xiphonics/picoTracker/docs/img/back-look.jpg

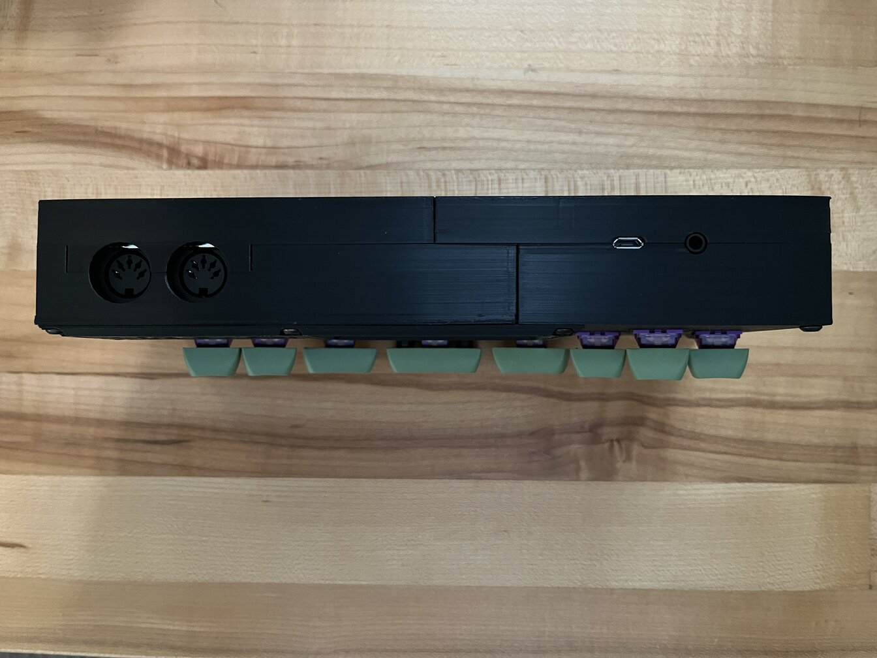
docs/img/back-look.jpg
