xiphonics/picoTracker/docs/img/keynames.jpg

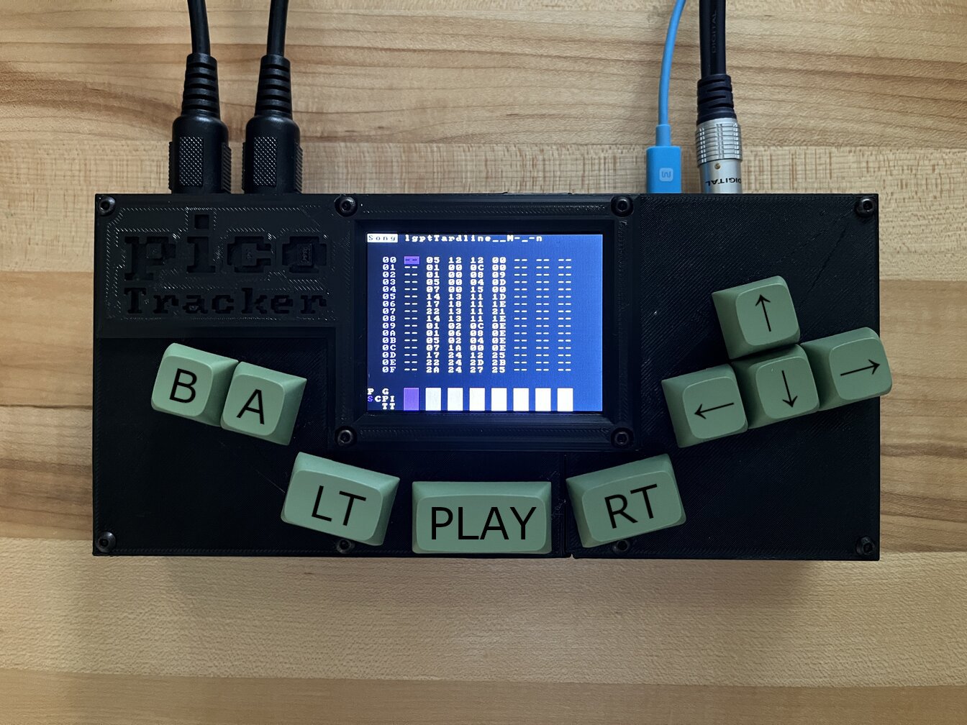
docs/img/keynames.jpg
