xiphonics/picoTracker/docs/img/m8-style-keymap.png

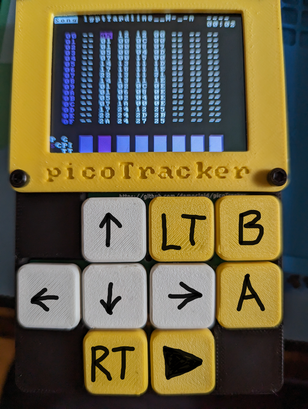
docs/img/m8-style-keymap.png
