xiphonics/picoTracker/docs/img/pico-style-keymap.png

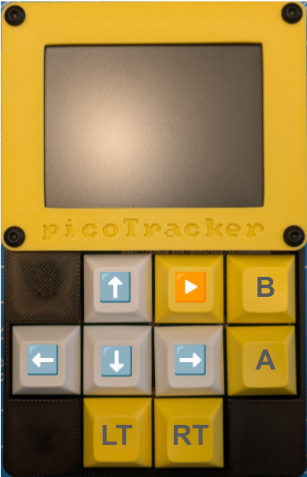
docs/img/pico-style-keymap.png
