xiphonics/picoTracker/docs/img/picotracker-ports-1.png

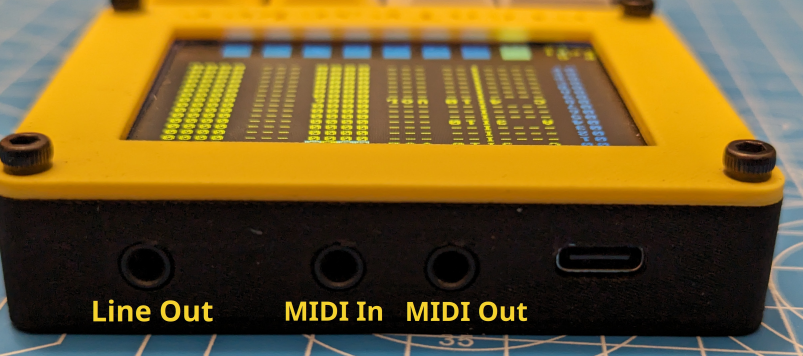
docs/img/picotracker-ports-1.png
