xiphonics/picoTracker/tools/fonts/font_adv.png

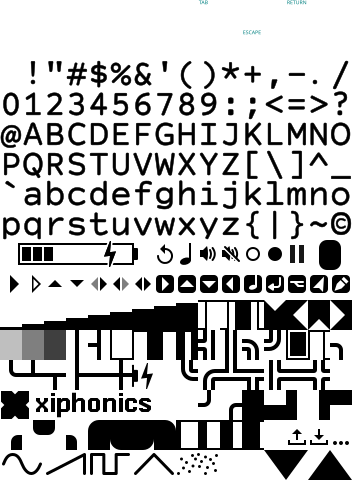
tools/fonts/font_adv.png
