xiphonics/picoTracker/tools/fonts/font_hourglass.png

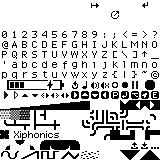
tools/fonts/font_hourglass.png
