xiphonics/picoTracker/tools/fonts/font_wide.png

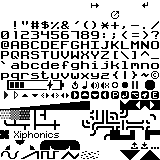
tools/fonts/font_wide.png
