xiphonics/picoTracker/tools/fonts/font_yousquared.png

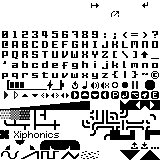
tools/fonts/font_yousquared.png
