xiphonics/picoTracker/usermanual/pico-edition/content/pages/device.md

---
title: Device Management
template: page
---

The device screen allows you to manage settings for the picoTracker device hardware itself.

**Note:** the picoTracker saves its device settings to the SDCard so if you replace the sdcard in your picoTracker, the device configuration will reset to factory defaults.

screen capture of device screen

## MIDI

- **MIDI output:** Selects the picoTracker MIDI output interfaces. Available options are:
    * Off
    * TRS
    * USB
    * TRS+USB
- **MIDI input:** Selects which interfaces receive MIDI notes and transport messages: Off, TRS, USB, or TRS+USB (default). Changes take effect immediately and are independent of MIDI output. Disabling an input releases its held notes.

- **MIDI sync:** Enable/disable MIDI clock sync messages being sent by the picoTracker.

Device settings are saved when you leave the Device screen.

## Line Out Mode (1st Edition RP2040 model only)

On the first edition picoTracker, the audio output can be set to one of 3 amplification levels to make the audio level output more useful for Line Level output or Headphone output. The 3 possible settings are: 
* `HP Low`
* `HP High`
* `Line Level`

**NOTE: A reboot of the picoTracker is required to apply the newly changed audio output level!** 

**PLEASE exercise caution when using earphones or headphones!*

## Remote UI

This setting enables or disables sending commands to a computer attached via USB to the picoTracker running a "remote UI" application that can mirror the display from the picoTracker.

The [official picoTracker remote UI web application is available ](https://ui.xiphonics.com), it works only with Chromium based browsers.

## Import resampler

This settings allows the selection of the sample rate converter used during sample import. Check the sample instrument section for more details.

## Display Brightness

The display brightness setting allows you to adjust the backlight level of the picoTracker's LCD display. The brightness can be set from `05` (minimum brightness) to `ff` (maximum brightness). The default value is `80` (medium brightness).

Adjusting the brightness can help with battery life (lower brightness uses less power) and visibility in different lighting conditions.

## Theme Settings

The Theme Settings screen allows you to customize the appearance of the picoTracker interface, including fonts and colors. To access the Theme Settings screen, select the "Theme settings" option on the Device screen.

See the [Theme Settings](theme.html) chapter for more details.

## Updating Firmware

The picoTracker firmware can be easily updated by powering the picoTracker via a USB connected to a PC. Select `Update firmware`. This will reboot the device into *BOOTSEL* mode, and you'll see the picoTracker show up as a USB mass storage device on the connected computer. At that point, just copy the UF2 firmware file into the USB device as you would with a USB stick or USB drive. 

Once copying (flashing) of the new firmware is completed, the picoTracker will automatically reboot and be running the newly installed firmware.
