xiphonics/picoTracker/usermanual/advance-edition/content/pages/introduction.md

---
title: Welcome
template: page
---

Welcome to the picoTracker Advance, a small, portable music making device based on the tracker workflow.

But what is a "tracker"?

Trackers are music production applications that started life on 16bit home computers such as the legendary Amiga 500. 

Trackers later evolved to also run on devices such as the Gameboy as popularised by LSDJ and this then inspired the LittleGPTracker (LGPT) which was designed to run on portable Linux-based gaming handheld devices. LGPT then served as the starting point for the firmware for the picoTracker, though it has now substantially diverged from those roots, being customised for the specific hardware of the picoTracker Advance and gaining many new features and improvements.

## Overview

picoTracker Advance is the evolution of the original picoTracker — a portable music instrument built around the classical tracker interface. It currently supports eight stereo channels, with per-step assignable sample, Synth and MIDI instruments. The new hardware is designed to enable new creative possibilities as the firmware continues to evolve.

Your picoTracker Advance comes included with a:

* 16GB SD Card with sample projects, samples and themes
* MIDI TRS adapter (type B)
* quick reference card

(note: Does NOT include power supply or USB-C cable. The Advance uses any standard USB-C charger)

### Hardware specs

* HiDPI 720x720 4" display
* Powerful ARM processor
* 48MB of sample memory per project
* MicroSD for project, settings and sample storage
* TRS and USB MIDI In/Out
* Headphone/Line output and speaker
* Line input and built-in microphone
* Battery lasts up to 6 hours
* Weight: 233g (8.2oz)
* Dimensions: 143x78x15mm (5.6x3x0.6in)

## Acknowledgements

As with any big open source undertaking, this project would not have been possible without standing on the shoulders of many great open source projects and libraries. We would especially like to thank [Marc Resibois aka Nostromo](https://github.com/Mdashdotdashn), the creator of LittleGPTracker and for making it available under a liberal open source license.
