xiphonics/picoTracker/usermanual/advance-edition/content/pages/keypadcombos.md

---
title: Controls & Moves
template: page
---

labeled photo of Picotracker keymapping

The keyboard layout resembles a typical console game controller (controller button names in brackets):

| <span class="minikeys">ARROW</span> keys | <span class="minikeys">NAV</span> (RT) | <span class="minikeys">ALT</span> (LT) | <span class="minikeys">ENTER</span> (A) | <span class="minikeys">EDIT</span> (B) | <span class="minikeys">PLAY</span> (Start) |
|:---|:---|:---|:---|:---|:---|
| arrow keys | arrow keys | arrow keys | arrow keys | arrow keys | arrow keys |

The <span class="minikeys">NAV</span> and <span class="minikeys">ALT</span> keys are modifier keys for the <span class="minikeys">ENTER</span>, <span class="minikeys">EDIT</span> and <span class="minikeys">ARROW</span> keys. They are designed to modify
the opposite keys to their location, so <span class="minikeys">ALT</span> will modify the <span class="minikeys">ARROW</span> keys and <span class="minikeys">NAV</span> will modify <span class="minikeys">ENTER</span> and <span class="minikeys">EDIT</span> (
though there are exceptions).

On tracker screens where <span class="minikeys">PLAY</span> controls playback, holding <span class="minikeys">PLAY</span> for about one second triggers a panic stop. This immediately stops the sequencer and **cuts any currently sounding audio**, which is useful if a note, effect tail, or external MIDI sound gets stuck. A short press of <span class="minikeys">PLAY</span> still performs the normal start/stop or queue action when you release the key.

### Remark about navigation between screens

Screens become more granular as you move from left to right.

Navigating to the next right screen is only possible if the current cursor position is on a field with a filled value, eg. to move to the chain screen from the Song screen you need to have a chain number on the cursors current position and not an empty position which are denoted with 2 dashes (`--`).

## Song View

### No Modifier

| Function | Key Combination | Image |
|:---|:---:|:---:|
| Move cursor on screen |  <span class="minikeys">ARROW</span> keys | arrow keys |
| Start/stop playback | <span class="minikeys">PLAY</span> | play key |
| Panic stop sounding audio |  hold <span class="minikeys">PLAY</span> | play key |
| Enter last used value or start with 0 | <span class="minikeys">ENTER</span> | enter key  |

### NAV Modifier

| Function | Key Combination | Image |
|:---|:---:|:---:|
| Switch to Project view | <span class="minikeys">NAV</span> + <span class="minikeys">UP</span> | nav + up key |
| Switch to Mixer view | <span class="minikeys">NAV</span> + <span class="minikeys">DOWN</span> |  nav + down key  |
| Switch to Chain view (if current position has a chain) | <span class="minikeys">NAV</span> + <span class="minikeys">RIGHT</span>  | nav + right key |
| Stop playback of selected chain, once it finished | <span class="minikeys">NAV</span> + <span class="minikeys">PLAY</span> |  nav + play key  |
| Solo selected track | <span class="minikeys">NAV</span> + <span class="minikeys">ENTER</span>  | nav + enter key |
| Mute selected track | <span class="minikeys">NAV</span> + <span class="minikeys">EDIT</span> | nav + edit keys  |
| Reset all muted & solo-ed tracks | <span class="minikeys">NAV</span> + <span class="minikeys">ALT</span> |  nav + edit keys  |

#### Solo & Mute

When <span class="minikeys">NAV</span> is released first, the (solo / mute) mode will be kept active (toggled).
Pressing the same key combination but releasing <span class="minikeys">NAV</span> first will reset the (solo / mute) mode of the currently selected
track.

To reset all muted and soloed tracks, press <span class="minikeys">NAV</span> + <span class="minikeys">ALT</span>.

### ALT Modifier

| Function | Key Combination | Image |
|:---|:---:|:---:|
| Jump up/down to next populated row after a blank row | <span class="minikeys">ALT</span> + (<span class="minikeys">UP</span> / <span class="minikeys">DOWN</span>) | alt + up/down keys |
| Nudge tempo down/up | <span class="minikeys">ALT</span> + (<span class="minikeys">LEFT</span> / <span class="minikeys">RIGHT</span>) | nav + alt + left/right  |
| Start/stop song, or queue current row for playback in Live mode | <span class="minikeys">ALT</span> + <span class="minikeys">PLAY</span> | nav + alt + play |
| Reset all muted & soloed tracks | <span class="minikeys">ALT</span> + <span class="minikeys">NAV</span> | nav + alt + enter |
| Cut the current cursor position if filled, paste otherwise | <span class="minikeys">ALT</span> + <span class="minikeys">ENTER</span> | arrow keys |
| Clone: Overwrite current highlighted Item with a copy of itself using the next unused Item available. | <span class="minikeys">ALT</span> + (<span class="minikeys">EDIT</span>, <span class="minikeys">ENTER</span>) | alt + edit + enter keys |
| Start selection | <span class="minikeys">ALT</span> + <span class="minikeys">EDIT</span> | edit + alt keys |
| Selection with current row selected | <span class="minikeys">ALT</span> + <span class="minikeys">EDIT</span> + <span class="minikeys">EDIT</span> | edit + alt keys |
| Selection with current screen selected | <span class="minikeys">ALT</span> + <span class="minikeys">EDIT</span> + <span class="minikeys">EDIT</span> + <span class="minikeys">EDIT</span> | edit + alt keys |

#### Use Selection

Once a selection is started you can do a few more things:

| Description | Key Combination | Image |
|---|:---:|:---:|
| Change selection | <span class="minikeys">ARROWS</span> |  arrow keys |
| Increase selection to full row / screen | <span class="minikeys">ALT</span> + <span class="minikeys">EDIT</span> | nav + enter |
| Copy selection to clipboard | <span class="minikeys">EDIT</span> | arrow keys |
| Cut selection to clipboard | <span class="minikeys">ALT</span> + <span class="minikeys">ENTER</span>  | arrow keys |
| Resample selection | <span class="minikeys">ENTER</span> + <span class="minikeys">PLAY</span>  | play key |

### EDIT Modifier

| Function | Key Combination | Image |
|:---|:---:|:---:|
| Cuts the current Highlighted Item. | <span class="minikeys">EDIT</span> + <span class="minikeys">ENTER</span> | edit + enter keys |
| Start selection | <span class="minikeys">EDIT</span> + <span class="minikeys">ALT</span> | edit + alt keys |
| Page up/down in Song Screen. | <span class="minikeys">EDIT</span> + (<span class="minikeys">UP</span> / <span class="minikeys">DOWN</span>) | edit + up/down keys |
| Switch between Song and Live Mode | <span class="minikeys">EDIT</span> + (<span class="minikeys">LEFT</span> / <span class="minikeys">RIGHT</span>) | edit + left/right keys |
| Mute selected track | <span class="minikeys">EDIT</span> + <span class="minikeys">NAV</span> | nav + edit keys |
| Sample Recording, only accessible when sequencer is stopped | <span class="minikeys">EDIT</span> + <span class="minikeys">PLAY</span> | edit + play keys |

### ENTER Key Combinations

| Function | Key Combination | Image |
|:---|:---:|:---:|
| Insert if cursor position is empty | <span class="minikeys">ENTER</span> | enter key |
| Insert next unused chain | <span class="minikeys">ENTER</span>, <span class="minikeys">ENTER</span> | enter key twice |
| Cut the current cursor position if filled, paste otherwise | <span class="minikeys">ENTER</span> + <span class="minikeys">ALT</span> | arrow keys |
| Change chain at cursor position by 0x10 | <span class="minikeys">ENTER</span> + (<span class="minikeys">UP</span> / <span class="minikeys">DOWN</span>) | enter + arrow keys |
| Change chain at cursor position by 0x01 | <span class="minikeys">ENTER</span> + (<span class="minikeys">RIGHT</span> / <span class="minikeys">LEFT</span>) | enter + right/left keys |
| Solo selected track | <span class="minikeys">ENTER</span> + <span class="minikeys">NAV</span> | nav + enter key |

## Chain View

### No Modifier

| Function | Key Combination | Image |
|:---|:---:|:---:|
| Move cursor on screen | <span class="minikeys">ARROW</span> keys | arrow keys |
| Start/stop playback of current chain | <span class="minikeys">PLAY</span> | play key |
| Enter last used phrase or start with 0 | <span class="minikeys">ENTER</span> | enter key  |

### NAV Modifier

| Function | Key Combination | Image |
|:---|:---:|:---:|
| Play chain in song | <span class="minikeys">NAV</span> + <span class="minikeys">PLAY</span> | nav + right key |
| Unmute all | <span class="minikeys">NAV</span> + <span class="minikeys">ALT</span> | nav + alt key |
| Toggle mute | <span class="minikeys">NAV</span> + <span class="minikeys">EDIT</span> | nav + edit key  |
| Switch solo mode | <span class="minikeys">NAV</span> + <span class="minikeys">ENTER</span>  | nav + enter key |

### ALT Modifier

| Function | Key Combination | Image |
|:---|:---:|:---:|
| Unmute all | <span class="minikeys">ALT</span> + <span class="minikeys">NAV</span> | alt + nav key |
| Clone current position | <span class="minikeys">ALT</span> + (<span class="minikeys">EDIT</span>, <span class="minikeys">ENTER</span>) | alt + edit + enter key |
| Paste clipboard | <span class="minikeys">ALT</span> + <span class="minikeys">ENTER</span> | alt + enter key |
| Start selection | <span class="minikeys">ALT</span> + <span class="minikeys">EDIT</span> | alt + edit key |

### EDIT Modifier

| Function | Key Combination | Image |
|:---|:---:|:---:|
| Warp to (previous / next) channel | <span class="minikeys">EDIT</span> + (<span class="minikeys">LEFT</span> / <span class="minikeys">RIGHT</span>) | edit + horizontal arrow keys |
| Warp to (previous / next) chain of current channel | <span class="minikeys">EDIT</span> + (<span class="minikeys">UP</span> / <span class="minikeys">DOWN</span>) | edit + vertical arrow keys |
| Cut current position into clipboard | <span class="minikeys">EDIT</span> + <span class="minikeys">ENTER</span> | edit + enter key |
| Clone current position | <span class="minikeys">EDIT</span> + <span class="minikeys">ALT</span> + <span class="minikeys">ENTER</span> | edit + alt + enter key |
| Toggle mute | <span class="minikeys">EDIT</span> + <span class="minikeys">NAV</span> | edit + nav key |
| Start selection | <span class="minikeys">ALT</span> + <span class="minikeys">EDIT</span> | alt + edit key |
| Selection with row selected | <span class="minikeys">ALT</span> + <span class="minikeys">EDIT</span> + <span class="minikeys">EDIT</span> | alt + edit twice keys |
| Selection with current screen selected | <span class="minikeys">ALT</span> + <span class="minikeys">EDIT</span> + <span class="minikeys">EDIT</span> + <span class="minikeys">EDIT</span> | alt + edit thrice keys |

#### Use Selection

Once a selection is started you can do a few more things:

| Description | Key Combination | Image |
|---|:---:|:---:|
| Change selection | <span class="minikeys">ARROWS</span> | arrow keys |
| Copy selection to clipboard | <span class="minikeys">EDIT</span> | edit key |
| Toggle mute | <span class="minikeys">EDIT</span> + <span class="minikeys">NAV</span> | edit + nav key |
| Update selection values by +/- 0x10 | <span class="minikeys">ENTER</span> + (<span class="minikeys">UP</span> + <span class="minikeys">DOWN</span>) | enter + vertical arrow keys |
| Update selection values by +/- 0x01 | <span class="minikeys">ENTER</span> + (<span class="minikeys">LEFT</span> + <span class="minikeys">RIGHT</span>) | enter key + horizontal arrow keys |
| Cut the current selection | <span class="minikeys">ALT</span> + <span class="minikeys">ENTER</span> | alt + enter key |
| Resample selection | <span class="minikeys">ENTER</span> + <span class="minikeys">PLAY</span> | play key |
| Switch solo mode | <span class="minikeys">NAV</span> + <span class="minikeys">ENTER</span> | nav + enter key |
| Play chain | <span class="minikeys">PLAY</span> | play key |
| Play chain in song | <span class="minikeys">NAV</span> + <span class="minikeys">PLAY</span> | nav + play key |
| Unmute all | <span class="minikeys">ALT</span> + <span class="minikeys">NAV</span> | alt + nav key |

### ENTER Key Combinations

| Function | Key Combination | Image |
|:---|:---:|:---:|
| Update cursor value by +/- 0x10 | <span class="minikeys">ENTER</span> + (<span class="minikeys">UP</span> / <span class="minikeys">DOWN</span>) | enter + vertical arrow keys |
| Update cursor value by +/- 0x01 | <span class="minikeys">ENTER</span> + (<span class="minikeys">LEFT</span> / <span class="minikeys">RIGHT</span>) | enter + horizontal arrow keys |
| Paste clipboard | <span class="minikeys">ENTER</span> + <span class="minikeys">ALT</span> | enter + alt key |
| Switch solo mode | <span class="minikeys">ENTER</span> + <span class="minikeys">NAV</span> | enter + nav key |

## Phrase View

### No Modifier

| Function | Key Combination | Image |
|:---|:---:|:---:|
| Move cursor on screen | <span class="minikeys">ARROW</span> keys | arrow keys |
| Start/stop playback of current phrase | <span class="minikeys">PLAY</span> | play key |
| enter last used value or start with 0 | <span class="minikeys">ENTER</span> |  enter key  |
| Insert first unused instrument/table number | <span class="minikeys">ENTER</span>,<span class="minikeys">ENTER</span>  |  enter key  |
| In note / instrument column: audition note |  <span class="minikeys">ENTER</span> held |  enter key  |

| Function | Key Combination | Image |
|:---|:---:|:---:|
| Play phrase in song | <span class="minikeys">NAV</span> + <span class="minikeys">PLAY</span> | nav + play key  |
| Unmute all | <span class="minikeys">NAV</span> + <span class="minikeys">ALT</span> | nav + alt key |
| Switch mute mode | <span class="minikeys">NAV</span> + <span class="minikeys">EDIT</span> | nav + edit key  |
| Switch solo mode | <span class="minikeys">NAV</span> + <span class="minikeys">ENTER</span>  | nav + enter key |

### ALT Modifier

| Function | Key Combination | Image |
|:---|:---:|:---:|
| Unmute all | <span class="minikeys">ALT</span> + <span class="minikeys">NAV</span> | alt + nav key |
| Paste clipboard | <span class="minikeys">ALT</span> + <span class="minikeys">ENTER</span> | alt + enter key |
| Start selection | <span class="minikeys">ALT</span> + <span class="minikeys">EDIT</span> | alt + edit key |
| Clone current instrument/table (cursor in note / instrument column) | <span class="minikeys">ALT</span> + (<span class="minikeys">EDIT</span>, <span class="minikeys">ENTER</span>) | alt + edit + enter key |

### EDIT Modifier

| Function | Key Combination | Image |
|:---|:---:|:---:|
| Warp to (previous / next) track | <span class="minikeys">EDIT</span> + (<span class="minikeys">LEFT</span> / <span class="minikeys">RIGHT</span>) | edit + horizontal arrow keys|
| Warp to (previous / next) phrase in chain | <span class="minikeys">EDIT</span> + (<span class="minikeys">UP</span> / <span class="minikeys">DOWN</span>) | edit + vertical arrow keys  |
| Cut current position into clipboard | <span class="minikeys">EDIT</span> + <span class="minikeys">ENTER</span> | edit + enter key |
| Toggle mute | <span class="minikeys">EDIT</span> + <span class="minikeys">NAV</span> | edit + nav key |
| Start selection | <span class="minikeys">EDIT</span> + <span class="minikeys">ALT</span> | alt + edit key |
| Start selection with row selected | <span class="minikeys">ALT</span> + <span class="minikeys">EDIT</span> + <span class="minikeys">EDIT</span> | alt + edit twice keys |
| Start selection with current screen selected | <span class="minikeys">ALT</span> + <span class="minikeys">EDIT</span> + <span class="minikeys">EDIT</span> + <span class="minikeys">EDIT</span> | alt + edit thrice keys |

#### Use Selection

Once a selection is started you can do a few more things:

| Description | Key Combination | Image |
|---|:---:|:---:|
| Change selection | <span class="minikeys">ARROWS</span> | arrow keys |
| Increase selection to full row / screen | <span class="minikeys">ALT</span> + <span class="minikeys">EDIT</span> | nav + enter |
| Copy selection to clipboard | <span class="minikeys">EDIT</span> | edit key |
| Cut the current selection | <span class="minikeys">ALT</span> + <span class="minikeys">ENTER</span> | alt + enter key |
| Update selection values by +/- 0x10 |  <span class="minikeys">ENTER</span> + (<span class="minikeys">UP</span> + <span class="minikeys">DOWN</span>) | enter + vertical arrow keys |
| Update selection values by +/- 0x01 | <span class="minikeys">ENTER</span> + (<span class="minikeys">LEFT</span> + <span class="minikeys">RIGHT</span>) | enter + horizontal arrow keys |
| Resample selection | <span class="minikeys">ENTER</span> + <span class="minikeys">PLAY</span> | play key |

### ENTER Key Combinations

| Function | Key Combination | Image |
|:---|:---:|:---:|
| update cursor value by +/- 0x10 | <span class="minikeys">ENTER</span> + (<span class="minikeys">UP</span> / <span class="minikeys">DOWN</span>) | enter + vertical arrow keys |
| update cursor value by +/- 0x01 | <span class="minikeys">ENTER</span> + (<span class="minikeys">LEFT</span> / <span class="minikeys">RIGHT</span>) | enter + horizontal arrow keys |
| paste clipboard | <span class="minikeys">ENTER</span> + <span class="minikeys">ALT</span> | enter + alt key |
| switch solo mode | <span class="minikeys">ENTER</span> + <span class="minikeys">NAV</span> | enter + nav key |

## Instrument View

### No Modifier

| Function | Key Combination | Image |
|:---|:---:|:---:|
| Move cursor on screen |  <span class="minikeys">ARROW</span> keys | arrow keys |
| Start/stop playback | <span class="minikeys">PLAY</span> | play key |

### ENTER Key

| Function | Key Combination | Image |
|:---|:---:|:---:|
| Import sample from samplelib (double-tap on sample field) | <span class="minikeys">ENTER</span>, <span class="minikeys">ENTER</span>  | enter key |
| Get next available table (on table field) | <span class="minikeys">ENTER</span> | enter key  |

### NAV Modifier

| Function | Key Combination | Image |
|:---|:---:|:---:|
| Switch to Phrase view |  <span class="minikeys">NAV</span> + <span class="minikeys">LEFT</span> | nav + left key  |
| Switch to Voice view (Sample instrument) |  <span class="minikeys">NAV</span> + <span class="minikeys">RIGHT</span>  | nav + right key |
| Switch to Table view (if instrument has table) |  <span class="minikeys">NAV</span> + <span class="minikeys">DOWN</span> | nav + down key  |
| Start playback (phrase mode) |  <span class="minikeys">NAV</span> + <span class="minikeys">PLAY</span> | nav + play key  |

### ALT Modifier

| Function | Key Combination | Image |
|:---|:---:|:---:|
| Audition current audio instrument in the Instrument or Voice view (hold; works during playback) | <span class="minikeys">ALT</span> + <span class="minikeys">PLAY</span> | alt + play key |

### EDIT Modifier

| Function | Key Combination | Image |
|:---|:---:|:---:|
| Previous/Next instrument (-1/+1) | <span class="minikeys">EDIT</span> + (<span class="minikeys">LEFT</span> / <span class="minikeys">RIGHT</span>) | edit + (left / right) key |
| Previous/Next instrument (-16/+16) | <span class="minikeys">EDIT</span> + (<span class="minikeys">DOWN</span> / <span class="minikeys">UP</span>) | edit + down key |
| Cut/purge instrument (sample) or clear table | <span class="minikeys">EDIT</span> + <span class="minikeys">ENTER</span> | edit + enter key |
| Clone current table | <span class="minikeys">ALT</span> + (<span class="minikeys">EDIT</span>, <span class="minikeys">ENTER</span>) | edit + alt key |

## Import View

### No Modifier

| Function | Key Combination | Image |
|:---|:---:|:---:|
| Move up/down in file list | <span class="minikeys">UP</span> / <span class="minikeys">DOWN</span> |  arrow keys |
| Toggle selected button | <span class="minikeys">LEFT</span> / <span class="minikeys">RIGHT</span>  | arrow keys |
| Preview selected sample (hold) | <span class="minikeys">PLAY</span> | play key |
| Navigate into directory | <span class="minikeys">ENTER</span> | enter key |

### ENTER Key

**In File Browser Mode:**

| Function | Key Combination | Image |
|:---|:---|:---:|
| Import sample | <span class="minikeys">ENTER</span> (with Import button selected) | enter key |
| Edit sample | <span class="minikeys">ENTER</span> (with Edit button selected) | enter key |

**In Project Pool Mode:**

| Function | Key Combination | Image |
|:---|:---|:---:|
| Edit sample | <span class="minikeys">ENTER</span> (with Edit button selected) | enter key |
| Remove sample from project | <span class="minikeys">ENTER</span> (with Remove button selected) | enter key |

### NAV Modifier

| Function | Key Combination | Image |
|:---|:---:|:---:|
| Return to source view (Phrase or Instrument) |  <span class="minikeys">NAV</span> + <span class="minikeys">LEFT</span> | nav + left key |
| Go to parent directory | <span class="minikeys">NAV</span> + <span class="minikeys">UP</span> | nav + up key |
| Toggle between sample library and project pool |  <span class="minikeys">NAV</span> + <span class="minikeys">EDIT</span> | nav + edit key |

### EDIT Modifier

| Function | Key Combination | Image |
|:---|:---:|:---:|
| Increase / Decrease preview volume | <span class="minikeys">EDIT</span> + (<span class="minikeys">UP</span> / <span class="minikeys">DOWN</span>) | edit + (up / down) key |

### ALT Modifier

| Function | Key Combination | Image |
|:---|:---:|:---:|
| Import sample | <span class="minikeys">ALT</span> + <span class="minikeys">PLAY</span> | alt + play key |

## Sample Editor View

### No Modifier

| Function | Key Combination | Image |
|:---|:---:|:---:|
| Move cursor on screen | <span class="minikeys">ARROW</span> keys | arrow keys |
| Preview sample (hold) | <span class="minikeys">PLAY</span> | play key |

### ENTER Key

| Function | Key Combination | Image |
|:---|:---:|:---:|
| Update cursor value | <span class="minikeys">ENTER</span> + (<span class="minikeys">UP</span> / <span class="minikeys">DOWN</span>) (with start, end or name field selected) | enter + vertical arrow keys |
| Update cursor position in field | <span class="minikeys">ENTER</span> + (<span class="minikeys">LEFT</span> / <span class="minikeys">RIGHT</span>) | enter + horizontal arrow keys |
| Save sample | <span class="minikeys">ENTER</span> (with Save button selected) | enter key |

### EDIT Key

| Function | Key Combination | Image |
|:---|:---:|:---:|
| delete character at cursor position | <span class="minikeys">EDIT</span> (with name field selected) | edit key |

### NAV Modifier

| Function | Key Combination | Image |
|:---|:---:|:---:|
| Return to sample browser |  <span class="minikeys">NAV</span> + <span class="minikeys">LEFT</span> | nav + left key |

## Table View

### No Modifier

| Function | Key Combination | Image |
|:---|:---:|:---:|
| Move cursor on screen | <span class="minikeys">ARROW</span> keys | arrow keys |
| Start/stop playback of current phrase | <span class="minikeys">PLAY</span> | play key |
| Paste last used command (in command column) | <span class="minikeys">ENTER</span> |  enter key  |

### NAV Modifier

| Function | Key Combination | Image |
|:---|:---:|:---:|
| Switch to Phrase View (from Table1) or Instrument View (from Table2) | <span class="minikeys">NAV</span> + <span class="minikeys">UP</span> | nav + up key |
| Switch to Table View (from Table2) | <span class="minikeys">NAV</span> + <span class="minikeys">LEFT</span> |  nav + left key  |
| Switch to Table2 View (from Table1) | <span class="minikeys">NAV</span> + <span class="minikeys">RIGHT</span>  | nav + right key |
| Play phrase in song context | <span class="minikeys">NAV</span> + <span class="minikeys">PLAY</span> |  nav + play key  |

### ALT Modifier

| Function | Key Combination | Image |
|:---|:---:|:---:|
| Paste clipboard |  <span class="minikeys">ALT</span> + <span class="minikeys">ENTER</span>  | alt + enter key |

### EDIT Modifier

| Function | Key Combination | Image |
|:---|:---:|:---:|
| Warp to previous/next table (-1/+1) | <span class="minikeys">EDIT</span> + (<span class="minikeys">LEFT</span> / <span class="minikeys">RIGHT</span>) | edit + (left / right) key |
| Warp to previous/next table (-16/+16) | <span class="minikeys">EDIT</span> + (<span class="minikeys">DOWN</span> / <span class="minikeys">UP</span>) | edit + down key |
| Cut current position into clipboard | <span class="minikeys">EDIT</span> + <span class="minikeys">ENTER</span> | edit + enter key |
| Start selection mode | <span class="minikeys">EDIT</span> + <span class="minikeys">ALT</span> | alt + edit key |

### Use Selection

Once a selection is started you can do a few more things:

| Function | Key Combination | Image |
|:---|:---:|:---:|
| Change selection |  <span class="minikeys">ARROW</span> keys | arrow keys |
| Increase selection to full row / screen |  <span class="minikeys">ALT</span> + <span class="minikeys">EDIT</span> |  alt + edit key  |
| Copy selection to clipboard |  <span class="minikeys">EDIT</span> | edit key |
| Cut the current selection |  <span class="minikeys">ALT</span> + <span class="minikeys">ENTER</span>  | enter + alt key |

### ENTER Modifier

| Function | Key Combination | Image |
|:---|:---:|:---:|
| Update cursor value by +/- 0x10 | <span class="minikeys">ENTER</span> + (<span class="minikeys">UP</span> / <span class="minikeys">DOWN</span>) | enter + vertical arrow keys |
| Update cursor value by +/- 0x01 | <span class="minikeys">ENTER</span> + (<span class="minikeys">LEFT</span> / <span class="minikeys">RIGHT</span>) | enter + horizontal arrow keys |
| Paste clipboard | <span class="minikeys">ENTER</span> + <span class="minikeys">ALT</span> | enter + alt key |
