xiphonics/picoTracker/usermanual/advance-edition/content/pages/projectpool.md

---
title: Project Pool
template: page
---

screen capture of project pool screen

## Introduction

The Project Pool is the sample browser for the samples that belong to the current project. It uses the same browser layout as the Sample Import view, but it shows the project sample pool directory instead of the global sample library.

## Accessing the Project Pool

1. Open the Sample Browser from the Project screen (select **Sample Pool** and press <span class="minikeys">ENTER</span>).

## Using the Project Pool

*   **Navigate:** Use the <span class="minikeys">UP</span> and <span class="minikeys">DOWN</span> arrow keys to move through the list.
*   **Preview:** Hold <span class="minikeys">PLAY</span> to audition the selected sample.
*   **Edit:** Select **Edit** and press <span class="minikeys">ENTER</span> to open the Sample Editor.
*   **Remove:** Select **Remove** and press <span class="minikeys">ENTER</span> to delete the sample from the project pool.
*   **Return:** Press <span class="minikeys">NAV</span> + <span class="minikeys">LEFT</span> to return to the previous screen.

Samples appear here after you import them into the project or record them. The pool is stored with the project, so loading a different project will show its own pool.
