xiphonics/picoTracker/usermanual/advance-edition/content/pages/renders.md

---
title:  Renders and Stems
template: page
---

rendering dialog

## Audio Rendering in picoTracker

picoTracker allows you to render your compositions to audio files, providing two different rendering options: **Mixdown** and **Stems**. These features enable you to export your music for sharing, further processing in a DAW, or archiving. The render options are available in the **Project View**.

## Accessing the Render Options

The render options can be found in the **Project View**. Navigate to the Project View and look for the "Render:" section, which contains two options:

- **Mixdown** - Creates a single stereo audio file of the selected portion of your song
- **Stems** - Creates separate audio files for each channel within the selected rows of your song

**Important:** Before rendering, you must select rows in the **Song screen**. Use grid selection (`EDIT`+`LEFT/RIGHT/UP/DOWN`) to highlight the rows and channels you want to render. The currently selected row range and channel range are displayed on the Project screen next to the "Render:" label (e.g., `Row[03-0A] Ch[1-4]`). If no selection is active, the Project screen will display `[No Selection]` and the Mixdown/Stems buttons will show an error when pressed.

***NOTE:***  Any existing files in the `/renders` directory for the current project will be **overwritten** by the rendering process.

## Rendering a Mixdown

A mixdown creates a single stereo audio file containing your entire composition. This is useful when you want to share your completed track or use it in other applications.

To create a mixdown:

1. Go to the **Song screen** and make a grid selection (`EDIT`+`RIGHT`) covering the rows you want to render
2. Navigate to the Project View — the selected row range and channel range will be shown next to "Render:" (e.g., `Row[03-0A] Ch[1-4]`)
3. Make sure your song is not currently playing
4. Select the "Mixdown" option under "Render:"
5. The rendering process will begin, and a progress dialog will display the current render time
6. The selected portion of the song will play through once while rendering
7. You can press "Cancel" at any time to stop the rendering process
8. When the selection has completed playing through, the rendering will automatically finish

***NOTE:*** The time displayed during the rendering process is the elapsed time of the audio being rendered, not the actual "clock" time of how long it takes to perform the render.

***NOTE:*** You may hear noise or audio artifacts while the rendering is in progress or the audio being played at slower speed than expected, but this is normal due to the extra processing required during rendering and it will **not** affect the final rendered audio.

## Rendering Stems

Stems are separate audio files for each individual channel in your composition. This is particularly useful when you want to:

- Further process individual elements of your track in a DAW
- Create remixes or alternative versions of your composition
- Have more control over the final mix

To render stems:

1. Go to the **Song screen** and make a grid selection (`EDIT`+`RIGHT`) covering the rows you want to render
2. Navigate to the Project View — the selected row range and channel range will be shown next to "Render:" (e.g., `Row[03-0A] Ch[1-4]`)
3. Make sure your song is not currently playing
4. Select the "Stems" option under "Render:"
5. The rendering process will begin, and a progress dialog will display the current render time
6. The selected portion of the song will play through once while rendering, producing one stereo file per channel
7. You can press "Cancel" at any time to stop the rendering process
8. When the selection has completed playing through, the rendering will automatically finish

## Render Output

The rendered audio files are saved to your device's sdcard int he `/renders` top level directory. The exact location and format of the files depends on your picoTracker configuration:

- Mixdown files are named `(projectname)-mixdown.wav`
- Stem files are named `(projectname)-channel(number).wav`

## Render Quality

All audio is rendered at 44.1kHz sample rate with 16-bit depth.

## Tips for Rendering

- Make sure your composition is complete and sounds as intended before rendering
- Check that all channel volumes and the master volume are set appropriately
- For the best quality output, avoid clipping by ensuring your levels aren't too high
- If you need to stop a render in progress, press the "OK" button on the render progress dialog
- Rendering will automatically stop when the song gets to the end and will *not* loop back to the beginning as it does in the song screen

## Accessing Rendered Files

After rendering, you can access your files in the `/renders` directory on your device's sdcard by taking out the sdcard and using a computer or other device to access it.
