xiphonics/picoTracker/usermanual/advance-edition/content/pages/sample-editor.md

---
title: Sample Editor
template: page
---

screen capture of sample editor screen

## Introduction

The Sample Editor lets you trim and rename samples already in your project.

**NOTE:** The sample editor operations are **DESTRUCTIVE** when applied to a file so you need to rename the file in the sample editor and do `Save` first to create a new file to edit **BEFORE** applying an edit operation to the file.

## Accessing the Sample Editor

You can enter the Sample Editor from the Sample Browser:

1. Select a sample in the Project Pool or Sample Library.
2. Choose the `Edit` onscreen field and press <span class="minikeys">ENTER</span>.

## Screen Layout

The Sample Editor focuses on a few editable fields:

*   **Name:** The filename used for this sample.
*   **Start:** The playback start position.
*   **End:** The playback end position.
*   **Save:** Commits the current edits.

Use the arrow keys to move the cursor between these fields.

## Editing a Sample

*   **Move around:** Use the <span class="minikeys">ARROW</span> keys to select fields.
*   **Preview:** Hold <span class="minikeys">PLAY</span> to audition the current start/end range.
*   **Adjust values:** Hold <span class="minikeys">ENTER</span> and press <span class="minikeys">UP</span>/<span class="minikeys">DOWN</span> to change the selected fields value.
*   **Edit name:** While the name field is selected, use <span class="minikeys">ENTER</span>+<span class="minikeys">LEFT</span>/<span class="minikeys">RIGHT</span> to move the cursor, and <span class="minikeys">EDIT</span> to delete the character at the cursor.

## Saving Changes

Select `Apply` to **DESTRUCTIVELY** apply the currently selected operation and its parameters (start and end points) to the currently filename.

Select `Save` and press <span class="minikeys">ENTER</span> to write the edits to disk. Use <span class="minikeys">NAV</span>+<span class="minikeys">LEFT</span> to return to the Sample Browser without saving.

`Save & Load` will save the file and load it into the Project Pool.

`Discard` will also leave the Sample Editor screen to return to the Sample Browser without saving.
