xiphonics/picoTracker/usermanual/pico-edition/content/pages/frontcover.md

---
title: The picoTracker User Manual
template: cover
---

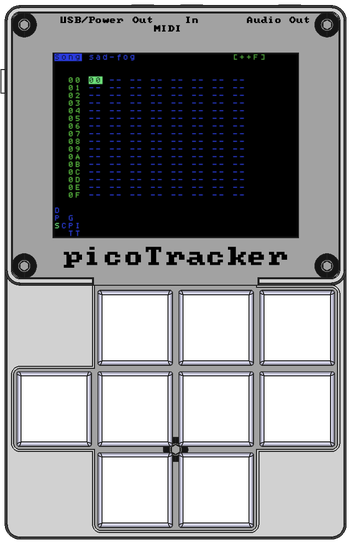
[picture p30: usermanual/advance-edition/content/static/image/picotracker-assembled-small.png]
picoTracker image
