xiphonics/picoTracker/usermanual/advance-edition/content/pages/index.md

---
title: The picoTracker Manual
template: cover
---

picoTracker image
