xiphonics/picoTracker/usermanual/advance-edition/content/pages/credits.md

---
title: Credits
template: page
---

# picoTracker Advance

A hardware music tracker firmware based on LittleGPTracker.

* Copyright (c) 2018 Discodirt
* Copyright (c) 2024 xiphonics, inc.

## Third-party code

* **CSID (cRSID SID emulator):** Hermit / Mihaly Horvath — WTF license
* **Braids (mutable instruments):** Emilie Gillet — MIT license
* **MSFA / libmsfa (DX7):** Raph Levien — Apache License 2.0

## Special thanks

* [Marc Resibois aka Nostromo](https://github.com/Mdashdotdashn)
* [Mikael Lundgren aka The Introvert](https://www.theintrovert.net) for contributing the FM6 presets
* The LittleGPTracker community
* All beta testers
* The open source community

Made with <3 for music makers.

Enjoy and make great music!
