xiphonics/picoTracker/usermanual/advance-edition/content/pages/frontcover.md

---
title: The picoTracker Advance User Manual
template: cover
---

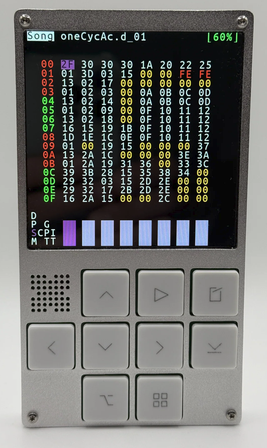
[picture p31: usermanual/advance-edition/content/static/image/advance-frontpage.png]
picoTracker image
