xiphonics/picoTracker/usermanual/advance-edition/content/pages/scales.md

---
title: Available Scales
template: page
---

The following scales are available and can be selected from the Scale menu in the Project screen:

* None (Chromatic)
* Acoustic
* Adonal malakh
* Aeolian mode (minor)
* Algerian
* Altered
* Augmented
* Bebop dominant
* Blues
* Dorian
* Double harmonic
* Enigmatic
* Flamenco
* Gypsy
* Half diminished
* Harmonic major
* Harmonic minor
* Hirajoshi
* Hungarian gypsy
* Hungarian minor
* Insen
* Ionian mode (major)
* Istrian
* Iwato
* Locrian
* Lydian augmented
* Lydian
* Major bebop
* Major locran
* Major pentatonic
* Melodic minor
* Melodic minor (asc)
* Minor pentatonic
* Mixolydian
* Neapolitan major
* Neapolitan minor
* Octatonic
* Persian
* Phrygian dominant
* Phrygian
* Prometheus
* Tritone
* Ukranian
* Whole tone
