xiphonics/picoTracker/usermanual/landing/index.html

# picoTracker Manual

Choose your picoTracker model to access the user manual

picoTracker

## picoTracker

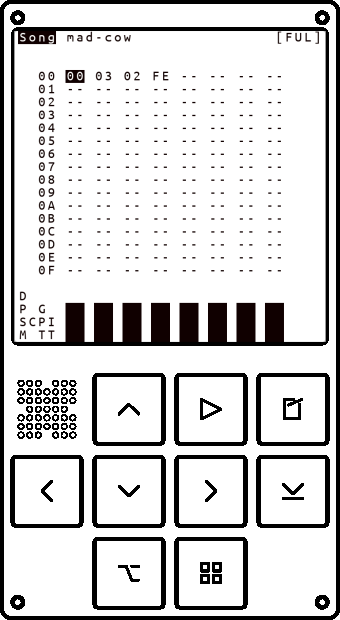
[picture p33: usermanual/landing/advanceFrontPage-small.png]
picoTracker Advance


## picoTracker Advance

User Manual for picoTracker and picoTracker Advance

© xiphonics 2025
