xiphonics/picoTracker/tests/README.md

# Host tests

This directory builds a host-only test binary using doctest in `sources/Externals/doctest`.

## Build

From repo root:

```
cmake -S tests -B build-host
cmake --build build-host
```

## Run

```
./build-host/picoTracker_tests
./build-host/midi_input_tests
./build-host/midi_instrument_tests
```
