xiphonics/picoTracker/(threads)

Thread 1 (2023-10-03):

error with building picoTracker release on Ubuntu

maks, 2023-10-03:
Apologies for opening the issue here, but the main picoTracker doesn't repo doesn't allow opening issues due to being a direct fork of the lgpt repo.

I ran into an error following the instructions on building the picoTracker "optimized build". I'm using Ubuntu 22.04 directly.

The error I get without using parallel make to help make it more clear is:
```
[ 36%] Building CXX object System/FileSystem/CMakeFiles/system_filesystem.dir/FileSystem.cpp.obj
[ 36%] Linking CXX static library libsystem_filesystem.a
[ 36%] Built target system_filesystem
Scanning dependencies of target platform_filesystem
[ 36%] Building CXX object Adapters/picoTracker/filesystem/CMakeFiles/platform_filesystem.dir/picoTrackerFileSystem.cpp.obj
/home/maks/work/picoTracker/sources/Adapters/picoTracker/filesystem/picoTrackerFileSystem.cpp:4:10: fatal error: system/Console/Trace.h: No such file or directory
    4 | #include "system/Console/Trace.h"
      |          ^~~~~~~~~~~~~~~~~~~~~~~~
compilation terminated.
make[2]: *** [Adapters/picoTracker/filesystem/CMakeFiles/platform_filesystem.dir/build.make:76: Adapters/picoTracker/filesystem/CMakeFiles/platform_filesystem.dir/picoTrackerFileSystem.cpp.obj] Error 1
make[1]: *** [CMakeFiles/Makefile2:3029: Adapters/picoTracker/filesystem/CMakeFiles/platform_filesystem.dir/all] Error 2
make: *** [Makefile:91: all] Error 2
```

I see `Trace.h` in `sources/System/Console/Trace.h` and I'm building inside a `build` dir I created off the top level as per the development doc instructions so I guess my C compiler include path isn't set quite correctly, but I'm not really sure which `CMakeLists.txt` to go digging in to check why its nto being picked up so was wondering if you've come across this before?

democloid, 2023-10-03:
Interesting, there were some typos in imports that were not failing in OSX, no idea why. Try now, compiled fine in Debian.

maks, 2023-10-03:
Thank you! Of course all builds fine now. 👍🏻
And sorry for not spotting this myself, I can't believe I missed that difference in dirname case!

But I can help with explaining why you didn't see the errors on MacOS as its APFS filesystem to this day is still [case-insensitive by default](https://support.apple.com/lt-lt/guide/disk-utility/dsku19ed921c/mac).

And thanks for setting up issues on this repo! Will definitely help in the future as at very least I have a few ideas for new features and given all the great work you've already done updating the lgpt codebase, I'm planning on using it as the base to try to get lgpt working properly on the newer Opendingux linux OS versions for the rg280v devices as [currently has audio issues](https://www.youtube.com/shorts/87MJ3PwhKKY) and I've been wanting to also try to get lgpt ported to SDL2 to work better on handhelds and modern distros that dont really support SDL1.2 anymore.

Closed 2023-10-03.

Thread 2 (2023-10-14):

sample streaming from sdcard

maks, 2023-10-14:
It would be very useful to be able to stream samples from the sdcard as this remove current flash size limits on sample sizes. However the performance requirements to do this are significant.

From what I've read of the M8 docs and discussions it seems that the specific sdcard used plays a significant part in available performance and there is a [specific list of cards](https://dirtywave.com/pages/recommended-microsd-cards) that are recommended by Dirtywave for use with the M8.

Also I know @democloid you've mentioned that you have some ideas about this and using SDIO vs SPI and your previous experiments with using one over the other.

democloid, 2023-10-14:
Main issue with this is that the SPI port (nor the PIO peripherals, which is how the SDIO is implemented) are memory mapped, so streaming samples from SD is not as simple as having a pointer to the memory location.

I imagine the way to implement it would require some kind of read ahead buffers (or read back if sample is playing backwards, ping ponging, etc). This adds an additional problem of memory needed for buffers in each channel. Potentially it could be streamed into the play buffers and not need additional memory.

I tried briefly to implement this but wasn't sure how to do it right, I can point in the direction. I think a POC can be implemented using SPI, and if it works right with some short enough and small enough sample, then we could explore if faster access is needed (I imagine so).

maks, 2023-10-15:
Thanks for the explanation, to be honest I haven't yet looked into how SDIO works, I've only worked with SPI before, so I'll get myself up to speed with it first! and if you could give me any pointers of what you've tried already that would be great and save me repeating it all myself 🙏🏻 .

My C/C++ is very rusty, so for to get myself back into it I had in mind doing a little beginners exercise (I'll open a new issue for that then a PR) before I dive into a really complex and tricky area like sdcard streaming. I also spotted that you added 16MB of flash to the portable edition PCB, so that certainly makes this less pressing for now as that's a fair bit more samples space to work with! 👍🏻

democloid, 2023-10-15:
Yes, using SPI or SDIO is software configurable, but I think the SDIO toggle option might have broken at some point in development, so might have to look into that.

The pointer to the samples basically comes from "Application/Instruments/WavFile.cpp", methods [GetBuffer](https://github.com/democloid/picoTracker/blob/7bb92df31c7243f5310e74a8e06ce976d57f1eaa/sources/Application/Instruments/WavFile.cpp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) or [LoadInFlash](https://github.com/democloid/picoTracker/blob/7bb92df31c7243f5310e74a8e06ce976d57f1eaa/sources/Application/Instruments/WavFile.cpp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) (my own). That's where the pointer to the memory location for the sample is loaded. Samples are used in "Application/Instruments/SampleInstrument.cpp" and the pointer to play from is obtained using the [WavFile::GetSampleBuffer](https://github.com/democloid/picoTracker/blob/7bb92df31c7243f5310e74a8e06ce976d57f1eaa/sources/Application/Instruments/WavFile.cpp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) method.

If the SD card were memory mapped, the only thing you'd have to do is to point at the memory location on the SD card, but since it's not, you'd probably have to load the appropriate data at the start of the [Render](https://github.com/democloid/picoTracker/blob/7bb92df31c7243f5310e74a8e06ce976d57f1eaa/sources/Application/Instruments/SampleInstrument.cpp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) method. This would need an additional buffer on the already scarse memory. The good thing is that each Render call for each channel is done sequentially, so it would be just one additional buffer needed.

Another potential class to look into is the [AudioFileStreamer](https://github.com/democloid/picoTracker/blob/7bb92df31c7243f5310e74a8e06ce976d57f1eaa/sources/Application/Audio/AudioFileStreamer.h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), this class is used when previewing samples before actually loading them, and it's effectively streaming from the filesystem. It's a much simpler playback tho, no effects, bpm changes, etc.

As a last note, the reason I didn't pursue this further, other than my technical ability is that streaming from flash seemed good enough and with 16MB as you say, the need became less important. Another reason is that I also started pursuing adding synth instruments for some future version. This, while moving further away from the "spirit" of LGPT, makes more sense, I think, in such a memory constrained platform.

maks, 2023-12-05:
Since Deluge open sourced their Synthstrom firmware [theres some docs ](https://github.com/SynthstromAudible/DelugeFirmware/wiki/Codebase-introduction#sd-card-audio-streaming) about their use of sdcard streaming that might be useful

maks, 2025-05-01:
Moving to 2.2

Thread 3 (2023-10-15):

battery display?

maks, 2023-10-15:
With the portable edition PCB, I was trying to see if there was anything wired up to measure battery voltage and it looks like Pin 41 (GPIO_29_ADC3) is hooked up to do that with the R17/R18 voltage divider? so was wondering if you have changes in the firmware for measuring and some sort of calibration to then display that as a battery meter on screen?

democloid, 2023-10-24:
Indeed, the battery voltage should be measurable. Unsure how precisely can the level be derived as it's not a linear function.
I haven't implemented this, but it should be pretty easy.

maks, 2024-02-06:
Going to tag that I've started working on this as a number of people now have asked about it.
I don't expect to have particularly good battery % indications due to lipo flat discharge curve but Im now thinking some sort of UI indicator will be better than nothing.

maks, 2024-02-16:
The initial implementation has been done in #127 with a follow-up to improve display at all times not just during playback in #130.

A final PR to use better colours for the battery gauge is still to come.

maks, 2024-03-10:
Actually while I did do the PR to add colours for the battery gauge, I think I will keep this open until its also added to all screens as well as well as adding detection of usb being connected to be able to display a charging state as well.

maks, 2024-04-24:
The colour work was done in #134

Closed 2024-04-24.

Thread 5 (2023-10-19):

White Display

RAWJUNGLE, 2023-10-19:
Hi! I have this problem, the device turns on for a few seconds and turns off, white screen appears, I have not connected
 Sd- card, can this affect the operation?

Closed 2023-10-21.

Thread 6 (2023-10-23):

audio corruption after using "listen" button in sample browser

maks, 2023-10-23:
Now the I have a portable built, I started experimenting with some basics (not even a proper track yet) and ran into an issue with sample import and playback.

I seem to not only get corrupted audio playback with using the `listen` button in the sample import browser (which I think @democloid  you've mentioned somewhere before as a known issue) but this then corrupts all subsequent audio playback in the current project until its reloaded or the device is reset (which of course is basically the same thing with the current device reset on project load). After a reset, if the problematic sample had been imported into the project, it plays back fine if placed into a track within the project.

I'll try to poke around and see if I can see where this is happening, at a first stab, I'd guess that maybe playing back using the sample preview code somehow corrupts the audio driver so that subsequent playback is incorrect. When I get the chance, I'll also try to upload here an example of a wave sample file that causes this for future reference.

democloid, 2023-10-23:
Yes, this is a known issue (at least to me). There may be two issues at play here, so need to dig a bit deeper. As you say, if a project is reloaded after this issue, everything works fine, so it wasn't a blocker for "release" at the time.

I think it all boils down to memory issues. On one hand, I'm pretty sure I remember there being some memory leak that I couldn't pinpoint when loading samples (I fixed some tho), so the simple act going into the sample select menu would exhaust memory and corrupt audio playing.

On the other hand, there might be the issue of simply playing a sample also leaking memory or simply using too much and corrupting audio playing.

maks, 2023-10-23:
Thanks for the pointer! I hadn't thought about it from a memory corruption point of view!
I'll start looking through the code next chance I get and see if I can spot any thing. For memory, I actually already had on my todo list that it would be useful to have that displayed for debug purposes but also I think showing Flash usage would be useful for end users as for example the Polyend Tracker has a "fuel gauge" type UI to show users how much memory space (I guess ram vs flash) they have left to use in each project, so I opened a [new issue to work on that too](https://github.com/democloid/picoTracker/issues/8).

RAWJUNGLE, 2023-10-24:
What's the problem with using black pcb pico? 16mb flash, type-c usb.

maks, 2023-10-24:
@RAWJUNGLE I'm seeing this on my build of the *portable* picoTracker which unlike the "desktop" version, uses the custom designed PCB which does have an external 16MB flash on it.

maks, 2023-10-24:
@RAWJUNGLE oh, I just noticed you added that it has SPI sram as well, thats interesting! I had googled for boards usign a rp2040 with sram but haven't come across this one, would you have a link to the board you are referring too?
Though anyways, given the current custom PCB only has the 16MB of SPI flash on it, I think there is a need to get this fixed for running on the current boards.

RAWJUNGLE, 2023-10-25:
@maks
I was referring to adding an external sram.

It doesn't matter which version you use, you can install them both.
A lot of people will make their own desktop version. I'm just making a recommendation.

You could also add a battery to the desktop version and do the same on the modules.

And for those who are technically savvy to work, you can build yourself a portable board.

democloid, 2023-10-25:
@RAWJUNGLE The problem is that the pico doesn't provide an external memory interface, so an external device will not be memory mapped and to read from it you'd need to access it with SPI commands and presumably use some intermediate memory buffer to work on. It wouldn't provide much advantage than just reading from the SD card directly using the same method, except potentially some speed improvements, but that's not the main issue.

On the other hand, when I created the hardware and ported the software I wanted to go for pretty minimal and cheap hardware, which is more of a design decision rather than technical.

democloid, 2023-11-08:
This should be solved via a972675217c52bea6679f978057b36b28b4988a8

Closed 2023-11-08.

Thread 7 (2023-10-23):

file system corruption in the SD CARD

RAWJUNGLE, 2023-10-23:
when trying to re-upload the samples(new samples), the file system crashes and the SD CARD no longer works.

democloid, 2023-10-24:
What do you mean by "re-download"? can you describe in detail the steps you're doing?

RAWJUNGLE, 2023-10-24:
1. Upload samples to SD-Card
2. Upload to picotraker
3. Used samples
4. Off pikotracker
5. Upload new samples
6. Corrupt file system

When trying to format the SD card, I get the following errors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

democloid, 2023-10-24:
Is it possible you have a bad SD card? the SD card is not mounted as you would in an OS, but read or written to with each operation as needed.
The only write operations that happen are when saving a project, so it's very unlikely that the mere act of loading samples may corrupt the SD card.

RAWJUNGLE, 2023-10-24:
3 new SD-Card Sun Disk 16gb corrupted on file system.

I formatted on terminal, But the problem won't go away.

Two of my friends who have collected have the same problem.

maks, 2023-10-24:
@RAWJUNGLE I just saw your other issue, so I thought I'd better first check which version of the picoTracker you are using? The "desktop" build or the "portable" using the custom PCB?

RAWJUNGLE, 2023-10-25:
The problem is at the code level, it doesn't depend on the hardware in any way. I built on a breadboard and got these problems. Both with file count and file system problem. I checked this on 3 sd cards and several of my friends checked on their schematics, both breadboard and PCB. They have the same thing.

When you first load the samples, everything works fine, but when you want to load again, you get a file system problem on the sd card.

maks, 2023-10-25:
@RAWJUNGLE I did some quick tests with my desktop build picotracker which uses a standard RPI pico board using a brand new San Disk Ultra 32GB sdcard to see if I could replicate the issues you reported.

First off I was able to copy across large numbers of sample files, you can see the listing here:
[filelist.txt](https://github.com/democloid/picoTracker/files/13161092/filelist.txt)
onto the sdcard in the `samplelib` folder as well as a few samples from the lgpt "10k" demo

and then do the following steps:
*  create a new picotracker project on device
* open the folders with the samples
* listen to one of the 10k samples (bassdrum.wav) and import it into the project
* save the project
* turn off picotracker
* put the sdcard back into usb sdcard reader attached to my laptop (running ubuntu 22.04) and successfully read the sdcard on the laptop
* copy more samples from laptop onto the sdcard
* put the card back into picotracker, listen to and then import another sample into the project
* put the card back into laptop reader and browse and read files on sdcard with no issues

So I can't replicate any issue with sdcard filesystem corruption with the above tests.

BUT I did come across several bugs:
* listening and then importing even a tiny sample causes all further playback in the project to be corrupted
* trying to list a directory with over a hundred files in it on the picotracker first takes a very long time 10-15 just to go into the directory listing after pressing `A` to go into it. And then the listing is truncated for me after about 30 entries (sorry I was in hurry and didn't note down exactly how many) with a `F` char being displayed on the last 2 lines  instead of the actual file names.
* the second time around importing a sample actually killed all audio playback. Picotracker still went into playback mode (ie going into the project page to click `save song` would give an error message of `not during playback` but no sound was produced and the playback marker `>` were not being drawn on the song or phrase columns.

All of the above were fixed with a restart. At least 2 of the above are already tracked in #6 so I'll update there with my findings.

So tl;dr there definitely are issues with browsing directories with large numbers of sample files as well as issues importing samples, but I couldn't so far see any evidence of filesystem corruption.

@democloid One thing to note though, is that on importing samples lgpt and hence picotracker does also write the sample file into the projects `samples` sub directory, so I guess at least in theory that could somehow corrupt the filesystem if invalid data was first read during the sample import process, but thats only a guess as I can't reproduce the symptoms in the original report here.

RAWJUNGLE, 2023-10-25:
Format your SD card, Fat32 format, upload this folder via a link to the root of your SD card. And try working with LGPT, then disable LGPT, and add more sounds to the samplelib directory.

https://dropmefiles.com/nXI8v

maks, 2023-10-25:
@RAWJUNGLE sure I'm happy to test it out, but you have set a password on the zip file that is inside the outer zip file.

RAWJUNGLE, 2023-10-25:
@maks when you download it, you're shown the password 123

democloid, 2023-10-25:
@RAWJUNGLE You seem to be having this problem trying to read back this SD card on the computer. Do you see the same corruption issues or any errors if you subsequently keep using the SD card in picoTracker?

democloid, 2023-10-25:
I can't reproduce this. I noticed some samples have spaces in the filename and thought that might be a problem but it's not. Also using OSX and SD card can be read perfectly well after loading samples into project and saving the project.

Any specific samples you're using? Please tell us one specific sample that causes this. Please try to provide a minimal case that causes this, if it happens after loading a single sample, then which one it is? Is it happening to any samples being used?

RAWJUNGLE, 2023-10-25:
@democloid Pay attention to the posts above, I uploaded the sample pack I use to a file-sharing site. The password for the archive is 123.

democloid, 2023-10-25:
Of course I read the posts. The sample pack has lots of samples, loaded some random ones and couldn't repro. So asking if it happens with specific samples and to provide the name of one with which it does.

RAWJUNGLE, 2023-10-25:
@democloid
1. Format sd to fat32
2. Upload samplelib to sd
3. Create new project
4. Upload samples to tracks
5. Listen more samples in browser.
6. Play patterns
7. Save project
8. Off lgpt
9. Insert sd card to computer
10. Upload new samples or folders

RAWJUNGLE, 2023-10-25:
@democloid 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

RAWJUNGLE, 2023-10-25:
@democloid upload to new sd card sandisk 32gb. The problem with the broken file system is gone. But there are still problems with large number of files in the browser and pre-listening.

maks, 2023-10-25:
@RAWJUNGLE Thanks for continuing to test and update us with your findings.
It sounds like it was a faulty sdcard and the second 32GB  is working for you without filesystem corruption.

In regards to what you see in the photos with the file listing being cut off for directories with many files and then showing just "F" on each line after some limit is reached (on my test dir its 26 files), I can confirm I see exactly the same thing as I mentioned in my previous comment above. Interestingly though, I have a top level directory with 65 sub directories (not files in the top level dir) and all 65 subdirs *are* displayed correctly.

I also can confirm that audio playback does get corrupted when using `listen` button from the sample file browser, but as you saw that is already being tracked in #6. So I think lets keep the focus of this issue now on the bug of listing files in directories which have more than

RAWJUNGLE, 2023-10-25:
@maks sd 16gb works fine on m8, raspberry pi 4, micro dexed touch, and smartphone.

I don't know what the problem is.

maks, 2023-10-25:
@RAWJUNGLE Sorry to keep asking more questions, I'm just trying to better understand what you are seeing...
So that 16gb card can be read/written fine on all those other devices after you save a picotracker project on it but it can't be read on your Mac?
Or do you mean that after reformatting it, it works fine on all devices until you use it to save a project with the picotracker?

RAWJUNGLE, 2023-10-25:
@maks Above I described the steps that should cause the problem.
Download the samplelib. And do the steps.
Check it out.

democloid, 2023-10-25:
@RAWJUNGLE I tried again, using some specific samples that I see in the screenshots and following the steps you provided but still cannot repro. May have to do with the specific SD card for some reason.

RAWJUNGLE, 2023-10-25:
@democloid There is also a problem with the display of files @maks He confirmed above.

I figured out the file system, just changed the sd card.

maks, 2023-10-26:
Ok a quick check of adding:
```
#define MAX_FILE_COUNT 24
  int count = 0;
  FsBaseFile entry;
  while (entry.openNext(&dir, O_READ) && count < MAX_FILE_COUNT) {
```
in `picoTrackerFileSystem.cpp` prevents the `F` chars and no display when scrolling past 25 files I was seeing, so it seems that it is a memory corruption issue due to too large usage mem usage, because going into a dir causes the above function to create a List object of `Path` entries for every file in that directory.

Unfortunately the first thing that comes to mind to fix this: changing to paging through a dirs filelist with the page size being limited to the 15 max lines that can be displayed at a time doesn't look easy to do the way `ImportSampleDialog::setCurrentFolder` is structured at the moment, especially as the code in there also does a alphabetic sort of the file listing :-(

Another memory saving alternative would be to maybe have a subclass of FilePath that just holds an int index of some kind to each file and then only creates the filename string on demand.

In any case, this is not a hard fix, but it is a labour intensive one that will need a fair bit of code refactoring unless some one cna think of a clear hack to get around this large ram usage when listing directories of sample files.

democloid, 2023-10-26:
Storing a sorted list of file indexes would not occupy much memory and sorting the indexes could probably be done by reading the file name from the filesystem for each operation without much impact, but need to test. It does require some laborious refactor, agreed.

Ultimately tho, hard limits need to be set. A linked list is probably not the best solution in this case, so maybe those list objects should be replaced by some other fixed memory size data struct, in order to be able to statically define it and avoid dynamic allocations.

RAWJUNGLE, 2023-10-26:
@democloid @maks Let's create a chat in Telegram, so that it would be more convenient and faster to communicate directly! Something like a chat of testers.

maks, 2023-10-26:
awesome thanks for setting up the server @democloid !

In regards to this issue I wanted to propose:
1. Put in a quick fix straight away, basically I would do I PR with my code above plus add a "fake" File entry in the 26th spot of "[FILE LIMIT REACHED]" and add to existing `docs/MANUAL.md` clearly stating the 25 files per dir limit.
2. Work on larger task of refactoring the sample browser and filesystem adapter to use much less ram for browsing larger sample directories

democloid, 2023-10-26:
That's a perfectly reasonable short term solution IMO, go for it

Closed 2023-10-30.

Thread 8 (2023-10-23):

UI to display ram usage

maks, 2023-10-23:
It would be helpful to show the user how much flash space is left (for importing samples) into a project (the Polyend tracker for one has exactly this UI for its limited sample memory per project). But showing ram usage is likely useful for both dev debug purposes and I guess even end users as this is a limiting factor for project size.

democloid, 2023-10-24:
Displaying flash available should be pretty easy, as there is a variable that points to the current flash location and another one to the end.

Displaying RAM is probably not very useful outside of debugging operations, and that can be achieved with debug logs. Ideally there shouldn't be any dynamic allocations on embedded devices due to the limited memory (or all the heap allocations should happen in the beginning, which is what mostly happen upon loading a project). This wasn't built with that in mind so there are a ton, but in normal operations they are limited to UI elements being created and destroyed for the most part. IIRC all buffers are statically allocated. Bigger data structures like the song structures, instrument loading, etc. are still dynamic but all loaded upon project load and don't change thereafter.

maks, 2024-02-16:
While thinking about reinstating CPU usage in #131 I realised that just as it is useful to show CPU usage to a user during playback, it would be useful to show the user RAM usage during editing and it would fit nicely in the same spot in the UI.

This way just as a user can use the CPU to make decisions on what to use or remove in their project, they could base decisions on what to enable or not during editing based on Ram availablity. I guess though this is a debatable topic though so would be keen to get your thoughts on this @democloid given current work on moving to more static mem allocation.

I think displaying flash usage is a different topic and has consensus already so will move that to a separate issue and update title here appropriately.

maks, 2024-02-17:
Ok I think we've got very different views on this so I'll try to argue my case here.
While I think it's possible to provide that kind of predictable behaviour for simple instruments like say a 303, I don't think it possible for full featured devices like the picotracker without drastically limiting what users are able to do.

As a case in point with the number of channels, while 4 or 6 might be the limit with only sample instruments there's no problem using all 8 with midi or even a combination of samples and midi. Then there's use of commands and tables which can easily make a big difference on how many simultaneous tracks the rp2040 can handle. Things get even more complex with synths as for example 3-4 full 6op DX7 voices will be the same computationally as using upto 8 2-4op instruments.

Looking at prior art, afaik pretty much all existing grooveboxes allow the user to choose settings that will overload the system and then leave it up to the user to choose tradeoffs to not hit the limits of the device. For example the Electribe2 which I previously had is infamous in its user community of its voice stealing because of the 24 voice limit it has which is actually not just about voices but the DSPs capabilities as it also includes use of FX like reverb.

Given the above what erks me about for example the E2 is not the limitation exists but the complete lack of observability of it to the user! There's no way to know that you are reaching the limits until you hear it. This is where I think devices like the higher end MPCs (& machine+ & korg workstations?) are better in having CPU usage gauges just like general purpose OS's, to show the user how much capacity they have left.

So I'd sum up to say that I think CPU usage, while dynamic, is otherwise just a constrained resource exactly like Flash storage or battery charge, where it's not controversial that you would want to show the user how much of the resource is left to use. I'd of course argue the same for Ram usage but I'd say CPU usage is much more important.

maks, 2024-10-24:
obsolete as of #219

Closed 2024-10-24.

Thread 10 (2023-11-06):

1.1 Roadmap

democloid, 2023-11-06:
Objective: No new features, fix known issues with 1.0. Add functionality that should have been there in 1.0

- [ ] Fix sample import dialog
  - [x] Audio corruption after import
  - [x] Audio corruption after listen
  - [ ] Directory listing limitations (currently capped at 25 entries due to memory issues)
- [ ] Add MIDI In
- [ ] Test and potentially fix Midi Out (pretty confident it's not correct)
- [ ] Improve battery life (exploratory)
  - [ ] CPU frequency up only when playing
- [ ] Fix "Compact Instruments"

democloid, 2023-11-20:
Tracking this via milestones

Closed 2023-11-20.

Thread 11 (2023-11-06):

1.2 Roadmap

democloid, 2023-11-06:
Objective: new features

- [ ] New instruments (synths)
- [ ] Show in sample import dialog if a certain sample is already imported (and don't re-import)
- [ ] Fix sample import "Listen" option to play at the right sample rate

maks, 2023-12-02:
I thought it might be good to break these out into their own issues and not sure if you know as Github has the "Milestone" functionality so this could be replaced by one which each of the separate issues are assigned to - hope thats ok and I closed this one.

Closed 2023-12-02.

Thread 13 (2023-11-14):

Output volume too high for some headphones

maks, 2023-11-14:
Currently the output volume seems to be very high at the moment and the master volume setting stops at a value of 10 not 0.

I'm not across I2S or how the PCM5102 is controlled, but I guess either the actual audio data sent via I2S needs to be made lower or there is some sort of control of the PCM5102 on board amplifier?

In regards to the master volume UI @democloid did you set the min to 10 or is that legacy from Lgpt?

democloid, 2023-11-14:
@maks 10 is what was there. This is unfortunately a hardware limitation and I think that it varies widely between headphones and line level. I think we need to test this further and decide what route to take, can see multiple options:
1. Optimize for headphones and either make the default volume lower or lower the overall master volume (or both)
2. Defer to hardware V2 for a better option
3. Not do much but allow lower than 10 level

RAWJUNGLE, 2023-11-15:
@maks  @democloid
You need to do in the project window - master volume, and set the volume to 50%, I think that will get rid of the problem temporarily, a lot of people. But it would be more convenient to make a mixer. However, as a temporary solution, make only master volume control.

maks, 2023-11-15:
@RAWJUNGLE I'm well aware that we could simply left/right shift the 16bit values to control the volume, but that's not ideal as we are losing accuracy in the actual output data going to the DAC, so that's a *last* resort.

@democloid So I did a little bit of research on this. So according to docs, Line Out is supposed to go into other equipment (with it's own amps) so those inputs are expected to be high impedance so the line out sec only needs to drive a low current for the required voltage range. But my (na d most) headphones are the opposite: low impedance, so normally a headphone out needs an amp to be able to drive them with sufficient volume (I still at least remember my v=ir from school 😅).

But strangely what we are seeing is the opposite, high volume when going into a low impedance headphones. Unfortunately I don't have a fancy pair of high impedance headphones to test this with (and I probably wouldn't want to test with super expensive headphones anyways I guess 😂)

Also doing a quick read of the PCM5102 data sheet shows that it's a pretty basic DAC but does show it has "advanced mute control" hooked up to "analog mute" blocks on the line out but the data sheet talks about that being for muting in undervoltage protection, not something for output control :-(

Anyways the current behaviour leaves me very confused on what's going on...

maks, 2023-11-15:
Yes here we go, it's 2V into *10kohm*!

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

No way my earbuds are 10kohm 😂

maks, 2023-11-15:
So more data sheet reading gives:
> surpasses all other charge-pump based line drivers by supporting loads down to 1kΩ.

I looked up the rating on my old Sony 1000mx3's and it says they are 16ohm passive mode, 47ohm in active mode.

But I've now found this on SO:
https://electronics.stackexchange.com/a/218336/9898

which helps explain I think what's happening, headphones only need a relatively small amount of current so no wonder the lineout can drive headphones very hard.

maks, 2023-11-15:
So tl;dr this is the best quality solution for now: https://www.jaycar.com.au/stereo-in-line-volume-control/p/AA2004

@democloid I guess adding a pot on the output would be another nice enhancement for a v2 PCB but I think you're ahead of me and already told me that 🙂

maks, 2024-01-02:
After discussions with @democloid the way forward here is to use 32bit samples via i2s to allow scaling the output volume cleanly, as 32bits gives a huge dynamic range for us to work with to control output volume without losing any noticeable quality.

Closed 2024-01-29.

Thread 14 (2023-11-14):

Decrease RAM usage of Import Sample Dialog

maks, 2023-11-14:
Currently its not possible to open a directory containing more than about 25 samples because of the large amounts of ram used by the Import Sample dialog that came from LGPT.

This occurs for several reasons:
1. `I_Dir` is just a subclass of `T_SimpleList<Path>` so that everyfile in a directory is actually stored in the list with its full path not just the filename, so the containing directories path is stored in every files `Path` object
1. The whole contents of a directory are read into the `I_Dir` list when entering the directory, even though only 15 (`LIST_SIZE`) can be displayed at any one time by the UI, but this is necessary in order to be able to sort the file list for a dir
1. The `ImportSampleDialog` itself maintains another list `sampleList_` that it then copies (based on filter criteria, eg, if dir, if `*.wav`, the items from the list returned in the `I_Dir` object by `picoTrackerFileSystem`.

In my initial testing, it seems there is only a few (3-5?) KB of ram available for the ImportSampleDialog to use so the above code is very limiting in what size of dirs can be handled at the moment.

To try to improve this my plan is to create a new `PagedImportSampleDialog` class that uses paging, so that it only ever requests the 15 items it needs to display at any time. Then I need to create a new interface, `I_PagedDir` that supports being given a dir path and a s start index and it returns the 15 items from that start index.

**But** the tricky thing here is: sorting. In order to be able to sort a directory, the new `I_PagedDir` would need to read and store every filename in a dir and that could just be itself run out of ram in large dirs: eg. for a dir with 300 files, average filename length of 20 chars gives: ~5.9KB and blows the ram budget. SDFat is capable of dealing with files just by a "directory index" `int` BUT then there is no way to alphabetically sort the contents :-(

So the 2 options I can see for the above are:

a. allow upto thousands of files per dir BUT they will not be sorted when displayed (except for subdirs which could at least be sorted to be at the start of the list)

b. limit the number of files based on filename lengths this could be anywhere from 20 to 100 but still allow for displaying them in alpha sorted order.

democloid, 2023-11-14:
Couldn't we just do a much slower but potentially fast enough approach? Thinking if we could build a list of directory indices and sort it by reading from SD each time we need to.
Another advantage of this approach is that we could use static memory for this list, say we want to support 100 files per directory, then we use a static 400 bytes (indices are uint32) for storing and sorting files in each view. Even wonder if we could cast indices to a smaller int in practice.

Otherwise I'd just go with no sorting probably.

Option b is not something we want to do. While there is a lot of dynamic memory being used in picoTracker, any new features should be developed with a fixed memory footprint in mind. Otherwise it's really hard to add/remove features without breaking things.

Closed 2023-12-06.

Thread 17 (2023-11-20):

Investigate memory usage

maks, 2023-11-20:
There are likely alot of places in the LGPT codebase where memory usage is acceptable for larger devices but could be greatly optimised to decrease precious RAM resource usage on the pico.

For example Sample Instruments are approx 6kB, Midi just under 1kB while there are several audio buffers 7 and 14kB in size.

It needs investigation into how easy/hard it would be to optimise the above but would potentially free up significant amounts of the RP2040's RAM budget.

maks, 2024-03-03:
I'm going to close this now as the research has been done and open new issues to track actually doing code changes to reduce ram usage in different parts of the codebase.

Closed 2024-03-03.

Thread 18 (2023-11-20):

Auto detect amount of flash in device

democloid, 2023-11-20:
In order to support the DIY version of picoTracker using the standard Raspberry Pi Pico, we'd need to detect if the device has 2MB of memory or 16MB for the portable version.

democloid, 2023-11-20:
Try this: https://forums.raspberrypi.com/viewtopic.php?t=334042

Closed 2024-01-10.

Thread 20 (2023-11-20):

Fix "Compact instruments"

democloid, 2023-11-20:
Doesn't work

maks, 2024-02-16:
The pseudo code for this could be:

- check if playing, is yes show warning message that can't to do this while playing (same as "save project")
- iterate through sample instruments to create list of samples in use
- iterate through all sample files in project folder , deleting any that are not on above list
- reset pointer to flash where samples are stored
- do a normal load of all (remaining) samples in project folder

Closed 2025-01-18.

Thread 21 (2023-11-20):

Samples and Flash

RAWJUNGLE, 2023-11-20:
@maks @democloid

Pico-tracker, works correctly only with samples, mono 16 bit 22050Hz. all 8 tracks work well together with long and short samples at the same time.

16 stereo 44100Hz - do not work correctly, sometimes they do not turn on.

Samples - https://discord.com/channels/1166483348634480650/1167241783026139186/1176193011521163344

I checked, for some reason you can't work with samples in more than 3 tracks. They just don't work.

Track 1 - vocals
Track 2 - drums
Track 3 - pad

and then the samples don't work.

I tried to make them different lengths, sometimes 2 tracks work, sometimes three.

Now I tried to upload many parts

All samples 8 secs long

4 bass files
4 pad files
1 drum file
4 vocal files

bass/pad/vocals/drums - each file has a size of 353kb

Short samples work fine. in 8 tracks / 16 instruments
But if you add samples of 8 seconds or more, problems occur.
There is enough memory though, the samples come out to 5 megabytes.

Project - https://discord.com/channels/1166483348634480650/1167241783026139186/1176193494587547648

My Pico 16mb Black. All samples mono 16 bit 22050Hz.

democloid, 2023-11-20:
Did some testing on what works and what fails. I confirmed that the 27s mono 16bit 22050Hz file seems to work fine (although with some distortion?) but the stereo 16bit 44100Hz doesn't, never finishes copying to flash.

I used the failing file to create shorter samples, of length: 15s, 10s, 5s and 2s (file sizes: 2.52MiB, 1.68MiB, 861KiB and 345KiB)
15s and 10s also fail to load, 5s and 2s load fine and work as expected, so it's not a problem with stereo or 44100Hz files.

Will need to investigate further.

RAWJUNGLE, 2023-11-20:
@democloid  The problem with memory is if you use long samples.
Also try uploading a large number of 16/44100 stereo samples.
Also try using my project to check.

Closed 2024-02-09.

Thread 22 (2023-11-21):

Add build instructions for the "portable" model to the repo

maks, 2023-11-21:
There are already great instructions for the original prototype in `docs/BUILD.md` but there is only the [blog post for the portable](https://democloid.com/2023/06/22/picoTrackerPortable.html), so would be nice to take the blog post "Assembly" section as a starting point for a new BUILD-portable.md for here in the repo with just some small updates for variations such as my using JST connectors for the battery.

maks, 2024-10-25:
The current docs/BUILD-portable.md should be sufficient here and includes link to the blog post already.

Closed 2024-10-25.

Thread 23 (2023-11-21):

Second click in a double click combination of the A button not registered on the Chain screen

maks, 2023-11-21:
Reported from Discord help channel:

> I consistantly have an issue where I double click to make a chain on the song screen, and go into the chain, and double click to make a new phrase, im so use to doing this because of prior experience, but picotracker consistantly misses the second click in the chain screen the first time

maks, 2025-01-10:
No other reports of this so closing for now.

Closed 2025-01-10.

Thread 25 (2023-11-23):

bring back support for mapping.xml

maks, 2023-11-23:
Turns out that mapping.xml is useful for more than just key mappings on generic devices as per a comment on Discord (see below) it can also be used for basic "macro" functionality which would be very handy for midi inputs.

----

>I've used additional buttons for quick mute / solo / "scene launch" functions 🙂
>djdiskmachine — Yesterday at 7:59 PM
>Like this in mapping.xml

```
<!--
Macro 1
        Stop Phrase (Selected phrase cue stop)
-->
        <MAP src="key:0:escape" dst="/event/rshoulder" />
        <MAP src="key:0:escape" dst="/event/start" />
<!--
Macro 2
        Queue Phrases (Current row Phrases cue play)
-->
        <MAP src="key:0:return" dst="/event/lshoulder" />
        <MAP src="key:0:return" dst="/event/start" />
<!--
Macro 3
        Solo phrase (hold to solo, release to unsolo)
        Warning: will do weirdness if combined with other buttons! Use with caution ;)
-->
        <MAP src="key:0:s" dst="/event/a" />
        <MAP src="key:0:s" dst="/event/rshoulder" />
<!--
Macro 4
        Mute phrase (hold to mute, release to unmute)
        Warning: will do weirdness if combined with other buttons! Use with caution ;)
-->
        <MAP src="key:0:m" dst="/event/b" />
        <MAP src="key:0:m" dst="/event/rshoulder" />

```

maks, 2023-11-23:
Doing this would also remove the need for the current "M8" keymap setting in `config.xml` as then users would be able to configure any mapping they want.

maks, 2024-04-24:
I think setting up the single alternate key mapping is as far as we want to go with this, so closing this off.

Closed 2024-04-24.

Thread 29 (2023-11-27):

Don't display files beginning with a period

maks, 2023-11-27:
"Dotfiles" are by convention not listed on unix systems and should also not be listed in the sample import browser dir listings.

democloid, 2023-12-08:
@maks this broke with 4ed8fd43fe2f05b5ed889ec4d0a2cd1774b7dd19
Tested working fine before, probably related to file filters used

maks, 2023-12-08:
> used

Yes definitely I broke it with my change. Ive left it for now as a good first PR for a new contributor to project but I'll fix it if no one gets to it in the next little while 🙂

shockdesign, 2024-01-22:
@maks Looking at the code here, would you think it would be best to ignore the Dotfiles in the wildcard match function?

maks, 2024-01-22:
@shockdesign yes that's the change that needs to be made. I left this as a small task for a "good first issue" for new contributors :-)

maks, 2024-10-25:
done as of #219  though note if file has a `.wav` suffix it will still be shown.

Thread 31 (2023-12-02):

Improve UX of the the Sample Import Dialog

maks, 2023-12-02:
Currently the Sample Import Dialog UI is inherited from lgpt and uses onscreen buttons which don't really make sense for a UX that is directed at ergonomic use of the hardware keys. Therefore it would be nice to improve the UX by replacing the functionality of the buttons with just direct mapping of those functions to the physical keys.

democloid, 2023-12-07:
@maks I'm not entirely sure about the UI on this one TBH. Is this replicating M8 or is original workflow?

Couple of thoughts to start a discussion:
I feel it's unintuitive that we enter with A, but exit with shift+left. Should these be power user shortcuts while maintaining the old UI buttons?

Plus it seems we are breaking the consistency in terms of pop-up windows having navigation buttons vs shift+arrows for normal page navigation.

Should the dialog be a screen instead? this has it's own intuitiveness problems IMO, but I could see a path where everything is a screen unless it's a "yes/no" or "ok" kind of dialog like in the load/save or firmware update dialogs.

maks, 2023-12-07:
Thanks @democloid all very good points! 👍🏻

I must admit I don't really remember much of using the M8 when I had a headless setup, so this was mostly my own "UX design"  plus based on comments I saw from one user on discord mentioning just using physical keys instead of onscreen button widgets.

I did just go look at a video of a M8 being used and at the manual and looks like its file browser doesn't use any onscreen buttons and it uses the "Option" button to exit the file browser (M8 manual doesn't call it a "dialog"). It also uses the "Play" button to preview samples and the "Edit" button to load.

I think it would make sense to match the M8's UX for the sake of existing users as theres no preexisting ones in lgpt anyways.

For me, I think its better that this (and the project browser) stay a "dialog" or "popup window" and not another "screen" though could really stop calling it that and also get rid of the not very useful colour border drawn around it. But also you've highlighted a good  point that really need to make the project browser consistent and use the same ui & code.

So @democloid in summary, what do you think about:
* keep file browser as a "popup aka dialog" but remove border
* use above key functions (same as M8)
* make project browser use same UI
?

maks, 2023-12-07:
I should also add that even in my brief testing, the current onscreen buttons I found quite annoying, as my usual pattern of using the sample browser is: quickly scroll through samples, playing one after another in rapid succession, when I hear one I like, import it and then keep scrolling through looking for more and then import next one I like. Doing the above with onscreen keys I found very error prone, as I'd keep forgetting to move the selected button from [Import] back to [Listen] and then keep importing samples I didnt mean to.

democloid, 2023-12-08:
@maks
Couple of thoughts:
1. Again, not sure how it works in M8, but I feel having different button to browse vs "play" is kinda weird. I naturally gravitate towards trying to use the same button for up/down dirs and "play" the sample (in my case that's A, but that's less important)
2. In terms of rapid browsing (with which I agree with you), I feel it's better if playing a sample stops previous playback and starts new rather than having to stop first. Disadvantage with this is that there would be no stop button with this way. Ideal would probably be: If play is pressed again in same sample, then it stops. If play is pressed again in new sample, start that new sample (while first stopping playback of previous, if still playing)
3. Don't personally care that much about border or not, maybe it's not bad in terms of hinting the user that it's a different type of screen
4. Project window is separate IMO. Do you propose removing Load/New there too?

As an additional thing we could think about here, even if not implemented right away, how do you effectively listen to single cycle samples? Maybe UX could be that maintaining "play" pressed will play continuously and loop around.

maks, 2023-12-09:
1. Yes I chose using the Play button just because of the association of it being "play"  and it was easier not needing to add check in button action handler for if selected item was file or subdir 🙂  but totally fine with using `A` instead if you prefer that?
2. Yes sure thing, can implement it that way, so that starting play on a sample while another one is playing, stops it first, would you like me to implement it that way?
3. Ah good point, it is a good way to show that, I just make it a bit thinner and then we could fit a few more chars per line though that eats into ram a bit more, I've noticed some people like long filenames for samples 😅
4. Yes project is separate but I'd like to make it consistent with this UI. And yes I was wanting to remove the buttons there too and instead have load/new in the project screen. That is influenced by how M8 has it, but now that I've seen its design I like it and cant un-see it 🙂 If you are ok with doing that, I'll make a separate issue to track work on changing the project file browser too.

If we agree on above, at this point I think I would also remove the original ImportDialog code and just have some `ifdef`s just to set picotracker specifics like size of the file item vectors.

And funny you mention single cycle previews as I was thinking about that too just yesterday as I was trying to use some and it was annoying not to be able to audition them. I'll raise an new issue for that as I had some initial thoughts on how to handle that.

democloid, 2023-12-15:
@maks let's roll with this

Closed 2024-01-01.

Thread 32 (2023-12-02):

Allow stopping preview playback of samples in the Import Dialog

maks, 2023-12-02:
Its quite annoying, especially with longer samples that there is currently no way to stop playback when doing "preview" playback of samples in the import dialog.

maks, 2024-01-07:
This was done as part of #54

Closed 2024-01-07.

Thread 34 (2023-12-02):

Show in sample import dialog if a certain sample is already imported (and don't re-import)

maks, 2023-12-02:

democloid, 2024-01-29:
@maks There are a number of improvements that could be made regarding samples tracking that could be combined into one properly made feature. Off the top of my head:
1. Tracking imported samples (not by name, probably by hash)
2. Deleting importing samples (this required handling of flash and fragmentation)
3. Tracking sample memory usage
4. Tackling the issue still pending of potential memory leaks or over usage on larger directories

maks, 2024-01-29:
@democloid agreed on all points! I do have a few thoughts on some of the points:
1. I think hashing could be quite expensive cpu, ram and time wise, especially for longer sample files. Perhaps just filename+filesize would be enough? This could be a problem for single cycle files where they could all be the same length, but for this case, we could just warn users that a sample with the same name already exists in the project and prompt: `overwrite/rename?`
2. yes agreed and on this topic, I have been worried about the current use of the same part of flash for loading a projects samples everytime, especially if only a few small samples are used in the project. So to help with that and fragmentation on delete, it may be worth now looking to use a real filesystem for that part of flash storing current projects samples? There are *lots* of options in this space to choose from, [a few are discussed in this thread](https://www.reddit.com/r/embedded/comments/mvoi23/choosing_an_appropriate_file_system_for_spi_nor/) but there are others too.
3. 💯  on this. I think it would make most sense to show this on the sample import dialog screen.
4. For me this would be the lowest priority as apart from the [bug I need to urgently fix](https://github.com/democloid/picoTracker/issues/83) I think the import works "well enough" for now.

maks, 2024-01-29:
Just following up on the FS part, https://github.com/littlefs-project/littlefs looks very good, very mature and still very actively maintained.

shockdesign, 2024-01-29:
My approach was very pragmatic.. however it raises one question..

Say a user imports two samples with the same name from two different directories, how are they supposed to know the difference when selecting them?

As for file hash/checksum, maybe we should use something like `CRC32` as it is quite fast ..

```
#include <inttypes.h> // uint32_t, uint8_t

uint32_t CRC32(const uint8_t data[], size_t data_length) {
	uint32_t crc32 = 0xFFFFFFFFu;

	for (size_t i = 0; i < data_length; i++) {
		const uint32_t lookupIndex = (crc32 ^ data[i]) & 0xff;
		crc32 = (crc32 >> 8) ^ CRCTable[lookupIndex];  // CRCTable is an array of 256 32-bit constants
	}

	// Finalize the CRC-32 value by inverting all the bits
	crc32 ^= 0xFFFFFFFFu;
	return crc32;
}
```

maks, 2024-01-29:
@shockdesign its not so much the speed of the hashing alogrithm, its that it needs to read through the whole file to calculate it and the speed of that is not great for larger files, even when reading from the onboard flash. But I guess we could do that only once during sample import when we have to read the whole file from the SDCard anyway and then cache it in the project file.

shockdesign, 2024-01-30:
@maks yeah definitely something we only do once and store... even if we're doing it when we go to check if the file already exists, then just pass it through so we never have to do it again.

shockdesign, 2024-01-30:
@maks the other thing is we can do it again potentially on project load to verify the samples haven't changed? But thats not as important.

Thread 35 (2023-12-02):

Fix sample browser sample audition to play at the right sample rate

maks, 2023-12-02:
The sample audition code in the sample browser should parse the header of a [sample wave file to get its sampling frequency](https://en.wikipedia.org/wiki/WAV#WAV_file_header) and then use that to adjust playback rate to match.

I think there is already code to adjust the playback for a sample rate, but if adjusting to the sample rate is not possible, we should then just document that only 44.1khz is supported.

Closed 2025-04-16.

Thread 36 (2023-12-02):

Add new instruments (synths)

maks, 2023-12-02:
Currently the lgpt codebase only allows for sample and midi instruments, but it would be nice to support some basic synth instruments too.

maks, 2024-04-24:
superceded by other issues.

Closed 2024-04-24.

Thread 39 (2023-12-04):

Add scale setting for projects

maks, 2023-12-04:
My music theory knowledge isn't great, so would be useful to have a scale setting on projects so that I don't have to keep looking up the notes in a scale that I'm using.

democloid, 2023-12-05:
How would this work? when scrolling notes it would go through notes of scale rather than every note? Would this be a project level setting or device/global level?

maks, 2023-12-06:
Yes exactly, when you select a scale, you only get the option to enter notes from that scale. And I would expect it to be per project, so saved in a projects xml data file.

Since its the "closest relative" [this video shows](https://www.youtube.com/watch?v=BeERLyRw5G0) how its implemented on the M8, but really the concept of scale+root key seems almost same on it compared to other grooveboxes I've used like the Electribe 2 and Circuit Tracks and I think its pretty much same on the Elektrons too.

Mind you, the M8 has UI to edit scales, but I only had in mind "hardcoding" a set of scales in a header file for now, as the other grooveboxes I've used only had limited sets of presets and thats been mostly ok for me, plus picotracer is open source, so its really viable for people to contribute scales they want if not already included in the build.

Thread 41 (2023-12-06):

Add ADSR envelope for sample instruments

maks, 2023-12-06:
While I think it's possible to use tables to achieve the same or similar effect to an ADDR envelope, it'd definitely make life easier easier if this was supported directly by allowing users to set an envelope per instrument.

maks, 2025-05-01:
Need to move to 2.2

maks, 2025-05-06:
It would be useful to have a filter envelope as well as a volume envelope as having a filter envelope would allow fast filter sweeps for "303 acid" tones that are not possible with the limited speed of tables.

Thread 42 (2023-12-06):

Add VU meter to song screen

maks, 2023-12-06:
This really just comes out of the initial work already done for #28.

Its been initially done as just the volume level, but probably should be the RMS power of the output signal with a bit of low-pass filtering to simulate the needle having some inertia of the old school analog vu meters.
Also it should be displayed in dB log scale not linear.

maks, 2025-03-31:
Done as a part of #412

Closed 2025-03-31.

Thread 43 (2023-12-07):

MIDI output only works after project reload

maks, 2023-12-07:
Currently MIDI output doesn't work on the master branch. It seems a few init lines are required, as taken from the experimental `midiin` branch.

maks, 2023-12-07:
PR #44 partially fixes this, but that PR still seems to have an issue where you need to reload the project file after adding a Midi Instrument in order for Midi to be actually output.

maks, 2023-12-07:
Actually turns out MIDI output does work BUT as per above comment, only starts working after a project reload is done after the first MIDI instrument is added to a project. After that, MIDI out will continue to work fine after that.

maks, 2023-12-08:
> Are you trying this on a fresh project? and does the MIDI section on the project screen show the "right" midi out? (as opposed to null)

Yes on a fresh project. And yes the MIDI entry on the Project screen shows `MIDI OUT 1` immediately after a fresh project is created. I then create new pattern, add single C3 note for Midi Channel 1 instrument and hit play - no sound from the attached Midi synth.
I then stop playback, go back to Project screen, Save and the Load the current Project. Hit Play and sound plays as expected from Midi synth.
Are you not able to replicate this on your setup?

maks, 2024-05-05:
This is annoying me enough now that I will take a look at it. Currently suspect either `MidiService` is not fully initialised on new project creation or device_ is null so that check for it inside `QueueMessage()` fails.

maks, 2024-10-24:
done as of #219

Closed 2024-10-24.

Thread 46 (2023-12-08):

Generate random project names

maks, 2023-12-08:
Entering names 1 char at a time with the arrow keys is tedious and results in my naming projects like "A", "B" "C1", etc.

It would be nice to have functionality to generate random names but ones still short enough to quickly edit if required.

Bonus: this could be done with minimal impact on runtime ram usage.

maks, 2023-12-08:
I've had a quick go at the generator class in the WIP PR linked to this issue, but still need to wire it up to the project file browser, but will hold off on doing that pending results of ongoing discussion about the file browser UI in #31

democloid, 2023-12-26:
@maks I was thinking about something unrelated I got me in the direction of this issue. I guess the problem we are trying to solve with this is getting started quickly with a project and create some name for it, right? (not so much finding a name for a project itself)

In that sense, I was thinking that maybe the first screen when we turn on picoTracker should be a new (unnamed) empty project, where we can go and load a new project if we want to (and the load screen should be a pop up rather than an independent screen like it is today). Thoughts?

maks, 2023-12-26:
I think these might be related but separate issues.
With generating random names, that's not so much about getting started quickly as even if we created new unnamed projects, I'd still need to spend time typing in a name once I wanted to do the first save. So this is more around providing a quick "autofill" if you like for a project name when I dont want to spend any time and effort coming up with and then entering a name for a project.
But I do also agree with having a better power-on flow. Both the PE Tracker and M8 open the last used project on power up (I think the Digitone does too?), so I think that pretty common and useful behaviour that would be nice to have in the pico too, especially if we could detect that the prev projects samples are already in flash so could skip that step as that can be bit time consuming and not necessary. If you are happy with that suggestion, I can add a separate issue for that too?

maks, 2024-10-24:
done as of #219

Closed 2024-10-24.

Thread 48 (2023-12-09):

Auditioning single cycle files in Import Dialog

maks, 2023-12-09:
It would be nice to be able to audition single cycle files in the Import Dialog. Current behaviour is just to play samples as a single shot, streamed from the sdcard.

Instead what should happen is that single cycle files should be detected and then played back in a loop using existing code.

We need some sort of heuristic to detect single cycle files, looking at the ["AKWF" collection](https://www.adventurekid.se/akrt/waveforms/adventure-kid-waveforms/) I have they are all exactly 1344 bytes so that seems like a good starting point.

For playback, it might be a bit tight ram wise, but since all the AKWFs are only 1344 bytes, we could just load them into a ram buffer and play from there just as the lgpt code did for all samples prior to the changes that load samples now into flash on the pico.

maks, 2023-12-09:
So I tried looking this up and it seems there is no agreed upon standard for how many samples should be in a single cycle waveform file, but I [did find this](https://blog.synthesizerwriter.com/2020/10/when-is-single-cycle-waveform-not.html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,would%20only%20require%204%2C410%20samples.):

>There is a lot of variation in the numbers of samples that are used to represent a single cycle waveform. In Max (and MaxForLive), the ~cycle object originally defaulted to using 512 samples of a single cycle of a cosine wave. But it wasn't fixed - you could replace the default waveform by using any other set of 512 samples, or you could change the number of samples: more recent versions of Max use 16,000 64-bit samples. A lot of the single cycle waveforms that you find on the InterWeb are 337 samples long, whilst others have 256, 1024, 2048 or 4096.

So given a 44 byte header for RIFF format, in the case of[ AKWF he used 600 samples](https://www.adventurekid.se/akrt/waveforms/adventure-kid-waveforms/) each, so 600 * 2 + 44 = 1244 bytes so I'm not sure where the other 100 bytes comes from but I think we could just have some preset file sizes (for specific number of samples) that we could look for to determine if a file is likely a single cycle waveform?

democloid, 2024-01-02:
@maks couln't the heuristic just be a sample under X ms in length?

maks, 2024-01-02:
> @maks couln't the heuristic just be a sample under X ms in length?

Yes I think that will work. Actually now I think about it some more, I think something very simple like "< 2048 bytes"  should probably handle all the reasonable single cycle files and then not false match on very short, lofi one-shot samples (eg. in tardline the bassdrum one-shot is 3.4kB).

Does that sound ok?

Closed 2025-04-30.

Thread 52 (2023-12-13):

Compiling with GCC13 has errors due to pico sdk

maks, 2023-12-13:
Recent OS upgrade gave me GCC13 as the default arm-none compiler but using it gives errors such as this one from the pico sdk:

```
/usr/share/pico-sdk/tools/pioasm/pio_disassembler.h:16:25: error: ‘uint16_t’ was not declared in this scope
   16 | std::string disassemble(uint16_t inst, uint sideset_bits, bool sideset_opt);
```

This can be solved by updating the pico-sdk git submodule commit to a later one which incorporates the fix that was made for this in the [pico sdk](https://github.com/raspberrypi/pico-sdk/pull/1367)

Closed 2023-12-15.

Thread 58 (2023-12-21):

More shortcuts for file browser

maks, 2023-12-21:
The B+Up/Down to scroll a page at a time got lost in the previous move to PagedImportSampleDialog and would be good to bring back.
Likewise other shortcuts have been suggested to improve speed of navigation, such as from @djdiskmachine:
> RT+Left to go up a level

woeps, 2025-05-30:
I started thinking about this recently, when I put more samples onto the SD card.

I was asking myself, why the available shortcuts feel kind of unintuitive to me. - I don't know much about the history and I haven't used another hardware tracker. But I do use CLI applications (TUI) on my computer a lot. Ma you be it's just me? But I feel this could be improved.

A possible keymap with as few combos as possible:

- move cursor down: arrow down
- move cursor up: arrow up
- enter subdirectory under cursor: arrow right
- go to parent directory: arrow left
- load sample: enter
- preview sample: play
- back to instrument view: Nav + left arrow
- scroll a page down: Nav + arrow down
- scroll a page up: Nav + arrow up
- go to root directory: Nav + arrow left

maks, 2025-06-02:
Some good ideas there @woeps ! Sorry to take so long to reply.

However I would be hesitant to make loading the sample just ENTER as its easy to do it unintentionally  but has annoying consequences if you do trigger it  unintentionally as a large sample will take a long time to load blocking further UI interaction til it completes and then to remove the sample the only way to do so now is to then go to the Project screen and use the compact button.

I do like the idea of having a key combo for scrolling pages at a time but I think the would need to be ENTER+arrows to match existing behaviour to do the same thing in the Song screen.

And also 💯  on having a keycombo to go back to parent dir, the need to go back via the `/..`  entry currently definitely is annoying, but left arrow sounds ok for that, though again not sure if it would be to easy to do unintentionally and then navigating back would be annoying because currently we dont yet track the prior cursor location in the parent folder.

With:
> go to root directory: Nav + arrow left
I guess thats a typo and you had in mind something else? I would think for this we could use the same key combo we end up using for resetting all fields in instrument screen to their default values, though we haven't chosen what that combo will be yet.

Also for this we want to keep in mind that we will want to reserve a keycombo for bring up a dialog with options to rename.copy.move, delete files in the future.

Thread 59 (2023-12-21):

Add way to take screenshots from a device

maks, 2023-12-21:
For things like debugging and documentation, it would be nice to have a way to grab a screenshot from a device without needing to take a photo of the actual device.

This could be done via the USB Uart or even Midi by sending a command to the pico and the pico replies back with the current contents of the display buffer.

Over Midi this could use Sysex vendor proprietary message that we define.

Over Usb uart we could just define our own simple (text-based?) protocol or we could lean on the existing protocol used by M8 for its headless mode.

maks, 2024-04-24:
This is basically now possible with the experimental serial over usb protocol and [a client remote ui app](https://github.com/maks/picotracker_client).

Closed 2024-04-24.

Thread 63 (2023-12-23):

Truncate long file sample names on Instrument screen

maks, 2023-12-23:
Currently samples with long file names are shown with the full name wrapping to 2nd line instead of being truncated to only show as much as possible on 1 line.

shockdesign, 2024-01-20:
Is there a sample picture of what it looks like when it wraps? I don't have the h/w to see..

maks, 2024-01-20:
thanks for working on the @shockdesign !
Yes here is a photo of a too long sample name on the instrument screen and for extra reference the second photo is from the phrase screen as I just realised that it should also be fixed there too, but I'll open a separate issue for that.

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

shockdesign, 2024-01-22:
@maks we should be able to close this issue now

maks, 2024-01-22:
@shockdesign yes can do.
Just for future reference, if you add to a PR's description `Fixes: #63` then when the PR is merged, it will automatically close the matching issue.

Closed 2024-01-22.

Thread 66 (2023-12-26):

Freezes after sustained use of sample browser preview

RAWJUNGLE, 2023-12-26:
@democloid @maks

I've noticed this problem when using picotracker for long periods of time.
If you listen to samples in the browser for a long time, at one point the sound disappears. When you try to save and load the project, the device freezes.

Still need a window to show how full the memory is in picotracker. It is very urgent.

I would add some more things to the song mode, it would display the bpm of the project and remove the name.
Also add an option to rename the project.

Also when working with samples there is a crunch in the sound (clicks). Can something be done about it?

maks, 2023-12-26:
@RAWJUNGLE  Thanks for reporting these issues.

Issues should be for a single issue only, so for this first time, I've created new separate issues for the clicking sound: #67 and feature request to change the song screen: #68 while there is an already existing issue covering displaying memory usage: #8 and renaming functionality: #64

I have also edited the title of this issue to match.

Closed 2024-12-15.

Thread 71 (2024-01-02):

Waveform display for samples

maks, 2024-01-02:
One thing I found quite useful while working with single cycle samples recently was having a waveform display on another tracker device I was working with, so it would be useful to have this in picoTracker also.

One question does come up for implementing this that makes it less straight forward  is the current use of a char array for the screen buffer.

Closed 2025-06-30.

Thread 72 (2024-01-03):

Support pulse sync protocol for clock input

maks, 2024-01-03:
Many devices like the volcas and pocket operators support sync pulses but not midi, so it would be great to be able to support using that protocol for a clock input.

I'll make a separate issue for supporting pulse output as well.

maks, 2025-03-04:
[Reference material for "din sync"](https://en.wikipedia.org/wiki/DIN_sync)

Thread 73 (2024-01-03):

Support pulse sync protocol for clock output

maks, 2024-01-03:
Many devices like the volcas and pocket operators support sync pulses but not midi, so it would be great to be able to support using that protocol for a clock output.

Support for clock input is tracked as a [separate issue](#72).

maks, 2025-03-04:
[Reference material for "din sync"](https://en.wikipedia.org/wiki/DIN_sync)

Thread 75 (2024-01-06):

Link the volume of the sample-pre-listening to the master volume

fpiesik, 2024-01-06:
When master volume is turned down, the pre listening of samples is still loud, it seems not to be affected by the master volume.

maks, 2024-01-08:
Yes currently the sample preview is done by streaming the sample straight from sdcard in  `AudioFileSreamer` class instead of the usual code path for import sample playback.
In that class, there is code that reads a `config.xml` file value `PRELISTENATTENUATION`, but that's not one of the config variables that is supported in picoTracker so there is no way to set a value for it as that value won't be read out of the `config.xml` because its not in the white-list in `sources/Application/Model/Config.cpp`.

My first thought would be to either apply the existing value of the master volume as you mentioned here or perhaps have a separate volume in the `PRELISTENATTENUATION` value as the code is now but also add a key combo to adjust that volume value in the import sample screen, as I think you would want to adjust there and have that saved into config.xml to persist between power cycles, versus just setting it via editing `config.xml` which is not convenient on the picoTarcker.

maks, 2024-01-08:
In the case of using the separate sample preview volume value `PRELISTENATTENUATION` we would also need to copy across the xml saving code to `sources/Application/Model/Config.cpp` as currently it only supports reading not writing.

Also it should be noted that setting output volume in general is currently an open issue: #13

Not sure what you think about this @democloid ?

fpiesik, 2024-01-08:
I believe that applying the value of the master volume to PRELISTENATTENUATION would be the most elegant and time-efficient approach. I can't think of many use cases where the volume of the pre-listening should differ from the overall volume. Besides, there are so many other cool things to do :)

democloid, 2024-01-08:
It's a completely different codepath, so it seems things are going to be kept in sync continuously, which is annoying. I think it makes sense to match this to master output volume, but if hard to do for now, I think we should probably just attenuate it enough so that it makes sense for most use cases as a fixed value.

maks, 2024-01-09:
I think it should be doable to use master volume, I'll try to tackle this soon.

maks, 2025-03-04:
Fixes in #365

Closed 2025-03-04.

Thread 76 (2024-01-09):

File System

RAWJUNGLE, 2024-01-09:
Again problems with the file system, the samples that used to work and displayed in the menu are partially gone. Some samples are simply not played. Also, I have the impression that not the whole memory is loaded with samples, but partially.

I recommend that you try working with samples of different lengths.

In some cases, you will hear a memory overload sound.

And the clock won't work right.

When replacing a file in the sampler, it is not deleted from the project and memory. Perhaps it is necessary to make at least deletion from the project, it will already save flash memory.

Project file:
https://discord.com/channels/1166483348634480650/1166796422486696086/1194429761091539005

Project size - 1mb

Audio: (memory overload sound)
https://discord.com/channels/1166483348634480650/1166796422486696086/1194430801299918878

Audio: (deleted track (chain70)clicks gone))
https://discord.com/channels/1166483348634480650/1166796422486696086/1194431887997947996

Even if I load small samples, it is impossible to overcome the 1 mb threshold. it feels like there is a memory limitation somewhere.

democloid, 2024-01-10:
This is probably just a duplicate of #18, pretty easy fix which we should prioritize @maks

maks, 2024-01-10:
@democloid I guess it's just the `FLASH_LIMIT` in https://github.com/democloid/picoTracker/blob/master/sources%2FApplication%2FInstruments%2FWavFile.cpp#L14. ?

democloid, 2024-01-10:
@maks yes, that's it. I have a patch already tested and working, will submit a PR a bit later today

democloid, 2024-02-08:
this is done

Closed 2024-02-08.

Thread 78 (2024-01-13):

Allow sending MIDI notes without specifying an instrument (for portomento)

maks, 2024-01-13:
Currently using a midi instrument on a step in a phrase will requires a midi instrument to be specified and hence will cause a note on midi command to be sent.

A user on discord requested:
> it would be excellent if I could put a note in a phrase *without* an Instrument column value, so I could send pitch and not trigger a new MIDI NOTE ON event

For the above to work, the code will need to track the last used midi instrument in a phrase and then use that if there is none specified as well as the UI code needing to be changed to allow user to edit a step in a phrase to set an empty instrument value when a note is set for that step (currently it immediately fills in an instrument value when a note is added)

code ref, the Render function in: https://github.com/democloid/picoTracker/blob/master/sources/Application/Instruments/MidiInstrument.cpp#L85

mikey303, 2024-01-13:
>UI code needing to be changed to allow user to edit a step in a phrase to set an empty instrument value when a note is set for that step (currently it immediately fills in an instrument value when a note is added)

As this is specifically a use case for note overlap to trigger Portamento / Legato, the above UI change is not necessary as you can delete the instrument value without removing the pitch (as it is currently implemented), and the use case for majority of the picoTracker users will expect an instrument to be filled by default, including those sending MIDI.

maks, 2024-01-13:
doh! thanks for pointing that out @mikey303 ! 👍🏻   I completely missed that it is currently already possible to just delete only the instrument value.

maks, 2024-04-01:
So I needed to do this with a command instead of just not setting the instrument as discussed in this issue as that would be harder to implement, requiring the need to track the previous "pending" midi instrument on the current channel, so this is a much simpler, cleaner solution.

maks, 2024-04-01:
@mikey303 one issue I've run into is that when testing with a TD-3, it needs to have at least 1 non overlapping note sound otherwise all the sound just sort of trails off and stops responding to any further MIDI input until the internal sequencer plays at least 1 note or MIDI sounds a non-overlapping note.
Not sure if thats a bug in the TD-3 (I have the latest firmware 1.37) or this is just how 303 style instruments implement MIDI and slides? Any expert thoughts about this would be most appreciated! 🙏🏻

Thread 79 (2024-01-13):

FX command to set velocity for MIDI instruments

maks, 2024-01-13:
Currently there is a command to set volume for sample instruments but none to set the velocity for MIDI instruments.

We should either allow the current `VOLM` command to set the velocity of a MIDI instrument or introduce a new command to do that.

Suggested by @mikey303 via discord.

maks, 2024-02-05:
Turns out that per https://github.com/democloid/picoTracker/blob/master/sources/Application/Instruments/MidiInstrument.cpp#L149 the `VOLM` command *does* already work with Midi instruments **BUT** it controls the CC 7 which is the "volume of the channel" which I think is not really what people would expect or want to do and instead would want to modify the velocity of the current note with this command.

morbus123, 2024-02-11:
**Idea:** Combining MIDI velocity "aa" and gate time "bb" into a single command.

_Additionally, I think it's pretty uncommon to send CC7-VOL for MIDI sequencing; maybe it's to keep sample and MIDI tracks consistent. In my experience, CC7 is used for the volume of the whole track and velocity for accenting notes._

Closed 2024-03-27.

Thread 83 (2024-01-18):

Sample import menu broken

gandaja, 2024-01-18:
Freezes the unit if I move the cursor north of the [...] symbol or south of the last sample listed. Does not display every sample in samplelib folder.
Edit: does so after upgrading the firmware to v1.1r2

democloid, 2024-01-18:
@gandaja Can you provide more info about your samplelib folder? Does it have many files? does it work if you reduce the number of files? Do you see similar behaviours navigating up/down the directory tree?

It would be ideal if you can upload your samplelib.

gandaja, 2024-01-18:
Starting from your last question: the directory tree cycles just fine.
I have three files in my samplelib, named: "bd2", "hh1", "clp1". Only shows the first two. Perhaps the names need to be of the same length?

democloid, 2024-01-18:
Name length shouldn't be a problem. The fact that only two names appear make me think that there is some invalid reference in the 3rd position where the 3rd file should be and that's why it's locking up going into that position. Not sure what exactly could be the problem, maybe an invalid wav file?

Could you upload those files to check?

gandaja, 2024-01-18:
[samplelib.zip](https://github.com/democloid/picoTracker/files/13981548/samplelib.zip)

maks, 2024-01-18:
Thanks for reporting this and uploading the files, I'll take a look at this too as its likely due to the changes I made when optimising the file browser to use less ram to work with directories with more than 25 files.
As @democloid said, file name length shouldn't be an issue, you should be able to use file names of up to 128 characters, but only ASCII, though of course keeping them short makes things easier to see in the picotracker UI.

maks, 2024-01-18:
@gandaja I just tried your samplelib zip and can reproduce the issue immediately. Its a bit strange since I'm not sure why this is suddenly broken as it doesn't happen for me with same firmware with another sdcard that has large numbers of folders and files that I've been using alot lately.
I don't have time to look into it right now, but I'll debug this more asap.

gandaja, 2024-01-18:
Thanks man.
Unsure if relevant, but I'm using a 32gb sdhc card of which I'm attaching a picture

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

maks, 2024-01-18:
@gandaja Thanks for adding that. I only had time to very quickly test your files to confirm that I can reproduce the issue you are seeing, but I dont think its to do with sdcard hardware. I think its most likely a bug in handling a small number of files and/or with short names, since when I did my prev changes, I was specifically focused on testing  the opposite: how to handle large numbers of files and nested folders without overflowing available ram, so I likely missed something for the case of only a few files. I also noticed that I havent tested with file on the top level dir vs only having folders, though I dont know if that is part of this bug or not.

maks, 2024-02-04:
There is a potential fix for this in PR #111 and the beta-users channel in discord has a test firmware with that PRs fix in it for testing.

Closed 2024-02-05.

Thread 84 (2024-01-19):

Not possible to select some instruments on a step

maks, 2024-01-19:
It seems to be possible to get a project into a state where some of the instruments are not able to be selected when cycling through instruments for a note step. But the instruments are still listed on a Instrument screen and its even possible to copy/paste the instrument number if it has previously been entered on a step somewhere else within the project, but that instrument number just doesn't get listed as you cycle through the available instrument numbers on a step in the Phrase screen.

This state persists restarts, so I would guess is linked to how instrument data is read or written to the project xml file.

In the attached project Instrument 3 shows this behaviour.

Unfortunately I only noticed this behaviour well after I had created several instruments, so I don't yet have a simple repro case, but possible things to look into which may have caused this are: importing several samples at once the creating instruments from the instrument screen (by changing to a new instrument on the instrument screen and the setting the sample it uses).

[lgpt_1TRKCOMPO.zip](https://github.com/democloid/picoTracker/files/13995204/lgpt_1TRKCOMPO.zip)

Closed 2024-10-24.

Thread 88 (2024-01-20):

Truncate long file sample names on Phrase screen

maks, 2024-01-20:
Related to #63 we should also prevent wrapping of long file names on the phrase screen, though here I think there is also some extra whitespace on the top line that could be removed to provide some more space.

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

shockdesign, 2024-01-22:
@maks we should be able to close this issue.

maks, 2024-01-22:
I'm reopening this to track implementing removing the `.wav` extension as suggested in a comment by @shockdesign on the PR that initially implemented this issue.

maks, 2025-09-26:
Obsolete.

Thread 93 (2024-01-24):

Can't access samplelib after previewing samples

Djeroek, 2024-01-24:
Hello,

I'm on build 1.1r_2 and have had the following issue;

When accessing sounds, previewing them to make a choise for which one to use in an instrument, i've already had multiple instances where a sound froze during preview. Resulting in not being able to access the samples anymore; "Can't access the samplelib" every time I try to enter "sample: (null) through double clicking. Only way to have this working again afaik is rebooting the system.

I know about the file type limitations of the unit. Will try to see if I can replicate the issue and share the particular sound causing issues.

maks, 2024-01-25:
Thanks for filing this issue. If you are able to replicate with a sample or several samples that you are able to share here that would really help in debugging whats happening.

maks, 2024-01-25:
To have a bit of a baseline I've attached here the "tardline" track project so that people can try loading and playing it to see if it works. If it does, then that gives us a starting point for comparing samples that don't work to try to track down what could be causing a problem.

[lgptTardline__M-_-n.zip](https://github.com/democloid/picoTracker/files/14049276/lgptTardline__M-_-n.zip)

maks, 2024-12-15:
Going to close this one out as sample browser was completely redone for v2.0. Please re-open if this is still reproducable with latest v2.0 beta release.

Closed 2024-12-15.

Thread 96 (2024-01-27):

Add Proxy Instruments

maks, 2024-01-27:
So this started of as an idea on how to improve workflow with using midi instruments as I found my self trying to compose a track for midi but while out and about so didn't have the midi synth with me.

So initially what I thought of was to have an easier way to have a "stand in" sample instrument for a midi instrument that could the be easily switched to a midi instrument without having to manually edit all the uses of that instrument number across all phrases that used it.

But then I realised that this could be generalised to the concept of have a "proxy" or "alias" instrument that acts as a pointer to an actual instrument, so that would easily allow the actual instrument to be switched out. An example use case is the above use of sample instruments being used as placeholders for midi instruments. Another use case would be to allow naming these proxy instruments and then you could have say "bassline", "kick", etc and then easily swap which actual instrument was used for each to quickly experiment with what sounds best for each "part".  Hmm maybe calling these "part" instruments would be better than "proxy".

I think this could really be a nice improvement in the pT workflow and is I think a feature not even available in other hardware trackers.

lzulauf, 2025-02-19:
I wonder if perhaps instead of having midi be its own instrument type, every instrument could have a midi channel set without having to change instruments. If that were combined with some way to choose outputs for each instrument (midi on/off audio out on/off) it would make for a flexible solution

Thread 110 (2024-02-03):

Output level really low for line use

gandaja, 2024-02-03:
Since v1.2b2

maks, 2024-02-04:
Thanks for opening this issue. Yes this has been discussed on Discord as well. I'll start with posting a couple test builds with different settings for people to try out as the amount of reduction of output volume for different headphone/earbuds/IEMs really just needs to be a compromise setting determined experimentally.

maks, 2024-02-04:
@gandaja not sure if you are in the discord servers @beta-testers channel so here is a test build with 1bit extra (louder) output to please test and report back on:
[picoTracker-4bit-offset.zip](https://github.com/democloid/picoTracker/files/14154917/picoTracker-4bit-offset.zip)

Please UNZIP first to get the uf2 file to install to your picoTracker.

gandaja, 2024-02-05:
Thanks. Still haven't tried the firmware you provided, I wanted to work v1.2r2 for a few days with my headphones.
Levels are ok, but I notice a loud "pop" whenever a sample starts or finishes playing.

gandaja, 2024-02-05:
Sorry, I've seen that a similar problem has been described in issue #67.
Will upload a zip soon.

maks, 2024-02-06:
Fixed by #113

maks, 2024-02-15:
I'll close this now as the remaining followup work to allow for different levels is tracked in #116

maks, 2024-02-15:
I'll close this now as followup work for this is tracked in #117

Closed 2024-02-15.

Thread 114 (2024-02-05):

Update manual to remove LGPT specifics

maks, 2024-02-05:
Currently[ the manual states](https://github.com/democloid/picoTracker/blob/master/docs/MANUAL.md#importing-samples):
>It supports 8 or 16 Bit wav files, any sampling frequency, mono or stereo. 8bit samples are converted to 16bit at load time for compatibility with the engine (you can save space in storage but not in RAM, keep this in mind when choosing samples).

Which is actually not correct as freq above 44.1kHz are not supported. Its also likely that some schemes or big (little?) endian encodings are also not supported, so need to check the existing sample import handling code to see what exactly is supported and then update the manual accordingly.

Edit:
There are also likely other hold overs from it being the LGPT manual that dont apply to the picoTracker so I have renamed this issue to cover all that update work of going through the manual to remove LGPT specifics.

democloid, 2024-02-05:
the readme says: 8 or 16bit samples up to 44.1kHz, mono or stereo :)

But the manual comes from another source

maks, 2024-02-05:
@democloid good point! Really this should be a task to go through and scrub the manual for any LGPT docs that dont apply to the picotracker.

maks, 2024-10-24:
done as of #219

Closed 2024-10-24.

Thread 115 (2024-02-06):

Parent dir entry not shown in a subdir with no *.wav files

maks, 2024-02-06:
This means you are stuck in that dir unless you back out to the instrument dir using the nav+left key combo, which then stops access back to the sample dir from working with a error message of "Can't access the samplelib" 😢

maks, 2024-10-24:
done as of #219

Closed 2024-10-24.

Thread 117 (2024-02-07):

Add gain setting option to device settings

democloid, 2024-02-07:
@shockdesign @maks as I said in the PR, I think there is value to this and we can implement it, but in a different way. Right now it seems that it's not possible with one setting to cater to line out and headphone users, and I think there are different opinions among headphone users too. Want to make sure we don't rush changes that may be difficult to maintain in the future.

What I'm thinking is similar to some headphone amplifiers, provide a gain setting. This could be a dB setting that maps to a certain bit shift in the driver, or could be a potentially more user friendly option for "high/mid/low" where high is no bit shift and presumably used by line out users (I'd argue that even line out could be a bit attenuated). We'd have to see if 3 settings is enough, probably yes.

This brings to other issues that I wanted to tackle before tho:
1. Device options screen: Right now some device level options are set in the project screen for lack of a better place, but eventually I think it would be good to have a separate screen for this, and this could go there. For the moment I think this option could go there as well for the moment and not be a big issue. (working on the additional device config level screen has other issues like memory usage, which I'm working on)
2. Device level options saving: As I said in the PR, I want to discourage the config.xml file usage as it's not something I'm willing to support long term. I was thinking we could reserve some space in flash to save device level options. If we reserve some space at the end of the flash, it would survive reboots. This place, or adjacent to it could be used also to save the current project and make it survive reboots (but that's another discussion)

maks, 2024-02-07:
Mostly agreed @democloid .

I've made a [new issue for a separate project settings page to remove need for config.xml](https://github.com/democloid/picoTracker/issues/118). But I think that is a separate issue and shouldn't really block this one as all existing settings in config.xml would need to be migrated to a device settings screen anyway once its in place.

In the case of having configurable gain options though, I think there is a limitation in what can be done as I ran into not being able to use the ISR in the PIO asm to pass in a value for the offset and still get the timing right with sidesets for i2s framing hence my suggestion to @shockdesign to just use separate PIO asm files for the "headphone" vs "line level" settings. We could of course have a third file for a "medium" setting but I think more than that and using this method will get out of hand :-)

democloid, 2024-02-07:
If you support config.xml, then when you switch you have to support code to migrate those settings to device level settings, or not do it which will frustrate users. I don't see a problem with taking things slower in order to do it right. I'd even release, potentially a line level firmware and a headphone one in the mean time.

Same goes for not being able to dynamically change these levels with the current code. It means it needs more work to get to the right approach, rather than rushing something out.

If we think that the attenuation is not ready for prime time, that's why this isn't a release version, we can turn this back and wait for the right approach.

To add to the points I made earlier, I think a third requirement should be to support changing these settings without having to reboot. This would require having the audio off while we do it, but that's fine as there are other settings that require such an approach.

shockdesign, 2024-02-07:
@democloid As I mentioned in the PR, we can leave that one hanging for a moment while we work out a better approach..

I'm all for having a seperate settings page.. as for how we store that settings, I don't think we should store it in Flash, but rather write it out to the SDCard... like config.xml but maybe a better format (removing the xml parser would reduce some code indeed).. However lets discuss this in the correct issue.

I think it's okay to go through multiple revisions and various ideas as that follows the Agile approach which is handy with type of software.

I'm still looking at a better way to be able to have configurable output levels.. I was just hoping in the meantime this would be a good stop gap solution for those wanting a loud lineout for Studio equipment and those using headphones for day to day use.

I don't think having two versions of the software is a good idea. Especially if you are switching back and forth.. However happy to work with you and @maks to get a Settings page done, so we can toggle between the two for this PR before we think about releasing it.

Looking at other PIO code, it seems very good at doing one thing only. So in that sense, if we wanted to have multiple drivers for different levels, this would be the way to go (only with a better way of handling the differences).

maks, 2024-02-07:
In general I have to admit I'm also much more of the iterative development school too, my preference is to release things as early & quickly as possible to get user feedback as soon as possible vs taking longer to try to get something that is more polished but may not actually be a good fit once used widely.

Specifically with the audio output level here, for me the rush was concern with people not being able to use devices because the level was too high, so thats why I wanted to get the vol attentuation out asap. Now that is, I think its much less urgent to get a fix for too low level output as thats more an inconvenience vs something that stopped people even using it with some headphones/earbuds.

democloid, 2024-02-07:
I'm perfectly ok with multiple revisions and pretty much think the same, but think I need to be careful to support features that people might come to expect and then removing them. In that sense, I think it's fine to iterate in the repo or some branch with half baked features, but the moment you make a release it might create expectations.

maks, 2024-02-07:
@democloid agreed people (including me!) get very annoyed when features are removed or get radically changed, the feedback I've had on replacing the import sample onscreen buttons with keys is as good an example of that as any!

So yes I think experimenting in the betas is ok for me and I'll try to make it clear here and on discord that thats what they are, experimental versions and not releases with features that will stay going forward.

democloid, 2024-02-08:
OK here are my thoughts	 (and compromise):
* 3 gain settings, ok if we have 3 separate PIO files, but strive to unify later
* OK to use config.xml as backend for now, one more wont hurt
* settings should apply "on the fly", this is important IMO. it will necessarily require play/audition to be off
* OK to use project settings screen for it for the moment

need to define what bit shifting these gain settings correspond to

thoughts?

shockdesign, 2024-02-08:
I think this is definitely workable..

3 seperate PIO files is easy enough to sort out.

Applying the settings on the fly is easy.. but yes, have to just check that the device isn't currently playing, etc before allowing a change.

Can pop this on the project settings screen..

I'm guessing the loudest setting will use the original code, but yes, @maks it would be good to get impact of what a low and medium setting would be?

If all of this is good, I can look at mocking up how the project settings screen would look with the options before building?

maks, 2024-02-08:
Thanks both for the great discussion on this!

This is just my 2c: yes loudest setting is original i2s code. The quiet setting is current master branch build 4bit offset setting.
The medium is the hard one, I think would be good to do 2bit and ask cTrix and others to compare with prev testing of the 3bit setting and see which one they prefer, I think this would be mainly for use with high impedance headphones as all line level use would be with the "full" setting.

democloid, 2024-02-08:
Yeah, to me the obvious would be 0, 2 and 4. Potentially 1, 3 and 5 o 0, 2 or 3 and 5. A real low and a real high might be useful. The advantage of 0 is that it's true line level output that the amplifier outputs, so that's the only close to standard thing we have here.

shockdesign, 2024-02-09:
I'm going to stick with the obvious settings for the moment, 0, 2, 4 defaulting to 4 (quietest).

Working on the display portion of this in project settings but reading/writing value from the Config.

@democloid instead of telling the user that the setting cannot be changed while playing? Would it be a better experience to stop audio if it's in use. Then change the value. Or do we want the user to actively think about the change?

democloid, 2024-02-09:
I think it's important not to preempt playback. While this is not widely used now, say someone is playing this live or whatever, you don't want to perform an action that has unexpected consequences. Let's stick to displaying the same dialog that other project actions display.

shockdesign, 2024-02-09:
@democloid Could you also assign this issue to me 🙏

Closed 2024-10-24.

Thread 118 (2024-02-07):

Replace config.xml with a device settings screen

maks, 2024-02-07:
We want to move away from using config.xml to make all device settings configurable via UI on device.

To do this we would want to have a device settings screen.

Based on comments in discord, it would be good to also be accessible without needing to first open a project.

shockdesign, 2024-02-07:
💯 Agree with this, I keep wanting to have a general Settings page for those settings that reach over the app vs. project.

I don't think we need to get rid of config.xml however xml reading/writing is quite processor heavy and I think there are probably better formats.

I do prefer to keep the settings file on the SD Card, because that makes more sense, also allows users to back them up or share their settings instead of keeping them in flash.

Also would prefer to keep as much out of flash due to the limitations we currently have.

I might mock up some ideas for Settings here (including location, accessibility, etc)

maks, 2024-02-07:
@shockdesign Well for me the pro to having config.xml is its human readable/editable but otherwise theres lots of cons like the code it takes to support reading/writing xml and ram usage (even using SAX) and really once you have a UI and say store in a binary format you can still export to a simple binary format for backups/sharing without needing to keep a "heavy" format like xml.

The question of where to store flash vs sdcard is an interesting one! To me it makes sense to store on flash but I'm not strongly opposed to being on sdcard either as currently its not possible to use a device without a sdcard installed.

I think before mocking up a UI, the more important thing is to decide on a implementation for device settings, the question of where its stored, data format, etc. TBH for me the UI layout is the easiest & last piece to work on for this task.

shockdesign, 2024-02-08:
@maks I love the idea of a human readable/editable config... but I think there are better options for text parsers than XML.

A binary file could work, but yes, becomes very propriety and harder to decipher.

Just realised that the project save files are XML too, so if we want to go through to the process of implementing a lightweight parser, we might want to the change and convert the save files (whether thats another simple Python parser).

If we're going to have to support XML as a format going forward tho, then we might as well keep that.

@democloid Thoughts? Should we try and remove the XML parser and change the format of the save files to streamline things better for the Pico?

democloid, 2024-02-08:
I can't find a compeling reason to remove the parser or change the format. I'm no XML lover, but it works and it's open, which is important. The way it's implemented is also pretty nice in that each component saves it's own configuration and appends it to the final file, so it should be pretty easy to support saving and loading instrument settings for example. Memory wise I don't think that it's a bit offender, should be pretty efficient.

On the down side, a malformed file may crash the device, but that's a problem of the implementation, not the format.

In terms of config save I strongly believe it should go into the flash. But I could see a reason to want to at least export it if the config gets more complex.

To the mention that the device requires an SD card anyway, what if it didn't? not super high pri, but would be nice to me to be able to turn on a cardless device into a new project and be able to use factory samples and whatnot for an ephemeral experience 😀

maks, 2024-02-08:
Yes good points all round. I keep forgetting about project files being in xml, so yes, no sense to replace it and Ive got lots more interesting things I'd like to work on so no real motivation to replace the xml support with anything else, so I take back by suggestion for a alt binary format for storing config either.

That perhaps points to a first iteration of the device settings: as just exposing existing editing & saving config.xml settings.

Finally its a great suggestion to be able to run without the sdcard, it would be handy especially once there is synth support, but I dont think its essential to work on straight away so my suggestion is to initially keep config.xml on the sdcard with a new device settings screen to edit it and its then trivial to later move to saving it into flash instead.
Any thoughts on something I may have missed with this plan?

maks, 2024-10-24:
done as of #219

Closed 2024-10-24.

Thread 119 (2024-02-07):

Some samples fail to load

maks, 2024-02-07:
I've noticed recently some samples, even fairly small ones (600kb) will fail to import/load, but only sometimes.

I need to still come up with a way to consistently reproduce this and will then attach a minimal repro project file here.

shockdesign, 2024-02-09:
[resampled_and_trimmed.zip](https://github.com/democloid/picoTracker/files/14216653/resampled_and_trimmed.zip)

Attaching a bunch of samples here that were taken from a unsigned 8 bit .wav, using Audacity to trim and convert them them to signed 16 bit little endian .wav files.

I can load the first 7 files and then the 8th one crashes (CymA808DecayC01.wav).. kill device, it saved the project and when loading freezes at the same place.

Note, can load this sample first...

maks, 2024-02-17:
I started debugging this a little bit as part of working on another issue and noticed it doesn't seem to be related to file sizes but rather the number of samples being imported one after another. Will need to do some more debugging on this to find out whats happening here.

maks, 2024-03-07:
Fixed by @democloid in #141.

Closed 2024-03-07.

Thread 120 (2024-02-08):

Boot directly into last opened project or into a new project

maks, 2024-02-08:
Would need to have a persistent setting that stores the currently open project.

Also because of potentially long time it takes to load larger samples from sdcard into ram and the fact that the sdcard may even have been removed or swapped out the project needs to be saved into flash and the previously loaded samples can then just be kept in flash and used on boot (great idea for this from @democloid ).

maks, 2024-10-24:
done as of #219

Closed 2024-10-24.

Thread 122 (2024-02-09):

Optimising code base

shockdesign, 2024-02-09:
This is a bit of a big discussion here but I think relevant given our hardware.

The entire codebase is written to be flexible and portable given its adaptability to many other devices which to a point we can still build picoTracker to other hardware.

1. Do we still want to contribute our enhancements/changes back into LGPT?
2. If not, is it worth looking at scaling back most of the object-oriented spaghetti to reduce complexity and streamline development purely for the picoTracker (i.e. removing support for everything else)

@democloid Let's discuss. This really is a future direction discussion but I think worthy as code path complexity and the oop nature of the code is definitely having a performance impact.

I don't want to discuss how this would be implemented in this thread, just whether it's something we need to consider and it's something we can work towards going forward, not having to do it all in one big chunk.

democloid, 2024-02-09:
1. No, not the focus right now and will not optimize for it. If someone wants to do it they can of course.
2. Yes, to a certain degree, but I want to be cautious not back ourselves into a corner by doing so. So my preference is to only do it if it serves another purpose.

Right now, this is where I'm focusing most of my attention and I'm doing some heavy refactoring in order to have much better memory guarantees and be able to develop with less probability of breaking something random due to memory issues. I'm also simplifying the code and removing #ifdefs where it makes sense.

maks, 2024-02-10:
@shockdesign while it's possible to over do things with OO, alot of C++'s OO abstractions are not expensive performance wise while the benefit is you can see how easy and clear it was to add the pico specific code to lgpt with not very many #if def's required. This structure would be of benefit in future for instance adding support for different audio hardware or even a different microcontroller.
But I agree on not worrying about maintaining lgpt compatibility and really there is no upstream LGPT to contribute to as the original repo is basically abandoned and the only active form that I know of is @djdiskmachine one.

djdiskmachine, 2024-02-10:
I agree for the most part, although most of the features I've contributed with are features that I made first for my fork. Some needed some rework, others needed more, but I don't see much need to maintain compatibility. 🙂

maks, 2024-10-24:
obsolete as of #219

Closed 2024-10-24.

Thread 124 (2024-02-11):

Add warning if no SD card detected or faulty

h3o, 2024-02-11:
On the initial screen (New/Load song) it would be useful to have a warning like "SD card missing or faulty" in case that the SD card cannot be accessed.

Subsequently, a warning should be displayed if creating a new song fails for some reason (for example because card is full, malfunctions or locks itself into write-protected mode).

Otherwise it may be confusing as New or Load commands cannot do anything without it (a newbie might forget inserting the SD card (as it happened to me :)

Current behaviour: Without a SD card, pressing "Load" does not do anything, while "New" acts like it is allowing you to create a new song.

Speccery, 2024-03-10:
I have started to work on this. As a first cut the no SD card status is detected by a new method in FileSystem object (method only implemented if PICOBUILD is defined).

Modified behaviour: message "**SD not present" shown as a path.

maks, 2024-03-10:
@Speccery thats great! 🎉  Feel free to tag me as a reviewer once you have a PR ready or even if you want to get early feedback on a draft PR.

Closed 2024-12-05.

Thread 125 (2024-02-11):

Master volume as persistent setting

h3o, 2024-02-11:
It would be nice if the master volume persisted during power off cycle.

Once such mechanism is in place it will allow to preserve various other user settings too.

If a configuration switch is added to select between Line-out and HP levels, it would be nice to preserve both volume levels separately, and also the switch setting.

Later, if there are many settings, a "factory reset" command will be useful to reset them all into defaults, in case user messed things up and is not sure what is going on.

shockdesign, 2024-02-14:
This looks like a good candidate to be included into this issue as a setting to keep - https://github.com/democloid/picoTracker/issues/118

However keeping it seperate for the moment

Closed 2025-01-10.

Thread 126 (2024-02-14):

Making it easier to add new Instrument types

shockdesign, 2024-02-14:
There are a few issues about adding new synths to picoTracker

- Amy https://github.com/democloid/picoTracker/issues/123
- Opal https://github.com/democloid/picoTracker/issues/102

Potentially a SID synth, etc and this issue - https://github.com/democloid/picoTracker/issues/36

I think we need a way to make Instruments easier to manage this.

Including on the Instrument screen a better way to switch what type of Instrument something is, etc... and how we define what options are available per Instrument.

i.e. Sample instruments have the sample name/file, volume, effect, etc?

Synth instruments would have specific variables as well..

Anyone with thoughts on this?

maks, 2024-02-14:
I've been meaning to get back to working on instrument memory usage as I think its **very** bloated at the moment and can get significant savings in this area.
My back of envelope calcs say that ram usage per instrument excluding name & linked table should be less than 64 **bytes**! The current 8.5kB is just completely out there. Midi should be less than 16 bytes.

Given the above gutting the current implementation and fixing the instrument data structures should allow for large numbers of instruments, future synth instruments and still use less ram than the do currently.

To give some more context, I got this reply from one of the developers of Amy:

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

So having *full* DX7 compatible FM instruments will only cost us 4.5KB per instrument, but just more basic 4-OP (like eg. Digitone) would only be around 2.5kB.

Note also that they are able to fit their whole engine **including** chorus & *reverb* fx into only 117kB!

maks, 2024-10-24:
done as of  #219

Closed 2024-10-24.

Thread 128 (2024-02-14):

Introduce more colour definitions

maks, 2024-02-14:
I'd like to propose introducing more colour definitions. ie entries in the `ColorDefinition` enum in `View.h`.

Initially I would like to add the following:
* `CD_ERROR` for showing error messages or conditions, eg. the colour for the batt gauge when critically low level.
* `CD_WARN` for showing warning messages or conditions
* `CD_INFO` for show informational messages or conditions

My plan for warn and info is to initially use them as the colours for the base and middle parts of the "VU led bar" meters and error for the clipping range once I start working on the mixer screen PR again, so initial defaults of green, yellow and red for these three new colours respectively.

democloid, 2024-02-14:
Totally fine. Main thing to keep in mind is that there are a total of 16 colors available per the driver, so need to use wisely and think a bit ahead. That can be expanded of course, at the cost of memory.

maks, 2024-02-14:
Thanks for that @democloid ! And thanks for the pointer to the limitation on 16 colours, I didnt realise that 👍🏻
I can't think of any more colours I would want to add for now, but for sure need to add these strategically.

I'll start on a PR for this shortly.

Closed 2024-02-29.

Thread 129 (2024-02-15):

Add new clock signal for use outside of project playback

maks, 2024-02-15:
Currently there is only the `OnPlayerUpdate()` callback for use for any code in the app that needs a clock signal but this is only available during project playback, which limits its usefulness and doesn't cater for things that need to be regularly run/updated even when playback is not happening (eg. the battery gauge UI).

So I'd like to propose a new callback along similar lines to `OnPlayUpdate()`, maybe `OnClockUpdate()` but that is always running, called at a set rate (1Hz?) to allow for any code to hook into that needs to update regularly. I think 1Hz is pretty undemanding CPU wise but of course would not be sufficient if we wanted to use it to drive UI animations, so perhaps something higher rate like 30Hz is required?

democloid, 2024-02-15:
How would this be driven? interrupt or just as part of the main loop with a timer? If it's not interrupt driven and we decide to do some heavy lifting in the future with processor 0, then the timing may not be very precise, which may or may not be a problem.

maks, 2024-02-15:
Yes I was just thinking main loop driven as the intention is for it to be only for UI so doesn't need to be precise while anything audio related already has `OnPlayUpdate()`. I think its standard to except dropped UI frames when the main loop is doing too much work, at least it is for people who do mobile apps or web dev so that should be fine.

@democloid would you know of a good place this could go in the main loop? Before or after the ` if (event) {}` in `picoTrackerEventManager::MainLoop()` ?

Closed 2024-02-29.

Thread 131 (2024-02-16):

Reinstate UI gauge to show CPU usage

maks, 2024-02-16:
While working in battery gauge I found there was already UI code from lgpt to show CPU usage on song screen during project playback but this was not functional for picotracker.

I also found that in the main loop there is pico specific code to measure CPU usage but only for debug printing to console.

So implementing this should just be a matter of wiring up reading the CPU usage out of a variable that the main loop code updates while playback is happening by reinstating the previous UI code in the song screen.

democloid, 2024-02-17:
That CPU gauge is fundamentally broken, doesn't really work. In any case, it should only be used for development and/or debugging purposes. See comments in #8

maks, 2024-02-18:
Yes the existing CPU gauge I removed because I noticed it wasnt working too.
But I was thinking it could come back using the data thats in the `PICOSTATS` define within `picoTrackerEventManager::MainLoop()` , I think that would work?

maks, 2024-10-24:
obsolete as of #219

Thread 139 (2024-03-03):

Reduce ram usage of Variable objects

maks, 2024-03-03:
Coming out of research done in https://github.com/democloid/picoTracker/issues/17#issuecomment-1837045290  the ram usage of `Variable` objects can be significantly reduced.

The first identified issue per above:
>SampleInstrument constructor new's 18 Variable or WatchedVariable member objects each of which has a char string_[40], but as far as I can see that's only used when the Variable is of type STRING which none of those are.

Given 18 variables per sample instrument thats: 16 * 18 * 40 = 11520 bytes potential saving.
Given 5 variable per midi instrument thats: 16 * 5 * 40 = 3200 bytes potential saving.

Next, every `Variable` object has a `name_` member which is a `std::string` which is assigned in the contructor:
```cpp
Variable::Variable(const char *name, FourCC id, const char *value) {
  name_ = name;
```

but the above means the `std::string` does a copy of the `const char` into its internal buffer! This means that **every** `Variable` object gets a *copy* of  the name string instead of all just pointing to string literal in flash, because `Variable` object are created all through the codebase like so:
```cpp
filterMode_ = new Variable("filter mode", SIP_FILTMODE, filterMode, 3, 0);
```

If we say that the average name string is 8 chars:
Sample instruments: 16 * 18 * 8 = 2304 bytes
Midi instruments: 16 * 5 * 8 = 640 bytes

So if the above if correct, approx 17kB of ram savings to be had with just the above.

The above next need to be validated with actual code changes and measuring change in ram usage.

democloid, 2024-03-04:
This all makes sense and I agree. We could implement it as an intermediate step, but I'd take it a step further. Each of those variables use ~150b each IIRC (so about 55k just in variables), and effectively hold a 4byte value. While it does have other functions, I'd say that re-engineering this whole thing would be a very high impact item, specially to be able to add more instruments.

democloid, 2024-03-04:
@maks keep in mind tho that those registered variables are used in the UI code to be able to change their values. So it may not be as easy as it seems. Haven't looked at it in detail tho. Do you have a plan on how to hook those up already?

maks, 2024-03-04:
Most of the variables in sample instrument and all in midi aren't watchedvariables, just plain variables, so the pattern in the UI is just eg. `v = instrument->FindVariable(SIP_CRUSHVOL);` and then the pass it into a `intVarField_` and then the `intVarField_` just uses the variable ref to draw UI and update it on user input.

But it is a good point that its going to be a very big code diff to change all of this as then the UI will need so now I think about it some more, its probably better to stick to my original plan and reduce size of Variables first and then later move on to removing their use altogether. Looking at `Variable.h` I think it should be possible to get them down to about 20bytes each just by doing what I said above and also creating a new specific StringVariable subclass.

maks, 2024-04-24:
I think this was basically done in #155

Closed 2024-04-24.

Thread 144 (2024-03-07):

"Loading filename..." dialog does not get removed once the sample has been loaded

maks, 2024-03-07:
Now that #119 is fixed, there is still an issue where larger sample files load but the "Loading filename..." dialog does not get removed once the sample has been loaded into flash, though it is still possibl to return to the instrument screen with left+nav key combo.

maks, 2024-10-24:
done as of #219

Closed 2024-10-24.

Thread 147 (2024-03-09):

"Loading <sample name>" message should show progress

maks, 2024-03-09:
Leading on from #144  especially for large samples, not showing any kind of progress indicator is frustrating as you have no idea how long the sample import/load will take. Even a basic count of bytes read/bytes total or even better some sort of animated ascii widget would be great here.

democloid, 2024-03-09:
this is going to be very hard really. That routine is single threaded and with interrupts disabled, so not much that could be done, unless we updated the UI directly from the routine, but that would mean having a lot of code that needs to be loaded in RAM.

maks, 2024-03-09:
Actually, maybe by fluke, but it actually works!
I'll put up a PR shortly to get your feedback on if the code is ok or not 🙂

Closed 2025-05-07.

Thread 149 (2024-03-09):

set a hard limit on number of files per directory that is supported

maks, 2024-03-09:
Because of previous memory saving in the file sample browser, we currently have a "soft limit" of `320` entries per directory.
This soft limit is not really much use, as larger numbers will cause it to be exceeded and the device likely then crash due to memory exhaustion.

Instead we need to change https://github.com/democloid/picoTracker/blob/20c33c7a4ce96f5284b345e20987221f62e49aba/sources/Adapters/picoTracker/filesystem/picoTrackerFileSystem.cpp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 to be a ETL *fixed* size list and enforce the limit by counting number of entries in a dir when the user first enters it and showing an error message if the number of file/subdir entries exceeds the limit.

maks, 2024-10-24:
obsolete as of #219

Closed 2024-10-24.

Thread 152 (2024-03-09):

can't access sample browser when preview is used quickly

paasukusai, 2024-03-09:
Report
1. go to sample browser
2. double click to open sample browser
3. Repeat previewing various samples.
4. The preview will no longer play.(NG)
5. When I try to EXIT and reenter, the browser does not open.(NG)

https://youtu.be/4s93i91cqeY

It looks from 3/1
SHA-1: 58f6ab9785f84d38959f86c2c6192cd244ba34d9

samples
[drums.zip](https://github.com/democloid/picoTracker/files/14545493/drums.zip)
[Builds.zip](https://github.com/democloid/picoTracker/files/14545497/Builds.zip)

maks, 2024-03-10:
Thanks for reporting this.
I have been able to reproduce it by downloading your drum samples and then trying to preview samples as rapidly as possible. Will need to investigate further to try to find whats causing it, likely some sort of race condition as the streaming code used for preview isn't used in any other part of the audio playback in picotracker.

RAWJUNGLE, 2024-03-10:
+ freeze device, I've talked about this before. It's a critical error. It's impossible to work with.

maks, 2024-03-10:
> + freeze device, I've talked about this before #66. It's a critical error. It's impossible to work with.

In my testing this issue does *not* cause a freeze of the device and matches the symptoms of the original report here.

RAWJUNGLE, 2024-03-10:
> > + freeze device, I've talked about this before #66. It's a critical error. It's impossible to work with.
>
> In my testing this issue does *not* cause a freeze of the device and matches the symptoms of the original report here.

If you have pre-loaded already samples and arranged them, then you run this problem, then you get a message about browser not being able to load, and if you try to save the project, you get a device freeze.

maks, 2024-03-10:
> If you have pre-loaded already samples and arranged them, then you run this problem, then you get a message about browser not being able to load, and if you try to save the project, you get a device freeze.

Sure, but that is **not** what *this* issue is tracking.

RAWJUNGLE, 2024-03-10:
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

I mean, this bug will live on indefinitely.

If you run this issue from an issue and then try to save the project, you will get a freeze, I realize that these are two different issues, but can you check this in yourself and confirm the issue ?

paasukusai, 2024-03-11:
I'm sorry for confuse you.
This issue is not about release version (only repository master).
I checked the source code and found where it happen, so this issue is from this month.

I think the sample browser is very difficult part to make, and  there are some problems.
Let's isolate the problems one by one and check them out.

maks, 2024-03-11:
@paasukusai no all good, your report is very well done and it was easy to reproduce the issue. But I don't think the cause was the change to show file sizes unless you have tried a build before that commit and the issue does not occur there?

RAWJUNGLE, 2024-03-11:
> @paasukusai no all good, your report is very well done and it was easy to reproduce the issue. But I don't think the cause was the change to show file sizes unless you have tried a build before that commit and the issue does not occur there?

Both problems exist in all versions, but it appears slightly less frequently than in this version.

paasukusai, 2024-03-11:
Let me share the build removed the point.
This build seems ok.
(but sorry, I don't understand the source code yet..
If I find out anything more, I will share it.

[0309_mod.zip](https://github.com/democloid/picoTracker/files/14552528/0309_mod.zip)

RAWJUNGLE, 2024-03-11:
https://youtu.be/bC5puw-J5Ek

RAWJUNGLE, 2024-03-13:
@democloid

democloid, 2024-05-01:
@maks I have reverted the show flash usage feature as it was clearly related to this. I've created #185 to track this

maks, 2024-05-01:
@democloid yes all good. I'm not sure how its linked to the changes, I suspect maybe something to do with reading the filesizes from the sdcard, but I'll need to debug it properly. I'll try to get to it soon, as I find especially the filesize display if not the flash remaining an **invaluable** feature. I might try to tackle this as part of adding the FS in #171

Closed 2024-05-01.

Thread 156 (2024-03-11):

Add key test mode when no SD card present

Speccery, 2024-03-11:
When bringing up hardware, it would be advantageous to be able to test hardware functionality piece by piece rather than requiring many things to work (SD, keys, display) at once. One simple way for this would be to detect SD card, and if not present, enter a key test mode which would enable testing all keys. This way only display and keys would need to work to test keys.

Current behaviour: if no SD card, no message is shown. It is possible to press left and right to switch between Load and New, but impossible to know if other keys work (I'm thinking of you "A" key).

maks, 2024-03-11:
This is a great idea and I for one would find this useful when building devices.

Thread 166 (2024-03-27):

Using SD card reader from tft display

ronaldsdc, 2024-03-27:
Hello friends! Ronald here. Is there any chance or specific config to make the original prototype to detect sd card from the tft sd card reader?  Mine has spi connectors and i'm connecting them as gpio.h indicates but have no luck and have no separate sd card reader.  I also tried Speccery's version and it says no sd card detected.
Thanks for any help!!

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

democloid, 2024-03-27:
Should work, I may have tried it at some point but don't remember. One thing that might be happening is that those resistors may be limiting the bandwidth, so could work at lower frequency. Can you check what those resistors are?

Word of caution, this config, even if you make it work, may not be supported in the future. (We may switch to SDIO in the future)

ronaldsdc, 2024-03-28:
Many thanks! that was the issue, they're 1k resistors, I tried bypassing them and it works now. Definitely gonna change to SDIO module in the future, but for now it worked superb, thank You!

Closed 2024-03-28.

Thread 168 (2024-03-31):

auditioning a midi note on phrase screen resets the midi instrument number on next button press

maks, 2024-03-31:
If you set a midi instrumen, eg. I13 and then press `A` to audition its sound, pressing `A` immediately after that (eg to re-audition it or to switch to another instrument number) immediately resets the instrument number back to `01`.

maks, 2025-01-10:
Actually this is the case for any instrument, not just MIDI.
However its not a high priority issue as its much more common to audition while on the note column than on the instrument column.

Thread 169 (2024-03-31):

midi velocity (VEL) command doesn't limit max value to 127

maks, 2024-03-31:
Its possible to go above value of `127` when setting the `bb` value of the new VEL midi velocity command.

Closed 2025-05-13.

Thread 171 (2024-04-03):

use a filessystem for onboard flash

maks, 2024-04-03:
While its convenient to use the onboard flash via its memory mapping as he code currently does, if instead we used a filesystem, this would make it more convenient to add features such as storing project data there as well as samples, allowing for instant loading of last project state and I think allow for writing to flash even during playback.

But **most importantly** it will help with preserving the health of the flash by doing wear leveling.

This is what the [LittleFS docs have to say on the subject](https://github.com/littlefs-project/littlefs/blob/master/DESIGN.md):

>Wear leveling - Writing to flash is destructive. If a filesystem repeatedly writes to the same block, eventually that block will wear out. Filesystems that don't take wear into account can easily burn through blocks used to store frequently updated metadata and cause a device's early death.

So I would suggest looking to use LittleFS for this, though there are several other small filesystem implementations that are intended for this kind of use as well.

Using a FS will introduce some overhead, but it should still be fast enough for sample playback, though this will require moving to using streaming playback for all sample playback instead of current in-memory playback. On the flipside, this would be the preliminary work required to eventually implement (if possible) SDcard audio sample streaming.

maks, 2025-01-10:
No longer needed.

Closed 2025-01-10.

Thread 181 (2024-04-22):

Use a different colour for 00, FF chains

maks, 2024-04-22:
Some users of picoTracker as well as LGPT (and M8) use the convention of having empty chains as `00` or `FF` so its helpful if these can be displayed in a different colour.

This colour should also be user configurable, for now via `config.xml`.

democloid, 2024-04-23:
Wonder if it would be quick enough to calculate this on the fly and mark on a certain color any empty chains.

maks, 2024-04-23:
@democloid yes I think we could do that, but if prefer to save cpu cycles on this for other things as it's just a cosmetic and would a small, light touch change just to do it for a few specific chain numbers.

RAWJUNGLE, 2024-04-28:
> This could also include a separate colour for FE which I think is also commonly used as a kill all chain.

FE is not used as Kill All chain and etc.

It would be better not to highlight empty chains.

In those chains where there are no notes in the phrase (but there are commands like kil) do not make white, but highlight gray (for example) as inactive.

maks, 2024-04-28:
@RAWJUNGLE Thanks for the feedback but would you like to provide more details on your statement of:
>FE is not used as Kill All chain and etc.

as I my understanding is that someone people do use that as the convention.

And I'll just take:
>It would be better not to highlight empty chains.

as your personal preference. Given that the colours for this functionality like all the other colours would be user configurable anyone who didn't want to have these specific chains highlighted could simply choose to use the same colour as used for all other chains.

maks, 2024-07-17:
At a minimum will support the set of colours [already added](https://github.com/djdiskmachine/LittleGPTracker/blob/02df48e384915c4e735a927fd05e5cd7e639ea46/docs/wiki/config_xml.md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) to @djdiskmachine  LGPT fork

djdiskmachine, 2024-07-23:
FE vs 00 is like discussing tab vs double space in programming. Don't go there ;)

talktopag, 2025-02-07:
I'm a big fan of this idea. Either 00 or FE. A "padding"  pattern is really useful!

Closed 2025-04-28.

Thread 188 (2024-05-01):

Enhance font with characters for basic graphic elements

maks, 2024-05-01:
The font currently doesn't use any extended characters (ascii 128-255) so could be enhanced by adding support for some graphical elements (blocks, partial blocks, lines, etc) in that range to allow for better on screen drawing of things like waveforms, meters, etc.

Thread 189 (2024-05-01):

Different font design and better readability

maks, 2024-05-01:
The current font is very good, but possibly could be improved upon in terms of design aesthetic and readability.

I am working on some experiments in this area so this issue is to track and add visibility to that work. I'll post some potential designs as work progresses.

RAWJUNGLE, 2024-05-04:
I think what's required here is line spacing.

https://github.com/democloid/picoTracker/pull/190

maks, 2024-10-24:
done as of #219

Closed 2024-10-24.

Thread 192 (2024-05-04):

Browser pre-listen Bug

RAWJUNGLE, 2024-05-04:
I also found the most likely problem.
If the sd card is powered by spi, this is most likely the problem, the buffer is not keeping up with the active pre-listening.
Maybe you need to invent something to make the buffer have time to clear the data during pre-listening.
Maybe I am wrong in my conclusions, but the problem is somewhere here.

https://github.com/democloid/picoTracker/issues/152
https://github.com/democloid/picoTracker/issues/66

maks, 2024-05-05:
Can you please be specific about what exactly is the issue you are reporting?
What version of the firmware are you seeing this on?
What device hardware you are using? (standard picoTracker PCB or custom hardware?)

RAWJUNGLE, 2024-05-16:
@maks You constantly ask me the same thing, but the problem exists in any case, no matter whether custom firmware or hardware or not, the problem exists, and it is wildly annoying, I think most users will support me in this. I understand perfectly well that you want to make new products, and on the global old problems do not have time, but can you at least fix this problem, because technically you can not do music in the tracker.

democloid, 2024-05-17:
There's not enough information here to be able to debug anything and no willingness to provide such info. Please only open bug reports if you're willing to work with developers to solve the problem.

Plus it seems you reference already opened issues, so no need for an additional report on the same issue

Closed 2024-05-17.

Thread 193 (2024-05-05):

Song screen timer sometime only partially repaints

maks, 2024-05-05:
I don't have a 💯 reproducible case but I have seen quite a few time that something causes the timer widget on the Song screen to only partially repaint (eg. only show seconds).

Switching to and back from another screen while playing fixes the repaints to start working correctly again.

Observed on `master` and `v1.1r2` release.

maks, 2025-05-15:
this should be fixed in #542

Closed 2025-05-15.

Thread 196 (2024-06-01):

SD card stop working , when load next file-list ,during previewing sample.

paasukusai, 2024-06-01:
SD card stop working when load next file-list during previewing sample.
1.Open sample browser
2.Select 17th samples
3.Push Play button to do preview
4.Push Down button immediately
5.Preview glitches, next file list does not load (NG), SD card stop working.
  (sometimes preview goes well, but next file list dose not load, SD card not stop work.)

https://youtu.be/Bt3r6oqUYfA

samples in video
[sample_example.zip](https://github.com/user-attachments/files/15520767/sample_example.zip)

at build of 5/02 master
[Uploading 0502.zip…]()

paasukusai, 2024-06-01:
For short samples, this does not occur very often, so access to the SD card may be conflicting.
If I don't scroll, the problem doesn't seem to occur.
It might be nice if scrolling could be disabled while previewing.

maks, 2024-06-01:
Thanks for reporting this issue. I'm working on some changes to the sample file browser that should fix this.

paasukusai, 2024-08-03:
[PagedImportSampleDialog.zip](https://github.com/user-attachments/files/16478342/PagedImportSampleDialog.zip)

I added countermeasure code.
Let me share it.

maks, 2024-08-03:
Thank you for the contribution.
I have actually refactored the file system and file browser code significantly to no longer require any dynamic memory allocations and have fixed this and many other issues with the filesystem code. I will push up my changes once I have finished testing them.

maks, 2024-10-24:
done as of #219

Closed 2024-10-24.

Thread 208 (2024-06-20):

Add Script / Documentation on converting samples to a supported format.

simotek, 2024-06-20:
I have tried a number of methods to convert samples into a format that will work on the picotracker. The most conservative was `sox -S "$SAMPLE_DIR/$SAMPLE_PATH" -r 22050 -b 16 -c 1 -e unsigned-integer "samplelib/$SAMPLE_FOLDER/$SAMPLE_OUT.wav"` with both the unsigned and signed 16 bit integer versions not working there are some samples at http://simotek.net/downloads/BassU22/

I have also tried using ffmpeg with no luck. So far i've found very few samples that will work out of the box.

maks, 2024-06-20:
Thanks for reporting this @simotek 👍🏻
Definitely do need to document specifically what sample file formats are supported.
I think @democloid is planning to work on this soon.

simotek, 2024-06-21:
I also tried signed versions with

-  `sox -S "$SAMPLE_DIR/$SAMPLE_PATH" -r 22050 -b 16 -c 1 "samplelib/$SAMPLE_FOLDER/$SAMPLE_OUT.wav` in http://simotek.net/downloads/BassSoxS22/
- `ffmpeg -i "$SAMPLE_DIR/$SAMPLE_PATH" -sample_fmt s16 -ac 1 -ar 22050 "samplelib/$SAMPLE_FOLDER/$SAMPLE_OUT.wav"`  in http://simotek.net/downloads/BassFFMPEG22A/
- `ffmpeg -i "$SAMPLE_DIR/$SAMPLE_PATH" -acodec pcm_s16le -ac 1 -ar 22050 "samplelib/$SAMPLE_FOLDER/$SAMPLE_OUT.wav"` in http://simotek.net/downloads/BassFFMPEG22B/

maks, 2024-06-22:
so starting [from this line](https://github.com/democloid/picoTracker/blob/9e03f430313df100d4e692c0483a21200ba915eb/sources/Application/Instruments/WavFile.cpp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), the code here is the source of truth on what wav file formats are supported.

Having a look at the code, it supports:
* 8 or 16bit
* stereo or mono
* theoretically any sample rate

But interesting things to note:
1. number of channels is used but never actually validated to be 1 or 2
2. sample rate is stored and then used to adjust playback rate (see SampleInstrument 187)
3. theres 3 magic number checks of various parts of the file metadata header, I'll need to look up what each of those parts of the header contain that they are checking

I'll try to break this code out into a little harness and then run tests on arm emu against various sample files to see if theres also possibly any bugs in that code, possibly due to endianess differences.

simotek, 2024-07-10:
Interestingly the samples work fine with LGPT

maks, 2024-07-10:
> Interestingly the samples work fine with LGPT

Would you know which version of LGPT you were using that worked? That would help with cross checking it's source with pT's to see what the difference is.

peterswimm, 2024-07-11:
the things that would make legacy piggy barf the most is metadata in the wav header

democloid, 2024-08-06:
@simotek As frustrating as this may sound, the problem you're having is not related to format, but with spaces on the filenames. I'm annoyed at not having looked at this earlier to identify the issue.

That said, wav files don't seem to support any arbitrary combination of int format and endianness.
What's supported in wav, and picoTracker as well is:
unsigned 8 bit
signed 16 bit little endian
1 or 2 channels
Any sample rate up to 44100Hz

I have tested all these combinations and there seems to be no problems importing any file like this.

That said, I have identified some other issues:
Playback:
* no sample rate adjustment (known issue)
*  2 chan 8 bit plays with artifacts on preview

File system:
* Issue when loading new screen while playing, as the reference to the playing file is destroyed
* Spaces in files
* Some folders fail to load files sometimes

Most of the file system issues should be addressed by a new implementation we've been working on. The playback issues I have to work on. We also need better feedback to the user when encountering an invalid file.

maks, 2025-04-16:
Once we have #476 done we will have a UI pattern to display to the user samples that have bitrates that are not supported during auditioning or importing.

Thread 209 (2024-06-20):

Support case insensitive .wav extension.

simotek, 2024-06-20:
I came across some files using `.WAV` as an extension. on Linux this is reasonably straight forward to fix but on other OS's it might be much harder, it wouldn't supprise me if `.Wav` also exists so it would be good to support all these.

maks, 2024-06-20:
great point @simotek 👍🏻
I'm actually doing some work in this part of the codebase so I'll change it to make the extension check be case insensitive.

Thread 212 (2024-06-28):

add support for wavetable wav files

maks, 2024-06-28:
Wav files can be made up of stacks of essentially single cycle waveforms, but joined in a "smooth" way vs stepped transitions called "wavetables". picoTracker could support these more nicely if it had a new loop mode, say "wavetable" that allowed setting the size in samples of each frame in the wav file as a field instead of loop start/end fields in the sample instument UI.

According to the PE Tracker manual:
>The most common standard is 2048 Samples /Frame (256 Frames).

Combined with appropriate new FX cmds, this could also lead to basic granular support.

By allowing for much larger frame sizes as well, this could also be used for "drumkit" support, ie for wav files with X number of evenly sized sound percussion samples within a single wav file or even "multisample" instruments within a single wav file.

## refs

[online wavetable editor](http://scw.sheetsofsound.com/editor.html)

peterswimm, 2024-06-29:
Note this is possible today with https://github.com/democloid/picoTracker/blob/master/docs/MANUAL.md#lof-aaaa-lpof-in-lgpt

What I'm looking for is an easier way to setup nonmonowave type wavetables, or use wav markers or something to define waveform length in samples - ie like emu transwaves are full of content that is all over the place:  https://hexawe.net/mess/profdump/ensoniq_waveforms.zip

maks, 2024-06-30:
awesome, thanks for the extra info @peterswimm 👍🏻
can I check, do you have in mind also some sort of new FX cmd that would then let you jump between each non uniform length "slice" inside a sample?
So say you have a sample with these set of slices in it (say defined via wav metadata markers):
```
|----|--|--------|---|-----|
0     1   2          3   4
```
you'd have a cmd like that would let you say play diff slices like, say you wanted to play 3,1,1,0

SLC 03
SLC 01
SLC 01
SLC 00

that sort of thing?

peterswimm, 2024-06-30:
Well that is kind [of what plof is for](https://github.com/democloid/picoTracker/blob/master/docs/MANUAL.md#pof-aabb-plof-in-lgpt), I think "wavetable mode" will be able to say that saying if I wanted to jump to "section" plof0003, would be waveform 3

peterswimm, 2024-06-30:
and if its only 3 waveforms, plof004+ doesn't do anything

maks, 2024-06-30:
Ah thanks! I had forgotten that there was already POF (I'll stick to picoTracker namings to not confuse myself).

Cool, I think this is then just a matter of implementing a nice way of handling unevenly divided wavetables, likely with markers, I'll change the name of this issue to reflect that.

Thread 213 (2024-08-09):

There is no way to back to root folder in project browser

paasukusai, 2024-08-09:
1. turn on power
2. select [samplelib] floder
3. there is no way to back to root folder (NG)

paasukusai, 2024-08-09:
It might be ok if add command like this

  if (mask & EPBM_L) {
      Path root=std::string("/");
      setCurrentFolder(root);
  }

maks, 2024-10-24:
done as of #219

Closed 2024-10-24.

Thread 214 (2024-08-10):

Not supporting preview of long name samples. (Not intended?)

paasukusai, 2024-08-10:
It seemed unintentional, so let me share this.

1.try to preview long name sample like this
  "VEC2 Cymbals HH Closed 01.wav"
2.can't preview

This code looks making issue.
*******************************************************************************
void picoTrackerPagedDir::getFileList(int startOffset,
                                      std::vector<FileListItem> *fileList) {

      // dirs get max len of 2 less than files becase they are shown surrounded
      // with "[]"
      current[indexEntry.type == DirIndex ? 23 : 25] =
          0; // truncate at 22 char length string

maks, 2024-08-10:
Hi, thanks for filing this and other issues, but as I mentioned previously, the entire filesystem handling codebase has now been rewritten to not require any dynamic memory allocation, so it would be best to hold off on filing any issues for the file browser and file system parts of picoTracker until I get a chance to fully debug and test the new code and push it to this repo.

maks, 2024-10-24:
done as of #219

Closed 2024-10-24.

Thread 215 (2024-09-08):

Clicking Sounds When Abruptly Changing Sample Position (PLOF, Slice, RTRG) in the Sample Player

fpiesik, 2024-09-08:
Whenever the sample player makes abrupt changes to the sample position (e.g., using PLOF, slice, or RTRG commands), an audible click sound can occur due to the instant change in amplitude.

### Steps to Reproduce:
1. Load a loop into the Sample Player.
2. Use the PLOF command to jump to different positions within the loop.

### Expected Behavior:
Position hopping should work without any audible clicking sounds, by implementing smoother transitions or a mechanism to avoid abrupt waveform changes.

### Possible Solutions:
- **Zero-Crossing Detection**: Ensure that samples are triggered at points where the waveform crosses zero to avoid discontinuities.
- **Fade-In/Fade-Out**: Apply very short fades (at the start or end of the sample) to eliminate abrupt amplitude changes.
- **Crossfading Between Slices**: Smooth the transitions between different sample slices to reduce clicks.

### Code Hints:
In the code, I found some indications that an anti-click mechanism may have been partially implemented by the original authors:

> In **SampleInstrument.cpp**:
> Line 25: `#define SHOULD_KILL_CLICKS true`
> Lines 291, 921, 1093: `rp->couldClick_ = SHOULD_KILL_CLICKS;`

However, the **`couldClick_`** variable does not seem to be used elsewhere in the code. It appears this feature is still a work in progress.

It would be fantastic if this work could be completed, as the presence of these clicks significantly detracts from the experience of sample mangling in LGPT.

maks, 2024-09-10:
Thanks for filling this issue.

I've run into clicks while using some of the fx commands too, but I'm not sure about the best way to go about addressing this, for instance using PLOF for granular playback of very short samples, it often won't make sense to do any of those 3 possible solutions you listed.

fpiesik, 2024-09-11:
I have two ideas in mind:

1. Adding an option in the instrument menu that allows the user to choose between "smoothed" or "raw" position-hopping. This way, users can select the mode that best suits their needs.
2. Introducing slice-offset markers to fine-tune slice positions manually to find zero-crossings. This option would apply only to slices but could allow for smooth hopping between different parts of a loop without causing audio clicks while leaving granular synthesis untouched.

The second approach might be more technically straightforward to implement, as triggering a fade mechanism at the exact right time seems complicated, especially since everything else appears to be k-rate-timed, which isn't fast or precise enough. This is particularly true with fade-outs, as they need to occur before the sample position is changed. To achieve this, you'd need to introduce some kind of look-ahead mechanism to determine whether a PLOF command will be triggered in the next step.

fpiesik, 2024-09-13:
The more I play with the tracker, the more I realize that it definitely needs a smoothing mechanism. For example, if I play a bass sample that is half a note long and want to trigger it every quarter note, it clicks almost every time. I think there is no way around to implement a detector that triggers the sample to fade out before its play position changes.

maks, 2024-09-13:
@fpiesik thats an interesting example, but in this case, it sounds more like what you want is to be able to set a ADSR volume envelope?

fpiesik, 2024-09-13:
Envelopes would definitely help in some cases. There’s already the possibility to use the VOLM command to achieve something similar to envelopes, but that requires setting the VOLM speed fast enough to ensure the envelope is completely finished before the next note is triggered. That’s not very convenient. So I think there should be something at a lower level that always ensures at least a few milliseconds of fading between sudden sample amplitude values.

fpiesik, 2024-09-13:
I'm looking forward to envelopes, but I'm not convinced they will eliminate the problem of clicking sounds in many cases. For example, if you choose a long decay for sustained notes, you'd have to adjust the decay every time you want to mix shorter notes with the longer ones.

maks, 2025-04-14:
This was likely fixed by https://github.com/xiphonics/picoTracker/pull/449  but feel free to reopen if that is not the case (do note that for now only the CI builds that incorporate that fix).

Closed 2025-04-14.

Thread 217 (2024-09-21):

Instrument deep clone

djdiskmachine, 2024-09-21:
Deep clone is a feature found in LSDJ and M8tracker that significantly speeds up arrangement and composing.
In LSDJ, it's a toggle in the project view and in M8tracker it's a button combo.
When regular cloning chain 00, containing the phrases
00
01
00
02

The resulting chain 01 would contain
00
01
00
02

Deep clone however, the above example 00 would contain
03
04
03
05

The contents of phrases would be identical and no cloning of instruments or other phrase information would occur.

A suggestion of how to implement can be found in these commits for Piggy:

https://github.com/djdiskmachine/LittleGPTracker/pull/81
https://github.com/djdiskmachine/LittleGPTracker/pull/98
https://github.com/djdiskmachine/LittleGPTracker/pull/135

Would you be interested in having this feature in picoTracker too?

maks, 2024-09-21:
Yes 💯 interested! 🙂
Quick questions:
1. I'm guessing you meant "01 would contain..." not 00 ?
2. What happens if the subsequent phrase numbers are already in use, say in example above, there are already phrases 03,04,05,06, in that case would it clone to phrases: 06,07,06,08 ?

djdiskmachine, 2024-09-21:
1: indeed! Does my updated comment clarify things?
2: Deep cloning won't overwrite any already populated chains/phrases but will check for empty ones up until max available chains/phrases.

Missing in this suggestion is a screen notification for any possible unsuccessful operations.
I'll hold off making a PR for now and will await The Great Refactoring 🙂

djdiskmachine, 2024-09-24:
Notification design suggestion can be found here
https://github.com/djdiskmachine/LittleGPTracker/pull/137

maks, 2024-09-24:
Thanks @djdiskmachine this looks like the code showing the UI?
https://github.com/djdiskmachine/LittleGPTracker/pull/137/files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

djdiskmachine, 2024-09-26:
That's right! It doesn't work perfectly together with the help legend feature, need to work something out there. :)

Thread 218 (2024-10-07):

Overclocking

paasukusai, 2024-10-07:
Playback seems to break up when a lot of audio is played like attached project.
I would like to try overclocking, is there any other setting I should change besides SYS_CLK_KHZ,?

I know it could be a FLASH access speed issue, but if you have any advice it would be helpful.

[lgpt_FUKA.zip](https://github.com/user-attachments/files/17280850/lgpt_FUKA.zip)

democloid, 2024-10-07:
picoTracker already runs overclocked, so I wouldn't recommend doing more than what it's doing right now, that said, yes, SYS_CLK is the one for the core clock.

In general picoTracker can run up to 5-6 tracks simultaneously pretty reliably, this is not the case with your project so I'll check if it's a sample format issue.

paasukusai, 2024-10-08:
Thank you for the info!
I'll give up on overclocking for now.
As a spec upgrade, porting to pico2 would also be interesting.

Thank you.

maks, 2024-10-08:
>Thank you for the info!
You're welcome.

>As a spec upgrade, porting to pico2 would also be interesting.

Yes it will be 👍🏻

Closed 2024-10-08.

Thread 242 (2024-11-05):

swap scratchpad ram usage between core0 and core1

maks, 2024-11-05:
As [per this article](https://petewarden.com/2024/01/16/understanding-the-raspberry-pi-picos-memory-layout/), it would make sense for us to swap the default assignment of the scratchpad x,y ram banks for per core stack space as we use both cores and the code running on Core1 is much less likely to overflow 4kB of stack than Core0.

Thread 243 (2024-11-06):

investigate use of rp2040 interpolators

maks, 2024-11-06:
The interpolators should allow for accelerating some audio processing operations.

References:
https://people.ece.cornell.edu/land/courses/ece4760/RP2040/C_SDK_interpolator/index_interpolator.html

https://github.com/raybellis/rp2040-sine-interpolator

https://forums.raspberrypi.com/viewtopic.php?t=328054

https://forums.raspberrypi.com/viewtopic.php?t=356425#p2135847

maks, 2025-01-10:
Initial use case is the [linear interpolation in the SampleInstrument](https://github.com/xiphonics/picoTracker/blob/158385fd27e1f2739d208183760272616c6b808e/sources/Application/Instruments/SampleInstrument.cpp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) which is currently quite costly due to use of 2 fixed point multiplications.

Thread 256 (2024-12-03):

Remove all uses of printf

maks, 2024-12-03:
Need to remove all uses of the printf as it has serious performance issues for use in pT, [particularly its use of a large buffer on the stack](https://mcuoneclipse.com/2013/04/19/why-i-dont-like-printf/).

maks, 2024-12-03:
This needs to include replacing use of the c lib sprintf in `Trace::VLog`

maks, 2024-12-03:
There seem to be no end of small printf re-implementations that could be suitable for embedded use, just need to go through them and pick one to use just for sprintf and then can directly use putchar from the pico sdk:

* https://stackoverflow.com/questions/16647278/minimal-implementation-of-sprintf-or-printf
* https://github.com/charlesnicholson/nanoprintf
* https://github.com/eyalroz/printf
* http://www.sparetimelabs.com/tinyprintf/tinyprintf.php
* https://github.com/mpaland/printf
*

maks, 2024-12-04:
[nanoprint](https://github.com/charlesnicholson/nanoprintf) seems to be the prime candidate.

Closed 2024-12-04.

Thread 260 (2024-12-05):

Remote UI needs to handle invert

maks, 2024-12-05:
Currently remote ui protocol doesn't handle the case of "color inversion", ie when the `invert` property is passed in to `DrawString()` but this is needed as its used for things in the UI like:
* to draw the border outline of dialogs
* the background color for the display of playing notes at the bottom of each track on the song screen
* etc.

maks, 2024-12-06:
Turns out this is actually a bug in the remote UI client.

Closed 2024-12-06.

Thread 268 (2024-12-15):

Display battery gauge on all screens

maks, 2024-12-15:
Currently the battery gauge is only shown on the Song screen.

To make room for it on the Project screen the firmware build version can be removed.

To make room for it on the Device screen, the firmware build version can be moved to the bottom row of the screen layout.

democloid, 2024-12-15:
Sample name will also be a problem in phrase screen

Closed 2024-12-27.

Thread 272 (2024-12-20):

Editing SID ADSR value stops all SID playback from working

maks, 2024-12-20:

maks, 2024-12-20:
Actually seems editing other parameters like filter while playing back causes issues too, eg. editing filter cut or mode while filter is set to `false` still causes filter to be applied.

maks, 2025-01-30:
Fixed in #340

Closed 2025-01-30.

Thread 277 (2024-12-24):

Song screen doesn't scroll down to follow playback cursor

maks, 2024-12-24:
When the playback cursor goes off screen by playing the next row not visible on the Song screen, the screen does not scroll itself to follow the cursor so that the currently playing row is displayed on screen.

This is disorientating behaviour as there is no other way on the UI to see the currently playing row.

An added wrinkle here is that different rows can be playing in different tracks (columns). For that case I think it would be acceptable to try to show at least the left most playing columns currently playing row.

democloid, 2024-12-24:
I don't quite agree on this one. The screens are mainly editing screens, and playback cursor is added as a visual aid, but don't think it should take over scrolling. What happens when you're looking at something and the screen needs to scroll and you're editing cursor is in the first row? does it disappear? move over to another row? Don't think either of those are desirable

The fact that the playing cursor could end up in two different screens and you'd have to make an arbitrary decision on which one to follow makes this even worse IMO.

maks, 2024-12-26:
@democloid good point about that! I was influenced on this by how Milkytracker does scroll with playback but its an option there to turn off and playing a bit more with it, I think you're right and it won't work well on the pT UI.

Closed 2024-12-26.

Thread 279 (2024-12-26):

Improve colour swatch UI

maks, 2024-12-26:
The current place holder hash chars can be replaced in the device screen colour swatches now I now how the inverse colour with space chars trick works.

Closed 2024-12-27.

Thread 281 (2024-12-29):

picoTracker USB CDC not detected on Windows 11 for use with remote UI

maks, 2024-12-29:
This is likely due to the use of custom Vendor/Product USB ID's when the firmware was switched to custom USB descriptors. The pT really shouldn't be using custom VID/PID anyway as they are not registered. Instead the pT firmware should use[ the standard RPI VID/PID](https://github.com/raspberrypi/usb-pid) of  `0x2E8A`/`0x0003` as we don't need to use a custom windows driver as only require CDC for the remote UI.

maks, 2024-12-29:
Turns out this was due to conflict in between the CDC notification and MIDI IN USB end points.

Closed 2024-12-29.

Thread 286 (2024-12-30):

Sample import browser doesnt reset to top when entering a subdir

maks, 2024-12-30:
If having paged down in viewing the current directory, the user sees and enters a subdir entry (which are now no longer guaranteed to be listed at the top of each dirs file list) when the subdirs file list is displayed, the paged view is not reset to the start of that subdirs file listing.

Thread 288 (2024-12-31):

Increase chain count limit to 143

maks, 2024-12-31:
This is a proposal to increase chain count limit to 143.

Why 143 you ask?
Well having chains upto `8F`  means that users can make use of a convention from other trackers having chain numbers that match the track they are in.
eg. in Song view:
```
10 20 30 40 50 00 00 00
11 21 00 41 51 00 00 80
12 00 31 00 00 00 00 81
... etc
```

This means that another convention of leaving `00`  empty and `0F` as a "kill" chain  which then means having a [different color settings](#181) for `00` and `0F` (instead of `FE` as in LGPT) would make more sense too.

This would increase ram usage by chains, but this could be "payed for" by replacing `bool isUsed_[CHAIN_COUNT];` with a 32bit int as a bit field and still give a small ram saving overall.

maks, 2024-12-31:
Oops I miscounted, it will actually cost an 484 bytes to do this.

Closed 2025-01-02.

Thread 293 (2025-01-06):

Update to build with gcc 13

maks, 2025-01-06:
We now only need to fix a couple function signatures to get current master branch to build with gcc 13 so we should upgrade to do this and build with gcc13 on CI.

faithanalog, 2025-04-07:
I am building on gcc14 with these changes:

```patch
diff --git a/sources/CMakeLists.txt b/sources/CMakeLists.txt
index 332c118..2d502b6 100644
--- a/sources/CMakeLists.txt
+++ b/sources/CMakeLists.txt
@@ -70,6 +70,9 @@ add_compile_options(
   -Wno-array-bounds
 )

+add_compile_options($<$<COMPILE_LANG_AND_ID:CXX,GNU>:-Wno-overloaded-virtual>)
+add_compile_options($<$<COMPILE_LANG_AND_ID:CXX,GNU>:-Wno-aggressive-loop-optimizations>)
+
 add_subdirectory(Adapters)
 add_subdirectory(UIFramework)
 add_subdirectory(System)
diff --git a/sources/Foundation/T_Factory.h b/sources/Foundation/T_Factory.h
index 9bc2b03..49b0f89 100644
--- a/sources/Foundation/T_Factory.h
+++ b/sources/Foundation/T_Factory.h
@@ -9,7 +9,7 @@

 template <class Item> class T_Factory {
 protected:
-  virtual ~T_Factory<Item>(){};
+  virtual ~T_Factory(){};

 public:
   // Install the factory to use
```

I do not remember what code exactly triggers those two warnings but it was only a couple spots, i just wasn't sure what to do to fix them.

maks, 2025-04-08:
@faithanalog Thanks! I'll see if I can find get this incorporated in soon so that we can move to building with gcc13 or even better with gcc14

maks, 2025-04-08:
@faithanalog Thanks for the prompting for me to get a move on with this 👍🏻

I've got a PR with a branch that now builds with GCC13: https://github.com/xiphonics/picoTracker/pull/446
and hopefully fixes the issue you had fixes for for GCC14 but I don't have GCC14 installed so if you could try it out and see if it works for you that would be great 🙏🏻

faithanalog, 2025-04-08:
that seems to take care of pretty much everything except the opal warning

```
In file included from /tmp/picoTracker/sources/Externals/opal/opal.cpp:1:
In member function ‘void Opal::Channel::SetChannelPair(Opal::Channel*)’,
    inlined from ‘void Opal::Port(uint16_t, uint8_t)’ at /tmp/picoTracker/sources/Externals/opal/opal.cpp:252:34:
/tmp/picoTracker/sources/Externals/opal/opal.h:141:54: error: iteration 1 invokes undefined behavior [-Werror=aggressive-loop-optimizations]
  141 |     void SetChannelPair(Channel *pair) { ChannelPair = pair; }
      |                                          ~~~~~~~~~~~~^~~~~~
/tmp/picoTracker/sources/Externals/opal/opal.cpp: In member function ‘void Opal::Port(uint16_t, uint8_t)’:
/tmp/picoTracker/sources/Externals/opal/opal.cpp:238:25: note: within this loop
  238 |       for (int i = 0; i < 6; i++, mask <<= 1) {
      |                       ~~^~~
```

I really could not make sense of what the problem is that needs to be fixed, the code is a bit convoluted to me

maks, 2025-04-08:
@faithanalog  thanks again for testing this out. I couldn't reproduce the issue after I installed and build with GCC 14.2 but just in case I pushed up a small change that should disable that warning for just the OPAL directory. If you could please let me know if that works for you and I will then look to get our CI updated to at least GCC13 and the PR merged.

faithanalog, 2025-04-08:
@maks yup, it now builds for me now!

Thread 295 (2025-01-09):

Fix note auditioning

maks, 2025-01-09:
Currently note auditioning is a "one shot" which is trigger when pressing the Enter key. This works ok for short samples but is not ergonomic for longer samples or synths.

Instead what is needed is to have auditioning play only while the Enter key is held down.

Closed 2025-01-10.

Thread 304 (2025-01-10):

Remove restriction on not allowing project saving when sequencer is running

maks, 2025-01-10:
I don't think we need this restriction any more as saving to sdcard doesn't involve any writing to the SPI flash.

maks, 2025-02-12:
@democloid FYI: Even though it's small change, I've changed my mind on this and think its too risky a change this late in the beta, so this is better left for post v2.0 .

Closed 2025-05-06.

Thread 305 (2025-01-10):

Add a option on device screen to do "reset settings"

maks, 2025-01-10:
This reset would just delete the current config file and reboot, allowing the existing code to create a new file with firmware default settings.

maks, 2025-04-23:
Related to #495

Thread 312 (2025-01-13):

reduce stack allocation

maks, 2025-01-13:
The import sample file browser and project list browsers both currently do a 1kB stack allocation for the vector of file indexes, which is too large to be done reasonably safely.

Instead need to have a statically allocated vector that can then be reused by all callers of the the list() method.

maks, 2025-01-15:
Actually I mis-remembered how this was implemented, sample file import and project selection views already use a statically allocated vector and not a local stack allocated vector for this, so nothing needs to be done here.

Closed 2025-01-15.

Thread 315 (2025-01-15):

Selections of notes are not cut

maks, 2025-01-15:
When a set of notes is selected on the phrase screen, using the cut keycombo (EDIT+ENTER) doesn't cut the selection from the phrase and instead only the first selected note/instrument is cut.

maks, 2025-05-09:
This was just a mistake on my part as the cut combo is actually `ALT`+`ENTER` not `EDIT`+`ENTER`

Closed 2025-05-09.

Thread 317 (2025-01-15):

ClearRect is missing implementation in picoTrackerGUIWindowImp

maks, 2025-01-15:
currently is just:
```
void picoTrackerGUIWindowImp::ClearRect(GUIRect &r) {
  Trace::Debug("GUI ClearRect call");
};
```

Thread 318 (2025-01-15):

Refactor and improve Sample Instrument purge

maks, 2025-01-15:
Currently the instrument purge code for SampleInstrument has some legacy code that uses 2 co-indexed arrays that really should be handled by a single etl:vector with the `names_` being replaced with the name being stored instead in `SoundSource`.

Also the purge code needs to be improved to remove purged samples from flash so that the project doesn't need to be manually reloaded by the user after doing a "compact instruments" (aka purge instruments).

Thread 319 (2025-01-16):

Revise battery voltages empirically for v2 PCBs battery

maks, 2025-01-16:
The new battery (LIP1708) used for v2 PCBs has a different voltage discharge curve to the previous battery used for the v1 PCBs, so need to redo run down test measuring the voltages to calibrate for the new battery.

This will likely be imperfect as there are several compatible batteries for the v2 PCBs with varying capacities but unfortunately the battery indication is only roughly indicative at best given the lack of battery gauging IC in the v2 PCBs.

maks, 2025-02-12:
Actually dont think there is much that can be done here due to the variety of battery capacities that can be used and the lack of anything other than the voltage to go by.

Closed 2025-02-12.

Thread 320 (2025-01-16):

Remove Compact Sequencer

maks, 2025-01-16:
This feature doesn't work currently so should remove the UI for it and not clear its actually useful.

Closed 2025-01-18.

Thread 325 (2025-01-16):

Stuck on loading screen when loading the second sample of a project

gandaja, 2025-01-16:
Happens both with nested folders and all samples in the main directory.
I'm sporting v2beta6.
All files are 16 bit 44.1khz.
Formatted the sd card more times than I care to remember.
Will try to upload a zip of the sd card and a video of the process in a couple hours.
It's honestly quite frustrating, I owned one for more than a year and I still can't manage simple sample playback.

gandaja, 2025-01-16:
[Desktop.zip](https://github.com/user-attachments/files/18444066/Desktop.zip)

gandaja, 2025-01-16:
https://github.com/user-attachments/assets/a251b0c2-02f7-475a-90ab-a2bc2be6d203

maks, 2025-01-17:
Hi, thank you for filling the issue. I was able to replicate the issue *somewhat* by first trying to load the first `Bassdrum 001.wav` sample which you uploaded and that indeed does lock up the import process, **_but_** it is 48kHz, not 44.1kHz sample rate and only 48kHz is not supported on the picoTracker. I did see that several other samples you had were also 48kHz, though the clap sample in your video is 44.1kHz.

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

Given this, could I ask you to double check and follow this procedure:
1. Create a new project
2. Name the project and save it
3. create a new chain/phrase/step/instrument as per your video and try importing a sample that is definitely in a 44.1kHz format, such as `Clap 001.wav` in the zip file you attached here.

For me the above procedure works consistently using ILI9341 beta6 firmware on an original pT v1.2 PCB device.

maks, 2025-01-17:
Actually my apologies, upon testing this further I can reproduce locking up importing with 44.1kHz sample also.
Strangely this only seems to happen on release builds and at seemingly random times. I had to test alot of times before it occurred, then it happened immediately on project reload then again a long time before reoccurring.

Unfortunately as Im yet to find a way to reproduce this with a debug build, it may take some time to track down the cause.

maks, 2025-01-17:
@gandaja If you can, could you please test the firmware build in a zip file from the PR you can find [at this link](https://github.com/xiphonics/picoTracker/actions/runs/12824620046/artifacts/2445430233) and let us know if it resolves the issue for you?

gandaja, 2025-01-17:
The link leads me to a 404 error :(

gandaja, 2025-01-17:
@maks ok I managed to download the firmware. I'll get around to it when I leave work, I'll report back

gandaja, 2025-01-17:
@maks just tested with only six samples in the main directory. It works and loads samples like supposed to. Hurrah!
Thank you for the build.

gandaja, 2025-01-17:
@maks just tested with only six samples in the main directory. It works and loads samples like supposed to. Hurrah!
Thank you for the build.

gandaja, 2025-01-17:
I inadvertently closed the issue. I reopened it, just in case.

gandaja, 2025-01-17:
Also, I'm hearing a faint "pop" at the end of each sample.
I don't know if that is described is some other issue, if it's a problem of my build in particular, if it's something you're aware of and working on or something that is intrinsical to the pico project.
Just wanted to throw this out here, but feel free to delete this comment if not relevant.
Likewise, thanks for your help.

maks, 2025-01-18:
@gandaja  Thanks again for reporting this issue and testing the fix 👍🏻
I've now incorporated the fix along with a number of other changes and fixes in the[ latest Beta7 build](https://github.com/xiphonics/picoTracker/releases/tag/v2.0beta7)so I would recommend using that instead of my test build from here.

Closed 2025-01-18.

Thread 329 (2025-01-18):

>7F phrase causes screen crash

wynwynyn, 2025-01-18:
[v2.0beta7](https://github.com/xiphonics/picoTracker/releases/tag/v2.0beta7)

Screen crashes when you try and add phrase number of over 7F.

Steps to reproduce
1. Open any project
2. Add a phrase to the chain screen that is over `7F`, like `80`
3. Try and navigate to another screen

Expected outcome:
Should not be allowed to go over `7F` phrase number.

talktopag, 2025-02-18:
Just an FYI that this still exists in v2.0 RC1.

Closed 2025-02-25.

Thread 330 (2025-01-18):

Table screen cursor position resets back to 0 if boundary is exceeded

wynwynyn, 2025-01-18:
v2.0beta7

QOL table screen improvement.

Moving cursor to position -1, the cursor jumps to the opposite side of the screen (like pacman). This doesn't happen both ways.

Steps to reproduce:
1. Open any project
2. Go to a table screen
3. Hold the left button, or hold the up button - observe the behaviour
4. Repeat for the right and down buttons

Desired outcome:
Should be one or the other for consistency. Preferably not having the cursor jump so it's easy to quickly navigate to the furthest edges.

maks, 2025-02-27:
I agree that its probably better not to wrap cursor position.

Closed 2025-05-06.

Thread 331 (2025-01-18):

Add option to change button repeat delay

wynwynyn, 2025-01-18:
Desired outcome:
Would be really nice to be able to change the speed of how long you have to hold a button down for before it repeats. The default is quite long for my liking, and would love the option to have it much shorter.

maks, 2025-02-27:
This is related to #336

Thread 332 (2025-01-18):

Screen occasionally freezes, and goes blank when trying to navigate

wynwynyn, 2025-01-18:
This happened a lot in v2.0beta6, I've not had the chance to see if it happens in beta7 yet.

Unable to reproduce this as it happens completely randomly. When it does happen though, I can still press the play button and hear the track playing normally in the background. But the screen stays black and never comes back. System reboot is required.

I'll try and provide as much info as possible if it is required!

halfmanhalftaco, 2025-01-19:
I encountered the same problem this evening on 2.0beta7 on my picoTracker v2.0. Haven't been able to reproduce it yet.

amokan, 2025-01-24:
I can confirm I have experienced similar on the v2 hardware and beta7 this week.

democloid, 2025-02-06:
I need a way to reproduce this, any hints on what screens you may have been on, typical workflow, types of instruments being used, etc?
Does this happen without any input? does it happen when input within a screen or when changing screens? (i.e screen is cleared and never redrawn)

wynwynyn, 2025-02-06:
@democloid it's a really difficult one to reproduce... I've had it on instrument screens, phrase screens, and even when changing the theme colours. It has done it before when I've just hit play on a track and not pressed any buttons or changed screen, I only noticed because the play time display had stopped counting.

Sorry this isn't helpful at all... I will try some things today and see if I can create some steps to reproduce, and will let you know asap if I manage to find anything :)

wynwynyn, 2025-02-07:
@maks @democloid I wasn't able to find a definitive method to cause the screen to crash unfortunately :( I experienced it a couple of times (`beta8A`) but it appeared to be completely random...

I did have a thought though... When this happens, it is just that the screen becomes unresponsive, and goes blank (same as bg colour) when you try to navigate. However, all the buttons seem to function, and you can still play sounds, play and stop the track, and maybe even navigate.

With this in mind, do you think some kind of logging might be a feasible way of debugging this? I don't know whether this could be done to a logfile on the SD card, or over serial output over USB or something?

I'm more than happy to give this a go again on a debug build or something! :)

maks, 2025-02-07:
@wynwynyn thank you very much for the follow up information. That by itself is very helpful! Especially helpful is your observation that navigation and playback continue to work, as that seems to support working theory I have that it's not a crash at all but just the events that trigger redraws that for some reason are no longer being triggered.
If you find a consistent repro case that Will be great but this new information is already very valuable, thanks! 👍

wynwynyn, 2025-02-07:
@maks thanks for that! If that's possible and not too much hassle, I would love that! :)

Float-pixel, 2025-02-10:
I think I have this issue as well. I haven't been able to hear playback when it happens to me, my unit just hard crashes while navigating.

I am happy to run a custom build to help test this. I don't think my unit has gone more than 15-20 minutes without crashing so I should be able to repeat this bug pretty often.

wynwynyn, 2025-02-11:
Thanks a lot @maks ! It's working a treat :)

I don't seem to be getting the crash as per this issue when running serial over usb debugging unfortunately! I've had a project on playback more a for 45 minutes so far with no blips, apart from a few audio overruns! It will be interesting to know if @Float-pixel is able to recreate the issue with serial over usb...

democloid, 2025-02-11:
> I think I have this issue as well. I haven't been able to hear playback when it happens to me, my unit just hard crashes while navigating.
>
> I am happy to run a custom build to help test this. I don't think my unit has gone more than 15-20 minutes without crashing so I should be able to repeat this bug pretty often.

@Float-pixel we had another unrelated issue that hard crashed but didn't blank the screen, maybe that's what you were experiencing? were you using the opal instrument?

Float-pixel, 2025-02-11:
@democloid I've experienced the Opal crash before, but mine has crashed even with pure samples in the instruments.

I'll be able to test this tonight, I'll just try to write a song and send yall whatever crashes I get.

Float-pixel, 2025-02-12:
had a bit of trouble connecting by serial on Linux Mint, issue was resolved by adding my user to the 'dialout' group. Then serial worked fine.

Any time I am playing back in this build, I am seeing this in the logs:
`þ wkVþ >  þ >  þ oþ A $ þ # $ þ A $ þ # $ þ 2 % þ 2 % þ 0 & þ 1 & þ 0 & þ 0 & [*ERROR*] Audio overrun, please report
þ oþ C $ þ   $ þ 3 % þ ­­­þ 1- [*ERROR*] Audio overrun, please report
þ oþ # $ þ oþ   $ [*ERROR*] Audio overrun, please report
þ ­­­þ 2- þ oþ # $ þ oþ G $ þ   $ þ   $ [*ERROR*] Audio overrun, please report
þ oþ A $ þ # $ þ A $ þ # $ þ 2 % þ ­­­þ 3- [*ERROR*] Audio overrun, please report
þ wkVþ    þ    þ oþ   $ þ   $ þ   $ þ   $ þ   % þ   % þ   & þ   & þ   & þ   & [*ERROR*] Audio overrun, please report`

I got a freeze/crash while trying to load a hihat sample. I had been going into the legowelt drum wizardry folder for all my drums this song, this is the third sample I've loaded from this directory. I reported a similar style of crash in issue #368

`þ k1kþ L # þ e # þ g # þ o # þ w # þ e # þ l # þ t # þ   # þ B # þ a # þ s # þ e
# þ d
# þ r
# þ u # þ m # þ  !# þ 0"# þ 4## þ 8$# þ .%# þ w&# þ a'# þ v(# þ ­­­þ L $þ e $þ g $þ o $þ w $þ e $þ l $þ t $þ   $þ B $þ a $þ s $þ e
$þ d
$þ r
$þ u $þ m $þ  !$þ 0"$þ 9#$þ 2$$þ .%$þ w&$þ a'$þ v($þ k1kþ 1 & þ 4 & þ 1 & þ 4 & þ 2 & þ 8
& [*ERROR*] Audio overrun, please report
[PICOIMPORT] plain play preview [-D-] Streaming stopped
[PICOIMPORT] plain play preview [-D-] Starting to stream:Legowelt Basedrum 048.wav
[] wave open:Legowelt Basedrum 048.wav [WAVFILE] wave open from Legowelt Basedrum 048.wav [FILESYSTEM] Open file:Legowelt Basedrum 048.wav, mode:r
[-D-] Reached the end of 70692 samples
[PICOIMPORT] SHIFT play - import [FILESYSTEM] Open file:Legowelt Basedrum 048.wav, mode:r þ    þ    þ    þ    þ    þ    þ    þ    þ    þ    þ    þ    þ    þ
 þ  * þ  + þ  , þ  - þ  . þ    þ    þ    þ    þ    þ    þ    þ    þ    þ    þ    þ    þ
 þ
 þ
 þ    þ   þ  ! þ  " þ  # þ  $ þ  % þ  & þ  ' þ  ( þ    þ    þ    þ    þ    þ    þ    þ    þ    þ    þ    þ    þ
 þ
 þ
 þ    þ   þ  ! þ  " þ  # þ  $ þ  % þ  & þ  ' þ  ( þ    þ    þ    þ    þ    þ    þ    þ    þ    þ    þ    þ    þ
 þ
 þ
 þ    þ   þ  ! þ  " þ  # þ  $ þ  % þ  & þ  ' þ  ( þ    þ    þ    þ    þ    þ    þ    þ    þ    þ    þ    þ    þ
 þ
 þ
 þ    þ   þ  ! þ  " þ  # þ  $ þ  % þ  & þ  ' þ  ( þ    þ    þ    þ    þ    þ    þ    þ    þ    þ    þ    þ    þ
 þ
 þ
 þ    þ   þ  ! þ  " þ  # þ  $ þ  % þ  & þ  ' þ  ( þ    þ    þ    þ    þ    þ    þ    þ    þ    þ    þ    þ    þ
 þ
 þ
 þ    þ   þ  ! þ  " þ  # þ  $ þ  % þ  & þ  ' þ  ( þ    þ    þ    þ    þ    þ    þ    þ    þ    þ    þ    þ    þ
 þ
 þ
 þ    þ   þ  ! þ  " þ  # þ  $ þ  % þ  & þ  ' þ  ( þ    þ    þ    þ    þ    þ    þ    þ    þ    þ    þ    þ    þ
 þ
 þ
 þ    þ   þ  ! þ  " þ  # þ  $ þ  % þ  & þ  ' þ  ( þ    þ    þ    þ    þ    þ    þ    þ    þ    þ    þ    þ    þ
 þ
 þ
 þ    þ   þ  ! þ  " þ  # þ  $ þ  % þ  & þ  ' þ  ( þ    þ    þ    þ    þ    þ    þ    þ    þ    þ    þ    þ    þ
 þ
 þ
 þ    þ   þ  ! þ  " þ  # þ  $ þ  % þ  & þ  ' þ  ( þ ­­­þ L. þ o  þ a  þ d  þ i  þ n  þ g  þ    þ L  þ e  þ g  þ o  þ w  þ e  þ l
 þ t
 þ
 þ B  þ a  þ s! þ e" þ d# þ r$ þ u% þ m& þ  ' þ 0( þ 4) þ 8* þ .+ þ w, þ a- þ    þ
þ
þ
þ
þ
þ
þ
þ
þ
þ
þ
þ
þ

þ

þ

þ
þ
þ  !
þ  "
þ  #
þ  $
þ  %
þ  &
þ  '
þ  (
þ
þ
þ
þ
þ
þ
þ
þ
þ
þ
þ
þ
þ

þ

þ

þ
þ
þ  !
þ  "
þ  #
þ  $
þ  %
þ  &
þ  '
þ  (
þ
þ
þ
þ
þ
þ
þ
þ
þ
þ
þ
þ
þ

þ

þ

þ
þ
þ  !
þ  "
þ  #
þ  $
þ  %
þ  &
þ  '
þ  (
þ    þ    þ    þ    þ    þ    þ    þ    þ    þ    þ    þ    þ
 þ
 þ
 þ    þ   þ  ! þ  " þ  # þ  $ þ  % þ  & þ  ' þ  ( þ    þ    þ    þ    þ    þ    þ    þ    þ    þ    þ    þ    þ
 þ
 þ
 þ    þ  þ  ! þ  " þ  # þ  $ þ  % þ  & þ  ' þ  ( þ   !þ   !þ   !þ   !þ   !þ   !þ   !þ   !þ   !þ   !þ   !þ   !þ
!þ
!þ
!þ   !þ  !þ  !!þ  "!þ  #!þ  $!þ  %!þ  &!þ  '!þ  (!þ   "þ   "þ   "þ   "þ   "þ   "þ   "þ   "þ   "þ   "þ   "þ   "þ
"þ
"þ
"þ   "þ  "þ  !"þ  ""þ  #"þ  $"þ  %"þ  &"þ  '"þ  ("þ   #þ   #þ   #þ   #þ   #þ   #þ   #þ   #þ   #þ   #þ   #þ   #þ
#þ
#þ
#þ   #þ  #þ  !#þ  "#þ  ##þ  $#þ  %#þ  &#þ  '#þ  (#þ   $þ   $þ   $þ   $þ   $þ   $þ   $þ   $þ   $þ   $þ   $þ   $þ
$þ
$þ
$þ   $þ  $þ  !$þ  "$þ  #$þ  $$þ  %$þ  &$þ  '$þ  ($þ ­­­þ p %þ i %þ c %þ o %þ T %þ r %þ a %þ c %þ k %þ e %þ r %þ   %þ b %þ u
%þ i
%þ l
%þ d %þ  %þ 2!%þ ."%þ 0#%þ -$%þ B%%þ E&%þ T'%þ A(%þ 8)%þ A*%þ r+%þ _,%þ 0-%þ 0.%þ    þ   &þ   &þ   &þ   &þ   &þ   &þ   &þ   &þ   &þ   &þ   &þ   &þ
&þ
&[FILESYSTEM] Open file:/projects/TESTo/samples/Legowelt Basedrum 048.wav, mode:w [SAMPLEPOOL] Loading sample into flash: Legowelt Basedrum 048.wav [WAVFILE] wave open from Legowelt Basedrum 048.wav [FILESYSTEM] Open file:Legowelt Basedrum 048.wav, mode:r [WAVFILE] . [WAVFILE] . [WAVFILE] . [WAVFILE] . [WAVFILE] . þ )î=þ I  þ m  þ p  þ o  þ r  þ t  þ    þ S  þ a  þ m  þ p  þ l  þ e
 þ [* þ C+ þ H, þ G- þ ]. þ ­­­þ L  þ e  þ g  þ o  þ w  þ e  þ l  þ t  þ    þ B  þ a  þ s  þ e
 þ d
 þ r
 þ u  þ m  þ  ! þ 0" þ 2# þ 8$ þ .% þ w& þ a' þ v( þ L  þ e  þ g  þ o  þ w  þ e  þ l  þ t  þ    þ B  þ a  þ s  þ e
 þ d
 þ r
 þ u  þ m  þ  ! þ 0" þ 7# þ 7$ þ .% þ w& þ a' þ v( þ L  þ e  þ g  þ o  þ w  þ e  þ l  þ t  þ    þ B  þ a  þ s  þ e
 þ d
 þ r
 þ u  þ m  þ  ! þ 0" þ 6# þ 4$ þ .% þ w& þ a' þ v( þ L  þ e  þ g  þ o  þ w  þ e  þ l  þ t  þ    þ B  þ a  þ s  þ e
 þ d
 þ r
 þ u  þ m  þ  ! þ 0" þ 1# þ 6$ þ .% þ w& þ a' þ v( þ L  þ e  þ g  þ o  þ w  þ e  þ l  þ t  þ    þ B  þ a  þ s  þ e
 þ d
 þ r
 þ u  þ m  þ  ! þ 0" þ 4# þ 6$ þ .% þ w& þ a' þ v( þ L  þ e  þ g  þ o  þ w  þ e  þ l  þ t  þ    þ B  þ a  þ s  þ e
 þ d
 þ r
 þ u  þ m  þ  ! þ 0" þ 5# þ 9$ þ .% þ w& þ a' þ v( þ L  þ e  þ g  þ o  þ w  þ e  þ l  þ t  þ    þ B  þ a  þ s  þ e
 þ d
 þ r
 þ u  þ m  þ  ! þ 0" þ 8# þ 2$ þ .% þ w& þ a' þ v( þ L  þ e  þ g  þ o  þ w  þ e  þ l  þ t  þ    þ B  þ a  þ s  þ e
 þ d
 þ r
 þ u  þ m  þ  ! þ 0" þ 2# þ 2$ þ .% þ w& þ a' þ v( þ L  þ e  þ g  þ o  þ w  þ e  þ l  þ t  þ    þ B  þ a  þ s  þ e
 þ d
 þ r
 þ u  þ m  þ  ! þ 0" þ 6# þ 5$ þ .% þ w& þ a' þ v( þ L  þ e  þ g  þ o  þ w  þ e  þ l  þ t  þ    þ B  þ a  þ s  þ e
 þ d
 þ r
 þ u  þ m  þ  ! þ 0" þ 9# þ 0$ þ .% þ w& þ a' þ v( þ    þ  . þ    þ ­­­þ L  þ e  þ g  þ o  þ w  þ e  þ l  þ t  þ    þ B  þ a  þ s  þ e
 þ d
 þ r
 þ u  þ m  þ  ! þ 1" þ 0# þ 3$ þ .% þ w& þ a' þ v( þ    þ  ) þ  * þ  + þ  , þ  - þ ­­­þ L
þ e
þ g
þ o
þ w
þ e
þ l
þ t
þ
þ B
þ a
þ s
þ e

þ d

þ r

þ u
þ m
þ  !
þ 0"
þ 7#
þ 3$
þ .%
þ w&
þ a'
þ v(
þ L
þ e
þ g
þ o
þ w
þ e
þ l
þ t
þ
þ B
þ a
þ s
þ e

þ d

þ r

þ u
þ m
þ  !
þ 0"
þ 5#
þ 6$
þ .%
þ w&
þ a'
þ v(
þ L
þ e
þ g
þ o
þ w
þ e
þ l
þ t
þ
þ B
þ a
þ s
þ e

þ d

þ r

þ u
þ m
þ  !
þ 0"
þ 5#
þ 8$
þ .%
þ w&
þ a'
þ v(
þ L  þ e  þ g  þ o  þ w  þ e  þ l  þ t  þ    þ B  þ a  þ s  þ e
 þ d
 þ r
 þ u  þ m  þ  ! þ 0" þ 9# þ 9$ þ .% þ w& þ a' þ v( þ L  þ e  þ g  þ o  þ w  þ e  þ l  þ t  þ    þ B  þ a  þ s  þ e
 þ d
 þ r
 þ u  þ m þ  ! þ 0" þ 3# þ 0$ þ .% þ w& þ a' þ v( þ L !þ e !þ g !þ o !þ w !þ e !þ l !þ t !þ   !þ B !þ a !þ s !þ e
!þ d
!þ r
!þ u !þ m !þ  !!þ 0"!þ 7#!þ 5$!þ .%!þ w&!þ a'!þ v(!þ L "þ e "þ g "þ o "þ w "þ e "þ l "þ t "þ   "þ B "þ a "þ s "þ e
"þ d
"þ r
"þ u "þ m "þ  !"þ 0""þ 3#"þ 9$"þ .%"þ w&"þ a'"þ v("þ k1kþ L # þ e # þ g # þ o # þ w # þ e # þ l # þ t # þ   # þ B # þ a # þ s # þ e
# þ d
# þ r
# þ u # þ m # þ  !# þ 0"# þ 4## þ 8$# þ .%# þ w&# þ a'# þ v(# þ ­­­þ L $þ e $þ g $þ o $þ w $þ e $þ l $þ t $þ   $þ B $þ a $þ s $þ e
$þ d
$þ r
$þ u $þ m $þ  !$þ 0"$þ 9#$þ 2$$þ .%$þ w&$þ a'$þ v($þ    þ   %þ   %þ   %þ   %þ   %þ   %þ   %þ   %þ   %þ   %þ   %þ   %þ   %þ
%þ
%þ
%þ   %þ  %þ  !%þ  "%þ  #%þ  $%þ  %%þ  &%þ  '%þ  (%þ  )%þ  *%þ  +%þ  ,%þ  -%þ  .%þ k1kþ [ & þ s & þ i & þ z & þ e & þ : & þ   & þ 1 & þ 4 & þ 1 & þ 4 & þ 2 & þ 8
& þ ]
& [INSTRUMENTVIEW] onFocus þ    þ ­­­þ I  þ n  þ s  þ t  þ r  þ u  þ m  þ e  þ n  þ t  þ    þ 1  þ 0  þ )î=þ [* þ C+ þ H, þ G- þ ]. þ k1kþ T   þ y   þ p   þ e   þ :   þ     þ S   þ A   þ M
  þ P
  þ L
  þ E   þ ­­­þ s  þ a  þ m  þ p  þ l  þ e  þ :  þ    þ L
 þ e
 þ g
 þ o  þ w  þ e! þ l" þ t# þ  $ þ B% þ a& þ s' þ e( þ d) þ r* þ u+ þ m, þ  - þ v  þ o  þ l  þ u  þ m  þ e  þ :  þ    þ 1
 þ 2
 þ 8
 þ    þ [  þ 8! þ 0" þ ]# þ p  þ a  þ n  þ :  þ    þ 7  þ F  þ r  þ o  þ o  þ t  þ    þ n  þ o  þ t  þ e
 þ :
 þ
 þ C  þ   þ  ! þ 3" þ d  þ e  þ t  þ u  þ n  þ e  þ :  þ    þ 7
 þ F
 þ d  þ r  þ i  þ v  þ e  þ :  þ    þ F  þ F
 þ c  þ r  þ u  þ s  þ h  þ :  þ    þ 1  þ 6
 þ d  þ o  þ w  þ n  þ s  þ a  þ m  þ p  þ l
 þ e
 þ :
 þ    þ 0  þ f  þ l  þ t  þ    þ c  þ u  þ t  þ /  þ r
 þ e
 þ s
 þ :  þ F! þ F" þ 0$ þ 0% þ t
þ y
þ p
þ e
þ :
þ
þ 0
þ 0
þ M
þ o
þ d
þ e
þ :
þ
þ o
þ r
þ i

þ g

þ i

þ n
þ a
þ l!
þ i  þ n  þ t  þ e  þ r  þ p  þ o  þ l  þ a
 þ t
 þ i
 þ o  þ n  þ :! þ  " þ l# þ i$ þ n% þ e& þ a' þ r( þ l  þ o  þ o  þ p  þ    þ m  þ o  þ d  þ e
 þ :
 þ
 þ n  þ o þ n! þ e" þ s !þ t !þ a !þ r !þ t !þ : !þ   !þ 0 !þ 0
!þ 0
!þ 0
!þ 0 !þ 0 !þ 0!!þ l "þ o "þ o "þ p "þ   "þ s "þ t "þ a "þ r
"þ t
"þ :
"þ   "þ 0 "þ 0!"þ 0""þ 0#"þ 0$"þ 0%"þ 0&"þ D #þ   #þ   #þ   #þ l #þ o #þ o #þ p #þ   #þ e #þ n #þ d #þ :
#þ
#þ 0
#þ 0 #þ 1 #þ 1!#þ 4"#þ 2##þ 4$#þ P $þ   $þ G $þ   $þ S %þ C %þ P %þ k1kþ I %þ ­­­þ a %þ u %þ t %þ o %þ m %þ a %þ t %þ i %þ o
%þ n
%þ :
%þ   %þ f %þ a!%þ l"%þ s#%þ e$%þ   &þ   &þ T &þ T &þ t &þ a &þ b &þ l &þ e &þ : &þ   &þ - &þ -
&þ    þ ­­­þ P  þ h  þ r  þ a  þ s  þ e  þ    þ 1  þ 0  þ I  þ 1  þ 0  þ :
 þ L
 þ e
 þ g  þ o  þ w! þ e" þ l# þ t$ þ  % þ B& þ a' þ s( þ e) þ d* þ r+ þ u, þ m- þ  . þ oþ 0  þ 0  þ ­­­þ F  þ    þ    þ 2  þ k1kþ I   þ 1   þ 0   þ ­­­þ -
 þ -
 þ -
 þ 0  þ 0! þ 0" þ 0# þ -% þ -& þ -' þ 0) þ 0* þ 0+ þ 0, þ oþ 0  þ 1  þ ­­­þ -  þ -  þ -  þ -  þ I  þ -  þ -  þ -
 þ -
 þ -
 þ 0  þ 0! þ 0" þ 0# þ -% þ -& þ -' þ 0) þ 0* þ 0+ þ 0, þ oþ 0  þ 2  þ ­­­þ -  þ -  þ -  þ -  þ I  þ -  þ -  þ -
 þ -
 þ -
 þ 0  þ 0! þ 0" þ 0# þ -% þ -& þ -' þ 0) þ 0* þ 0+ þ 0, þ oþ 0  þ 3  þ ­­­þ -  þ -  þ -  þ -  þ I  þ -  þ -  þ -
 þ -
 þ -
 þ 0  þ 0! þ 0" þ 0# þ -% þ -& þ -' þ 0) þ 0* þ 0+ þ 0, þ oþ 0  þ 4  þ ­­­þ -  þ -  þ -  þ -  þ I  þ -  þ -  þ -
 þ -
 þ -
 þ 0  þ 0! þ 0" þ 0# þ -% þ -& þ -' þ 0) þ 0* þ 0+ þ 0, þ oþ 0  þ 5  þ ­­­þ -  þ -  þ -  þ -  þ I  þ -  þ -  þ -
 þ -
 þ -
 þ 0  þ 0! þ 0" þ 0# þ -% þ -& þ -' þ 0) þ 0* þ 0+ þ 0, þ oþ 0  þ 6  þ ­­­þ -  þ -  þ -  þ -  þ I  þ -  þ -  þ -
 þ -
 þ -
 þ 0  þ 0! þ 0" þ 0# þ -% þ -& þ -' þ 0) þ 0* þ 0+ þ 0, þ oþ 0  þ 7  þ ­­­þ -  þ -  þ -  þ -  þ I  þ -  þ -  þ -
 þ -
 þ -
 þ 0  þ 0! þ 0" þ 0# þ -% þ -& þ -' þ 0) þ 0* þ 0+ þ 0, þ oþ 0  þ 8  þ ­­­þ -  þ -  þ -  þ -  þ I  þ -  þ -  þ -
 þ -
 þ -
 þ 0  þ 0! þ 0" þ 0# þ -% þ -& þ -' þ 0) þ 0* þ 0+ þ 0, þ oþ 0  þ 9  þ ­­­þ -  þ -  þ -  þ -  þ I  þ -  þ -  þ -
 þ -
 þ -
 þ 0  þ 0! þ 0" þ 0# þ -% þ -& þ -' þ 0) þ 0* þ 0+ þ 0, þ oþ 0
þ A
þ ­­­þ -
þ -
þ -
þ -
þ I
þ -
þ -
þ -

þ -

þ -

þ 0
þ 0!
þ 0"
þ 0#
þ -%
þ -&
þ -'
þ 0)
þ 0*
þ 0+
þ 0,
þ oþ 0
þ B
þ ­­­þ -
þ -
þ -
þ -
þ I
þ -
þ -
þ -

þ -

þ -

þ 0
þ 0!
þ 0"
þ 0#
þ -%
þ -&
þ -'
þ 0)
þ 0*
þ 0+
þ 0,
þ oþ 0
þ C
þ ­­­þ -
þ -
þ -
þ -
þ I
þ -
þ -
þ -

þ -

þ -

þ 0
þ 0!
þ 0"
þ 0#
þ -%
þ -&
þ -'
þ 0)
þ 0*
þ 0+
þ 0,
þ oþ 0  þ D  þ ­­­þ -  þ -  þ -  þ -  þ I  þ -  þ -  þ -
 þ -
 þ -
 þ 0  þ 0! þ 0" þ 0# þ -% þ -& þ -' þ 0) þ 0* þ 0+ þ 0, þ oþ 0  þ E  þ ­­­þ -  þ -  þ -  þ -  þ I  þ -  þ -  þ -
 þ -
 þ -
 þ 0 þ 0! þ 0" þ 0# þ -% þ -& þ -' þ 0) þ 0* þ 0+ þ 0, þ oþ 0 !þ F !þ ­­­þ - !þ - !þ - !þ - !þ I !þ - !þ - !þ -
!þ -
!þ -
!þ 0 !þ 0!!þ 0"!þ 0#!þ -%!þ -&!þ -'!þ 0)!þ 0*!þ 0+!þ 0,!þ D #þ   #þ   #þ   #þ P $þ   $þ G $þ   $þ oþ   $ þ   $ þ   $ þ   $ þ   $ þ   $ þ
$ þ
$ þ k1kþ  $ þ  !$ þ oþ  #$ þ  $$ þ  &$ þ  '$ þ  )$ þ  *$ þ ­­­þ S %þ C %þ k1kþ P %þ ­­­þ I %þ oþ   % þ   % þ   % þ   % þ   % þ   % þ
% þ
% þ k1kþ  % þ  !% þ oþ  #% þ  $% þ  &% þ  '% þ  )% þ  *% þ ­­­þ   &þ   &þ T &þ T &þ oþ   & þ   & þ   & þ   & þ   & þ   & þ
& þ
& þ k1kþ  & þ  !& þ oþ  #& þ  $& þ  && þ  '& þ  )& þ  *& þ ­­­þ    þ    þ    þ    þ    þ
 þ
 þ
 þ    þ   þ  ! þ  " þ  # þ  $ þ  % þ  & þ  ' þ  ( þ  ) þ )î=þ [* þ C+ þ H, þ G- þ ]. þ ­­­þ I  þ 1  þ 0  þ    þ    þ k1kþ I   þ -   þ -   þ ­­­þ I  þ -  þ -  þ k1kþ I   þ -   þ -   þ ­­­þ I  þ -  þ -  þ k1kþ I   þ -   þ -   þ ­­­þ I  þ -  þ -  þ k1kþ I   þ -   þ -   þ ­­­þ    þ    þ    þ ­­­þ I  þ -  þ -  þ k1kþ I   þ -   þ -   þ ­­­þ    þ    þ    þ ­­­þ I  þ -  þ -  þ k1kþ I   þ -   þ -   þ ­­­þ    þ    þ    þ ­­­þ I  þ -  þ -  þ k1kþ I   þ -   þ -   þ ­­­þ    þ    þ    þ k1kþ -   þ -   þ -   þ -   þ ­­­þ I  þ -  þ -  þ ­­­þ    þ    þ    þ ­­­þ -  þ -  þ -  þ -  þ k1kþ -   þ -   þ -   þ -   þ ­­­þ    þ ­­­þ I  þ 1  þ 0  þ :
 þ L
 þ e
 þ g  þ o  þ w! þ e" þ l# þ t$ þ  % þ B& þ a' þ s( þ e) þ d* þ r+ þ u, þ m- þ  . þ    þ k1kþ F   þ     þ     þ 2   þ ­­­þ 1  þ 0  þ )î=þ [* þ C+ þ H, þ G- þ ]. þ ­­­þ d* þ r+ þ u, þ m- þ  . þ    þ    þ    þ ­­­þ F  þ    þ    þ 2  þ k1kþ I   þ 1   þ 0   þ ­­­þ    þ ­­­þ    þ ­­­þ 1  þ N
 þ o
 þ n  þ e  þ    þ  ! þ  " þ  # þ  $ þ  % þ  & þ  ' þ  ( þ  ) þ )î=þ [* þ C+ þ H, þ G- þ ]. þ k1kþ 1   þ    þ    þ    þ k1kþ F   þ     þ     þ 2   þ ­­­þ I  þ 1  þ 1  þ ­­­þ    þ    þ    þ ­­­þ F  þ    þ    þ 2  þ k1kþ I   þ 1   þ 1   þ ­­­þ    þ    þ    þ k1kþ F   þ     þ     þ 2   þ ­­­þ I  þ 1  þ 1  þ ­­­þ    þ ­­­þ    þ k1kþ 3   þ k1kþ E   þ k1kþ D   þ #   þ k1kþ     þ k1kþ C   þ #   þ k1kþ     þ    þ    þ    þ    þ
 þ
 þ
 þ    þ   þ    þ    þ k1kþ -   þ -   þ -   þ -   þ ­­­þ C  þ    þ    þ 3  þ k1kþ -   þ -   þ -   þ -   þ ­­­þ -  þ -  þ -  þ -  þ k1kþ -   þ -   þ -   þ -   þ ­­­þ -  þ -  þ -  þ -  þ k1kþ -   þ -   þ -   þ -   þ ­­­þ -  þ -  þ -  þ -  þ k1kþ -   þ -   þ -   þ -   þ ­­­þ -  þ -  þ -  þ -  þ k1kþ -   þ -   þ -   þ -   þ ­­­þ -  þ -  þ -  þ -  þ k1kþ -   þ -   þ -   þ -   þ ­­­þ -  þ -  þ -  þ -  þ ­­­þ I  þ 1  þ 0  þ :
 þ L
 þ e
 þ g  þ o  þ w! þ e" þ l# þ t$ þ  % þ B& þ a' þ s( þ e) þ d* þ r+ þ u, þ m- þ  . þ k1kþ F   þ     þ     þ 2   þ ­­­þ -  þ -  þ -  þ -  þ ­­­þ    þ ­­­þ    þ k1kþ 3   þ )î=þ [* þ C+ þ H, þ G- þ ]. þ ­­­þ d* þ r+ þ u, þ m- þ  . þ k1kþ E   þ k1kþ D   þ #   þ k1kþ     þ k1kþ C   þ #   þ k1kþ     þ )î=þ [* þ C+ þ H, þ G- þ ]. þ    þ    þ    þ    þ
 þ
 þ
 þ    þ   þ  ! þ  " þ  # þ  $ þ  % þ  & þ  ' þ  ( þ  ) þ    þ ­­­þ C  þ    þ    þ 3  þ    þ    þ k1kþ -   þ -   þ -   þ -   þ ­­­þ -  þ -  þ -  þ -  þ k1kþ -   þ -   þ -   þ -   þ ­­­þ -  þ -  þ -  þ -  þ k1kþ -   þ -   þ -   þ -   þ ­­­þ -  þ -  þ -  þ -  þ k1kþ -   þ -   þ -   þ -   þ ­­­þ -  þ -  þ -  þ -  þ k1kþ -   þ -   þ -   þ -   þ ­­­þ -  þ -  þ -  þ -  þ k1kþ -   þ -   þ -   þ -   þ ­­­þ -  þ -  þ -  þ -  þ k1kþ -   þ -   þ -   þ -   þ ­­­þ I  þ 1  þ 1  þ :
 þ N
 þ o
 þ n  þ e  þ -  þ -  þ -  þ -  þ k1kþ C   þ     þ     þ 3   þ ­­­þ    þ    þ    þ ­­­þ C  þ    þ    þ 3  þ k1kþ I   þ 1   þ 1   þ ­­­þ    [INSTRUMENTVIEW] onFocus þ    þ ­­­þ I  þ n  þ s  þ t  þ r  þ u  þ m  þ e  þ n  þ t  þ    þ 1  þ 1  þ )î=þ [* þ C+ þ H, þ G- þ ]. þ k1kþ T   þ y   þ p   þ e   þ :   þ     þ N   þ O   þ N
  þ E
  þ ­­­þ D #þ   #þ   #þ   #þ P $þ   $þ G $þ   $þ S %þ C %þ P %þ k1kþ I %þ ­­­þ   &þ   &þ T &þ T &[-D-] INSTRUMENTVIEW [INSTRUMENTVIEW] UPDATE type:1 þ k1kþ S   þ A   þ M
  þ P
  þ L
  þ E   þ ­­­þ s  þ a  þ m  þ p  þ l  þ e  þ :  þ    þ (
 þ n
 þ u
 þ l  þ l  þ )! þ v  þ o  þ l  þ u  þ m  þ e  þ :  þ    þ 1
 þ 2
 þ 8
 þ    þ [  þ 8! þ 0" þ ]# þ p  þ a  þ n  þ :  þ    þ 7  þ F  þ r  þ o  þ o  þ t  þ    þ n  þ o  þ t  þ e
 þ :
 þ
 þ C  þ   þ  ! þ 3" þ d  þ e  þ t  þ u  þ n  þ e  þ :  þ    þ 7
 þ F
 þ d  þ r  þ i  þ v  þ e  þ :  þ    þ F  þ F
 þ c  þ r  þ u  þ s  þ h  þ :  þ    þ 1  þ 6
 þ d  þ o  þ w  þ n  þ s  þ a  þ m  þ p  þ l
 þ e
 þ :
 þ    þ 0  þ f  þ l  þ t  þ    þ c  þ u  þ t  þ /  þ r
 þ e
 þ s
 þ :  þ F! þ F" þ 0$ þ 0% þ t
þ y
þ p
þ e
þ :
þ
þ 0
þ 0
þ M
þ o
þ d
þ e
þ :
þ
þ o
þ r
þ i

þ g

þ i

þ n
þ a
þ l!
þ i  þ n  þ t  þ e  þ r  þ p  þ o  þ l  þ a
 þ t
 þ i
 þ o  þ n  þ :! þ  " þ l# þ i$ þ n% þ e& þ a' þ r( þ l  þ o  þ o  þ p  þ    þ m  þ o  þ d  þ e
 þ :
 þ
 þ n  þ o þ n! þ e" þ s !þ t !þ a !þ r !þ t !þ : !þ   !þ 0 !þ 0
!þ 0
!þ 0
!þ 0 !þ 0 !þ 0!!þ l "þ o "þ o "þ p "þ   "þ s "þ t "þ a "þ r
"þ t
"þ :
"þ   "þ 0 "þ 0!"þ 0""þ 0#"þ 0$"þ 0%"þ 0&"þ l #þ o #þ o #þ p #þ   #þ e #þ n #þ d #þ :
#þ
#þ 0
#þ 0 #þ 0 #þ 0!#þ 0"#þ 0##þ 0$#þ a %þ u %þ t %þ o %þ m %þ a %þ t %þ i %þ o
%þ n
%þ :
%þ   %þ f %þ a!%þ l"%þ s#%þ e$%þ t &þ a &þ b &þ l &þ e &þ : &þ   &þ - &þ -
&þ ­­­þ T  þ y  þ p  þ e  þ :  þ    þ S  þ A  þ M
 þ P
 þ L
 þ E  þ k1kþ s   þ a   þ m   þ p   þ l   þ e   þ :   þ     þ (
  þ n
  þ u
  þ l   þ l   þ )!  [PICOFILESYSTEM] chdir:/samples [PICOFILESYSTEM] new CWD:samples [PICOFILESYSTEM] LIST DIR:samples [PICOFILESYSTEM] FILTER: .=.wav [0] [PICOFILESYSTEM] skipped hidden: . [PICOFILESYSTEM] FILTER: ..=.wav [0] [PICOFILESYSTEM] [1] got file: .. [PICOFILESYSTEM] FILTER: legowelt drum wizardry sample pack=.wav [0] [PICOFILESYSTEM] [5] got file: legowelt drum wizardry sample pack [PICOFILESYSTEM] FILTER: legowelt-elektrovolt-rolandjv2080samplekit=.wav [0] [PICOFILESYSTEM] [10] got file: legowelt-elektrovolt-rolandjv2080samplekit [PICOFILESYSTEM] FILTER: legowelt kawai k4 samplepack=.wav [0] [PICOFILESYSTEM] [14] got file: legowelt kawai k4 samplepack [PICOFILESYSTEM] FILTER: legowelt_legowelt-jupiter-8-sample-pack_2024-01-14_1425=.wav [0] [PICOFILESYSTEM] [20] got file: legowelt_legowelt-jupiter-8-sample-pack_2024-01-14_1425 [PICOFILESYSTEM] FILTER: legoweltyamahapss795samplekit=.wav [0] [PICOFILESYSTEM] [24] got file: legoweltyamahapss795samplekit [PICOFILESYSTEM] FILTER: rolandjd800sampleslegowelt=.wav [0] [PICOFILESYSTEM] [27] got file: rolandjd800sampleslegowelt [PICOFILESYSTEM] FILTER: legowelt oberheim matrix 1000 sample pack=.wav [0] [PICOFILESYSTEM] [32] got file: legowelt oberheim matrix 1000 sample pack
[PICOFILESYSTEM] FILTER: legowelt quasimidi sirius sample pack=.wav [0] [PICOFILESYSTEM] [36] got file: legowelt quasimidi sirius sample pack [PICOFILESYSTEM] FILTER: legoweltyamahasy35samplekit=.wav [0] [PICOFILESYSTEM] [40] got file: legoweltyamahasy35samplekit [PICOFILESYSTEM] FILTER: legowelt minimoog sample pack=.wav [0] [PICOFILESYSTEM] [44] got file: legowelt minimoog sample pack [PICOFILESYSTEM] FILTER: legowelt drumnibus samplepack=.wav [0] [PICOFILESYSTEM] [48] got file: legowelt drumnibus samplepack [PICOFILESYSTEM] FILTER: legoweltemuvintageprosamplepack=.wav [0] [PICOFILESYSTEM] [52] got file: legoweltemuvintageprosamplepack [PICOFILESYSTEM] FILTER: legowelt_dx-files_samplepack=.wav [0] [PICOFILESYSTEM] [56] got file: legowelt_dx-files_samplepack [PICOFILESYSTEM] FILTER: drums=.wav [0] [PICOFILESYSTEM] [58] got file: drums [PICOFILESYSTEM] scanned: 15, added file indexes:15 þ    þ )î=þ I  þ m  þ p  þ o  þ r  þ t  þ    þ S  þ a  þ m  þ p  þ l  þ e
 þ [* þ C+ þ H, þ G- þ ]. þ k1kþ /   þ L   þ e   þ g   þ o   þ w   þ e   þ l   þ t   þ -   þ E   þ l   þ e
  þ k
  þ t
  þ r   þ o   þ v!  þ o"  þ l#  þ t$  þ -%  þ R&  þ o'  þ l(  þ a)  þ n*  þ d+  þ J,  þ V-  þ ­­­þ /  þ L  þ e  þ g  þ o  þ w  þ e  þ l  þ t  þ    þ K  þ a  þ w
 þ a
 þ i
 þ    þ K  þ 4! þ  " þ S# þ a$ þ m% þ p& þ l' þ e( þ P) þ a* þ c+ þ k, þ /  þ l  þ e  þ g  þ o  þ w  þ e  þ l  þ t  þ _  þ l  þ e  þ g
 þ o
 þ w
 þ e  þ l  þ t! þ -" þ j# þ u$ þ p% þ i& þ t' þ e( þ r) þ -* þ 8+ þ -, þ s- þ /  þ L  þ e  þ g  þ o  þ w  þ e  þ l  þ t  þ Y  þ a  þ m  þ a
 þ h
 þ a
 þ P  þ S  þ S! þ 7" þ 9# þ 5$ þ s% þ a& þ m' þ p( þ l) þ e* þ k+ þ i, þ t- þ /  þ R  þ o  þ l  þ a  þ n  þ d  þ J  þ D  þ 8  þ 0  þ 0  þ s
 þ a
 þ m
 þ p  þ l  þ e! þ s" þ L# þ e$ þ g% þ o& þ w' þ e( þ l) þ t* þ /  þ L  þ e  þ g  þ o  þ w  þ e  þ l  þ t  þ    þ O  þ b  þ e
 þ r
 þ h
 þ e  þ i  þ m! þ  " þ M# þ a$ þ t% þ r& þ i' þ x( þ  ) þ 1* þ 0+ þ 0, þ 0- þ /  þ L  þ e  þ g  þ o  þ w  þ e  þ l  þ t  þ    þ Q  þ u  þ a
 þ s
 þ i
 þ M  þ I  þ D! þ I" þ  # þ S$ þ I% þ R& þ I' þ U( þ S) þ  * þ S+ þ a, þ m- þ /  þ L  þ e  þ g  þ o  þ w  þ e  þ l  þ t  þ Y  þ a  þ m  þ a
 þ h
 þ a
 þ S  þ Y  þ 3! þ 5" þ s# þ a$ þ m% þ p& þ l' þ e( þ K) þ i* þ t+ þ /  þ L  þ e  þ g  þ o  þ w  þ e  þ l  þ t  þ    þ M  þ I  þ N
 þ I
 þ M
 þ O  þ O  þ G! þ  " þ s# þ a$ þ m% þ p& þ l' þ e( þ  ) þ p* þ a+ þ c, þ k- þ /  þ L  þ e  þ g  þ o  þ w  þ e  þ l  þ t  þ    þ D  þ r  þ u
 þ m
 þ n
 þ i  þ b  þ u! þ s" þ  # þ S$ þ a% þ m& þ p' þ l( þ e) þ p* þ a+ þ c, þ k- þ /  þ L  þ e  þ g  þ o  þ w  þ e  þ l  þ t  þ E  þ M  þ U  þ v
 þ i
 þ n
 þ t  þ a  þ g! þ e" þ P# þ r$ þ o% þ S& þ a' þ m( þ p) þ l* þ e+ þ P, þ a- þ /
þ L
þ e
þ g
þ o
þ w
þ e
þ l
þ t
þ _
þ D
þ X
þ -

þ F

þ I

þ L
þ E
þ S!
þ _"
þ S#
þ a$
þ m%
þ p&
þ l'
þ e(
þ P)
þ a*
þ c+
þ k,
þ /
þ D
þ r
þ u
þ m
þ s
þ k1kþ     þ D   þ r   þ u
  þ m
  þ
  þ W   þ i   þ z!  þ a"  þ r#  þ d$  þ r%  þ y&  þ  '  þ S(  þ m*  þ p+  þ l,  þ e-  þ ­­­þ -  þ E  þ l  þ e
 þ k
 þ t
 þ r  þ o  þ v! þ o" þ l# þ t$ þ -% þ R& þ o' þ l( þ a) þ n* þ d+ þ J, þ V- þ L  þ    þ K  þ a  þ w
 þ a
 þ i
 þ    þ K  þ 4! þ  " þ S# þ a$ þ m% þ p& þ l' þ P) þ a* þ c+ þ k, þ    þ  - þ ­­­þ l  þ _  þ l  þ e  þ g
 þ o
 þ w
 þ e  þ l  þ t! þ -" þ j# þ u$ þ p% þ i& þ t' þ e( þ r) þ -* þ 8+ þ -, þ s- þ L  þ e  þ g  þ o  þ w  þ e  þ l  þ t  þ Y  þ a  þ m  þ a
 þ h
 þ a
 þ P  þ S  þ S! þ 7" þ 9# þ 5$ þ s% þ a& þ m' þ p( þ e* þ k+ þ i, þ t- þ R  þ o  þ l  þ a  þ n  þ d  þ J  þ D  þ 8  þ 0  þ 0  þ s
 þ a
 þ m
 þ p  þ l  þ e! þ s" þ L# þ e$ þ g% þ o& þ w' þ e( þ l) þ t* þ    þ  + þ  , þ  - þ ­­­þ O  þ b  þ e
 þ r
 þ h
 þ e  þ i  þ m! þ  " þ M# þ a$ þ t% þ r& þ i' þ x( þ  ) þ 1* þ 0+ þ 0, þ 0- þ    þ Q  þ u  þ s
 þ i
 þ M  þ I  þ D! þ I" þ  # þ S$ þ I% þ R& þ I' þ U( þ S) þ  * þ S+ þ a, þ m- þ Y  þ a  þ m  þ a
 þ h
 þ a
 þ S  þ Y  þ 3! þ 5" þ K) þ i* þ t+ þ    þ  , þ  - þ ­­­þ M  þ I  þ N
 þ I
 þ M
 þ O  þ O  þ G! þ  " þ s# þ a$ þ m% þ p& þ l' þ e( þ  ) þ    þ D  þ r  þ u
 þ m
 þ i  þ b  þ u! þ s" þ  # þ S$ þ a% þ m& þ p' þ l( þ e) þ p* þ a+ þ c, þ k- þ E
þ M
þ U
þ v

þ i

þ n

þ t
þ a
þ g!
þ e"
þ P#
þ r$
þ o%
þ S&
þ a'
þ m(
þ p)
þ l*
þ e+
þ P,
þ a-
þ L
þ e
þ g
þ o
þ w
þ e
þ l
þ t
þ _
þ D
þ X
þ -

þ F

þ I

þ L
þ E
þ S!
þ _"
þ S#
þ a$
þ m%
þ p&
þ l'
þ e(
þ P)
þ a*
þ c+
þ k,
þ /
þ D
þ r
þ u
þ m
þ s
[PICOFILESYSTEM] chdir:Legowelt Drum Wizardry Sample Pack [PICOFILESYSTEM] new CWD:Legowelt Drum Wizardry Sample Pack [PICOFILESYSTEM] LIST DIR:Legowelt Drum Wizardry Sample Pack [PICOFILESYSTEM] FILTER: .=.wav [0]
[PICOFILESYSTEM] skipped hidden: . [PICOFILESYSTEM] FILTER: ..=.wav [0] [PICOFILESYSTEM] [1] got file: .. [PICOFILESYSTEM] FILTER: synth percussion=.wav [0] [PICOFILESYSTEM] [4] got file: synth percussion [PICOFILESYSTEM] FILTER: basedrums=.wav [0] [PICOFILESYSTEM] [6] got file: basedrums [PICOFILESYSTEM] FILTER: drum wizardry artwork.jpg=.wav [0] [PICOFILESYSTEM] skipped hidden: drum wizardry artwork.jpg [PICOFILESYSTEM] FILTER: claps=.wav [0] [PICOFILESYSTEM] [10] got file: claps [PICOFILESYSTEM] FILTER: hihats=.wav [0] [PICOFILESYSTEM] [11] got file: hihats [PICOFILESYSTEM] FILTER: legowelt drum wizardry sample pack demo.mp3=.wav [0] [PICOFILESYSTEM] skipped hidden: legowelt drum wizardry sample pack demo.mp3 [PICOFILESYSTEM] FILTER: drum wizardry info.txt=.wav [0] [PICOFILESYSTEM] skipped hidden: drum wizardry info.txt [PICOFILESYSTEM] FILTER: snaredrums=.wav [0] [PICOFILESYSTEM] [21] got file: snaredrums [PICOFILESYSTEM] FILTER: __macosx=.wav [0] [PICOFILESYSTEM] [22] got file: __macosx [PICOFILESYSTEM] scanned: 7, added file indexes:7 þ k1kþ .   þ .   þ    þ    þ    þ    þ    þ    þ    þ    þ    þ    þ
 þ
 þ
 þ    þ   þ  ! þ  " þ  # þ  $ þ  % þ  & þ  ' þ  ( þ  ) þ  * þ  + þ  , þ  - þ ­­­þ S  þ Y  þ N  þ T  þ H  þ    þ P  þ E  þ R  þ C  þ U  þ S
 þ S
 þ I
 þ O  þ N  þ    þ  ! þ  " þ  # þ  $ þ  % þ  & þ  ' þ  ( þ  ) þ  * þ  + þ  , þ  - þ ­­­þ B  þ A  þ S  þ E  þ D  þ R  þ U  þ M  þ S  þ    þ    þ    þ
 þ
 þ
 þ    þ   þ  ! þ  " þ  # þ  $ þ  % þ  & þ  ' þ  ( þ  ) þ  * þ  + þ  , þ ­­­þ C  þ L  þ A  þ P  þ S  þ    þ    þ    þ    þ    þ    þ    þ
 þ
 þ
 þ    þ   þ  ! þ  " þ  # þ  $ þ  % þ  & þ  ' þ  ( þ  ) þ  * þ  + þ  , þ  - þ ­­­þ H  þ I  þ H  þ A  þ T  þ S  þ    þ    þ    þ    þ    þ    þ
 þ
 þ
 þ    þ   þ  ! þ  " þ  # þ  $ þ  % þ  & þ  ' þ  ( þ  ) þ  * þ  + þ  , þ  - þ ­­­þ S  þ N  þ A  þ R  þ E  þ D  þ R  þ U  þ M  þ S  þ    þ    þ
 þ
 þ
 þ    þ   þ  ! þ  " þ  # þ  $ þ  % þ  & þ  ' þ  ( þ  ) þ  * þ ­­­þ _  þ _  þ M  þ A  þ C  þ O  þ S  þ X  þ    þ    þ    þ    þ
 þ
 þ
 þ    þ   þ  ! þ  " þ  # þ  $ þ  % þ  & þ  ' þ  ( þ  ) þ  * þ  + þ  , þ  - þ    þ    þ    þ    þ    þ    þ    þ    þ    þ    þ    þ    þ
 þ
 þ
 þ    þ   þ  ! þ  " þ  # þ  $ þ  % þ  & þ  ' þ  ( þ  ) þ  * þ  + þ  , þ  - þ    þ    þ    þ    þ    þ    þ    þ    þ    þ    þ    þ    þ
 þ
 þ
 þ    þ   þ  ! þ  " þ  # þ  $ þ  % þ  & þ  ' þ  ( þ  ) þ  * þ  + þ    þ    þ    þ    þ    þ    þ    þ    þ    þ    þ    þ    þ
 þ
 þ
 þ    þ   þ  ! þ  " þ  # þ  $ þ  % þ  & þ  ' þ  ( þ  ) þ  * þ  + þ  , þ  - þ    þ    þ    þ    þ    þ    þ    þ    þ    þ    þ    þ    þ
 þ
 þ
 þ    þ   þ  ! þ  " þ  # þ  $ þ  % þ  & þ  ' þ  ( þ  ) þ  * þ  + þ  , þ  - þ
þ
þ
þ
þ
þ
þ
þ
þ
þ
þ
þ
þ

þ

þ

þ
þ
þ  !
þ  "
þ  #
þ  $
þ  %
þ  &
þ  '
þ  (
þ  )
þ  *
þ  +
þ  ,
þ  -
þ
þ
þ
þ
þ
þ
þ
þ
þ
þ
þ
þ
þ

þ

þ

þ
þ
þ  !
þ  "
þ  #
þ  $
þ  %
þ  &
þ  '
þ  (
þ  )
þ  *
þ  +
þ  ,
þ
þ
þ
þ
þ
þ
þ ­­­þ /  þ .  þ .  þ k1kþ /   þ S   þ Y   þ N   þ
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

Thread 333 (2025-01-18):

When creating a new project, unable to select samples if still on .untitled

wynwynyn, 2025-01-18:
v2.0beta7

Steps to reproduce:
1. Open a new project
2. Create a phrase and add a new SAMPLE instrument type
3. Browse and try and load a sample

Desired outcome:
Bit of a tricky one probably, but it would be cool to be able to proceed with samples in a project even still on .untitled, without having to give it a name right away. If you open a new project again with samples already in the .untitled project, maybe they could be purged before the next new project is opened.

maks, 2025-01-19:
Apologies this is exactly the usecase that should be working and I thought I had fixed specifically in Beta7!
I'll look into it and try to get this fixed asap.

maks, 2025-02-03:
@wynwynyn  I just tested this and I am able to successfully load a sample per the steps you listed.
Do be aware that there is a related issue #350  that is affecting beta7 where if you add samples they wont be copied across into the new project once you do name and save it, but I can't specifically reproduce not being able to add samples into the `untitled` project in beta7.

Could you please double check the behaviour you use in beta7?

wynwynyn, 2025-02-03:
@maks thought I'd record a video as it's easier than explaining - sorry for the bad quality though...

First project is loading the sample in without issue to an existing (named) project. Second part is attempting to load the same sample, and others, into a `.untitled` project.

[sampleload vid](https://www.youtube.com/watch?v=fCm85YGxlGc)

maks, 2025-02-04:
@wynwynyn Thanks for making a video but unfortunately I can't view it, it says its private.

wynwynyn, 2025-02-04:
@maks apologies, it should be viewable now!

maks, 2025-02-04:
Sorry I'm a bit confused as to what that video is showing, I assume the behaviour that you are demonstrating is in the last 10sec of the video where if you _rapidly and repeatedly_ press the import sample keycombo it fails?

wynwynyn, 2025-02-04:
@maks from the 0:47-ish mark I am opening a new project, then going straight to adding a phrase/etc, and a new sampler instrument. I am unable to load any samples while the project is nameless (`.untitled`). Is this the correct behaviour?

If I go back and give the project a name, and save, I am then able to load in samples.

maks, 2025-02-04:
Ah I see. Thanks for explaining that.
No that should not be the case, as of beta7 you should be able to import samples even into the `.untitled` project.
I'll investigate whats going wrong here.

wynwynyn, 2025-02-04:
Excellent, thank you!! :)

maks, 2025-02-12:
@wynwynyn  I'm not able to replicate this as of beta8a so I'm going to close this issue, but do please reopen it if you find this is still happening for you with beta8a.

wynwynyn, 2025-02-12:
@maks it is still happening in beta8a for me, but let's leave it closed for now as it isn't at all critical!

maks, 2025-02-13:
@wynwynyn As its still happening, I've reopened the issue so we can investigate further.
Could you confirm its happening with a new project that you created *after* you installed beta8a ?
If so I'm quite confused then as to why I don't see it here.

maks, 2025-02-13:
thanks @wynwynyn yes thats the exact set of steps I'm following and it was working for me until I tried with a fresh sdcard and now I can reproduce this so it seems to be due to a bug in recreating the `untitled` project.

Now that I can reproduce this myself, I should have a fix for this soon.

Closed 2025-02-17.

Thread 335 (2025-01-19):

Sample preview plays at different volume to master volume

wynwynyn, 2025-01-19:
v2.0beta7

It seems that changing the project master volume does not affect the auditioning of samples. This is problematic due to the fact that a user could be running a project at master volume `10`, and then get blasted by a loud sample by previewing it.

Steps to reproduce:
1. Open any project
2. Change the project master volume to `10` (or anything other than the default `100`)
3. Create a new `SAMPLE` instrument and enter the sample browser
4. Hit play on any sample to audition it

Closed 2025-02-07.

Thread 336 (2025-01-19):

Double inputs while holding keys

wynwynyn, 2025-01-19:
There are some strange behaviours when holding some key combinations, in relation to the direction keys. Probably more of a UX improvement as getting faster at using the pT and using the directional keys quicker, slightly holding one key down and pressing another direction can cause erratic cursor actions.

All of the scenarios can be reproduced on the `song` screen, but same concepts apply to other screens too:

- Hold the `left` key and press `up` or `down`
- Hold the `play` key and repeatedly press `left` or `right`
- Press things like `right`+`down` at the same time

maks, 2025-02-03:
@wynwynyn  is this just a consequence of low values for repeat and delay that are currently hardcoded values, as per #337 ?

wynwynyn, 2025-02-03:
@maks here's a video to demonstrate the issue a bit clearer:

[vid](https://www.youtube.com/watch?v=_nDHXIKr7_o)

It's not really a problem as hitting two directions at the same time isn't required. The issue is when two are accidentally pressed at the same time, and the cursor flies to a completely different place. Also causes navigational issues if two directions are pressed at the same time by mistake while holding the nav button.

maks, 2025-02-04:
@wynwynyn Thanks for making a video but unfortunately I can't view it, it says its private.

wynwynyn, 2025-02-04:
@maks apologies, it should be viewable now!

Float-pixel, 2025-02-07:
Fwiw, this behavior is present in regular piggy tracker. I used to experience it all the time with my powkiddy v90 due to how easy accidental diagonals are on it.

Thread 337 (2025-01-19):

Increase key debounce time

wynwynyn, 2025-01-19:
I've experienced quite a lot of double inputs. Not sure if the low profile Cherry switches I got are knock-offs or not, but even so, the debounce time may be slightly too low if this is happening at all.

wynwynyn, 2025-02-03:
@maks just to clarify, I'm getting double inputs when tapping the keys at the same rate, at random times:
[video of issue](https://www.youtube.com/watch?v=ZrGG3fqjKvM)

maks, 2025-02-04:
@wynwynyn Thanks for making a video but unfortunately I can't view it, it says its private.

wynwynyn, 2025-02-04:
@maks apologies, it should be viewable now!

Float-pixel, 2025-02-07:
Having the same issue, especially with the down key. A hard tap all the way to key bottom out results in a double input, but a very light tap that barely actuates the key results in a single input.

Float-pixel, 2025-02-10:
I have been noticing this more. It is really apparent in menus that only have 2 choices, I'll hit right/left and the cursor will end up back where I started because of a double navigate.

I have to wonder if this is an issue with keyswitches or if it is a legitimate bug. Right now it makes using the tracker very frustrating though.

Float-pixel, 2025-02-24:
I'm not sure this bug has to do with key delay and key repeat, its more like a double input, it happens instantly for me upon hitting a key. If I hold the key, the delay and repeat still kick in, but that initial input is the main issue.

The question is, is this actually an issue with the keyboards double inputting, which needs debounce/filtering to fix, or is it a software issue and the keyboards are behaving as expected.

maks, 2025-04-23:
This was done in #481 and #497

Closed 2025-04-23.

Thread 339 (2025-01-21):

SDCard Missing Red Flushing when power on

advancedlogic, 2025-01-21:
PicoTracker 2.0, just assembled.

I am using a regular SanDisk Ultra 16GB FAT and picoTracker_st7789.uf2

democloid, 2025-01-22:
@advancedlogic we find that this generally this means an SD card that cannot work at the frequencies that picoTracker uses. Have you tried different SD cards?

I'm attaching a specially compiled image that works at slower frequency to check if this is the issue, if it works with it, it should probably work with another SD card. Otherwise it might be another problem.

[picoTracker-slowSDIO.uf2.zip](https://github.com/user-attachments/files/18509133/picoTracker-slowSDIO.uf2.zip)

advancedlogic, 2025-01-24:
Unfortunately it doesn't work. What SD Card you suggest?

maks, 2025-01-27:
Hi, Could you please confirm which firmware version you have installed on the picoTracker?

Also could you please check what files or directories currently exist on the sdcard, including any "hidden" files that are prefixed with a period (".")

Finally could you let us know if the card is factory formatted or if you have previously reformatted it yourself?

advancedlogic, 2025-02-02:
I was able to make it work. Wrong SD Card apparently. Everything works with the last beta.
Thanks for your support.
I am closing the issue

maks, 2025-02-02:
@advancedlogic for future reference, would you be able to let us know what card did work for you and model number of the Sandisk Ultra card that didnt work?

Closed 2025-02-02.

Thread 342 (2025-01-27):

Add the ability to be able to remove individual samples

wynwynyn, 2025-01-27:
Currently the only way to remove samples is to use the `Compact Instruments` function. It would be great if you could remove samples from the instrument screen.

A way to do this is could be on the `SAMPLE` instrument screen, having the `sample: sample_file.wav` row selected, and holding B then pressing A to remove the sample and revert it back to `(null)` - similar to how other values are deleted, such as notes.

maks, 2025-01-28:
@wynwynyn I'm not sure I understand the use case for this, in what situation would you want to delete a specific unused sample file from a project rather than all unused sample files? Also I don't the suggested UX works as this setting back to `null` implies just unassociating the sample from the current instrument and it may well be used in other instruments.

wynwynyn, 2025-01-29:
@maks I agree, the UX would be a bit difficult to get right on this. I think the use case is more for replacing samples, rather than completely deleting them. It's just a bit of a hassle having to keep going back to the `Compact Instruments` option every time to replace a sample, such as a kick drum.

We also have the situation where we may have finished an entire track, used up all 16 sample slots, but realise that a certain sample (let's say the kick drum for this example) isn't quite right, and a different sample would be more suitable. We're unable to load in another kick sample because of the 16 limit being reached, and also we cannot use `Compact Instruments` because the kick sample is being used throughout the entire project. The only way to replace it would be to delete every phrase that uses that kick drum, so it's not technically in use anymore, and then purge unused samples.

Maybe a new key combination could be used to replace the selected sample, rather than loading in a new one? It'd still bring up the same file browser screen to browse and select a replacement sample. I would expect this to replace the sample completely too, so would affect any other instrument that is using it.

Any thoughts on this?

maks, 2025-01-30:
@wynwynyn  thanks for the detailed explanation, those use cases make it clearer what you have in mind for this functionality  and I can see the need for it 👍🏻

From your description, I think that while it could be useful to remove individual sample files from a project, the main need for this comes from the current restriction on 16 sample limit in a project but given the changes in how instrument slots work in v2 of the firmware, there is actually no need for that limit anymore. There is a limit of 16 sample *instruments* still but there doesn't need to be a limit on the number of sample files that are inside a project.

If that limit was removed, would that cover the use cases you've mentioned here?

wynwynyn, 2025-01-30:
@maks I think that's a great idea! If the 16-sample limit could be removed (or increased) that would pretty much solve this issue. It would actually be better too, because it would enable the user to load in multiple samples, and switch through them while the track is playing to get a feel for what they sound like in the full track. :)

Thanks for helping on this idea! Do you want me to create a separate issue, or shall we just rename this one?

maks, 2025-01-30:
@wynwynyn all good. I've created #349 to remove the 16 file limit and I'll close this issue in favour of that one.

Closed 2025-01-30.

Thread 343 (2025-01-27):

Add the ability to delete projects

wynwynyn, 2025-01-27:
The only way to remove projects currently is by mounting the SD card in another system. It would be nice to be able to delete projects entirely from the picoTracker - maybe on the load screen, have an option to delete a project. Also, probably best to add a `Confirm delete [yes/no]` before deletion!

maks, 2025-01-28:
We would need to define a key combo for deleting a selected project when in the project browser screen, perhaps `ALT`+`EDIT` ?

wynwynyn, 2025-01-29:
Yep, I think that'd work nicely :)

Thread 344 (2025-01-27):

Add loop preview to sample audition

wynwynyn, 2025-01-27:
It is hard to determine what some samples will sound like looped - this really only applies to wavetable samples.

This could be on the sample load screen. Pressing `START` already auditions a sample. Maybe holding the `START` button for something like 1 second the audition will play looped, so it being a wavetable sample, will play the actual sound of the waveform.

maks, 2025-01-29:
@wynwynyn  #271 already exists for this functionality for single cycle wav files so I'll mark this as a duplicate and lets continue discussion on the best user interface for implementing this over there.

wynwynyn, 2025-01-29:
Cheers! Must have missed that issue!

Closed 2025-01-29.

Thread 345 (2025-01-29):

Cloning Behavior

talktopag, 2025-01-29:
Cloning with ALT+(EDIT,ENTER) overwrites the current highlighted item with a copy of itself using the next unused item available. This may be a lower number than the current pattern.

On LSDJ, cloning seemingly overwrites the current highlighted item with a copy of itself using the next unused item available **with a pattern number greater than the highlighed item**.

For those who assign a block of patterns (e.g. 10 - 30, channel 1, 31 - 50, channel 2 etc.) this behaviour can be helpful for organisation.

I'm interested whether other pT users find this useful? Or whether it should be default behaviour or a toggle?

maks, 2025-01-30:
Thanks for opening this issue.

At first glance this sounds like a reasonable change to make and I do know that a number of people use this sort of numbering scheme to organise chains per channel.

I'll wait a bit to hear if anyone else has opinions on this but otherwise it should be possible to implement.

Thread 346 (2025-01-29):

Generative sequences possible ? Desired feature

jamesusmusic, 2025-01-29:
I was encouraged on the discord to make a post here. I plan to order my PCB this month. I’m very intrested if it would be possible to add generative features to the sequencer? Like pattern randomisation and generation. or even possibly evolving randomisation chance during playback. my dreamed of function would probably involve pattern generation and mutation. I am aware there are GitHub projects out there for devs to implement this in to builds. You will have to forgive my complete lack of coding mathematics or technical knowledge I'm a sound designer / musician intrested in interacting with generative sequences & randomness.
Being able to generate  a new random patterns or having the ability to mutate existing patterns with a degree of randomness can add so much life and exploration and the unexpected in to a workflow. In what ever form it would be possible is this something that could potentially be implemented in the future?

https://github.com/generative-music

Thanks for reading. Really love the project and looking forward to building mine

James

maks, 2025-01-30:
@jamesusmusic Thanks for opening this issue!
I'm interested in the picoTracker having this sort of functionality. The issues for chance and random fx #133 and #38 are a starting point for generative music capabilities for the picoTracker.  I think we could also have functionality to generate phrases filled with randomised  combinations of notes/instruments as well. I'll keep this issue open for now in case others have thoughts on other functionality of features that may fit in this topic and then can create other issues to implement specific pieces of functionality.

Thread 349 (2025-01-30):

Remove limit of 16 sample files per project

maks, 2025-01-30:
The current limit of 16 sample files per project is not necessary as while there is a limit of 16 sampler instruments per project, there is no need to limit the number of sample files to 16 as well.

One thing to be aware of here is that currently all samples in a project are loaded into flash on project load or when they are imported into the currently open project. Instead they should only be loaded into flash at the point where a sample is assigned to a sampler instrument.

Removing the limit should address the issues raised in #342 .

Thread 350 (2025-01-30):

instruments lose association to samples/instrument settings

rcarmo, 2025-01-30:
On 2.0beta7 (which is the first version I've tried) I can save projects but the instruments lose the association with samples and instrument types and parameters, so when I reload the project the samples are loaded, but all the instrument types are set to None (I initially thought this was only happening with sample instruments, but I just tried it with SID and Opal and the instruments vanish as well).

If it helps, I'm not creating my instruments sequentially. I'm using the following pattern:

Track 1 gets Chains 10->1F, which inside them get Phrases 10-1F, and instruments inside those phrases are also 10, 11, etc.

Track 2 -> Chain 20 -> Phrase 20 -> Instrument 20, etc.

maks, 2025-01-31:
Thank you for reporting this! Can confirm I can reproduce this bug. We'll try to get a fix out for this asap.

maks, 2025-01-31:
After some more testing, this turns out to only be an issue that specifically occurs if you import samples into a new `.untitled` project before then naming and saving it as a named project.

@rcarmo could you confirm the above is the case for you too or if you have seen this happen on already named projects when adding a sample?

maks, 2025-01-31:
Actually investigating this further, I can see the root cause is that when _any_ project is renamed, the new project directory and project data (`lgptsav.dat`) are saved to disk but any sample files are *not* also copied across into the new project directory.

goose2000, 2025-02-01:
Related? Not sure:

Created a new project and have been trying to load sample instruments. Although I can see on the SD, the sample files are being moved into my project /sample directory, it is impossible to set them as instruments. I can not select any of the,. Always NULL.

All the samples are .wav - 44.1 and mono, under a MB.
Latest v2.0 Beta 7

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

rcarmo, 2025-02-01:
> After some more testing, this turns out to only be an issue that specifically occurs if you import samples into a new `.untitled` project before then naming and saving it as a named project.
>
> @rcarmo could you confirm the above is the case for you too or if you have seen this happen on already named projects when adding a sample?

My project already has a name. And another project (also named) without any sample instruments has the same issue after rebooting and going back to it.

goose2000, 2025-02-01:
@rcarmo  - Do you go through the sample import menu `enter` + `enter` to bring samples to your song? Or, do you just copy them to your project's /samples directory?

Also this:
https://github.com/xiphonics/picoTracker/issues/355

rcarmo, 2025-02-01:
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

I just used the menus. Copied some samples across from my m8 headless to the top-level samples folder, never put the SD card back in a computer.

maks, 2025-02-03:
@rcarmo  re:
>Also, going back to the same project after a cold start, re-adding the samples and saving still has the same issue. Whenever I load the project things are gone (instruments only).

I am not able to reproduce this. If I do the following:
1. create a new project
2. give it a name and save
3. create a new chain, phrase, add a note, select sample instrument type, browse & import a new sample
4. save the project
5. power off the pT
6. power on the pT
7. I can see the sample I imported previously is still correctly assigned to instrument0 and the porject plays back as expected

I can confirm that I have found the issue where when you do effectively as "save as" operation (change name of current project and save) the samples in the current project are **not** copied across to the newly created project. I'm working on a fix for that right now.

maks, 2025-02-03:
@goose2000 What you are reporting is not this issue. Could I please ask you to open a new issue describing the problem you are seeing and we can take it from there.

rcarmo, 2025-02-05:
Hi there! Can we reopen this? I've just installed the 8A r_365 build and it is still happening

maks, 2025-02-05:
@rcarmo could you please be a bit more specific about what is still happening? Is this with a newly created project using beta8A because I've just tested with Beta8A and I see samples being correctly associated with instruments both across project saves and project renames.

With hangs due to changing instrument types, could you please open a separate issue for that.

Closed 2025-02-04.

Thread 355 (2025-02-01):

Next unused instrument (ENTER, ENTER) forgets used instruments after power cycle.

talktopag, 2025-02-01:
On 2.0 Beta 7:

On a new project `ENTER`, `ENTER` will insert next free instrument.  If I01, I02 and I03 are assigned then selecting I00 then `ENTER`, `ENTER` will select the next highest instrument I04. This works as expected.

After saving and a power cycle, then `ENTER`, `ENTER` on I00 will select I01, clearing the instrument paramters for I01.

Reloading the project after a power cycle does not prevent this behaviour.

Thread 360 (2025-02-04):

Sample Import Issues Beta 8

talktopag, 2025-02-04:
I am having sample import Issues with Beta 8. I start a new project, name it, save it and start a new sample instrument, but struggle to get samples to import. The screen blinks, with the loading dialogue very briefly there, then crashes after a few attempts.

I had some success with an existing project from beta 7, but only one sample, then the same behaviour.

My SD card is a SanDisk Ultra 32gb. It was a bit unhappy with a previous beta (which my PCB shipped with) but fine with beta 7. Let me know if you need any more info. Thanks!

talktopag, 2025-02-04:
Should add that samples preview fine in the browser.

maks, 2025-02-04:
@talktopag thanks for filling this issue.
Are you able to upload one or more of the samples that are not importing?

talktopag, 2025-02-04:
[Problematic Samples.zip](https://github.com/user-attachments/files/18663671/Problematic.Samples.zip) Here are two that gave me trouble. They preview OK, but don't import. I double checked the project directory, they defo did not import.

maks, 2025-02-05:
Ok I have a fix for this in #361 so the fix should go out in the next beta release which I will try to get out shortly.

maks, 2025-02-05:
@talktopag thanks again for reporting this issue 👍🏻  The fix will be in the next beta release (8A) that will go out shortly.

talktopag, 2025-02-05:
Much appreciated you looking into it so quickly. Thank you! 😀

Closed 2025-02-05.

Thread 362 (2025-02-05):

SID instruments not gated when restarting play

talktopag, 2025-02-05:
I've attached a project:

- Channel 2 is playing a C note on OSC 0 of SID, assigned instrument 1.
- Channel 3 is playing a G note on OSC 1 of SID, assigned instrument 2.
- Either channel is playing on or off the beat, alternating with GOFs.

Depending when playback of the song stops, if playing a phrase channel 2 or 3, then you can hear the other OSC ringing out. I assume this is because the GOF hasn't triggered before playback has stopped. Should all OSCs on the SID be globally reset prior to playback?

[sid_example.zip](https://github.com/user-attachments/files/18678422/sid_example.zip)

maks, 2025-02-05:
Thanks for filing this issue!

I'm not I completely understand though, especially this part:
> I assume this is because the GOF hasn't triggered before playback has stopped

The SID is a single "chip" but each instrument is assigned to controlling one of its oscillators hence the gate should be per osc, so each will keep ringing out independent of what happens on the other osc.

Does the above match what you were ask or have I missed the crux of the issue?

maks, 2025-02-06:
@talktopag thanks for the extra detailed explanation 👍🏻
I have to admit I'm not 100% sure still I fully understand, but it should only be the case that an instrument can be heard when you are on the song screen when the channel its in is audible, but if you don't want that you can individually solo/mute tracks on the song screen, though this was missing from the docs until I just updated them today: https://manual.xiphonics.com/songs.html#solo-and-mute

If the above is the case, you may also find useful the `Live` mode and its functions, also again sorry the docs for it were missing from the user manual until I updated it earlier today: https://manual.xiphonics.com/songs.html#live-mode

If the above is not what you are after please let me know and I can look into this some more.

talktopag, 2025-02-06:
Thanks @maks

Because of the above, it's not always that it's "only the case that an instrument can be heard when you are on the song screen when the channel its in is audible" - you can get sustained notes from another instrument because the way the emulated SID works.

I'll give the mute functions a shot, see if I can find a workaround for this within my own workflow. Perhaps others will comment on this too. Much appreciated your prompt reply.

maks, 2025-02-06:
@talktopag please let me know here how you get on. I'll keep this issue open for now and mark it as waiting for your further feedback.

talktopag, 2025-02-07:
Thanks @maks, I will do. I'm looking forward to an extended jam over the weekend. Thanks to you and the dev team for your awesome work on this project.

talktopag, 2025-02-08:
@maks I've found that `NAV` + `PLAY` within a phrase allows me to work around the other SID voices sticking on their sustain phase. This combo seems to progress all channels in the song at the point of the chain/phrase selected, which triggers the gates at the right places, sending the other channels to their release phases.

That said, I had a look in the manual for `NAV` + `PLAY` within a phrase, and couldn't see that documented, although I'm maybe being clumsy! I can raise an issue for this if you like over on the manual page?

In the meantime, close this issue for now? Thanks for listening!

I got really into using picoTracker last night. Super fun to use!

maks, 2025-02-08:
@talktopag thanks for reporting that omission, yes do please open an issue for that as I want to keep improving the user manual.
From memory I think NAV+PLAY in phrase screen is supposed to start play back if the entire song while just PLAY in phrase screen of course only plays current phrase on a loop.

And very happy to hear that you enjoy using the picoTracker! ♥️ If you post any music you make with the pT online please do share it in discord #music channel.

maks, 2025-02-27:
I think this has now been resolved.

Closed 2025-02-27.

Thread 368 (2025-02-07):

tracks losing instrument data

Float-pixel, 2025-02-07:
Currently on version 8a. As title says, one of my projects seems to only be able to remember one instrument, every time I leave that project and come back, it forgets them all again. The patterns are fine. The affected instruments are set to "none".

I also am getting freezes and crashes pretty frequently in general (every 5-30 minutes, certain things make it more likely to crash) but that is likely another issue.

maks, 2025-02-07:
@Float-pixel thanks for reporting this issue. Would you be able to give a short series of steps that consistently replicate the issue of instruments not being saved? ideally starting with a new `untitled`  project.

With the freezes and crashes, could you please open another issue for that and if possible describe in the new issue the  steps to reproduce and also what happens when it freezes or crashes (eg. does the screen stop updateing, does it stay black, does playing audio stop or continue, does trying to navigate to a different screen cause anything to happen, etc), thanks! 🙏🏻

Float-pixel, 2025-02-07:
I start a new track, give it a basic name like "HELLO".

Create chain 00, 01, 02, 03 in the top row of the first 4 colums and create pattern 00 inside chain 00, 01 in 01, 02 in 02 and 03 in 03.

In each pattern, I used 1 instrument with a matching number. Ins 00 in pattern 00 inside chain 00.

Ins 01, 02, 03 formed a drum kit, 00 was a 5-ish second synth sample. I fill out the patterns and save.

Upon reloading the project, I find either instruments are initialized or they are assigned to th wrong sample. No matter how much I save, it will go back to broken upon next load.

Float-pixel, 2025-02-07:
I managed to get instruments to stick in a song that was having issues by compacting and saving again after re-assigning every instrument. I'll try to find a better way to reproduce

Float-pixel, 2025-02-07:
Here is a project I am experiencing issues with, which I have also found a way to crash consistently.

[A.zip](https://github.com/user-attachments/files/18700365/A.zip)

This file will lose every instrument except 00 every load. To crash, go to instrument 11 and assign it to kick, move to ins 13 and assign it to the hat, and then try to assign 12 to hat. It should crash as you try to do 12. I think the same crash works if you assign 11 -> 12 -> 13 as well. It does not matter what method you use to move between 11,12, and 13.

Interestingly, instruments 12 and 13 both give me a prompt when changing from nothing to sample mode which is unusual. 11 is fine though...

10 should be assign to a bass sound but is empty.

wynwynyn, 2025-02-07:
Just a +1 to this, I also experienced a lot of issues when using the `Compact Instruments` function last night... It worked great while the project was open, but once I restarted the system or reloaded the projects, the samples were all over the place :(

Float-pixel, 2025-02-12:
I reproduced the issue found in A.zip with the serial USB firmware

here is the crash I described:

`þ    þ ­­­þ C  þ h  þ a  þ i  þ n  þ    þ 0  þ 0  þ )î=þ [* þ C+ þ H, þ G- þ ]. þ oþ 0  þ 0  þ k1kþ 0   þ 0   þ ­­­þ 0  þ 0  þ oþ 0  þ 1  þ ­­­þ F  þ E  þ 0  þ 0  þ oþ 0  þ 2  þ ­­­þ 0  þ 0  þ 0  þ 3  þ oþ 0  þ 3  þ ­­­þ F  þ E  þ 0  þ 0  þ oþ 0  þ 4  þ ­­­þ -  þ -  þ 0  þ 0  þ oþ 0  þ 5  þ ­­­þ -  þ -  þ 0  þ 0  þ oþ 0  þ 6  þ ­­­þ -  þ -  þ 0  þ 0  þ oþ 0  þ 7  þ ­­­þ -  þ -  þ 0  þ 0  þ oþ 0  þ 8  þ ­­­þ -  þ -  þ 0  þ 0  þ oþ 0  þ 9  þ ­­­þ -  þ -  þ 0  þ 0  þ oþ 0
þ A
þ ­­­þ -
þ -
þ 0
þ 0
þ oþ 0
þ B
þ ­­­þ -
þ -
þ 0
þ 0
þ oþ 0
þ C
þ ­­­þ -
þ -
þ 0
þ 0
þ oþ 0  þ D  þ ­­­þ -  þ -  þ 0  þ 0  þ oþ 0  þ E  þ ­­­þ -  þ -  þ 0  þ 0  þ oþ 0 !þ F !þ ­­­þ - !þ - !þ 0 !þ 0 !þ D #þ   #þ   #þ   #þ P $þ   $þ G $þ   $þ k1kþ   $ þ   $ þ oþ   $ þ   $ þ   $ þ   $ þ
$ þ
$ þ  $ þ  !$ þ  #$ þ  $$ þ  &$ þ  '$ þ  )$ þ  *$ þ ­­­þ S %þ k1kþ C %þ ­­­þ P %þ I %þ k1kþ   % þ   % þ oþ   % þ   % þ   % þ   % þ
% þ
% þ  % þ  !% þ  #% þ  $% þ  &% þ  '% þ  )% þ  *% þ ­­­þ   &þ   &þ T &þ T &þ k1kþ   & þ   & þ oþ   & þ   & þ   & þ   & þ
& þ
& þ  & þ  !& þ  #& þ  $& þ  && þ  '& þ  )& þ  *& þ    þ ­­­þ P  þ h  þ r  þ a  þ s  þ e  þ    þ 0  þ 0  þ I  þ 0  þ 0  þ :
 þ S
 þ y
 þ n  þ t  þ h! þ -" þ S# þ t$ þ o% þ f& þ D' þ u( þ s) þ t* þ .+ þ w, þ a- þ v. þ oþ 0  þ 0  þ k1kþ D   þ     þ     þ 3   þ ­­­þ I  þ 0  þ 0  þ -
 þ -
 þ -
 þ 0  þ 0! þ 0" þ 0# þ -% þ -& þ -' þ 0) þ 0* þ 0+ þ 0, þ oþ 0  þ 1  þ ­­­þ -  þ -  þ -  þ -  þ I  þ -  þ -  þ -
 þ -
 þ -
 þ 0  þ 0! þ 0" þ 0# þ -% þ -& þ -' þ 0) þ 0* þ 0+ þ 0, þ oþ 0  þ 2  þ ­­­þ -  þ -  þ -  þ -  þ I  þ -  þ -  þ -
 þ -
 þ -
 þ 0  þ 0! þ 0" þ 0# þ -% þ -& þ -' þ 0) þ 0* þ 0+ þ 0, þ oþ 0  þ 3  þ ­­­þ -  þ -  þ -  þ -  þ I  þ -  þ -  þ -
 þ -
 þ -
 þ 0  þ 0! þ 0" þ 0# þ -% þ -& þ -' þ 0) þ 0* þ 0+ þ 0, þ oþ 0  þ 4  þ ­­­þ -  þ -  þ -  þ -  þ I  þ -  þ -  þ -
 þ -
 þ -
 þ 0  þ 0! þ 0" þ 0# þ -% þ -& þ -' þ 0) þ 0* þ 0+ þ 0, þ oþ 0  þ 5  þ ­­­þ -  þ -  þ -  þ -  þ I  þ -  þ -  þ -
 þ -
 þ -
 þ 0  þ 0! þ 0" þ 0# þ -% þ -& þ -' þ 0) þ 0* þ 0+ þ 0, þ oþ 0  þ 6  þ ­­­þ -  þ -  þ -  þ -  þ I  þ -  þ -  þ -
 þ -
 þ -
 þ 0  þ 0! þ 0" þ 0# þ -% þ -& þ -' þ 0) þ 0* þ 0+ þ 0, þ oþ 0  þ 7  þ ­­­þ -  þ -  þ -  þ -  þ I  þ -  þ -  þ -
 þ -
 þ -
 þ 0  þ 0! þ 0" þ 0# þ -% þ -& þ -' þ 0) þ 0* þ 0+ þ 0, þ oþ 0  þ 8  þ ­­­þ -  þ -  þ -  þ -  þ I  þ -  þ -  þ -
 þ -
 þ -
 þ 0  þ 0! þ 0" þ 0# þ -% þ -& þ -' þ 0) þ 0* þ 0+ þ 0, þ oþ 0  þ 9  þ ­­­þ -  þ -  þ -  þ -  þ I  þ -  þ -  þ -
 þ -
 þ -
 þ 0  þ 0! þ 0" þ 0# þ -% þ -& þ -' þ 0) þ 0* þ 0+ þ 0, þ oþ 0
þ A
þ ­­­þ -
þ -
þ -
þ -
þ I
þ -
þ -
þ -

þ -

þ -

þ 0
þ 0!
þ 0"
þ 0#
þ -%
þ -&
þ -'
þ 0)
þ 0*
þ 0+
þ 0,
þ oþ 0
þ B
þ ­­­þ -
þ -
þ -
þ -
þ I
þ -
þ -
þ -

þ -

þ -

þ 0
þ 0!
þ 0"
þ 0#
þ -%
þ -&
þ -'
þ 0)
þ 0*
þ 0+
þ 0,
þ oþ 0
þ C
þ ­­­þ -
þ -
þ -
þ -
þ I
þ -
þ -
þ -

þ -

þ -

þ 0
þ 0!
þ 0"
þ 0#
þ -%
þ -&
þ -'
þ 0)
þ 0*
þ 0+
þ 0,
þ oþ 0  þ D  þ ­­­þ -  þ -  þ -  þ -  þ I  þ -  þ -  þ -
 þ -
 þ -
 þ 0  þ 0! þ 0" þ 0# þ -% þ -& þ -' þ 0) þ 0* þ 0+ þ 0, þ oþ 0  þ E  þ ­­­þ -  þ -  þ -  þ -  þ I  þ -  þ -  þ -
 þ -
 þ -
 þ 0 þ 0! þ 0" þ 0# þ -% þ -& þ -' þ 0) þ 0* þ 0+ þ 0, þ oþ 0 !þ F !þ ­­­þ - !þ - !þ - !þ - !þ I !þ - !þ - !þ -
!þ -
!þ -
!þ 0 !þ 0!!þ 0"!þ 0#!þ -%!þ -&!þ -'!þ 0)!þ 0*!þ 0+!þ 0,!þ D #þ   #þ   #þ   #þ P $þ   $þ G $þ   $þ k1kþ   $ þ   $ þ oþ   $ þ   $ þ   $ þ   $ þ
$ þ
$ þ  $ þ  !$ þ  #$ þ  $$ þ  &$ þ  '$ þ  )$ þ  *$ þ ­­­þ S %þ C %þ k1kþ P %þ ­­­þ I %þ k1kþ   % þ   % þ oþ   % þ   % þ   % þ   % þ
% þ
% þ  % þ  !% þ  #% þ  $% þ  &% þ  '% þ  )% þ  *% þ ­­­þ   &þ   &þ T &þ T &þ k1kþ   & þ   & þ oþ   & þ   & þ   & þ   & þ
& þ
& þ  & þ  !& þ  #& þ  $& þ  && þ  '& þ  )& þ  *& [INSTRUMENTVIEW] onFocus þ    þ ­­­þ I  þ n  þ s  þ t  þ r  þ u  þ m  þ e  þ n  þ t  þ    þ 0  þ 0  þ )î=þ [* þ C+ þ H, þ G- þ ]. þ k1kþ T   þ y   þ p   þ e   þ :   þ     þ S   þ A   þ M
  þ P
  þ L
  þ E   þ ­­­þ s  þ a  þ m  þ p  þ l  þ e  þ :  þ    þ S
 þ y
 þ n
 þ t  þ h  þ -! þ S" þ t# þ o$ þ f% þ D& þ u' þ s( þ t) þ .* þ w+ þ a, þ v- þ v  þ o  þ l  þ u  þ m  þ e  þ :  þ    þ 1
 þ 2
 þ 8
 þ    þ [  þ 8! þ 0" þ ]# þ p  þ a  þ n  þ :  þ    þ 7  þ F  þ r  þ o  þ o  þ t  þ    þ n  þ o  þ t  þ e
 þ :
 þ
 þ C  þ   þ  ! þ 3" þ d  þ e  þ t  þ u  þ n  þ e  þ :  þ    þ 7
 þ F
 þ d  þ r  þ i  þ v  þ e  þ :  þ    þ F  þ F
 þ c  þ r  þ u  þ s  þ h  þ :  þ    þ 1  þ 6
 þ d  þ o  þ w  þ n  þ s  þ a  þ m  þ p  þ l
 þ e
 þ :
 þ    þ 0  þ f  þ l  þ t  þ    þ c  þ u  þ t  þ /  þ r
 þ e
 þ s
 þ :  þ F! þ F" þ 0$ þ 0% þ t
þ y
þ p
þ e
þ :
þ
þ 0
þ 0
þ M
þ o
þ d
þ e
þ :
þ
þ o
þ r
þ i

þ g

þ i

þ n
þ a
þ l!
þ i  þ n  þ t  þ e  þ r  þ p  þ o  þ l  þ a
 þ t
 þ i
 þ o  þ n  þ :! þ  " þ l# þ i$ þ n% þ e& þ a' þ r( þ l  þ o  þ o  þ p  þ    þ m  þ o  þ d  þ e
 þ :
 þ
 þ p  þ i þ n! þ g" þ p# þ o$ þ n% þ g& þ s !þ t !þ a !þ r !þ t !þ : !þ   !þ 0 !þ 0
!þ 0
!þ 0
!þ 0 !þ 0 !þ 0!!þ l "þ o "þ o "þ p "þ   "þ s "þ t "þ a "þ r
"þ t
"þ :
"þ   "þ 0 "þ 0!"þ 0""þ 0#"þ 0$"þ 0%"þ 0&"þ D #þ   #þ   #þ   #þ l #þ o #þ o #þ p #þ   #þ e #þ n #þ d #þ :
#þ
#þ 0
#þ 0 #þ 2 #þ B!#þ 3"#þ 7##þ 5$#þ P $þ   $þ G $þ   $þ S %þ C %þ P %þ k1kþ I %þ ­­­þ a %þ u %þ t %þ o %þ m %þ a %þ t %þ i %þ o
%þ n
%þ :
%þ   %þ f %þ a!%þ l"%þ s#%þ e$%þ   &þ   &þ T &þ T &þ t &þ a &þ b &þ l &þ e &þ : &þ   &þ - &þ -
&þ ­­­þ T  þ y  þ p  þ e  þ :  þ    þ S  þ A  þ M
 þ P
 þ L
 þ E  þ k1kþ s   þ a   þ m   þ p   þ l   þ e   þ :   þ     þ S
  þ y
  þ n
  þ t   þ h   þ -!  þ S"  þ t#  þ o$  þ f%  þ D&  þ u'  þ s(  þ t)  þ .*  þ w+  þ a,  þ v-  [PICOFILESYSTEM] chdir:/samples [PICOFILESYSTEM] new CWD:samples [PICOFILESYSTEM] LIST DIR:samples [PICOFILESYSTEM] FILTER: .=.wav [0] [PICOFILESYSTEM] skipped hidden: . [PICOFILESYSTEM] FILTER: ..=.wav [0] [PICOFILESYSTEM] [1] got file: .. [PICOFILESYSTEM] FILTER: legowelt drum wizardry sample pack=.wav [0] [PICOFILESYSTEM] [5] got file: legowelt drum wizardry sample pack [PICOFILESYSTEM] FILTER: legowelt-elektrovolt-rolandjv2080samplekit=.wav [0] [PICOFILESYSTEM] [10] got file: legowelt-elektrovolt-rolandjv2080samplekit [PICOFILESYSTEM] FILTER: legowelt kawai k4 samplepack=.wav [0] [PICOFILESYSTEM] [14] got file: legowelt kawai k4 samplepack [PICOFILESYSTEM] FILTER: legowelt_legowelt-jupiter-8-sample-pack_2024-01-14_1425=.wav [0] [PICOFILESYSTEM] [20] got file: legowelt_legowelt-jupiter-8-sample-pack_2024-01-14_1425 [PICOFILESYSTEM] FILTER: legoweltyamahapss795samplekit=.wav [0] [PICOFILESYSTEM] [24] got file: legoweltyamahapss795samplekit [PICOFILESYSTEM] FILTER: rolandjd800sampleslegowelt=.wav [0] [PICOFILESYSTEM] [27] got file: rolandjd800sampleslegowelt [PICOFILESYSTEM] FILTER: legowelt oberheim matrix 1000 sample pack=.wav [0] [PICOFILESYSTEM] [32] got file: legowelt oberheim matrix 1000 sample pack [PICOFILESYSTEM] FILTER: legowelt quasimidi sirius sample pack=.wav [0] [PICOFILESYSTEM] [36] got file: legowelt quasimidi sirius sample pack [PICOFILESYSTEM] FILTER: legoweltyamahasy35samplekit=.wav [0] [PICOFILESYSTEM] [40] got file: legoweltyamahasy35samplekit [PICOFILESYSTEM] FILTER: legowelt minimoog sample pack=.wav [0] [PICOFILESYSTEM] [44] got file: legowelt minimoog sample pack [PICOFILESYSTEM] FILTER: legowelt drumnibus samplepack=.wav [0] [PICOFILESYSTEM] [48] got file: legowelt drumnibus samplepack [PICOFILESYSTEM] FILTER: legoweltemuvintageprosamplepack=.wav [0] [PICOFILESYSTEM] [52] got file: legoweltemuvintageprosamplepack [PICOFILESYSTEM] FILTER: legowelt_dx-files_samplepack=.wav [0] [PICOFILESYSTEM] [56] got file: legowelt_dx-files_samplepack [PICOFILESYSTEM] FILTER: drums=.wav [0] [PICOFILESYSTEM] [58] got file: drums [PICOFILESYSTEM] scanned: 15, added file indexes:15
þ    þ )î=þ I  þ m  þ p  þ o  þ r  þ t  þ    þ S  þ a  þ m  þ p  þ l  þ e
 þ [* þ C+ þ H, þ G- þ ]. þ k1kþ /   þ L   þ e   þ g   þ o   þ w   þ e   þ l   þ t   þ     þ D   þ r   þ u
  þ m
  þ
  þ W   þ i   þ z!  þ a"  þ r#  þ d$  þ r%  þ y&  þ  '  þ S(  þ a)  þ m*  þ p+  þ l,  þ e-  þ ­­­þ /  þ L  þ e  þ g  þ o  þ w  þ e  þ l  þ t  þ -  þ E  þ l  þ e
 þ k
 þ t
 þ r  þ o  þ v! þ o" þ l# þ t$ þ -% þ R& þ o' þ l( þ a) þ n* þ d+ þ J, þ V- þ /  þ L  þ e  þ g  þ o  þ w  þ e  þ l  þ t  þ    þ K  þ a  þ w
 þ a
 þ i
 þ    þ K  þ 4! þ  " þ S# þ a$ þ m% þ p& þ l' þ e( þ P) þ a* þ c+ þ k, þ /  þ l  þ e  þ g  þ o  þ w  þ e  þ l  þ t  þ _  þ l  þ e  þ g
 þ o
 þ w
 þ e  þ l  þ t! þ -" þ j# þ u$ þ p% þ i& þ t' þ e( þ r) þ -* þ 8+ þ -, þ s- þ /  þ L  þ e  þ g  þ o  þ w  þ e  þ l  þ t  þ Y  þ a  þ m  þ a
 þ h
 þ a
 þ P  þ S  þ S! þ 7" þ 9# þ 5$ þ s% þ a& þ m' þ p( þ l) þ e* þ k+ þ i, þ t- þ /  þ R  þ o  þ l  þ a  þ n  þ d  þ J  þ D  þ 8  þ 0  þ 0  þ s
 þ a
 þ m
 þ p  þ l  þ e! þ s" þ L# þ e$ þ g% þ o& þ w' þ e( þ l) þ t* þ /  þ L  þ e  þ g  þ o  þ w  þ e  þ l  þ t  þ    þ O  þ b  þ e
 þ r
 þ h
 þ e  þ i  þ m! þ  " þ M# þ a$ þ t% þ r& þ i' þ x( þ  ) þ 1* þ 0+ þ 0, þ 0- þ /  þ L  þ e  þ g  þ o  þ w  þ e  þ l  þ t  þ    þ Q  þ u  þ a
 þ s
 þ i
 þ M  þ I  þ D! þ I" þ  # þ S$ þ I% þ R& þ I' þ U( þ S) þ  * þ S+ þ a, þ m- þ /  þ L  þ e  þ g  þ o  þ w  þ e  þ l  þ t  þ Y  þ a  þ m  þ a
 þ h
 þ a
 þ S  þ Y  þ 3! þ 5" þ s# þ a$ þ m% þ p& þ l' þ e( þ K) þ i* þ t+ þ /  þ L  þ e  þ g  þ o  þ w  þ e  þ l  þ t  þ    þ M  þ I  þ N
 þ I
 þ M
 þ O  þ O  þ G! þ  " þ s# þ a$ þ m% þ p& þ l' þ e( þ  ) þ p* þ a+ þ c, þ k- þ /  þ L  þ e  þ g  þ o  þ w  þ e  þ l  þ t  þ    þ D  þ r  þ u
 þ m
 þ n
 þ i  þ b  þ u! þ s" þ  # þ S$ þ a% þ m& þ p' þ l( þ e) þ p* þ a+ þ c, þ k- þ /
þ L
þ e
þ g
þ o
þ w
þ e
þ l
þ t
þ E
þ M
þ U
þ v

þ i

þ n

þ t
þ a
þ g!
þ e"
þ P#
þ r$
þ o%
þ S&
þ a'
þ m(
þ p)
þ l*
þ e+
þ P,
þ a-
þ /
þ L
þ e
þ g
þ o
þ w
þ e
þ l
þ t
þ _
þ D
þ X
þ -

þ F

þ I

þ L
þ E
þ S!
þ _"
þ S#
þ a$
þ m%
þ p&
þ l'
þ e(
þ P)
þ a*
þ c+
þ k,
þ /
þ D
þ r
þ u
þ m
þ s
[INSTRUMENTVIEW] onFocus
þ    þ ­­­þ I  þ n  þ s  þ t  þ r  þ u  þ m  þ e  þ n  þ t  þ    þ 0  þ 0  þ )î=þ [* þ C+ þ H, þ G- þ ]. þ k1kþ T   þ y   þ p   þ e   þ :   þ     þ S   þ A   þ M
  þ P
  þ L
  þ E   þ ­­­þ s  þ a  þ m  þ p  þ l  þ e  þ :  þ    þ S
 þ y
 þ n
 þ t  þ h  þ -! þ S" þ t# þ o$ þ f% þ D& þ u' þ s( þ t) þ .* þ w+ þ a, þ v- þ v  þ o  þ l  þ u  þ m  þ e  þ :  þ    þ 1
 þ 2
 þ 8
 þ    þ [  þ 8! þ 0" þ ]# þ p  þ a  þ n  þ :  þ    þ 7  þ F  þ r  þ o  þ o  þ t  þ    þ n  þ o  þ t  þ e
 þ :
 þ
 þ C  þ   þ  ! þ 3" þ d  þ e  þ t  þ u  þ n  þ e  þ :  þ    þ 7
 þ F
 þ d  þ r  þ i  þ v  þ e  þ :  þ    þ F  þ F
 þ c  þ r  þ u  þ s  þ h  þ :  þ    þ 1  þ 6
 þ d  þ o  þ w  þ n  þ s  þ a  þ m  þ p  þ l
 þ e
 þ :
 þ    þ 0  þ f  þ l  þ t  þ    þ c  þ u  þ t  þ /  þ r
 þ e
 þ s
 þ :  þ F! þ F" þ 0$ þ 0% þ t
þ y
þ p
þ e
þ :
þ
þ 0
þ 0
þ M
þ o
þ d
þ e
þ :
þ
þ o
þ r
þ i

þ g

þ i

þ n
þ a
þ l!
þ i  þ n  þ t  þ e  þ r  þ p  þ o  þ l  þ a
 þ t
 þ i
 þ o  þ n  þ :! þ  " þ l# þ i$ þ n% þ e& þ a' þ r( þ l  þ o  þ o  þ p  þ    þ m  þ o  þ d  þ e
 þ :
 þ
 þ p  þ i þ n! þ g" þ p# þ o$ þ n% þ g& þ s !þ t !þ a !þ r !þ t !þ : !þ   !þ 0 !þ 0
!þ 0
!þ 0
!þ 0 !þ 0 !þ 0!!þ l "þ o "þ o "þ p "þ   "þ s "þ t "þ a "þ r
"þ t
"þ :
"þ   "þ 0 "þ 0!"þ 0""þ 0#"þ 0$"þ 0%"þ 0&"þ D #þ   #þ   #þ   #þ l #þ o #þ o #þ p #þ   #þ e #þ n #þ d #þ :
#þ
#þ 0
#þ 0 #þ 2 #þ B!#þ 3"#þ 7##þ 5$#þ P $þ   $þ G $þ   $þ S %þ C %þ P %þ k1kþ I %þ ­­­þ a %þ u %þ t %þ o %þ m %þ a %þ t %þ i %þ o
%þ n
%þ :
%þ   %þ f %þ a!%þ l"%þ s#%þ e$%þ   &þ   &þ T &þ T &þ t &þ a &þ b &þ l &þ e &þ : &þ   &þ - &þ -
&þ    þ ­­­þ P  þ h  þ r  þ a  þ s  þ e  þ    þ 0  þ 0  þ I  þ 0  þ 0  þ :
 þ S
 þ y
 þ n  þ t  þ h! þ -" þ S# þ t$ þ o% þ f& þ D' þ u( þ s) þ t* þ .+ þ w, þ a- þ v. þ oþ 0  þ 0  þ k1kþ D   þ     þ     þ 3   þ ­­­þ I  þ 0  þ 0  þ -
 þ -
 þ -
 þ 0  þ 0! þ 0" þ 0# þ -% þ -& þ -' þ 0) þ 0* þ 0+ þ 0, þ oþ 0  þ 1  þ ­­­þ -  þ -  þ -  þ -  þ I  þ -  þ -  þ -
 þ -
 þ -
 þ 0  þ 0! þ 0" þ 0# þ -% þ -& þ -' þ 0) þ 0* þ 0+ þ 0, þ oþ 0  þ 2  þ ­­­þ -  þ -  þ -  þ -  þ I  þ -  þ -  þ -
 þ -
 þ -
 þ 0  þ 0! þ 0" þ 0# þ -% þ -& þ -' þ 0) þ 0* þ 0+ þ 0, þ oþ 0  þ 3  þ ­­­þ -  þ -  þ -  þ -  þ I  þ -  þ -  þ -
 þ -
 þ -
 þ 0  þ 0! þ 0" þ 0# þ -% þ -& þ -' þ 0) þ 0* þ 0+ þ 0, þ oþ 0  þ 4  þ ­­­þ -  þ -  þ -  þ -  þ I  þ -  þ -  þ -
 þ -
 þ -
 þ 0  þ 0! þ 0" þ 0# þ -% þ -& þ -' þ 0) þ 0* þ 0+ þ 0, þ oþ 0  þ 5  þ ­­­þ -  þ -  þ -  þ -  þ I  þ -  þ -  þ -
 þ -
 þ -
 þ 0  þ 0! þ 0" þ 0# þ -% þ -& þ -' þ 0) þ 0* þ 0+ þ 0, þ oþ 0  þ 6  þ ­­­þ -  þ -  þ -  þ -  þ I  þ -  þ -  þ -
 þ -
 þ -
 þ 0  þ 0! þ 0" þ 0# þ -% þ -& þ -' þ 0) þ 0* þ 0+ þ 0, þ oþ 0  þ 7  þ ­­­þ -  þ -  þ -  þ -  þ I  þ -  þ -  þ -
 þ -
 þ -
 þ 0  þ 0! þ 0" þ 0# þ -% þ -& þ -' þ 0) þ 0* þ 0+ þ 0, þ oþ 0  þ 8  þ ­­­þ -  þ -  þ -  þ -  þ I  þ -  þ -  þ -
 þ -
 þ -
 þ 0  þ 0! þ 0" þ 0# þ -% þ -& þ -' þ 0) þ 0* þ 0+ þ 0, þ oþ 0  þ 9  þ ­­­þ -  þ -  þ -  þ -  þ I  þ -  þ -  þ -
 þ -
 þ -
 þ 0  þ 0! þ 0" þ 0# þ -% þ -& þ -' þ 0) þ 0* þ 0+ þ 0, þ oþ 0
þ A
þ ­­­þ -
þ -
þ -
þ -
þ I
þ -
þ -
þ -

þ -

þ -

þ 0
þ 0!
þ 0"
þ 0#
þ -%
þ -&
þ -'
þ 0)
þ 0*
þ 0+
þ 0,
þ oþ 0
þ B
þ ­­­þ -
þ -
þ -
þ -
þ I
þ -
þ -
þ -

þ -

þ -

þ 0
þ 0!
þ 0"
þ 0#
þ -%
þ -&
þ -'
þ 0)
þ 0*
þ 0+
þ 0,
þ oþ 0
þ C
þ ­­­þ -
þ -
þ -
þ -
þ I
þ -
þ -
þ -

þ -

þ -

þ 0
þ 0!
þ 0"
þ 0#
þ -%
þ -&
þ -'
þ 0)
þ 0*
þ 0+
þ 0,
þ oþ 0  þ D  þ ­­­þ -  þ -  þ -  þ -  þ I  þ -  þ -  þ -
 þ -
 þ -
 þ 0  þ 0! þ 0" þ 0# þ -% þ -& þ -' þ 0) þ 0* þ 0+ þ 0, þ oþ 0  þ E  þ ­­­þ -  þ -  þ -  þ -  þ I  þ -  þ -  þ -
 þ -
 þ -
 þ 0 þ 0! þ 0" þ 0# þ -% þ -& þ -' þ 0) þ 0* þ 0+ þ 0, þ oþ 0 !þ F !þ ­­­þ - !þ - !þ - !þ - !þ I !þ - !þ - !þ -
!þ -
!þ -
!þ 0 !þ 0!!þ 0"!þ 0#!þ -%!þ -&!þ -'!þ 0)!þ 0*!þ 0+!þ 0,!þ D #þ   #þ   #þ   #þ P $þ   $þ G $þ   $þ k1kþ   $ þ   $ þ oþ   $ þ   $ þ   $ þ   $ þ
$ þ
$ þ  $ þ  !$ þ  #$ þ  $$ þ  &$ þ  '$ þ  )$ þ  *$ þ ­­­þ S %þ C %þ k1kþ P %þ ­­­þ I %þ k1kþ   % þ   % þ oþ   % þ   % þ   % þ   % þ
% þ
% þ  % þ  !% þ  #% þ  $% þ  &% þ  '% þ  )% þ  *% þ ­­­þ   &þ   &þ T &þ T &þ k1kþ   & þ   & þ oþ   & þ   & þ   & þ   & þ
& þ
& þ  & þ  !& þ  #& þ  $& þ  && þ  '& þ  )& þ  *& þ )î=þ [* þ C+ þ H, þ G- þ ]. þ    þ ­­­þ C  þ h  þ a  þ i  þ n  þ    þ 0  þ 0  þ )î=þ [* þ C+ þ H, þ G- þ ]. þ oþ 0  þ 0  þ k1kþ 0   þ 0   þ ­­­þ 0  þ 0  þ oþ 0  þ 1  þ ­­­þ F  þ E  þ 0  þ 0  þ oþ 0  þ 2  þ ­­­þ 0  þ 0  þ 0  þ 3  þ oþ 0  þ 3  þ ­­­þ F  þ E  þ 0  þ 0  þ oþ 0  þ 4  þ ­­­þ -  þ -  þ 0  þ 0  þ oþ 0  þ 5  þ ­­­þ -  þ -  þ 0  þ 0  þ oþ 0  þ 6  þ ­­­þ -  þ -  þ 0  þ 0  þ oþ 0  þ 7  þ ­­­þ -  þ -  þ 0  þ 0  þ oþ 0  þ 8  þ ­­­þ -  þ -  þ 0  þ 0  þ oþ 0  þ 9  þ ­­­þ -  þ -  þ 0  þ 0  þ oþ 0
þ A
þ ­­­þ -
þ -
þ 0
þ 0
þ oþ 0
þ B
þ ­­­þ -
þ -
þ 0
þ 0
þ oþ 0
þ C
þ ­­­þ -
þ -
þ 0
þ 0
þ oþ 0  þ D  þ ­­­þ -  þ -  þ 0  þ 0  þ oþ 0  þ E  þ ­­­þ -  þ -  þ 0  þ 0  þ oþ 0 !þ F !þ ­­­þ - !þ - !þ 0 !þ 0 !þ D #þ   #þ   #þ   #þ P $þ   $þ G $þ   $þ k1kþ   $ þ   $ þ oþ   $ þ   $ þ   $ þ   $ þ
$ þ
$ þ  $ þ  !$ þ  #$ þ  $$ þ  &$ þ  '$ þ  )$ þ  *$ þ ­­­þ S %þ k1kþ C %þ ­­­þ P %þ I %þ k1kþ   % þ   % þ oþ   % þ   % þ   % þ   % þ
% þ
% þ  % þ  !% þ  #% þ  $% þ  &% þ  '% þ  )% þ  *% þ ­­­þ   &þ   &þ T &þ T &þ k1kþ   & þ   & þ oþ   & þ   & þ   & þ   & þ
& þ
& þ  & þ  !& þ  #& þ  $& þ  && þ  '& þ  )& þ  *& þ    þ ­­­þ S   þ o   þ n   þ g   þ A  þ )î=þ [* þ C+ þ H, þ G- þ ]. þ oþ 0  þ 0  þ k1kþ 0   þ 0   þ ­­­þ 1  þ 0  þ 2  þ 0  þ 3
 þ 0
 þ -  þ -! þ -# þ -$ þ -& þ -' þ -) þ -* þ oþ 0  þ 1  þ ­­­þ -  þ -  þ -  þ -  þ -  þ -  þ -
 þ -
 þ -  þ -! þ -# þ -$ þ -& þ -' þ -) þ -* þ oþ 0  þ 2  þ ­­­þ -  þ -  þ -  þ -  þ -  þ -  þ -
 þ -
 þ -  þ -! þ -# þ -$ þ -& þ -' þ -) þ -* þ oþ 0  þ 3  þ ­­­þ -  þ -  þ -  þ -  þ -  þ -  þ -
 þ -
 þ -  þ -! þ -# þ -$ þ -& þ -' þ -) þ -* þ oþ 0  þ 4  þ ­­­þ -  þ -  þ -  þ -  þ -  þ -  þ -
 þ -
 þ -  þ -! þ -# þ -$ þ -& þ -' þ -) þ -* þ oþ 0  þ 5  þ ­­­þ -  þ -  þ -  þ -  þ -  þ -  þ -
 þ -
 þ -  þ -! þ -# þ -$ þ -& þ -' þ -) þ -* þ oþ 0  þ 6  þ ­­­þ -  þ -  þ -  þ -  þ -  þ -  þ -
 þ -
 þ -  þ -! þ -# þ -$ þ -& þ -' þ -) þ -* þ oþ 0  þ 7  þ ­­­þ -  þ -  þ -  þ -  þ -  þ -  þ -
 þ -
 þ -  þ -! þ -# þ -$ þ -& þ -' þ -) þ -* þ oþ 0  þ 8  þ ­­­þ -  þ -  þ -  þ -  þ -  þ -  þ -
 þ -
 þ -  þ -! þ -# þ -$ þ -& þ -' þ -) þ -* þ oþ 0  þ 9  þ ­­­þ -  þ -  þ -  þ -  þ -  þ -  þ -
 þ -
 þ -  þ -! þ -# þ -$ þ -& þ -' þ -) þ -* þ oþ 0
þ A
þ ­­­þ -
þ -
þ -
þ -
þ -
þ -
þ -

þ -

þ -
þ -!
þ -#
þ -$
þ -&
þ -'
þ -)
þ -*
þ oþ 0
þ B
þ ­­­þ -
þ -
þ -
þ -
þ -
þ -
þ -

þ -

þ -
þ -!
þ -#
þ -$
þ -&
þ -'
þ -)
þ -*
þ oþ 0
þ C
þ ­­­þ -
þ -
þ -
þ -
þ -
þ -
þ -

þ -

þ -
þ -!
þ -#
þ -$
þ -&
þ -'
þ -)
þ -*
þ oþ 0  þ D  þ ­­­þ -  þ -  þ -  þ -  þ -  þ -  þ -
 þ -
 þ -  þ -! þ -# þ -$ þ -& þ -' þ -) þ -* þ oþ 0  þ E  þ ­­­þ -  þ -  þ -  þ -  þ -  þ -  þ -
 þ -
 þ - þ -! þ -# þ -$ þ -& þ -' þ -) þ -* þ oþ 0 !þ F !þ ­­­þ - !þ - !þ - !þ - !þ - !þ - !þ -
!þ -
!þ - !þ -!!þ -#!þ -$!þ -&!þ -'!þ -)!þ -*!þ D #þ   #þ   #þ   #þ P $þ   $þ G $þ   $þ k1kþ   $ þ   $ þ oþ   $ þ   $ þ   $ þ   $ þ
$ þ
$ þ  $ þ  !$ þ  #$ þ  $$ þ  &$ þ  '$ þ  )$ þ  *$ þ k1kþ S %þ ­­­þ C %þ P %þ I %þ k1kþ   % þ   % þ oþ   % þ   % þ   % þ   % þ
% þ
% þ  % þ  !% þ  #% þ  $% þ  &% þ  '% þ  )% þ  *% þ ­­­þ   &þ   &þ T &þ T &þ k1kþ   & þ   & þ oþ   & þ   & þ   & þ   & þ
& þ
& þ  & þ  !& þ  #& þ  $& þ  && þ  '& þ  )& þ  *& þ ­­­þ 0  þ 0  þ k1kþ 1   þ 0   þ oþ   $ þ   $ þ k1kþ   $ þ   $ þ oþ   % þ   % þ k1kþ   % þ   % þ oþ   & þ   & þ k1kþ   & þ   & þ ­­­þ 1  þ 0  þ k1kþ 2   þ 0   þ oþ   $ þ   $ þ k1kþ   $ þ   $ þ oþ   % þ   % þ k1kþ   % þ   % þ oþ   & þ   & þ k1kþ   & þ   & þ    þ ­­­þ C  þ h  þ a  þ i  þ n  þ    þ 2  þ 0  þ )î=þ [* þ C+ þ H, þ G- þ ]. þ oþ 0  þ 0  þ k1kþ 2   þ 0   þ ­­­þ 0  þ 0  þ oþ 0  þ 1  þ ­­­þ 2  þ 1  þ 0  þ 0  þ oþ 0  þ 2  þ ­­­þ 2  þ 2  þ 0  þ 0  þ oþ 0  þ 3  þ ­­­þ 2  þ 3  þ 0  þ 0  þ oþ 0  þ 4  þ ­­­þ -  þ -  þ 0  þ 0  þ oþ 0  þ 5  þ ­­­þ -  þ -  þ 0  þ 0  þ oþ 0  þ 6  þ ­­­þ -  þ -  þ 0  þ 0  þ oþ 0  þ 7  þ ­­­þ -  þ -  þ 0  þ 0  þ oþ 0  þ 8  þ ­­­þ -  þ -  þ 0  þ 0  þ oþ 0  þ 9  þ ­­­þ -  þ -  þ 0  þ 0  þ oþ 0
þ A
þ ­­­þ -
þ -
þ 0
þ 0
þ oþ 0
þ B
þ ­­­þ -
þ -
þ 0
þ 0
þ oþ 0
þ C
þ ­­­þ -
þ -
þ 0
þ 0
þ oþ 0  þ D  þ ­­­þ -  þ -  þ 0  þ 0  þ oþ 0  þ E  þ ­­­þ -  þ -  þ 0  þ 0  þ oþ 0 !þ F !þ ­­­þ - !þ - !þ 0 !þ 0 !þ D #þ   #þ   #þ   #þ P $þ   $þ G $þ   $þ oþ   $ þ   $ þ   $ þ   $ þ k1kþ   $ þ   $ þ oþ
$ þ
$ þ  $ þ  !$ þ  #$ þ  $$ þ  &$ þ  '$ þ  )$ þ  *$ þ ­­­þ S %þ k1kþ C %þ ­­­þ P %þ I %þ oþ   % þ   % þ   % þ   % þ k1kþ   % þ   % þ oþ
% þ
% þ  % þ  !% þ  #% þ  $% þ  &% þ  '% þ  )% þ  *% þ ­­­þ   &þ   &þ T &þ T &þ oþ   & þ   & þ   & þ   & þ k1kþ   & þ   & þ oþ
& þ
& þ  & þ  !& þ  #& þ  $& þ  && þ  '& þ  )& þ  *& þ    þ ­­­þ P  þ h  þ r  þ a  þ s  þ e  þ    þ 2  þ 0  þ I  þ 1  þ 1  þ :
 þ N
 þ o
 þ n  þ e  þ )î=þ [* þ C+ þ H, þ G- þ ]. þ oþ 0  þ 0  þ k1kþ C   þ     þ     þ 3   þ ­­­þ I  þ 1  þ 1  þ -
 þ -
 þ -
 þ 0  þ 0! þ 0" þ 0# þ -% þ -& þ -' þ 0) þ 0* þ 0+ þ 0, þ oþ 0  þ 1  þ ­­­þ -  þ -  þ -  þ -  þ I  þ -  þ -  þ -
 þ -
 þ -
 þ 0  þ 0! þ 0" þ 0# þ -% þ -& þ -' þ 0) þ 0* þ 0+ þ 0, þ oþ 0  þ 2  þ ­­­þ -  þ -  þ -  þ -  þ I  þ -  þ -  þ -
 þ -
 þ -
 þ 0  þ 0! þ 0" þ 0# þ -% þ -& þ -' þ 0) þ 0* þ 0+ þ 0, þ oþ 0  þ 3  þ ­­­þ -  þ -  þ -  þ -  þ I  þ -  þ -  þ -
 þ -
 þ -
 þ 0  þ 0! þ 0" þ 0# þ -% þ -& þ -' þ 0) þ 0* þ 0+ þ 0, þ oþ 0  þ 4  þ ­­­þ C  þ    þ    þ 3  þ I  þ 1  þ 3  þ -
 þ -
 þ -
 þ 0  þ 0! þ 0" þ 0# þ -% þ -& þ -' þ 0) þ 0* þ 0+ þ 0, þ oþ 0  þ 5  þ ­­­þ -  þ -  þ -  þ -  þ I  þ -  þ -  þ -
 þ -
 þ -
 þ 0  þ 0! þ 0" þ 0# þ -% þ -& þ -' þ 0) þ 0* þ 0+ þ 0, þ oþ 0  þ 6  þ ­­­þ -  þ -  þ -  þ -  þ I  þ -  þ -  þ -
 þ -
 þ -
 þ 0  þ 0! þ 0" þ 0# þ -% þ -& þ -' þ 0) þ 0* þ 0+ þ 0, þ oþ 0  þ 7  þ ­­­þ -  þ -  þ -  þ -  þ I  þ -  þ -  þ -
 þ -
 þ -
 þ 0  þ 0! þ 0" þ 0# þ -% þ -& þ -' þ 0) þ 0* þ 0+ þ 0, þ oþ 0  þ 8  þ ­­­þ -  þ -  þ -  þ -  þ I  þ -  þ -  þ -
 þ -
 þ -
 þ 0  þ 0! þ 0" þ 0# þ -% þ -& þ -' þ 0) þ 0* þ 0+ þ 0, þ oþ 0  þ 9  þ ­­­þ -  þ -  þ -  þ -  þ I  þ -  þ -  þ -
 þ -
 þ -
 þ 0  þ 0! þ 0" þ 0# þ -% þ -& þ -' þ 0) þ 0* þ 0+ þ 0, þ oþ 0
þ A
þ ­­­þ C
þ
þ
þ 3
þ I
þ 1
þ 1
þ -

þ -

þ -

þ 0
þ 0!
þ 0"
þ 0#
þ -%
þ -&
þ -'
þ 0)
þ 0*
þ 0+
þ 0,
þ oþ 0
þ B
þ ­­­þ -
þ -
þ -
þ -
þ I
þ -
þ -
þ -

þ -

þ -

þ 0
þ 0!
þ 0"
þ 0#
þ -%
þ -&
þ -'
þ 0)
þ 0*
þ 0+
þ 0,
þ oþ 0
þ C
þ ­­­þ C
þ
þ
þ 3
þ I
þ 1
þ 3
þ -

þ -

þ -

þ 0
þ 0!
þ 0"
þ 0#
þ -%
þ -&
þ -'
þ 0)
þ 0*
þ 0+
þ 0,
þ oþ 0  þ D  þ ­­­þ C  þ    þ    þ 3  þ I  þ 1  þ 1  þ -
 þ -
 þ -
 þ 0  þ 0! þ 0" þ 0# þ -% þ -& þ -' þ 0) þ 0* þ 0+ þ 0, þ oþ 0  þ E  þ ­­­þ -  þ -  þ -  þ -  þ I  þ -  þ -  þ -
 þ -
 þ -
 þ 0 þ 0! þ 0" þ 0# þ -% þ -& þ -' þ 0) þ 0* þ 0+ þ 0, þ oþ 0 !þ F !þ ­­­þ - !þ - !þ - !þ - !þ I !þ - !þ - !þ -
!þ -
!þ -
!þ 0 !þ 0!!þ 0"!þ 0#!þ -%!þ -&!þ -'!þ 0)!þ 0*!þ 0+!þ 0,!þ D #þ   #þ   #þ   #þ P $þ   $þ G $þ   $þ oþ   $ þ   $ þ   $ þ   $ þ k1kþ   $ þ   $ þ oþ
$ þ
$ þ  $ þ  !$ þ  #$ þ  $$ þ  &$ þ  '$ þ  )$ þ  *$ þ ­­­þ S %þ C %þ k1kþ P %þ ­­­þ I %þ oþ   % þ   % þ   % þ   % þ k1kþ   % þ   % þ oþ
% þ
% þ  % þ  !% þ  #% þ  $% þ  &% þ  '% þ  )% þ  *% þ ­­­þ   &þ   &þ T &þ T &þ oþ   & þ   & þ   & þ   & þ k1kþ   & þ   & þ oþ
& þ
& þ  & þ  !& þ  #& þ  $& þ  && þ  '& þ  )& þ  *& þ ­­­þ C  þ    þ    þ 3  þ k1kþ I   þ 1   þ 1   [INSTRUMENTVIEW] onFocus þ    þ ­­­þ I  þ n  þ s  þ t  þ r  þ u  þ m  þ e  þ n  þ t  þ    þ 1  þ 1  þ )î=þ [* þ C+ þ H, þ G- þ ]. þ k1kþ T   þ y   þ p   þ e   þ :   þ     þ N   þ O   þ N
  þ E
  þ ­­­þ D #þ   #þ   #þ   #þ P $þ   $þ G $þ   $þ S %þ C %þ P %þ k1kþ I %þ ­­­þ   &þ   &þ T &þ T &[-D-] INSTRUMENTVIEW [INSTRUMENTVIEW] UPDATE type:1 þ k1kþ S   þ A   þ M
  þ P
  þ L
  þ E   þ ­­­þ s  þ a  þ m  þ p  þ l  þ e  þ :  þ    þ (
 þ n
 þ u
 þ l  þ l  þ )! þ v  þ o  þ l  þ u  þ m  þ e  þ :  þ    þ 1
 þ 2
 þ 8
 þ    þ [  þ 8! þ 0" þ ]# þ p  þ a  þ n  þ :  þ    þ 7  þ F  þ r  þ o  þ o  þ t  þ    þ n  þ o  þ t  þ e
 þ :
 þ
 þ C  þ   þ  ! þ 3" þ d  þ e  þ t  þ u  þ n  þ e  þ :  þ    þ 7
 þ F
 þ d  þ r  þ i  þ v  þ e  þ :  þ    þ F  þ F
 þ c  þ r  þ u  þ s  þ h  þ :  þ    þ 1  þ 6
 þ d  þ o  þ w  þ n  þ s  þ a  þ m  þ p  þ l
 þ e
 þ :
 þ    þ 0  þ f  þ l  þ t  þ    þ c  þ u  þ t  þ /  þ r
 þ e
 þ s
 þ :  þ F! þ F" þ 0$ þ 0% þ t
þ y
þ p
þ e
þ :
þ
þ 0
þ 0
þ M
þ o
þ d
þ e
þ :
þ
þ o
þ r
þ i

þ g

þ i

þ n
þ a
þ l!
þ i  þ n  þ t  þ e  þ r  þ p  þ o  þ l  þ a
 þ t
 þ i
 þ o  þ n  þ :! þ  " þ l# þ i$ þ n% þ e& þ a' þ r( þ l  þ o  þ o  þ p  þ    þ m  þ o  þ d  þ e
 þ :
 þ
 þ n  þ o þ n! þ e" þ s !þ t !þ a !þ r !þ t !þ : !þ   !þ 0 !þ 0
!þ 0
!þ 0
!þ 0 !þ 0 !þ 0!!þ l "þ o "þ o "þ p "þ   "þ s "þ t "þ a "þ r
"þ t
"þ :
"þ   "þ 0 "þ 0!"þ 0""þ 0#"þ 0$"þ 0%"þ 0&"þ l #þ o #þ o #þ p #þ   #þ e #þ n #þ d #þ :
#þ
#þ 0
#þ 0 #þ 0 #þ 0!#þ 0"#þ 0##þ 0$#þ a %þ u %þ t %þ o %þ m %þ a %þ t %þ i %þ o
%þ n
%þ :
%þ   %þ f %þ a!%þ l"%þ s#%þ e$%þ t &þ a &þ b &þ l &þ e &þ : &þ   &þ - &þ -
&þ ­­­þ T  þ y  þ p  þ e  þ :  þ    þ S  þ A  þ M
 þ P
 þ L
 þ E  þ k1kþ s   þ a   þ m   þ p   þ l   þ e   þ :   þ     þ (
  þ n
  þ u
  þ l   þ l   þ )!  þ k1kþ L
  þ e
  þ g
  þ o   þ w   þ e!  þ l"  þ t#  þ  $  þ B%  þ a&  þ s'  þ e(  þ d)  þ r*  þ u+  þ m,  þ  -  þ ­­­þ F!#þ 8"#þ 4##þ C$#þ ­­­þ 2  þ k1kþ T   þ y   þ p   þ e   þ :   þ     þ N   þ O   þ N
  þ E
  þ    þ
 þ    þ    þ    þ    þ    þ    þ    þ    þ    þ
 þ
 þ
 þ    þ   þ  ! þ  " þ  # þ  $ þ  % þ  & þ  ' þ  ( þ  ) þ  * þ  + þ  , þ  - þ    þ    þ    þ    þ    þ    þ    þ    þ
 þ
 þ
 þ    þ   þ  ! þ  " þ  # þ    þ    þ    þ    þ    þ    þ    þ    þ    þ    þ    þ    þ    þ    þ    þ
 þ
 þ
 þ    þ   þ  ! þ  " þ    þ    þ    þ    þ    þ    þ    þ    þ
 þ
 þ    þ    þ    þ    þ    þ    þ    þ    þ
 þ    þ    þ    þ    þ    þ    þ    þ    þ
 þ    þ    þ    þ    þ    þ    þ    þ    þ
 þ
 þ
 þ    þ   þ    þ    þ    þ    þ    þ    þ    þ    þ
 þ
 þ
 þ    þ  ! þ  " þ  $ þ  % þ
þ
þ
þ
þ
þ
þ
þ
þ
þ
þ
þ
þ
þ
þ
þ
þ

þ

þ

þ
þ
þ  !
þ    þ    þ    þ    þ    þ    þ    þ    þ
 þ
 þ
 þ    þ   þ  ! þ  " þ  # þ  $ þ  % þ  & þ  ' þ  ( þ    þ    þ    þ    þ    þ    þ    þ    þ
 þ
 þ
 þ    þ  þ  ! þ  " þ   !þ   !þ   !þ   !þ   !þ   !þ   !þ   !þ
!þ
!þ
!þ   !þ  !þ  !!þ   "þ   "þ   "þ   "þ   "þ   "þ   "þ   "þ
"þ
"þ
"þ   "þ  "þ  !"þ  ""þ  #"þ  $"þ  %"þ  &"þ   #þ   #þ   #þ   #þ   #þ   #þ   #þ   #þ
#þ
#þ
#þ   #þ  #þ  !#þ  "#þ  ##þ  $#þ   %þ   %þ   %þ   %þ   %þ   %þ   %þ   %þ
%þ
%þ
%þ   %þ  %þ  !%þ  "%þ  #%þ  $%þ   &þ   &þ   &þ   &þ   &þ   &þ   &þ   &þ
&[-D-] INSTRUMENTVIEW þ k1kþ S   þ A   þ M
  þ P
  þ L
  þ E   þ     þ     þ     þ     þ     þ     þ     þ     þ
  þ
  þ
  þ     þ    þ  !  þ  "  þ  #  þ  $  þ  %  þ  &  þ  '  þ  (  þ  )  þ  *  þ     þ  *  þ     þ èM þ C  þ h  þ a  þ n  þ g  þ e  þ
 þ I
 þ n
 þ s  þ t  þ r! þ u" þ m# þ e$ þ n% þ t& þ  ' þ &( þ k1kþ  *  þ     þ èM þ l  þ o  þ s  þ e  þ    þ s  þ e
 þ t
 þ t
 þ i  þ n  þ g! þ s" þ ?# þ k1kþ  *  þ     þ  *  þ     þ ­­­þ Y  þ e
 þ s
 þ N!  þ o"  þ k1kþ  *  þ     þ  *  þ     þ     þ     þ     þ     þ     þ     þ     þ
  þ
  þ
  þ     þ    þ  !  þ  "  þ  #  þ  $  þ  %  þ  &  þ  '  þ  (  þ  )  þ  *  þ ­­­þ Y   þ e
  þ s
  þ N! þ o" [INSTRUMENTVIEW] UPDATE type:1 [INSTRUMENTVIEW] instrument type changed!! þ ­­­þ s  þ a  þ m  þ p  þ l  þ e  þ :  þ    þ (
 þ n
 þ u
 þ l  þ l  þ )! þ v  þ o  þ l  þ u  þ m  þ e  þ :  þ    þ 1
 þ 2
 þ 8
 þ    þ [  þ 8! þ 0" þ ]# þ    þ  $ þ  % þ  & þ  ' þ  ( þ  ) þ  * þ ­­­þ p  þ a  þ n  þ :  þ    þ 7  þ F  þ    þ  * þ ­­­þ r  þ o  þ o  þ t  þ    þ n  þ o  þ t  þ e
 þ :
 þ
 þ C  þ   þ  ! þ 3" þ    þ  # þ  $ þ  % þ  & þ  ' þ  ( þ  * þ ­­­þ d  þ e  þ t  þ u  þ n  þ e  þ :  þ    þ 7
 þ F
 þ    þ
 þ    þ   þ  ! þ  " þ  # þ  * þ ­­­þ d  þ r  þ i  þ v  þ e  þ :  þ    þ F  þ F
 þ    þ  * þ ­­­þ c  þ r  þ u  þ s  þ h  þ :  þ    þ 1  þ 6
 þ    þ
 þ  ! þ  " þ  * þ ­­­þ d  þ o  þ w  þ n  þ s  þ a  þ m  þ p  þ l
 þ e
 þ :
 þ    þ 0  þ    þ  * þ    þ    þ    þ    þ    þ    þ    þ    þ
 þ
 þ
 þ    þ   þ  ! þ  " þ  # þ  $ þ  % þ  & þ  ' þ  ( þ  ) þ  * þ ­­­þ f  þ l  þ t  þ    þ c  þ u  þ t  þ /  þ r
 þ e
 þ s
 þ :  þ F! þ F" þ 0$ þ 0% þ t
þ y
þ p
þ e
þ :
þ
þ 0
þ 0
þ M
þ o
þ d
þ e
þ :
þ
þ o
þ r
þ i

þ g

þ i

þ n
þ a
þ l!
þ i  þ n  þ t  þ e  þ r  þ p  þ o  þ l  þ a
 þ t
 þ i
 þ o  þ n  þ :! þ  " þ l# þ i$ þ n% þ e& þ a' þ r( þ l  þ o  þ o  þ p  þ    þ m  þ o  þ d  þ e
 þ :
 þ
 þ n  þ o þ n! þ e" þ s !þ t !þ a !þ r !þ t !þ : !þ   !þ 0 !þ 0
!þ 0
!þ 0
!þ 0 !þ 0 !þ 0!!þ l "þ o "þ o "þ p "þ   "þ s "þ t "þ a "þ r
"þ t
"þ :
"þ   "þ 0 "þ 0!"þ 0""þ 0#"þ 0$"þ 0%"þ 0&"þ l #þ o #þ o #þ p #þ   #þ e #þ n #þ d #þ :
#þ
#þ 0
#þ 0 #þ 0 #þ 0!#þ 0"#þ 0##þ 0$#þ a %þ u %þ t %þ o %þ m %þ a %þ t %þ i %þ o
%þ n
%þ :
%þ   %þ f %þ a!%þ l"%þ s#%þ e$%þ t &þ a &þ b &þ l &þ e &þ : &þ   &þ - &þ -
&þ ­­­þ T  þ y  þ p  þ e  þ :  þ    þ S  þ A  þ M
 þ P
 þ L
 þ E  þ k1kþ s   þ a   þ m   þ p   þ l   þ e   þ :   þ     þ (
  þ n
  þ u
  þ l   þ l   þ )!  þ k1kþ L
  þ e
  þ g
  þ o   þ
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

Thread 371 (2025-02-09):

Auto save project file

maks, 2025-02-09:
It absolutely sucks to lose work. Auto saving at regular intervals would help with that, eg. in case of firmware crash or the battery dying or the user accidentally turning off the picoTracker.

I would expect to implement this by auto saving to the project data file to an alternate name, eg. `autosave.dat` and then delete that autosave file when a user does an explicit save on a project. Then, if a project is opened with an existing auto save file, it means it needs to be used instead of `lgptsav.dat`.

Closed 2025-02-15.

Thread 373 (2025-02-12):

sample load crash

Float-pixel, 2025-02-12:
[sample crash log.txt](https://github.com/user-attachments/files/18761943/sample.crash.log.txt)

if you audition a sample, then try to load the same sample while the audition is still going on, it can cause a crash.

I can reproduce this by making a new project, random name, make instrument 00 sample, audition a sample long enough to then try to load the sample while still auditioning. attached is a serial log.

This seems to happen specifically in new projects. Can be worked around by simply waiting for auditions to end before loading.

maks, 2025-02-12:
I'm pretty sure I know already why this happens: the file system is not intended to be accessed simultaneously from both cpu cores so there is a mutex to prevent that. But that would be exactly what would happen in this case as sample preview happens on core1 (audio rendering) while the file copy operation for importing a sample would be on core0 and so at best would stall core0 until the audio preview playback finished.
Instead we just need to add a check that prevents starting sample import if sample preview playback is in progress.

Closed 2025-02-13.

Thread 377 (2025-02-12):

Add option to choose when to send MIDI sync

wynwynyn, 2025-02-12:
At the moment, MIDI sync is sent on the playback of song, chain, and phrase by default. This is a bit annoying when trying to write and preview things like phrases, as every time you hit play it sets off any external gear attached to MIDI out.

Could we have an option to choose when sync is sent on playback, depending on level? The options could be something like:

`MIDI sync: [Off] [All] [Song] [Song + Chain]`

I those options would be enough - I can't imagine anyone would want sync on only Chains or Phrases.

Thanks!

maks, 2025-02-13:
Thanks for filing this issue 👍🏻

What I have in mind is options for `[Off]` `[All]` `[Song]` [In]` as I don't think there is much of a use case for anything other than sending in song mode only and of course incoming sync via Midi in is already on the todo list for v2.1

wynwynyn, 2025-02-13:
Yep, that sounds great! :)

wynwynyn, 2025-06-07:
Just to further on this one, my sequences/sync is also sent to anything receiving transport when I am inputting notes too! I can't remember this happening before, but it is a bit annoying :(

So for example, every time I hold A to add a MIDI note to a phrase, any external gear starts playing until the button is released.

maks, 2025-06-08:
@wynwynyn ah yes this will be because the note preview you hear when entering notes is actually implemented in code as the sequencer running that single phrase step.  That wouldn't be part of this though, thats just a bug so I've opened a separate issue for that: #659

Thread 379 (2025-02-13):

MIDI note off not sent correctly for MIDI chord cmds (MCH)

maks, 2025-02-13:
Chords should work like a single midi note in that a off is sent after the length (set in the midi instruments settings screen) or a KIL fx cmd.

They should also be cut off by a subsequent step note too as the channels are supposed to be monophonic (they are for sampler and synth instruments).

Closed 2025-02-17.

Thread 380 (2025-02-14):

Create and ship a set of factory samples and tracks

maks, 2025-02-14:
It would be helpful for new users to have a set of factory samples (as examples for working in required format) and tracks to get them started.

maks, 2025-02-14:
We want to be careful about licensing, so these will likely need to be uniquely created for the picoTracker or already available ones that can be distributed and a creative commons commercial use allowed license.

wynwynyn, 2025-02-14:
If it helps, happy to submit a demo track when this gets going!

wynwynyn, 2025-02-14:
Also I don't know much about licensing, but if I start recording samples myself from various bits of hardware (TR-606, RD-9, etc), would they be safe to use and distribute?

maks, 2025-02-16:
> Also I don't know much about licensing, but if I start recording samples myself from various bits of hardware (TR-606, RD-9, synths, etc), would they be safe to use and distribute?

Sorry I don't know the answer to that. But all good, I have much  more prosaic samples in mind that 💯  definitely will be safe to use and distribute :-)

maks, 2025-04-23:
This is one step closer now that #438 has been implemented and will ship in v2.1

Thread 382 (2025-02-14):

Clone operation keycombo does not appear to work

maks, 2025-02-14:
Per the user manual, `NAV`+(`EDIT`,`ENTER`) should clone but does not appear to work for tables, chains or phrases.

woeps, 2025-06-03:
Just reread the manual and retested this on `2.1-beta1r_003`.
Clone works fine in:
- Song View
- Chain View

I'm not exactly shure how this should even work in other Views. The manual states (and I verified this behaviour):
> Clone. This will overwrite the current Highlighted Item with a copy of itself using the **next unused Item** available.

I don't think there is such a concept of `next unused item` in tables or phrases?
Therefore I think this is desired behaviour and not a bug.

maks, 2025-06-04:
Thanks for testing this out @woeps ! 👍🏻  🙏🏻
Turns out that was my mistake of thinking it's NAV in the clone key combo while the user manual clearly has it as ALT. I think what happened is the user manual was previously incorrect when I opened this issue, I think fixed the user manual to list the correct key combo but forgot about this issue 🤦🏻

Closed 2025-06-04.

Thread 384 (2025-02-16):

Include AKWF single cycle waveforms in firmware

maks, 2025-02-16:
Given we have a reasonable amount of capacity for the firmware size we could  store single cycle waveforms directly in the firmware rather than requiring them to be loaded as sampler instruments.

The intention would be to use the public domain adventure kid pack. They are only 600 samples per wave, include [utilities for converting to header files](https://github.com/KristofferKarlAxelEkstrand/AKWF-FREE/blob/master/AKWF-png/convert.sh
) and which would also allow for creating images for use in documentation  and [PNGs are already provided](https://github.com/KristofferKarlAxelEkstrand/AKWF-FREE/tree/master/AKWF-png).

We could even make this into a dedicated instrument vs users needing to load them in sampler instruments as the a dedicated instrument could be optimised to consume much less ram than the current sampler instruments.

maks, 2025-02-16:
Actually turns out the existing scripting already [creates ascii art representations of the waves](https://github.com/KristofferKarlAxelEkstrand/AKWF-FREE/blob/master/AKWF-c/AKWF_0001/AKWF_0001.h#L13-L31).

Thread 391 (2025-02-23):

Switch from VOL to TPO crashes during playback

talktopag, 2025-02-23:
Steps to reproduce:

1.) New Project
1b.) Set master volume to not break ears.
2.) Chain 00 > Pattern 00
3.) Load a high-hat sound into instrument 00.
4.) Set-up pattern as so.

`00 C-3 I00 --- 0000`

`01 C-3 I00 VOL 0030`

`<Repeats>`

`0F C-3 I00 VOL 0030`

5.) Press play
6.) Change vol at 01 to TPO

talktopag, 2025-02-23:
Oops, forgot to mention this is 2.0 RC2.

talktopag, 2025-02-23:
Actually, this is way easier to reproduce. Just set TPO to 003A or less and hit play. I note the min tempo on the project screen allowed is 60 (3C).

Closed 2025-02-25.

Thread 392 (2025-02-25):

Allow saving project "checkpoints"

maks, 2025-02-25:
Following on from the new auto save functionality, we could also have the concept of "checkpoints" (ala classic "save game") where a user could save the current state of the project data to a alternative, autonamed file instead of `lgptsav.dat`, eg. `savepointA.dat`, `savepointB.dat` etc.
For convenience these could be trigger via a new keycombo instead of needing to go back to project screen each time. This would allow the user to quickly save a specific state when they next wanted to make some changes or if we had a quick way to revert back to previous checkpoint, this would allow the kind of mangle-settings-then-revert while playing workflow as available on some other grooveboxes.

This would also require some new UI to be able to reload a specific checkpoint, this would likely be a new UI button on the project screen.

Sadly because we dont have a realtime clock we cant label these checkpoints with timestamps (except for a "session time" of how long a project has been edited for) but some sort of round robin auto naming with letters or numbers would work here too.

Thread 403 (2025-02-27):

UITextfield is not a generic textfield

maks, 2025-02-27:
Currently `UITextfield` would be better named `ProjectNamefield` as its currently has several places where its hardcoded to assume its only used for the project name. This isnt a problem as the moment because it *is* only used for the project name field but for future use we would either want to make this an actual generic text field or change the name to reflect that it can only be used as is for project name.

Closed 2025-03-03.

Thread 416 (2025-03-08):

Freeze on Autosave if project folder doesn't exist

ngradwohl, 2025-03-08:
**Description**
If the "project" folder doesn't exist on the sdcard, but there is a project name in the ".current" file, picotracker freezes when it tries to autosave for the first thime

**Steps To Reporduce**
* Save a project
* delete the project folder from the sd-card
* reinsert the sd-card and boot picoTracker
* use it until it tries to autosave for the first time
* picoTracker freezes

**Expected Behaviour**
a more gracefull behaviour like printing an error message or trying to reconstruct the required folder structure

maks, 2025-03-09:
Thank you for filing this issue.
I think the problem here is that in `LoadCurrentProjectName()` there needs to be a check if the project name in the project state file (aka `/.current`) exists and if not, the state file should be cleared and untitled project should be loaded instead.

Thread 417 (2025-03-11):

"Loading <sample name>" not centered

es314159, 2025-03-11:
When loading samples with long filenames the filenames are not properly justified (e.g. Korg-TR-Rack-Standard-Kit-Snare-Drum-2.wav).  It looks like the length of the filename is used to determine where to start printing it on the screen so long filenames sometimes get printed on the wrong line and characters of earlier filenames sometimes persist.  Maybe just printing sample filenames starting from the left edge of the screen would be the fix.  Then they would wrap more naturally.

maks, 2025-09-26:
Fixed in #810

Closed 2025-09-26.

Thread 419 (2025-03-13):

Crash when chaging OPAL settings while sequencer is running

maks, 2025-03-13:
Reported by a user:

>When playing  a phrase pico crashed when I started changing opal settings. I hit the upper right button and it fully crashed the unit

Thread 420 (2025-03-17):

Per channel volume settings

maks, 2025-03-17:
Currently the master volume is being applied to all the channel mixbuses as well.

Once #412 is merged we can instead have per channel volume settings. These can be shown as UI on the mixer screen under each channel and be stored in project data.

maks, 2025-03-18:
Currently applying the master volume is applied when `if (volume_ != i2fp(1))` **but** this is not just applied to the master mix down audiomixer but each of the channel submixes. Given the volume application code is:
```
fixed v = fp_mul(*c, volume_);
```
**per sample** this can cause a significant cpu load if the user chooses to set a non unity (ie value other than `140`) for the master volume.

Instead I propose that both the master volume and each channel actually become a 16 step "attentuation factor" so that it can be implemented very cheaply as a bit rotation operation (single asm instruction) per sample instead of the using an FP multiplication which is approximately 30 asm instructions.
The UI would then place this a single hex digit value under each channel (next to the existing `M` mute indicator) and under the master channels VU meters on the Mixer screen, removing the current master volume ui from the Project screen.

faithanalog, 2025-04-16:
> Instead I propose that both the master volume and each channel actually become a 16 step "attentuation factor" so that it can be implemented very cheaply as a bit rotation operation (single asm instruction) per sample instead of the using an FP multiplication which is approximately 30 asm instructions.

Having tried this in my tracker, it unfortunately doesn't prove as useful as one would hope. anything past a few bit shifts becomes increasingly useless, and all the inbetween values seem to matter quite a lot both for choosing a comfortable volume and for mixing channels.

I'd do it as 32-bit multiplication rather than a bitshift. I can work on this after i finish the synth I'm working on, should speed things up.

maks, 2025-04-16:
Yeah @faithanalog 💯 we quickly came to same conclusion, I actually forgot to update this issue as after our previous conversation I had already decided to use your recommendation of multiplying by just 8bits and so fitting to FP into 32 bit multiplication instead of needing to use slow 64bit ones for full FP math.
I'm actually planning to get to this shortly as I want it done for v2.1 to go with the new mixer screen.

faithanalog, 2025-04-16:
nice!!

Closed 2025-05-08.

Thread 421 (2025-03-17):

Currently selected channel needs to be preserved when moving between song and mixer screens

maks, 2025-03-17:
Currently there is no mechanism to preserve the current channel (that the cursor is on) when moving between the song and the newly added mixer screen (once #412 is merged).

So we need to add a way of storing this state in such a way that it can be passed between the song and mixer screens, possibly using existing viewdata_ view object field.

maks, 2025-05-07:
This will be fixed in #524

maks, 2025-05-15:
Fixed in #524

Closed 2025-05-15.

Thread 422 (2025-03-18):

Make picoTrackerFilesystem be a abstraction layer

maks, 2025-03-18:
When the new pT Filesystem was implemented, `PI_File` and `PI_Directory` were not made into an adaptor level abstraction as `I_File` and `I_Directory` were. This needs to be fixed to allow for adaptors to provide implementations instead of being hardcoded currently in `Filesystem/` by `picoTrackerFilesystem.cpp`

Closed 2025-04-14.

Thread 424 (2025-03-18):

Groove Window have preset mini view

scarmory2, 2025-03-18:
This is just an idea I've had for a while because I really enjoy learning the tracker, but I don't like how the groove values have to be searched online from lsdj or figured out/mess/ to get a specific scale... If there was a way to pop a tiny view with certain values that could make for example:
**x2** scale, **x3** scale and so forth without having to search it or visualize it in my head, that way people can get into grooving directly, and also user friendly to both new and old tracker users. Maybe just hold one button that is not assigned to anything and directional pads.

maks, 2025-03-18:
@scarmory2  Thank you for filing this issue.

I'm sorry my music theory isn't the best, so I don't think I understand what you are asking for here, as far as I know,  grooves are to do with sequencer timing and moving things "off the grid" (ie. "swing") and not scales or am I misunderstanding something here?

scarmory2, 2025-03-18:
I guess an example would be like...; I make a track on a sequencer. And I can have 1 to 4 bars. with 1 bar I could scale it to 2x or 8 times and make it slow... I  think what I was explained once that there are several ways to do it on the m8 or tracker workflow in general if I'm correct, I know groove is used as swing, but I was told a way to achieve scaling a track is with grooves with certain combinations.. I know it starts with 7 and 6 and it keeps ticking back and forth in the regular 4x4 speed. This might be a better way of explaining it?

scarmory2, 2025-03-18:
So I always thought a little window with different combination examples would be a fantastic idea of "scaling" the tracks with swing, if it works this way.

maks, 2025-03-18:
@scarmory2 thanks for the clarification, I think I see what you are getting at here.
I'm not sure it works that way on the pT or even other trackers which have the groove function.
Grooves are a way to changing the timing of each step in a phrase, to make the step last longer or shorter than its "normally allocated" 6 ticks of time.
For instance if you were to set a groove to `C,C` that would make every step in a phrase last twice as long, ie. change them from quarter notes to half notes.
I guess we could have some ui for common variations, but do you have some sets of groove variations in mind that you would use regularly that would be good candidates for this list?

scarmory2, 2025-03-18:
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

Well I guess I wouldn't say I have a a specific scale I would personally use set in stone.. but I do find myself on occasions experimenting with a track scale on my XY to fit something to my needs or elongate 1 bar or 4 of them. So I would just go from the standard. If 7 and 6 create the regular groove of 4x4.. maybe we could figure out or find out what they've tried using in lsdj to mimic the rest from 4x4 (four on the floor) which is groove 7hex, 6hex (Is that right?) to 2x scale.. 3x scale, up to 9x scale.  I know in a sense I could also do that on the pico or m8 by just making a pattern longer, but that would require to keep using more pattern slots and could help focus easier on one pattern, no? Might be good for looping and adding RND values or such!

I'm a visual and action learner so the layout of the XY's pattern and arranger has helped me make my song progressions clearer and made me understand creating music a bit more.  The XY also has a little window that shows you the scales and choose. It is always necessary to hit that button for the scales though so it is a feature that it needs it there unlike the trackers. I just thought it would be neat for dummies like me! Either way, this is not too serious or has to be done, but it would definitely be a nice addition.

I found this on google not sure if it can help..
https://chipmusic.org/forums/topic/19262/lsdj-wav-timing-scales-and-chords-reference/
https://docs.google.com/spreadsheets/d/1fY5Ym7amJGOtIk9fmmyPMMIpTtH7K2xI_zyJXKzAWqg/edit?gid=0#gid=0

Thread 426 (2025-03-18):

Copy/Cut/Paste UI is different between Song Screen and Chain, Phrase Screens

es314159, 2025-03-18:
It's confusing.  The Copy/Cut/Paste flow is different on the Song Screen. Paste works more like "insert" pushing down the rows below the insertion point instead of pasting over them. It pastes over in the Chain and Phrase screens (instead of "inserting").  Also when an chain is deleted on the song screen the whole column shifts up instead of just deleting the selected chain(s).  The only way to get the song back in shape is to copy/paste (i.e. copy/insert) a empty chain location(s) (which pushes the column back down) and then delete the chain you wanted to delete in the first place.  This is cumbersome.  Why not just use the same Copy/Cut/Paste methodology on all screens?

Thread 429 (2025-03-19):

Keycombo to reset a edit field to default value

maks, 2025-03-19:
For those fields which have a default value, it would be helpful for users to have a keycombo to reset back to a default value.

From a users feedback on discord, `ENTER`+`EDIT` would be a good combo for this as it is used as "cut/delete" in grid editing screens.

Thread 433 (2025-03-20):

Render selected song sections to samples

maks, 2025-03-20:
Once #432  is merged, the next step would be to use this functionality to render out selections of the song screen to allow users to create samples of multiple channels (eg. chords) or just to reduce cpu load in pre-rendering to a new sample a sample instrument that makes heavy use of filtering and interpolation.

 Rendered samples should be saved in the samples directory of the current project.

As a nice workflow quality-of-life ux a rendered sample could be immediately added as a new sampler instrument to the current project.

Thread 435 (2025-03-23):

Click or pop at end of sample playback

jobf, 2025-03-23:
Using firmware v2.0 RC3 there is a click/pop at the end of every sample has completed playback.

maks, 2025-03-23:
Thank you for opening this issue.
Would you please be able to provide a example sample file where this is occurring or a picoTracker project (as zip file) which demonstrates this happening?

jobf, 2025-03-23:
I'm hearing it during song playback and when previewing samples.

Example wav files are in the attached zip along with a recording from pico audio out while previewing them in alphabetical order.

[pop-example.zip](https://github.com/user-attachments/files/19411278/pop-example.zip)

Let me know if you still need a project and I'll put one together, the pop is the same either way.

es314159, 2025-03-24:
I've had this problem too for a while using the same release.  At first I thought it was because my samples didn't end exactly at zero crossings.  I tried fixing that in Audacity and giving them a smooth decay but it didn't eliminate the click/pop.  It's especially noticeable when I use KILs to trim every note that uses a sample. I can hear it when I use a STP command as well.  In fact, even when I use a VOL command to ramp down the sound I can hear the click/pop when the sound is finally terminated.  Maybe there's an extra non-zero byte in the buffer holding the sample.

faithanalog, 2025-04-07:
I'm noticing that I hear the pop specifically whenever the *master output* goes to zero. So if you only have one instrument playing, thats whenever the instrument ends. I'm getting this even with my custom synth engine which I confirmed with debug is fading out correctly

If I prevent it from fading out all the way, and instead leave an instrument oscillating at a non-zero volume (but so quiet i cannot hear it with my own ears, so basically silent), the pop never happens.

The reason I know it is the master output is because if i have a layout like this

```
01 02 -- -- -- -- -- --
```

If `01` is making clicking noises, I can make them go away by playing a quiet (inaudible, but non-zero) signal in `02`

maks, 2025-04-08:
@faithanalog Thanks for debugging that further! 👍🏻
That is really helpful in trying to track down what is causing this!
My first guess based on your results is that perhaps this could be due to how the "miniblank" buffer is used? https://github.com/xiphonics/picoTracker/blob/a60ef8077763826487cc0a2974f13e4d13b75489/sources/Adapters/picoTracker/audio/picoTrackerAudioDriver.cpp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

but that's just a guess though could be a good starting point to debug this further.

faithanalog, 2025-04-08:
You're not gonna believe this, it's the audio codec chip...

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

from https://www.ti.com/lit/ds/symlink/pcm5102a.pdf

I modified the audio_i2s.pio to always write a `1` in the least significant bit of the 32 bit value sent to each channel and the clicking went away

maks, 2025-04-08:
@faithanalog great job for figuring this out! After re-reading the PCM5102a datasheet and then looking at our circuit I can't figure out where the DC offset comes from, perhaps because we don't use the soft mute function on the DAC? 🤷‍♂
But I'm very happy you tracked this down! so do submit a PR when you get a chance.

maks, 2025-04-15:
Fixed in #449

Thread 442 (2025-04-02):

Feature Request: Set Unused Instruments to "None" when Compacting

es314159, 2025-04-02:
Simply doing a "Compact Instruments" operation does not actually remove the unused instruments.  A user has to go through all their chains to find all the instruments that are not used and then set them to "None".  Then "Compact Instruments" works.  It would be more convenient if the software figured out which instruments are not being used by any chains and set them to "None" automatically.  Or maybe that was the way it was supposed to work.

Similarly it would be nice if there were an option to remove unused chains & phrases (i.e. chains and phrases not on the song screen) so that they could be recycled and reused.  Sometimes a user may want to keep unused chains and phrases so it would have to be an option like "Compact Instruments" or users could squirrel away chains in another part of the song screen.  That would prevent them from being deleted.

Version. picoTrackerv2-2.0.uf2

maks, 2025-04-02:
Thank you for opening this issue.
I have to admin I don't follow, are you referring to Phrases when you say "Chains"? because chains don't have references to instruments, only phrases do.

In regards  to the second point, yes there was code and a UI item that came from lgpt to remove unused chains and phrases but it didnt seem to really work so I removed it from the UI but it could definitely be brought back in the future, please open a separate issue for that request.

es314159, 2025-04-03:
Sorry for the confusion. What I meant was: If a sample instrument is not used by any phrase that is currently in a chain which is on the song screen then the sample instrument should be marked as "None" so that "Compact Instruments" will actually remove the sample from the project.  Currently this doesn't happen.

To get the "Compact Instruments" to remove samples from a project. I had to look through all my un-used phrases to find un-used instruments and change them to "None".  Then they got removed from the project.

Does that explanation help?

maks, 2025-04-08:
Thank you, yes that does help.
I think to get that functionality it would make most sense to keep the existing "Compact Instruments" as is and then bring back the lgpt "Compact Sequencer" function, which was documented in its manual as:
> **Compact Sequencer:** Free all unused chain/phrases.

Thread 443 (2025-04-07):

Log ETL errors with Trace

faithanalog, 2025-04-07:
It'd be nice for ETL errors to go into the log so they're easier to get at

Closed 2025-04-08.

Thread 448 (2025-04-08):

MIDI message CC 7 could be optional ?

jobf, 2025-04-08:
I was sending MIDI to a Roland SC-155 which has sliders for controlling the volume of individual MIDI channels. This has the effect of attenuating the individual MIDI note velocities.

I found that the channel volumes were being overridden by messages from the picoTracker, due to the Volume CC message being sent, see https://github.com/xiphonics/picoTracker/blob/5ebd08bba9894481da678f543bf5752fe26dfe27/sources/Application/Instruments/MidiInstrument.cpp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

For my purposes the CC 7 message does not need to be sent because individual notes are sending velocity and we can issue a Volume command if needed. I modified the source to only store the volume as the initial velocity, rather than queuing the message, see https://github.com/xiphonics/picoTracker/blob/dd7190a4490d67d6567bfcf4141a32bafcd878cd/sources/Application/Instruments/MidiInstrument.cpp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

From talking to @maks it might be better to have this behind an option; to send the CC 7 message or not.

maks, 2025-04-09:
Thanks for opening this issue!

After thinking about this a bit more, I think the current behaviour is not correct because its conflating 2 distinctly different concepts: MIDI instrument volume (CC7) and the *velocity* for a Note On message to an instrument. So in I think now that its a mistake to use the MIDI Instruments volume as the initial velocity value.

Instead what I would propose is to make 128 as the initial velocity value, which can then be modified if needed on a per note basis using the existing `VEL` fx command. I would then change a value of 0 to mean that CC7 is **not** sent on instrument start as I don't see much use for turning *off* an external MIDI instruments volume when the pT instrument for its starts and users still retain the flexibility of sending the CC7 MIDI message for any value they want including zero via the existing VOL fx command.

@jobf please let me know if the above sounds reasonable from your use cases? If so I'd be happy to accept get a PR implementing the above (ie. not setting initial velocity from instruments volume and not sending CC7 on start if volume == 0).

jobf, 2025-04-09:
@maks Yes I think you're right, it makes sense to keep Volume and Velocity separate and I like the idea of opting out of sending the channel Volume by using a value of 0, expect to see a PR soon!

I've been working on some contributions to the MIDI documentation too but I'll hold off until this feature is in and then include it on the docs.

Closed 2025-04-14.

Thread 450 (2025-04-08):

screen stops updating sometimes

faithanalog, 2025-04-08:
behavior is typically that I am editing an instrument or something and then the screen locks up and stops updating.

Input events continue to work, audio continues to play. I can start stop song. Under the hood, UI navigation is still happening, I can navigate between the play screen or the instrument screen, edit instruments, etc. just no screen updates.

So far what I have tracked down is that, when this happens

- picoTrackerEventQueue::push is being called with events to update the screen, but is not actually pushing them. this `if` statement is always false so the deque push never runs
- picoTrackerEventQueue::empty is always returning true, so the queue does not actually contain anything

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

From this we can see that
- Queue `current_size` is 0
- Queue `_begin` has index 2
- Queue `_end` has index 1

While on this breakpoint, I then manually updated `_begin`'s index to `1`

```
(gdb) set var _begin.index = 1
```

Note that `current_size` is still 0, so `empty()` is still true.

After resuming, screen came back to life again!

What this indicates to me is that ETL deque's begin()/end() iterators might not work in a way that is compatible with `std::find()` in the typical usage of `std::find(begin(), end(), value) == end()`.

faithanalog, 2025-04-09:
So I did some looking, ETL doesn't have a `find` for dequeue, but I don't think we need it.

I've got this compiled and seems to be working

```cpp
void picoTrackerEventQueue::push(picoTrackerEvent event) {
  // Don't queue this event if is already pending
  for (picoTrackerEvent &e : queue_) {
    if (e == event) {
      return;
    }
  }

  // Not already in queue, so we add it.
  queue_.push_back(event);
};
```

I'll run with this for a bit and PR if it proves stable

maks, 2025-04-09:
Hmm I quickly tried this and it seemed to compile ok:
```
if (etl::find(queue_.begin(), queue_.end(), event) == queue_.end()) {
    queue_.push_back(event);
 }
```
but your way is fine too.

As far as I know this would only be accessed on core0 as the only thing that core1 does is run the audio processing code.

But I think what _could_ be happening to cause a race condition is that this queue may be accessed from a IRQ handler but given key inputs are just polled from the main loop in `picoTrackerEventManager::ProcessInputEvent()` the only candidate I could find for the queue being touched from a IRQ handler is `timerHandler()` which is the 1khz hardware timer we have.  So perhaps that's the source of the race condition and we should protect queue access with a mutex?

faithanalog, 2025-04-09:
ah admittedly i was just searching the etl website, and maybe i wasnt looking in the right place

maks, 2025-04-09:
@faithanalog no all good, the etl docs can be a bit sparse!

And actually the more I think about it, the more I believe you **are** on the right track to suspect a race condition causing a corruption of the queue! 👍🏻  Given all the user reports from in #332 I think this is very likely the root cause as its just a matter of how  long it takes for user interactions to occur at an unlucky timing related to the 1kHz timer handler running and corrupting the queue.
What do you think?

faithanalog, 2025-04-14:
I think you are right about that, i think that problem is the same as the one im hitting just i didn't manage to find it when looking over older issues.

Also, interesting, my change has so far prevented any lockups on my system. If it is indeed a race, it's possible my code is just more resilient to the most common consequence of the race, and there are other lurking problems that could occur.

maks, 2025-04-14:
@faithanalog I'm pretty sure now it is a race condition because the queue is modified from both the interrupt handler and mainloop code.  [ETL seems to provide queues specifically for this case](https://www.etlcpp.com/concurrent_queues.html) so I'm in the process of doing an PR for that.

Given the race needs specific conditions of the interrupt occurring at exactly the same time as the mainloop is accessing the event queue I suspect this is quite unusual so hence why its been so hard to replicate. And all good about filing this issue you've done an amazing job diagnosing this!! 💯  🙏🏻

maks, 2025-04-23:
Fixed in #465

Closed 2025-04-23.

Thread 458 (2025-04-12):

Check for modified instruments doesnt work correctly

maks, 2025-04-12:
The current check for if a instrument has been modified is incorrect. Instead the check needs to iterate through every field comparing current value against default value and if any are different return a result of "modified".

Closed 2025-05-07.

Thread 459 (2025-04-12):

Different key combo for opening sample import browser

maks, 2025-04-12:
Using `ENTER+ENTER` as the current key combo to open the sample import browser is not consistent with the rest of the UI and feels like a strange outlier.

Instead we should allow using just `ENTER` or `NAV+RIGHT` for better UX and consistency with the rest of the UI.

maks, 2025-04-25:
Just `ENTER` seems to be a good pick as its already used for `Load` on Project screen and now the new Theme screen on Device screen.

Closed 2025-05-06.

Thread 461 (2025-04-13):

v2.0.1 fix list

maks, 2025-04-13:
This issue will collect the list of PRs cherry pick into the 2.0 release branch for the next `2.0.1` stable patch release.

maks, 2025-04-13:
https://github.com/xiphonics/picoTracker/pull/460

maks, 2025-04-13:
https://github.com/xiphonics/picoTracker/pull/449

maks, 2025-04-14:
#465

maks, 2025-04-17:
will also need to first take #446  build now that CI has switched to gcc13

Thread 463 (2025-04-13):

Feature request: shift rows up or down

jobf, 2025-04-13:
I'm not sure what the key combo would be but it would be useful if we had a control for shifting all rows in a phrase or chain up or down.

For example shifting up would delete the current row and move all proceeding rows up by one. The reverse operation would be to insert a blank row, shifting all proceeding rows down.

maks, 2025-04-13:
This is a great idea! Of course you can do this now with cut/paste but having a dedicated short cut for this would definitely be  nice to have! Question of course is what key combo to use...

jobf, 2025-05-02:
There aren't many combos left from what I can see...

Suitable candidates (ergonomically speaking), would be ENTER+UP/DOWN or EDIT+UP/DOWN but these are already taken.

So perhaps it could be hold ENTER, then press EDIT, then UP/DOWN ... although I'm not sure if it's possible to discern between pressing ENTER to Insert Chain/Phrase/Note and holding ENTER for this combo.

Maybe we can do a double tap on UP/DOWN to do it? Though I think it would be too easy to perform that move by accident.

jobf, 2025-05-04:
Perhaps holding LEFT and then press EDIT to shift up or ENTER to shift down would work (and feel quite ergonomic)?

maks, 2025-05-05:
To be honest I'm a rather cautious about using more and more complex key combos. I can definitely see the usefulness of this functionality but at the moment I don't see a good key combo that could be used to do it.

woeps, 2025-05-18:
I'm aware it is kind of complex, but intuitively I would expect such functionality, when I selected a range:

1. `ALT + EDIT` to start selection
2. `ARROW` etc to modify selection
3. `ENTER + ARROW` to move selection
4. Selection is done / lost, once `ENTER` is released

Thread 467 (2025-04-14):

Remove excessive static ram usage from MIDI input

maks, 2025-04-14:
The addition of MIDI input put into use previously existing but unused statically allocated arrays in `MidiInDevice.h`:
```
  MidiChannel *ccChannel_[16][128];   // Control Change
  MidiChannel *noteChannel_[16][128]; // Note on / note off
  MidiChannel *atChannel_[16][128];   // After touch
  MidiChannel *pbChannel_[16];        // Pitch bend
  MidiChannel *catChannel_[16];       // Channel after touch
  MidiChannel *pcChannel_[16];
```

These are far too large a ram usage, are not used (nothing currently reads them) and should be removed along with the code that populates them.

Closed 2025-04-15.

Thread 469 (2025-04-14):

Hidden function GuiWindow::Clear

jobf, 2025-04-14:
Something in this commit makes compilation on gcc-14 fail https://github.com/xiphonics/picoTracker/commit/ad983ad44e168f38cfc1266f3136fd8be24f2eec

```
In file included from /code/picoTracker/sources/Application/Views/BaseClasses/UIField.h:6,
                 from /code/picoTracker/sources/Application/Views/BaseClasses/UIActionField.h:5,
                 from /code/picoTracker/sources/Application/Views/InstrumentView.h:5,
                 from /code/picoTracker/sources/Application/Views/InstrumentView.cpp:1:
/code/picoTracker/sources/UIFramework/SimpleBaseClasses/GUIWindow.h:47:8: error: 'virtual void GUIWindow::Clear(GUIColor&, bool)' was hidden [-Werror=overloaded-virtual=]
   47 |   void Clear(GUIColor &, bool overlay = false);
      |        ^~~~~
In file included from /code/picoTracker/sources/Application/Views/BaseClasses/UITextField.ipp:1,
                 from /code/picoTracker/sources/Application/Views/BaseClasses/UITextField.h:36,
                 from /code/picoTracker/sources/Application/Views/InstrumentView.h:12:
/code/picoTracker/sources/Application/AppWindow.h:54:16: note:   by 'virtual void AppWindow::Clear(bool)'
   54 |   virtual void Clear(bool all = false);
```

I was able to get it compiling again with this... https://github.com/xiphonics/picoTracker/compare/master...jobf:picoTracker:gcc-14

maks, 2025-04-14:
Thanks for letting me know. I'll look into why its causing that error, but in general I would recommend using the same GCC version as we have for CI (Github Actions) which is currently gcc13 as thats basically what determines what gets merged so we won't notice things like this because they wont get picked up by CI runs.

I just noticed that I forgot to update the contributing guide to point out the above so I'll do that.

jobf, 2025-04-15:
Ah, good point! I haven't actually tried on gcc-13 but will look into getting that set up.

jobf, 2025-04-16:
Yup, as expected it's all good on gcc13.

I've put some notes in a gist, in case it's helpful for others (or my future self) -  [Compile picoTracker on arch linux](https://gist.github.com/jobf/fe584f1d065f7ae3cd0c0aabeda4c507)

Closed 2025-04-16.

Thread 478 (2025-04-16):

Fix tempo nudge implementation and document it

maks, 2025-04-16:
As illustrated [in this PR](https://github.com/xiphonics/picoTracker/pull/216) by @djdiskmachine there is a bug in tempo nudge feature and the feature is also completely undocumented.

The PR has bit rotted a somewhat so I will need to be reimplement it to match current codebase.

Closed 2025-04-17.

Thread 480 (2025-04-16):

Loading a sample hangs

jobf, 2025-04-16:
I pulled latest and have found an issue loading samples while browsing.

Preview is working fine, but when I try to load the sample into my project, it hangs on the screen that say "Loading %SAMPLENAME%"

If I load a project then all the samples are loaded correctly, just can't load new ones to a project.

Going back to this commit, sample loading works again ... https://github.com/xiphonics/picoTracker/commit/cc95beb94dadd7460ce329ac74e227a5d69c6f59

maks, 2025-04-16:
Hmmm. Would you please be able to quickly try this branch and see if the same thing happens:  https://github.com/xiphonics/picoTracker/tree/48-audition-single-cycles

jobf, 2025-04-16:
Working fine in that branch.

jobf, 2025-04-17:
On further testing, it's failing to load sometimes in this branch and also on the revision I previously thought was OK.

I can't see any pattern to the fail state, it's not happening with specific samples.

jobf, 2025-04-19:
I'm doing the regular build as outlined here https://github.com/xiphonics/picoTracker/blob/master/docs/DEV.md#building-optimized-version

Haven't tried debug build but happy to try if it can help.

maks, 2025-04-20:
Ok thanks for confirming @jobf I wanted to check because[ I had recently removed a workaround that was specifically only for debug builds](https://github.com/xiphonics/picoTracker/pull/438/commits/9e6b6ac96c22ceeb1a3885e572edc95640162cf6) hence why I was keen to find out if this was the cause of what you were seeing. I guess though that it could potentially have an impact even on release builds as it wasn't gated behind a define for debug builds.
If you could test if putting that code back fixes the import issue you are seeing that would be very helpful.

maks, 2025-04-20:
Awesome thanks so much for testing that!
I'll go ahead and put that back though I'll try to do the delay in a slightly cleaner way (can't use normal sleep function calls as it's in code where interrupts are disabled).

And yes definitely want to have import progress UI. I actually did an initial go at that quite a while ago but it has some issues and I never went back to fix it up, but I'll try to prioritise that in near future. 👍

maks, 2025-04-28:
I've put back the delay when loading samples into flash in a commit for PR #476 so  this should be fixed once that PR is finished and merged.

maks, 2025-04-30:
Now fixed in #476

Closed 2025-04-30.

Thread 484 (2025-04-18):

2.0.1 causes popping when turned off

maks, 2025-04-18:
The previous fix for the issue of occasional popping when playback stopped now unfortunately causes a load pop when the device is turned off so we will need to revert that.

Closed 2025-04-21.

Thread 486 (2025-04-18):

Song plays too fast, buffer overruns, when 8 channels Trigger on the exact same step

faithanalog, 2025-04-18:
So this is a weird one...

I'm getting a behavior that when 8 channels are triggered simultaneosly, the audio engine starts trying to add too many buffers to the output queue (i.e. it is speeding up the song! rendering too much audio!). This is of course kind of hard to test unless you're capable of playing 8 channels. So for now this is mostly a tracking issue for me, but I want to figure out why this is happening before my new synth makes its way to a mainline build. There's a chance it's my fault somehow anyway, though I'm not sure how that'd be the case.

I need to emphasize that as far as i can tell, this is only when all 8 channels *trigger* on the same step. They can all be actively rendering on the same step and everything is fine, it's only if they all trigger together that there are problems. This is why my demo video didn't have this problem even with 8 channels going, i don't usually compose tracks in a way where all 8 channels are going to trigger on the same step because syncopation and whatnot.

maks, 2025-04-18:
@faithanalog have you tried a combination of your synth and samples triggering on all 8 channels at once too?
But yes this likely is a bug that no one has noticed before because its not really possible to have 8 samples triggered at once without getting audio underruns

faithanalog, 2025-04-18:
i haven't yet, mostly because i don't have any samples on my sd card 😅, but i was wondering the same thing, and will give it a try

Thread 487 (2025-04-18):

Have separate preview volume setting and a UI for it

maks, 2025-04-18:
While the preview volume now [respects the master volume](https://github.com/xiphonics/picoTracker/issues/335) this is awkward because it requires changing the master volume which is located in the Project settings "at the very other end" of the screen map from the sample import browser.

It would be better to have a separate volume (attenuation) that users could apply for previewing samples and provide a UI (keycombo?) in the import sample browser to adjust it.

Closed 2025-05-06.

Thread 490 (2025-04-20):

Remove restriction of navigating out of the /samples directory

maks, 2025-04-20:
Currently the sample import file browser restricts navigating outside the `/sample/` directory and its subdirectories.
But this is too limiting for no particular reason and prevents users loading samples from directories that may have samples created by other devices where the location may not be user configurable and with this restriction requires the user to use a computer to move recorded samples around.

Closed 2025-04-28.

Thread 491 (2025-04-20):

Column should be preserved when navigating up/down in column-layout FieldViews such as OPAL

faithanalog, 2025-04-20:
Currently, navigating up/down in multi-column `FieldView`s resets the focus to the leftmost column. It would be nicer if it maintained the column.

maks, 2025-04-25:
Done in #492

Closed 2025-04-25.

Thread 494 (2025-04-20):

Allow applying preprocessed effects to samples

maks, 2025-04-20:
The pT for example doesn't have the ram for long enough delay lines to do delay or reverbs in realtime well but these could potentially be applied to samples as a preprocessing step (eg. writing the effect out to a temp file on sdcard) without the requirement of having to be done in realtime during sequencer playback.

Thread 498 (2025-04-23):

Clearly mark in user manual new features in v2.1

maks, 2025-04-23:
* mixer screen
* midi in
* render exports
* naming instruments
* vu meter

maks, 2025-04-24:
Should also take the opportunity to fix up the Songs screen chapter to not repeat the Song<->Live switching keycombo 3 times, where one of the times is still the wrong key combo! 🙁

maks, 2025-04-27:
@democloid alternative proposal to this is to only build and deploy the user manual from release branches, eg. currently that would be `2.0-release" so then user manual matches the currently released stable firmware only.

maks, 2025-05-02:
Fixed in #522

Closed 2025-05-02.

Thread 506 (2025-04-28):

reserve colors for future use

maks, 2025-04-28:
We should be able to use the existing highlight 1 & 2 colors for things like `00` & `FE` chains and play/mute indicators so we can reserve the previously added colours from LGPT for future for other UI elements.

In relation to coloring blocks of steps (eg. how the 4 step blocks was recently added) we might want to also color the background of each row as well?

FYI @democloid

maks, 2025-04-28:
In further testing, actually finding already that using different colors is immediately helpful for working with 00, FE chains and beats in phrases.
Also this issue was based on incorrect assumption that color name labels in the **UI** couldnt be easily changed in the future.

So altered proposal for this issue is to keep all colors and just assign more generic names.
First proposed naming scheme is musically themed whimsical:
* Major
* Minor
* Accent
* Sharp
* Flat

Second is more staid:
* Accent
* Sidebar
* Emphasis
* Note
* Extra

maks, 2025-04-29:
@democloid to clarify the previous comment a bit more, given the following newly added colors:
```
const uint32_t DEFAULT_PLAYCOLOR = 0x00FF00;
const uint32_t DEFAULT_MUTECOLOR = 0xFF0000;
const uint32_t DEFAULT_SONGVIEWFECOLOR = 0xFFA500;
const uint32_t DEFAULT_SONGVIEW00COLOR = 0x0000FF;
const uint32_t DEFAULT_ROWCOLOR = 0x555555;
const uint32_t DEFAULT_ROW2COLOR = 0x777777;
const uint32_t DEFAULT_MAJORBEATCOLOR = 0xFFFF00;
```
I would instead have:
```
const uint32_t DEFAULT_ACCENT = 0x00FF00;
const uint32_t DEFAULT_ACCENT_ALT= 0xFF0000;
const uint32_t DEFAULT_EMPHASIS = 0xFFA500;
const uint32_t DEFAULT_RESERVED1 = 0x0000FF;
const uint32_t DEFAULT_RESERVED2 = 0x555555;
const uint32_t DEFAULT_RESERVED3 = 0x777777;
const uint32_t DEFAULT_RESERVED4 = 0xFFFF00;
```

That leaves 4 colors reserved for future use and currently not displayed in themeview.

I would display **currently** only the following in theme view:
```
Accent:
AccentAlt:
Emphasis:
```

And to implement the "LGPT features" with the following new an existing colors:
```
rowcolor->accent
rowcolor2->accent_alt
songview00->accent
songviewfe->accent_alt
playcolor->info
mutecolor->warning
majorbeat->emphasis
```

maks, 2025-04-29:
As a small related addendium to this, the theme screen should be fixed to move the Import/Export fields to the top of the screen above the Font field.

Closed 2025-05-06.

Thread 508 (2025-04-29):

Player::StopNote should take note parameter from MidiInDevice

chrcav, 2025-04-29:
Right now if using a keyboard and holding multiple keys any of the key releases send a Midi Note Off and kill the playing note even if the note being played is still held down. At least for me this causes notes that I play in a sequence to get cut off if I'm not careful to fully release a key before pressing a new one.

chrcav, 2025-04-29:
It seems safe to just add the note to `Player::StopNote()` since it's only called in `MidiInDevice`. From there calling `PlayerMixer::GetChannelNote()` to compare to the note parameter before calling `PlayerMixer::StopInstrument()`.

Are there any concerns with this approach that I'm missing?

maks, 2025-04-29:
Thanks for spotting this issue @chrcav  👍🏻

I'm not sure though about what you're suggesting. We do 💯  need to track currently playing notes to fix this but I think this is rather something that should be handled by  MidiInDevice::treatChannelEvent()

Also I had in mind to enable chromatic polyphonic playback in future (though only single not multi-timbral) so need to keep that in mind while working on this.

Closed 2025-05-23.

Thread 509 (2025-04-29):

Pan values feel reversed

maks, 2025-04-29:
Currently a value of `00` is right pan all the way while left pan of `FE` and if you were to map these to a dial `0` would normally be on the left while max value on the right.

This would be easy enough to change **BUT** I'm not sure if it will be possible to change this at this point or maybe its not that big a deal to break backwards compatibility on this, would love to hear what others think about this?

maks, 2025-04-29:
This is not really much of an concern with the current pT UI BUT will be once the coming MIDI input support improves as this would be a candidate for a CC and as things stand now I guess me might end up doing a inverse value mapping to make it work sensibly as is

wynwynyn, 2025-04-29:
This hasn't been a concern / haven't noticed it yet and I use panning quite a bit, but if this improves UX for people then I fully support it!

maks, 2025-04-29:
Thanks for the feedback @wynwynyn 👍🏻
Given you use it quite a bit, would it be annoying/disruptive for you to have to change the pan settings on your existing projects if the meaning of the panning was to be changed in a future firmware release?

wynwynyn, 2025-04-29:
I don't think it'd annoy me, but having said that, I usually use panning just to add a bit of stereo depth to things, rather than thinking whether something should come out of the left or right channel specifically... In that case yeah, I can imagine it being _slightly_ annoying, but not that big of a deal!

democloid, 2025-04-29:
I don't think this should be changed, specially if it comes from LGPT legacy, there are some expectations on how it works, etc.
If we want to change this I'd rather have the specific UI widget work in reverse and go to zero to the right, or have a different widget with a slider of sorts. But in both cases keep the numerical values as is.

jobf, 2025-04-29:
> I usually use panning just to add a bit of stereo depth to things

Yeah same, there's just a weird cognitive glitch with it being backwards. Easy to get used to but initially confusing.

> it comes from LGPT legacy

Shouldn't we move forwards? picoTracker is a different beast after all...

A reversed UI widget would be OK, just seems a bit backwards lol

maks, 2025-04-30:
Given the feedback so far, I think we can go ahead and fix this without too big an impact on existing users.

Thread 511 (2025-04-29):

Add MIDI Pitch Bend Command

wynwynyn, 2025-04-29:
Currently there is no way to control MIDI pitch bend. This has its own message separate from MIDI CCs.

A couple of links for reference:
[Expanded MIDI 1.0 Messages List](https://midi.org/expanded-midi-1-0-messages-list)
[Sparkfun - Advanced Messages MIDI Tutorial](https://learn.sparkfun.com/tutorials/midi-tutorial/advanced-messages)

This should be added as a new command that can be controlled on Phrase and Table screens.

wynwynyn, 2025-04-29:
As this is a single control, could it benefit from value, and speed-to-value control (`aabb`)? So like,

`MIDI Pitch Bend: reach value bb at speed aa`

maks, 2025-04-29:
It was also mentioned in the initial discussion in Discord that Aftertouch (aka Polyphonic Pressure (0xA0) and Channel Pressure (0xD0)) is likewise a separate similar message type in MIDI spec and we'd likely want to implement that at the same time.

jobf, 2025-04-29:
I've been thinking about MIDI pitch bend too and I wonder if it makes more sense to add to one of the existing commands rather than have it's own? For example we have [LEG](https://manual.xiphonics.com/commands.html#leg-aabb-lega-in-lgpt) for exponential pitch slide and [PSL](https://manual.xiphonics.com/commands.html#psl-aabb-ptch-in-lgpt) for linear.

maks, 2025-04-30:
@jobf  that's an interesting idea, but the problem is that the MIDI pitch bend command needs to send 2 bytes of data.
Which brings me to @wynwynyn original request and that applying a speed value within the same command won't work unless we are willing to sacrifice alot of the value range to reduce it from 16k range (+/- 8k) down to only 256. Or is that what you were referring to inregards to interpolation and giving up alot of the resolution in the MIDI commands value?

wynwynyn, 2025-04-30:
Ooo, I hadn't thought of the fact that pitch bend has a 16k range - I meant interpolation as in the manual sense (line by line in the command value column).

I'm kinda for both of these ideas if I'm being honest, the `LEG`/`PSL` are more aligned to my original idea, but now I'm conflicted because of the potential resolution sacrifice...

@maks off the top of your head, do you know if it'd be feasible to have `LEG` and `PSL` output this lowered resolution PB behaviour for MIDI instruments - which would also mean we could have the option of lineal and exponential curves too. Then, maybe, we could also have a new command - `MPB` - for the full +/- 8k pitch bend control.

wynwynyn, 2025-04-30:
@maks I guess it depends on the pitch bend range set on the device receiving it. 0 - 127 to cover a range of one semitone, the low resolution probably wouldn't be noticable, but if the device is set to an octave then yeah it'll probably start to sound a bit jaggy.

jobf, 2025-04-30:
Ooh yeah nice, both low res and high res versions would be neat!

maks, 2025-07-24:
@wynwynyn thanks for working on this!
The next step is to open a PR for this so that we can review the code and provide feedback.
In regards to more fine grained commands, I would leave that to a separate issue to discuss if we want that.

maks, 2025-09-05:
Done in #741

Closed 2025-09-05.

Thread 514 (2025-04-30):

Extra play button functionality?

jobf, 2025-04-30:
So I'm playing around last night syncing the pT to another sequencer (manually) and thought it would be nice to have the option for the play button to start on release rather than on press.

I'm conscious that having too many user options like this would be a detriment to the code base but there could be an argument that play on release would be good in place of the current behavior. It could allow expanding the user interface in a way that we can then hold play and press other buttons for a whole new set of combos...

Anyway just an idea, let's discuss :)

jobf, 2025-04-30:
Sorry the sync isn't really the point, as you say we have proper sync abilities.

It's more the additional key combinations that I find interesting, I guess I should add some concrete examples of extra combos that would be useful, instinctively I have some in mind but can't quite find the words, let me stew on it 😅

maks, 2025-04-30:
Yes please, if you can make a case for alternative useful key combos that would be a good starting point to discuss this further.

Thread 515 (2025-05-01):

Option to not send program change

jobf, 2025-05-01:
This refers to the recent MIDI program change features added, which are awesome - https://github.com/xiphonics/picoTracker/pull/505

Would it be possible to have program set to 0 on the Instrument view to essentially opt-out of sending a program change? Similar to the way MIDI volume does not send a volume change command on zero?

I often like to change the program on synth while a sequence is playing and currently it always sends a change, so resets what was selected on the synth.

Also I think starting at 1 makes more sense aligning with the program numbers on most gear too.

maks, 2025-05-01:
Thanks for filing this. Unfortunately its not as simple as setting `0` as dont send, because according to the MIDI spec 0 is a valid program aka "patch" number:

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

I do agree that all the instruments I have only start their numbering at 1 not 0, so maybe this is something where real world usage does not match the spec.
I'll need to do some more research but if that turns out to be the case, using `0` for this is an easy change to make.

maks, 2025-05-01:
Actually I already found that I have 1 instrument: the Kaiser Synths DAFM which *does* use `0` for a valid patch number.

maks, 2025-05-01:
Make that to, below if from the Novation X-Station MIDI implementation.
Note that this doesnt mean that we can't have a setting to not send PC, it just that its not as simple as just using value of `0` to indicate this.

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

jobf, 2025-05-01:
Ah that is shame, sorry I should have checked the spec!

Bank Select probably needs supporting too, so I wondered if we could have the zero  value there but the situation is worse, with no spec for bank select numbering 😅

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

maks, 2025-05-01:
I think sending bank select would be a useful feature to have too! But it would be better to open a new issue track implementing that.

jobf, 2025-05-01:
[Done](https://github.com/xiphonics/picoTracker/issues/519)

maks, 2025-05-05:
I've had a bit of think on this and I think this can be done with a value of -1 being the "off" state and then we need to change how the `UIIntVarField` works to show "off" for values < 0, which I think should be compatible with existing usage as I don't think any existing Variable fields allow for negative values.

wynwynyn, 2025-06-07:
Just want to +1 this! The ability to "turn off" prog change messages definitely needs to be an option.

maks, 2025-06-10:
This is will fixed as part of #661 , the value of `0x80` will disable sending PC messages completely, on a per instrument basis/

Thread 519 (2025-05-01):

MIDI Program Bank Select

jobf, 2025-05-01:
Now that we have pgram changes baked in, we should have Bank Select too too.

From https://midi.org/about-midi-part-3midi-messages

> Controller number zero (with 32 as the LSB) is defined as the bank select. The bank select function is used in some synthesizers in conjunction with the MIDI Program Change message to expand the number of different instrument sounds which may be specified (the Program Change message alone allows selection of one of 128 possible program numbers). The additional sounds are selected by preceding the Program Change message with a Control Change message which specifies a new value for Controller zero and Controller 32, allowing 16,384 banks of 128 sound each.
Since the MIDI specification does not describe the manner in which a synthesizer’s banks are to be mapped to Bank Select messages, there is no standard way for a Bank Select message to select a specific synthesizer bank. Some manufacturers, such as Roland (with “GS”) and Yamaha (with “XG”) , have adopted their own practices to assure some standardization within their own product lines.

Thread 530 (2025-05-06):

Sample in Saved Project is *null* Upon Load

polsunicorn, 2025-05-06:
Whenever I load this particular project, there is a particular sample that reads as *null*, or sometimes the whole instrument shows up as null. Typically it is the sample, but occasionally the instrument. The settings on the instrument are typically reset as well. Below is the file name for reference in case it is a file name length issue (which seems unlikely to me); I can upload video of the process or anything else needed.

picoTracker/Samples/10 Bass/Phonk/FL_BPH_Bass_1Shot_Synth_05_Cm-BANDLAB.wav

maks, 2025-05-06:
@polsunicorn thanks for filing this issue.
Just to clarify, the full path on your sdcard would then be:
`/samples/picoTracker/Samples/10 Bass/Phonk/FL_BPH_Bass_1Shot_Synth_05_Cm-BANDLAB.wav` ?

polsunicorn, 2025-05-06:
> [@polsunicorn](https://github.com/polsunicorn) thanks for filing this issue. Just to clarify, the full path on your sdcard would then be: `/samples/picoTracker/Samples/10 Bass/Phonk/FL_BPH_Bass_1Shot_Synth_05_Cm-BANDLAB.wav` ?

Yes that is correct. I have a duplicated "picoTracker" file on my desktop so that's why I had included that.

swickline, 2025-05-17:
I have just built my picoTracker. First, thank you for the hard work on this project, it is quite awesome! The first project I started dabbling with has encountered this same bug, and it actually happens on all the samples I load. After editing, if I save then turn off the device, multiple samples are set to null upon powering back on or loading/reloading the song if already on. I can provide logs or additional testing if needed.

maks, 2025-05-17:
@swickline could you please provide the exact filenames of some of the samples that you are using that are not working and also what the format of the samples is (16/24bit?, sample rate?)

swickline, 2025-05-20:
Forgot to mention, I'm on FW 2.0.2r_531.

maks, 2025-05-21:
@swickline thanks for the extra information. That does sound that for your case its #554 which will be fixed when v2.1 stable is released. Unfortunately too stretched for time at the moment to backport the fix and release it as a hot fix for v2 so I'll close this for now as the worked around is to not try to use too long sample file names until v2.1 which will actually **prevent** you importing samples with too long filenames.

Closed 2025-05-21.

Thread 531 (2025-05-06):

Fix selecting from existing samples in a project for a Sample Instrument

maks, 2025-05-06:
Having done #459 there is now the issue of not being able to scroll through existing samples in a project by using the ENTER+LEFT/RIGHT keycombo as a single ENTER now opens the file browser.

We could fix this by just making a small change so that the browser is opened on *releasing* ENTER not on the press.
But as we have discussed previously, this may be a good opportunity to change the UI a bit to allow for some sort of pop up or modal list to select from existing samples in a project, especially if a user has a large number of samples in 1 project.

@democloid thoughts, preferences for this?

democloid, 2025-05-06:
I think this is kind of a problem, first solution works but may be annoying if you press enter with the intent of selecting an existing sample, then decide not to and release, to be sent to the import sample browser.

Full on existing sample browser could work, but wonder if we'd want to keep a quick browser still, it seems a bit overkill if you only have 5 samples loaded.

Ultimately I think maybe we should revert to original behaviour if we don't find something better, it wasn't THAT bad and we have to weight in with the disadvantages of the current limitations.

Another option, maybe more radical, could be to detach sample importing from the instrument itself. Maybe importing samples into the project could be on the project config page, where we manage project samples, eventually being able to delete, etc.

maks, 2025-05-07:
Per offline discussion, we will move to having a "import sample" button field on the project screen that will open the import file browser and allow for "add multiple samples" to the project workflow as done by other grooveboxes.

To help with QOL workflow, we will also reinstate ENTER+ENTER as a "screen shortcut" keycombo that will open the imprt file browser from the sampler instrument screen but it will be screen wide so can be invoked when **any** field on the sampler instrument is selected, not just the sample filename field. This will also mean that the previous ENTER+LEFT/RIGHT keycombo to select between existing sample files in a project will continue to work as before.

Closed 2025-05-13.

Thread 535 (2025-05-06):

Looped waveforms start to get flat in the higher octaves

wynwynyn, 2025-05-06:
Single cycle waveforms, like the AKWF samples, start to get a bit out of tune in the higher ranges and octaves.

Below shows the note from octave 4 - 7. You can see that on octave 7, the note is falling massively flat!

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

Steps to reproduce:
- Create a SAMPLE instrument
- Load a single cycle waveform sample, such as one from AKWF
- Set playback to loop mode
- Traverse up and down the octaves
- Octaves at the top of 6, and 7 will be out of tune

maks, 2025-05-06:
Thanks for opening this issue.

Could I ask if you could test this with the loop setting "oscillator" and see if you get the same result?

wynwynyn, 2025-05-06:
@maks good idea! I just tried it, and get pretty much the same results. The only difference is that `oscillator` mode seems to be a couple of octaves higher than `loop` mode in general (`c5` in `oscillator` mode sounds the same as `c7` in `loop` mode), so the issue starts happening in the fifth octave in `oscillator` mode.

I hope that makes sense!

maks, 2025-05-27:
This could actually just be due to how we inherited the hardcode setting of C3 for the `oscillator` mode from LGPT as [discussed in this thread](https://chipmusic.org/forums/topic/11573/akwf-single-cycle-waveforms-question/) especially the finding in the third last post.

maks, 2025-06-02:
@wynwynyn  per our discussion about this last week in Discord, can this be closed now?

maks, 2025-06-02:
thanks @wynwynyn do please let me know as when I tested using `loop` instead of `oscillator` setting I saw only very marginal errors from the expected frequency even in the highest octaves.

wynwynyn, 2025-06-06:
Sorry @maks things have been really hectic at work lately so I haven't had a lot of time...

Is there a `detune` value you used in loop mode to fix this issue? I'm finding it difficult because the issue shifts to different notes depending on the detune setting.

So for example, using `AKWF_0003.wav`, `oscillator` mode with detune set to `7F`, traversing the octave, some notes in the octave are perfectly in tune, where as others are completely out... The base for this D4 is `+2c` - I have normalised all the data below to start from zero

`D4`  - `0c`
`D#4` - `-4c`
`E4`  - `-5c`
`F4`  - `-16c`
`F#4` - `-13c`
`G4`  - `-25c`
`G#4` - `-4c`
`A4`  - `-11c`
`A#4` - `-27c`
`B4`  - `-17c`
`C4`  - `-37c`
`C#5` - `-12c`
`D5`  - `-23c`

Then, the same octave set with detune `9F` (the new base tuning being +25c):

`D4`  - `0c`
`D#4` - `-4c`
`E4`  - `-2c`
`F4`  - `-21c`
`F#4` - `-8c`
`G4`  - `-28c`
`G#4` - `-22c`
`A4`  - `-21c`
`A#4` - `-14c`
`B4`  - `0c`
`C4`  - `-19c`
`C#5` - `-35c`
`D5`  - `0c`

So these are wildly different, and the differences between each detune setting differ each time...

wynwynyn, 2025-06-06:
@maks I have some time this weekend, so I don't mind jumping into the code and having a play with this?

maks, 2025-06-07:
> [@maks](https://github.com/maks) I have some time this weekend, so I don't mind jumping into the code and having a play with this?

💯 go for it 👍🏻

Thread 536 (2025-05-07):

Editing instrument name for sampler instruments not working

maks, 2025-05-07:

Thread 546 (2025-05-11):

MIDI input is not handling all system transport messages correctly

maks, 2025-05-11:
Currently a stop message can also start the pT sequencer if its not already running, this is a bug as it should not act as a toggle.

Also the continue (system realtime) message is not currently supported and at least 1 device (TE EP-133 firmware v1) seems to use it in conjunction with sending song position pointer message of `0` instead of sending a start message.

Closed 2025-05-23.

Thread 548 (2025-05-12):

After renaming a project, autosave continues to save the previous project name

maks, 2025-05-12:
This will also cause a crash if autosave attepts to run after the user renames current project but does not explicitly save it, per #549

Closed 2025-05-12.

Thread 549 (2025-05-12):

Loading samples into named projects broken

maks, 2025-05-12:
As of 9609de91fcf6b8a242dd1d69030f4948554b0768 on master, importing samples into a named project have broken, importing into ".untitled" does still work.

physics1024, 2025-05-12:
Actually, the samples break when the project was not saved. It suggests that the samples could not find a valid store path, also point a bug to the project saving.

maks, 2025-05-12:
@physics1024 are you building and testing with the current tip of master branch?

physics1024, 2025-05-12:
No, I'm now just a user of this tracker. The phenomenon appeared when I first tried on the machine, with a built-in song project from my friend. I made some editings, and found that the project could not save anymore, with samples failed to be loaded.

I'm trying to get familiar with this project, though I have little experience on developing C codes on Pico. Maybe sometime later I could join the development. Also thanks to you developers all.

maks, 2025-05-12:
@physics1024 no worries but please open a separate issue for any thing you run into with the stable release as this issue is specifically for something that is only happening in the current master branch so would not be something you could see running a stable release build.

maks, 2025-05-12:
Upon further debugging, this turns out to actually be due to a specific case related to #548 where if the user does not do an explicit save operation after renaming, the new project name will be in use in memory but the project data file and importantly directory structure will not have been created on disk, causing sample imports to fail.

Given this issue is also present in 2.0 stable release, the PR fixing it #553 and #548 will be cherry-picked for a hotfix release.

maks, 2025-05-12:
Fixed in #553

Closed 2025-05-12.

Thread 556 (2025-05-14):

Import/Export buttons broken in master

maks, 2025-05-14:
Recent changes to InstrumentView seem to have broken event handling for the import & export button fields.

maks, 2025-05-20:
Fixed in #558

Closed 2025-05-20.

Thread 562 (2025-05-19):

make alt + up/down work on all screens

woeps, 2025-05-19:
Currently it seems, the keycombo `alt + up/down` only works on the song screen. It would be handy to have this available on all the other screens as well.

maks, 2025-05-20:
Thanks for opening the issue.
This is currently documented in the manual as:
>ALT+UP/DOWN: Jump up/down to next populated row after a blank row (great for live mode entire row queuing!)

would it be useful for screens other than the song screen?

woeps, 2025-05-20:
I found out about this combo from the manual. But I interpreted "great for" initially as "not only, but especially.." and then got confused why it wasn't working on the phrase screen.

I think it would be usefull on other screens than song/live, yes.

woeps, 2025-05-21:
## Research

I looked at the code to see if I find what needed to be changed:

Here is the jump to next section implemented inside of `SongView.cpp`:
https://github.com/xiphonics/picoTracker/blob/f52131e0a4950ebc8f6f3c6739ca15012648d7d1/sources/Application/Views/SongView.cpp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

and here is the function called by button presses:
https://github.com/xiphonics/picoTracker/blob/f52131e0a4950ebc8f6f3c6739ca15012648d7d1/sources/Application/Views/SongView.cpp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

The Phrase screen just doesn't have such implementation.

## Possible Approach

Not sure, if this contradicts any architectural design choices, but one possible solution could be:

- move `jumpToNextSection` from SongView into the `ViewData` class as a public method.
- add "keybindings" to every view (where applicable), and use `ViewData::jumpatoNextSection` there

see ViewData:
https://github.com/xiphonics/picoTracker/blob/f52131e0a4950ebc8f6f3c6739ca15012648d7d1/sources/Application/Views/ViewData.h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

Is this a valid approach? Should it be implemented differently?

maks, 2025-05-21:
@woeps thanks for doing the research on this! 👍🏻

I have a couple of thoughts. First as it is now, `jumpToNextSection()` is specific to SongView because it depends on the song data, so it wouldn't really be applicable to chains, phrases and tables.

It also depends on how you had in mind it working on those other screens, just the next row that has an entry in the first column or only in the current column of the cursor like in songview?

Finally this has helped me spot a minor bug in the current implementation where if the jump is to a songview row that is offscreen, the view doesn't scroll down to bring that row into view even the cursor has been positioned there.

woeps, 2025-05-31:
I just started to experiment here: https://github.com/xiphonics/picoTracker/compare/master...woeps:picoTracker:generalize-jump-to-next-section

Not yet tested on the hardware.

maks, 2025-06-03:
@woeps  thanks for your work on this!

Sorry I've only now had a chance to properly read through your proposal here.
My main concern is the change in behaviour to work across channels on the Song screen grid. To me I'm not sure I would want that. If I'm on a specific channel, for me the usefulness in this is to jump to the next empty row in that channel (column) and not to jump to one in another channel.
To my mind this seems to add alot of complexity for not much clear gain in useability.
@woeps  would you be able to outline what the driver is for having this new behaviour?

woeps, 2025-06-03:
I'm not sure, we're talking about the same behaviour here,  @maks .

In my understanding, a move by `jumpToNextSection` would always be constrained to the same column, the cursor was positioned at when the movement got initiated.

E.g.:
- in songview: jump to next section in the first channel would only consider values of the first channel (like it already was implemented)
- in phrase view (note column) jump to next section would only consider filled note values
- in phrase view (command1 column) jump to next section would only consider values in command1 column
- etc

I'm not sure about the ergonomics when applied to param columns: how to define section here? Where command is filled in the same row? Where param is greater than 0?

In regard on when to wrap around when reaching the end of the phrase or if the newly selected value inside a section depends on the direction: I'm still experimenting with this.

P.S: Currently in my PR branch, I have some weird rendering of the cursor only when calling jumpToNextSection on the param columns in the PhraseView. But that's another story...

woeps, 2025-06-03:
OK, now that this is cleared up, I have 2 remaining questions:

1. When jumping to a section, should the topmost value of that section be selected? (current implementation in SongView) or the first value in the moving direction? (Moving upwards would select the first value at the bottom of the section and vice versa) - personally, I like the latter but I don't have a hard opinion on this. The latter also requires a couple of lines less code.)
2.In PhraseView and one of the param columns: Should the next section be a value other than 0 in that same column or a command being set in the command column of the same row? The cursor would stay in the same column, I'm just asking about how to detect a section. (While only considering the same param column is consistent to other existing behaviour, there isn't really a neutral value for a param since 0 is also a valid and desirable value.)

Thread 563 (2025-05-19):

add images to illustrate keycombos to the usermanual

woeps, 2025-05-19:
Illustrations of the keycombos would help me a lot learning all those combos.

How would you like something like this:

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

---

I'd be willing to work on a PR if this is something you like.

maks, 2025-05-19:
That would be fantastic! Yes please do open a PR for  that if you're able to contribute diagrams for key combos like that 👍

Thread 566 (2025-05-20):

Editing sample start/end points broken

maks, 2025-05-20:
Its no longer possible to edit sample start/end points, they just get set to 00000

maks, 2025-05-22:
Fixed in #569

Closed 2025-05-22.

Thread 567 (2025-05-21):

Instrument screen does not update to current phrase instrument

maks, 2025-05-21:
When going to instrument screen from phrase screen, the instrument does not update fields to show the currently selected instrument on the phrase screen, but cycling through instruments using EDIT+LEFT/RIGHT does correctly update.

Closed 2025-05-22.

Thread 575 (2025-05-22):

Setting to have MIDI input output via the channel of the current selected MIDI Instrument

maks, 2025-05-22:
This would be a quality of life workflow enhancement. What this setting would do is have incoming MIDI note on/off messages be output using the currently selected MIDI Instruments channel.

The usecase for this is if you had a MIDI keyboard as input, you could be entering notes that would play on a MIDI synth connected to the output using the MIDI channel of the MIDI Instrument.

This would also lead into using #574

woeps, 2025-05-22:
I'm wondering, how would the "currently selected midi instrument" be defined?

I know similar features from other devices/sequencers, but since PT can use different instruments in the same phrase, it seems more difficult to decide on which instrument to send the incoming midi to.

I can totally imagine to use it the other way around: incoming midi messages on channel X map directly to instrument X. And if that's a midi instrument, it get's output as midi as well. Otherwise the instrument interprets the midi messages directly and changes the sound accordingly.

Thread 580 (2025-05-23):

KIL command will stop all instrument playing across all channels

maks, 2025-05-23:
Currently due to the implementation of Stop() in all instruments, eg. in the sampler:
```
void SampleInstrument::Stop(int channel) { running_ = false; }
```

this means that using the KIL command will stop an instrument playing not just in that phrase (whichever channel it is in at the moment) but also in all other channels where that instrument may also have been playing at that time.

The current user manual documents the command as:
>KIL --bb (KILL in lgpt)[🔗](https://manual.xiphonics.com/commands.html#kil---bb-kill-in-lgpt)
>instrument will stop playing after aa ticks.

so its ambiguous if it should also apply to all channels, but thinking about it practically it makes that it should only apply to the current channel (phrase).

Also this is not how the command works in LSDJ where:
>4.9 K: Kill Note
>K instantly stops the sound

and likewise in other comparable hardware trackers.

This beahaviour was inherited from LGPT.

It's likely this was not noticed til now due to focus on LGPT and pT being used predominantly for chiptune genre, where actual chords using a single instrument are not really used vs using the ARP command.

This was discovered via and will need to be fixed for MIDI in playback of multiple notes #508.

maks, 2025-05-23:
Actually due to a fluke in how instruments are deassigned in `PlayerChannel::StopInstrument()` this is working in for sampler instruments (and hence would be in lgpt too) but really should be cleaned up especially since the code in LGPTs Stop():
```
 renderParams *rp=renderParams_+channel ;
 running_=false ;
```
clearly points it being a bug that rp->finished_ is not set there.

This may be harder to solve for the OPAL and SID instruments however since they don't currently have the concept of per channel parameters the way the sampler does with its `renderParams_`

maks, 2025-05-23:
Given the limited polyphony performance of SID and OPAL instruments, for now we will just document this limitation as ISD and OPAL should be considered *monophonic* instruments from a MIDI input point of view.

maks, 2025-05-23:
Done in #581

Closed 2025-05-23.

Thread 585 (2025-05-23):

Feature Request: Add "Defaults" button in theme menu

ButcherZV, 2025-05-23:
Hello!
This is not a issue, I'm just thinking it would ve nice to add "Defaults" button in theme menu, so we can reset theme to it's default values, without consulting manual (where current default values can be find)

maks, 2025-05-24:
Thanks for this suggestion 👍🏻
I think this will fall under a specific case of #495 so I'll close this in favour of that issue but please feel free to leave any further comments about this there.

Closed 2025-05-24.

Thread 589 (2025-05-25):

Chevrons on Tables are permanently visible

jobf, 2025-05-25:
This refers to the `>` that shows which row is currently played back on Table view.

They are not updating correctly, once they show they don't turn off again.

maks, 2025-05-25:
Hi thanks for logging this issue.
Would you please be able to let us know which version of the firmware you are using? it will be displayed on the last line of the Device settings screen.

jobf, 2025-05-25:
Build 2.1-BETA2r_692

Thread 592 (2025-05-26):

DLY and ARP commands not working together

maks, 2025-05-26:
From Discord:
I am attempting to use a DLY 0003 in fx1, with an ARP C000 in fx2, and the ARP barely does anything. I thought maybe I would get a shortened version or a standard ARP, but instead a get the regular pitch with a slight octave jump for a tic as before the next note plays.

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

polsunicorn, 2025-05-29:
This is only from my experience, but it seems as though it is an issue with several commands not working as intended in FX2. ARP and DLY are the two I remember currently, but potentially others.

Thread 596 (2025-05-27):

Some AKWF are not being recognised as single cycle waveforms

maks, 2025-05-27:
Because the current detection code goes by specific file length and not sample count, the AKWF samples from [the "SNES" pack](https://www.adventurekid.se/akrt/waveforms/akwf-nes-8-bit-free/) are not being recognised because they are 1376 bytes in length.

Ideally we would detect single cycle waveform files based on sample count (eg. all AKWF are 600 samples) but this would require substantial code change as this requires parsing the RIFF header of every wav file being listed in the browser.

So for now we can probably get by just changing the single cycle detection code for preview playback to use criteria like <1500bytes

maks, 2025-05-27:
Actually [this website](https://bgc.github.io/waveformgenerator/#/scw-harmonic-generator/harmonic-shark) will create files at varying lengths and sample counts so this may be a bit of a losing battle unless there are some clear cutoff points.

maks, 2025-05-27:
For now for the sake of practicality, just adding 1376 covers the "nes" pack which then covers  all existing AKWF samples.

Closed 2025-05-27.

Thread 602 (2025-05-27):

escape hatch for undetected single cycle waveforms

woeps, 2025-05-27:
As mentioned in discord (https://discord.com/channels/1166483348634480650/1198101843285393529/1376808286992601120 ), it seems to be an uphill battle to detect all possibilities of a file being a single cycle waveform sample.

While the current heurisitcs may be good enough for the most common use cases, it could make sense to introduce a manual way to mark a sample as being single cycle.

Sample Browser puts the character `~` in front of detected singe cycle samples. What if we could manually "tag" undetected single cycle waveforms with just manually prepending `~` to the filename? - this could be rendered identically to integrate seamlessly into existing ui.

This would unblock users to use any file they want as single cycle, while the heuristics may be improved.

maks, 2025-05-27:
Thanks for the idea @woeps  I like the sound of this!

Thread 608 (2025-05-27):

different wraparound behaviour of highlighted channel and value in mixer view

woeps, 2025-05-27:
In v2.1beta when entering the mixer view, the current channel and it's mixer value is highlight at the bottom of the screen. When using lef/right arrows (in either direction) and reaching the master, the previous channel is highlighted, but the value of the master is highlighted. When further pressing left/right arrows the highlighted mixer value wraps around, while the highlighted channel won't.

Closed 2025-06-05.

Thread 609 (2025-05-28):

Device Line output mode keeps resetting to Line Level

maks, 2025-05-28:
Introduced in Beta3.

Closed 2025-05-29.

Thread 616 (2025-05-29):

Sample start/stop time adjustment stopped working (v2.1beta2-4)

polsunicorn, 2025-05-29:
I am not sure if this is a duplicate but I did not see it here. In the current beta series (v2.1beta2-4), something has broken the ability to adjust start/stop time on samples. I have tried on several different samples on new projects and existing and this behavior seems consistent. This does work in stable, so something about the beta(s) must have disabled that ability.

Thread 620 (2025-06-01):

Sliced samples are pitching each slice

maks, 2025-06-01:
Slices should not be pitched as the notes used are just the means to select which slice is to be played.

maks, 2025-06-05:
slice no longer shipping in v2.1

Closed 2025-06-05.

Thread 627 (2025-06-03):

Implement Vibrato command

maks, 2025-06-03:
The Vibrato SRPUpdater subclass is currently commented out (from LGPT) and never fully implemented but would be useful to have as command.

maks, 2025-09-16:
Go for it @LeviathaninWaves ! 👍

LeviathaninWaves, 2025-09-26:
@maks We should probably talk about how far we want to take this vibrato command. At its simplest, we can do a simple triangle wave vibrato strictly for sample instruments. Or we could have multiple vibrato shapes configured per instrument in the instrument editor screen (like in lsdj) and have it available for SID and OPL as well. MIDI instruments depends on using the "Mod wheel" approach which is totally at the mercy of the synth engine that pT is talking to or we can utilize MIDI pitch bend.

Luckily I'm experienced in low level YM2612 and PSG dev, so I can do stuff with OPL and potentially other YM chips in the future. I've never worked with SID but I can give it a try. Am I going to have wiggle room for LUTs in flash memory for the vibrato shapes? I don't want to do this with runtime math functions if at all possible.

maks, 2025-09-26:
@LeviathaninWaves Ideally we would want a command that works across all instrument types while keeping it as simple as possible.

My mental model of vibrato is low frequency FM, so at a guess I would expect a sine waveform modulating the frequency of an instrument.

Agree its trickier with MIDI, I guess the generic way would be to follow what was recently done for the LEG and PSL commands being applied to MIDI, even though specific MIDI devices might have their own, eg the SAM2695 module has specific NRPNs to set vibrato but I'd keep that separate to this as they can already be handled with the existing MIDI MCC command support.

Given I think it was intended to be used as command, I dont think we need to add any UI to instrument screens?

Finally with LUTs, we are lucky to have alot of flash space (compared to ram anyways) so I dont think any issue to add LUTs, just need make sure they are marked static const to have the compiler keep them in flash instead of trying to load into ram.

LeviathaninWaves, 2025-09-26:
@maks Understood, I've written an FM and PM synth before. With sampler instruments we can use a phase accumulator that is modulated by a sine LUT. With Opal vibrato I think is built into it, so some quick register writes should handle that. SID I need to research but I imagine if it doesn't have its own LFO then frequency writes will do. MIDI will use pitch bend.

maks, 2025-09-27:
Just a quick one about sine LUT, this would be generally useful across the entire firmware, so would be good to put it into a header for use everywhere. Note that we already even scarifice some ram to keep a couple of small LUTs for OPAL in ram as they are used by hotpath code (for every generated sample).

@LeviathaninWaves a bit off topic: if you have experience with writing FM synths before I'd be happy for any feedback you'd have on the OPAL implementation, as because it was intended for desktop tracker usage, it may have some things that could be better optimised for the RP2040. I had a go at some basic things like inlining hot path functions, putting the LUTs used in hotpath in ram but I suspect there are even better optimisations that could be done (eg using rp2040s interpolator units) to make the code much more performant.

Thread 628 (2025-06-03):

Show user error message when attempting to import into project with max number of samples in it

maks, 2025-06-03:
We also need to update the user manual to document the current limit of 16 sample files per project and highlight the "sample pool" model of how sample files are treated in projects.

maks, 2025-06-04:
Per offline discussion with @democloid we will also increase the sample files limit from 16 to 64.

Closed 2025-06-05.

Thread 635 (2025-06-04):

Show user error message when attempting to import into project with max sample storage is reached

maks, 2025-06-04:
We currently support upto 15MB of sample storage per project, but we are currently missing UI to tell the user when they reach that limit during sample import.

Thread 637 (2025-06-04):

Better UI to browse list of sample files in a projects "sample pool"

maks, 2025-06-04:
Once #628 is merged and we have an increase to 64 max samples per project we really need a better UI to browse the existing sample files in the project "sample pool". Some kind of simple variant of the existing file browser subscreen could be shown in response to the ENTER+arrow keycombo when on the sample field of sample instruments.

This could also be used when we come to implement #629 but in that case likely invoked from the project screen.

maks, 2025-06-05:
This should be fairly straight forward once #629 is implemented.

Closed 2025-09-19.

Thread 639 (2025-06-04):

Song chapter has wrong key combo for switching between song-live modes

maks, 2025-06-04:
In the manual that switching between song and live mode is wrong on the Song Screen page. It says ENTER+L/R but the right combo is EDIT+L/R (which is listed correctly on the dedicated controls page)

Closed 2025-06-04.

Thread 642 (2025-06-05):

Play/Stop button doesn't work while on theme edit screen

maks, 2025-06-05:

Thread 649 (2025-06-07):

Error checking for too long sample file names during project loads

maks, 2025-06-07:
Currently there is no error checking and handling for sample files with too long filenames during project loading. Need to prevent laoding sample files that have too long filenames. Ideally need to show the user an error message if this occurs.

Closed 2025-06-15.

Thread 650 (2025-06-07):

Need a keycombo on poweron to clear current project setting

maks, 2025-06-07:
Need to choose a keycombo (eg. `ALT+ENTER`) that if held down during power on will clear the current project (ie. delete `/.current`) and then just follow the normal boot process for the case where this is no `/.current` and just load a new empty project.

democloid, 2025-06-07:
it has to be hard/unnatural to do. I'd do ENTER+LEFT as an easy to remember also, if needed

maks, 2025-06-07:
Agreed ENTER+LEFT sounds good to me 👍

Thread 654 (2025-06-07):

MIDI chords act unpredicably in rapid succession

wynwynyn, 2025-06-07:
Some notes are missed and patterns start to sound janky when MCH are placed too close together. I encountered this issue on a Korg Minilogue - I'm wondering if it is something to do with the MIDI implementation currently sending a program change on every note.

Easiest way to reproduce:

Add a new phrase
For every step, add `C3 | MCH | 035A`
Play, stop, play again, stop, until the issue occurs

maks, 2025-06-10:
This should be fixed along with #656

Thread 657 (2025-06-07):

Send MIDI note off when stopping a track

wynwynyn, 2025-06-07:
I've had quite a few synths hanging on the last note played when stopping a track, which is a bit annoying when writing phrases.

When stopping a track/chain/phrase, can we send note off messages to all MIDI channels being used?

maks, 2025-06-08:
@wynwynyn  We should already  be sending note off on all sounding notes when the sequencer stops. My first thought for this was to send the "All Note Off" CC message when the pT sequencer stops, but doing a quick google, it seems not all instruments support that message.

But maybe there is actually a bug here. I havent run into this myself and I only have a limited number of polyphonic synths, but I'll try testing to see if I can reproduce. In the meantime, if you could provide more specific details about when and how this happens that would be helpful.

wynwynyn, 2025-06-11:
@maks this is working since 2.1 beta 5! I'm not sure if the prog change was causing some weird things to happen...

Closed 2025-06-11.

Thread 658 (2025-06-07):

MIDI ARP FX not working

wynwynyn, 2025-06-07:
As the title says, this currently doesn't appear to be working!

maks, 2025-06-08:
I'm pretty sure this is just something that was never implemented in LGPT so I've marked this as a feature request vs a bug.

Thread 664 (2025-06-11):

MIDI VEL doesn't sent full value

wynwynyn, 2025-06-11:
The `VEL` command for MIDI velocity isn't sending the full value, so when `7F` is set, it is only sending a value of 63.

This is because the value is being halved before being sent, found [here.](https://github.com/xiphonics/picoTracker/blob/251f95065cef1af49c3aabab93cfe1f95db2dcc1/sources/Application/Instruments/MidiInstrument.cpp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)

maks, 2025-06-11:
Fixed in #665

Closed 2025-06-11.

Thread 666 (2025-06-11):

midi drum instrument suggestion

noizehack, 2025-06-11:
It would be helpful for sequencing drum machines with midi if there was a midi instrument that had the option to name notes. Then in the phrase you would see the name of the drum that was being triggered instead of just a note value.

for example

“kick” = “c#-2”
“snar” = “d#-2”
“chat” = “f -2”
“ohat” = “g -2”

maks, 2025-06-11:
Personally this sounds like a great idea!
Off the top of my head, I think this could work as a mapping within individual MIDI instruments, though may need to go into a new subscreen.
In terms of UI, [pocket operations page 1](https://shittyrecording.studio/assets/pdf/Pocket_Operations-Revision_3.1_Booklet.pdf) has a pretty good schema for labelling percussion using 2 character abbreviations.
General MIDI also seems to [have standard drum to note mapping](https://en.m.wikipedia.org/wiki/File:GM_Standard_Drum_Map_on_vertical_keyboard.svg) that could be implemented as a "hardcoded" first mapping before a general user editable mapping feature is added.

@noizehack  happy for you to chime in with more thoughts on this here.

Thread 667 (2025-06-14):

Allow for detailed battery state

maks, 2025-06-14:
We currently only return battery voltage to UI layer (View class) and the do business logic calculations there. Instead picoTrackerSystem should return the detailed battery state and allow the UI to just represent it as required.
The  state should include current capacity percentage (state of charge), if currently charging, temperature and voltage level (for completeness).

On the current pico hardware we can only give a very rough percentage approximation and no temperature information at all.

Closed 2025-06-15.

Thread 669 (2025-06-14):

SDCARD MISSING when building prototype

Leonidas0710, 2025-06-14:
I have built the prototype and flashed software to it. The screen shows SDCARD missing. I have tried 3 different SD cards, two 32gb ones and one 64gb one. I am using the same modules as the one in the prototype. and using the legacy version of the firmware. What could be the issue?

Leonidas0710, 2025-06-14:
I had made a wiring mistake

Closed 2025-06-14.

Thread 672 (2025-06-18):

Show battery too low screen

maks, 2025-06-18:
We currently don't enforce a cut off point for battery voltage, so users can keep using device even when its in a "brown out" state which can lead to incorrect functionality even while the device appears to still be working.

Instead we need to show a "please charge device" screen once the battery level falls below a certain percentage. This will need to have some sort of latching mechanism to prevent the state going in and out when on the edge of this level especially for when battery voltage readings are not precise when the backlight is below full brightness level.

Thread 678 (2025-06-22):

Clone into next free, but start searching for unused item from current

woeps, 2025-06-22:
`ALT + (EDIT + ENTER)` Clones current item  (chain, in songview - but also valid in other views): Overwrites current highlighted Item with a copy of itself using the next unused Item available.

Current algorithm to find next unused item, starts at index  `0` and iterates over all items to find the first unused.

I'd like to suggest to instead start at the current index (under cursor) to find the next unused.

For people creating items (chains, phrases,..) consecutively, they should be able to keep their workflow.
This adaption should also allow a workflow of e.g. starting at chain 20 for channel 2 etc. When cloning chain 21, this would result in 22.

For me personally, this behaviour would be more intuitively, to choose the next free item starting from current.

What do you think?

maks, 2025-06-22:
I think it makes sense @woeps  and  has been suggested by other users before: #345  so I'll close this in favour of that existing issue.

Closed 2025-06-22.

Thread 689 (2025-07-04):

Audio input recording

maks, 2025-07-04:
Initiallly USB UAC.
Future devices will support line and mic in.

maks, 2025-08-28:
This is done for the advance, for the pico specifically support USB audio in is tracked in #768 so closing this out now.

Closed 2025-08-28.

Thread 714 (2025-07-15):

Screen off mode

maks, 2025-07-15:
When power button is pressed we first just turn off screen. If not connected to usb power, immediately save project and shutdown.
If usb power reconnected after that, device immediately turns on.

If connected to power with screen off, pressing power button for 1 sec-ish turns screen on.

Thread 726 (2025-07-16):

Reduce refresh rate to 30Hz

maks, 2025-07-16:
50Hz is too high for the char-cell based UI we currently have.

Thread 729 (2025-07-17):

Moving MIDI to audio thread causes audio issues

maks, 2025-07-17:
It seems that moving the midi processing out of the ISR and into the audio thread is causing issues with audio output.

To reproduce, listen to audio out when enabling MIDI out TRS or TRS+USB.

Also for some reason when starting sequencer with MIDI out enabled (TRS pr USB) now causes crash too:

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

maks, 2025-07-17:
This was missed in testing of previous PRs because they were only tested with MIDI instrument only projects, this occurs once you try playing a project with a Sampler instrument in it. For some reason its not happening for synth instruments.

maks, 2025-07-17:
Actually there may be multiple issues here or some sort of mem corruption as loading some exiting projects works fine with current master while others will cause a hardfault on load when reading sample files:

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

democloid, 2025-07-17:
This needs specific project, seems it may be a bunch of unrelated things. I have tested the base claim of "MIDI out causes issues to audio" on a random project and don't see the issue. Haven't gotten crashes either.

Closed 2025-08-28.

Thread 735 (2025-07-18):

Improve display in Root dir

maks, 2025-07-18:
Currently we still show the `/..`  when the current dir is the root dir, but in this case we should just not display that entry.

maks, 2025-09-26:
Fixed as part of #811

Closed 2025-09-26.

Thread 736 (2025-07-18):

Advance crashing when import file sample via browser

maks, 2025-07-18:
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

maks, 2025-07-18:
Adding a stackoverflow hook showed its due to stackoverflow in one of the Freertos tasks:

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

Thread 742 (2025-07-27):

Clone in Phrase View does not work

woeps, 2025-07-27:
Cloning in the Phrase view does currently (master, e5415f28d7f438f34806d4d4f73a0db89fadce71) not work (`ALT + EDIT + ENTER`, when cursor is positioned on a filled noted or instrument field) . It seems like the data is being cloned into the exact same instrument slot as currently used:
https://github.com/xiphonics/picoTracker/blob/e5415f28d7f438f34806d4d4f73a0db89fadce71/sources/Application/Instruments/InstrumentBank.cpp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

Note that `i` gets raised only after the assignment  and is not used afterwards.

I assume, line 224 should be replaced with the following?
```
  auto nextFreeInstrumentSlotId = GetNextFreeInstrumentSlotId();
```

Also only using `isDirty = true` is not enough to actually trigger a rerender:
https://github.com/xiphonics/picoTracker/blob/e5415f28d7f438f34806d4d4f73a0db89fadce71/sources/Application/Views/PhraseView.cpp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

The new state after clone would only be rendered after a cursor movement.

---

I couldn'( verify if cloning is working correctly when the cursor is positioned on one of the command arguments inside a phrase, because I'm not sure, when this expression would evaluate to true:
https://github.com/xiphonics/picoTracker/blob/e5415f28d7f438f34806d4d4f73a0db89fadce71/sources/Application/Views/PhraseView.cpp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
especially `FourCC::SampleInstrumentTable`: When I tried to debug it while using the `TBL` command the actual value was `FourCC::InstrumentCommandTable`.
Is this a bug? Or did I fail to understand when this should be triggered?
What do I need to use as a command to have the above check succeed?

woeps, 2025-07-30:
I'm afraid I currently don't have the capacity to take this on myself.
I want to finish up my 2 draft PRs first, before starting anything new.

If I find some time in the future, I'll send a note.

Thread 744 (2025-07-29):

Advance playback crashes for Onecycle project

maks, 2025-07-29:
At some point since 47905f4b680c20a896a82d649734a95b0e48b01c (which I just randomly went back to and could confirm playback of the project was fine)  and now, a bug has appeared that causes playback of the project to crash on the advance after about 3sec.

Below screenshot has stacktrace and line where it hardfaults.

Also attached the project for testing.

[oneCycAc.zip](https://github.com/user-attachments/files/21482837/oneCycAc.zip)

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

Closed 2025-08-29.

Thread 748 (2025-08-04):

Need to show missing sdcard on advance

maks, 2025-08-04:
Currently just see a black screen.

maks, 2025-08-28:
duplicate of #740

Closed 2025-08-28.

Thread 765 (2025-08-28):

Recording enhancements

maks, 2025-08-28:
* Record into `/recordings`
* Add `/recordings` to list of top level dirs that are created if don't already exist
* "Add to project" button on sample editor screen for samples not in current projects `/samples` subdir
* Filename textfield and "save as" button on sample editor screen

Thread 767 (2025-08-28):

Fix navigation from Sample Editor after recording

maks, 2025-08-28:
@democloid  where should we navigate too when leaving sample editor after recording?

Closed 2025-09-19.

Thread 778 (2025-09-03):

"STP" command crashes Picotracker

Moroyi, 2025-09-03:
Adding a STP command in a chain/phrase to stop song playback, will crash my device as you can see here: https://youtu.be/6dGzYDmYvPY  Now the funny thing is, STP won't also work on a handheld device running the latest LGPT software. If I add the command there it will prevent song playback entirely, even if I start playback at the first row.

Closed 2025-10-01.

Thread 790 (2025-09-16):

Add import and edit buttons to file browser screen

maks, 2025-09-16:
Import will import sample file into porjects sample pool (as `ALT+PLAY` does now and will remain as a short cut for it).

Edit will open the selected sample in the sample editor (_potentially_ `ALT+EDIT` will serve as short cut).

Related to #637

Closed 2025-09-19.

Thread 801 (2025-09-17):

File filter not working on advance

maks, 2025-09-17:
The "*.wav" in sample browser is not working on the advance

Closed 2025-09-21.

Thread 816 (2025-09-24):

ARP doesn't respect currently set scale

maks, 2025-09-24:
While ARP predates the scale functionality, it should have been updated to respect the current scale.

Thread 825 (2025-09-25):

Wav file header parser cannot handle valid padding chunks

maks, 2025-09-25:
According to the [RIFF spec](https://www.mmsp.ece.mcgill.ca/Documents/AudioFormats/WAVE/Docs/riffmci.pdf), its possible to have junk chunks:

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

and here is a file that does just that:

```
xxd Downloads/Kick_1.wav | head -n 4
00000000: 5249 4646 d062 0000 5741 5645 4a55 4e4b  RIFF.b..WAVEJUNK
00000010: 4000 0000 d062 0000 0000 0000 0060 0000  @....b.......`..
00000020: 0000 0000 0030 0000 0000 0000 0000 0000  .....0..........
00000030: 0000 0000 0000 0000 0000 0000 0000 0000  ................
```

but our current wav file header parser is not capable of correctly parsing headers with these chunks, which causes valid files to fail to load.

maks, 2025-09-26:
Here is the wav file with the header in question:

[Kick_1.wav](https://github.com/user-attachments/files/22554917/Kick_1.wav)

Closed 2025-09-26.

Thread 827 (2025-09-26):

Hold down button on boot to prevent loading current project

maks, 2025-09-26:
We need to have a way to prevent loading the last project stored in `.current`, delete `.current` and instead load the `.untitled` project.

For now we will use holding down the `ENTER` button during boot (power on) for this functionality.

Closed 2025-09-30.

Thread 838 (2025-10-07):

Allow exporting/importing "phrase rows"

maks, 2025-10-07:
It would be useful to have the ability to export one or more phrases in a row as a group into a single file and also then import them.
This would allow creating presets for drum loops made up of multiple phrases each holding one or more instruments notes. This would let you have predefined palette of drum patterns:Hip Hop", "Rock 1", "Boom Bap", "Bossa Nova", etc.

You could also use this to create chords for easily importing into a project.

The export function when triggered (via a "menu" key combo?) on the song screen would export the first phrase in the chain on the currently selected row of the song screen.

The importing would work by creating next available phrase number in each channel, starting with the number of the channel, eg. for channel 2 it would try to use 20, if not available 21, then 22 etc. If any channel doesn't have an unused phrase number that matches, the import would fail showing the user an error message.

democloid, 2025-10-07:
I'm not sure what "in a row" means here. Whatever is matched in that row of the song going down the chains and into phrases? If so, that seems messy. Or are we importing the row with it's chains and corresponding phrases?

I think for better or worse, our layout is based on song/chain/phrases and that's what we should be supporting (if we decide to support, not even sure that makes sense) as units to be exported/imported.

maks, 2025-10-07:
> I'm not sure what "in a row" means here. Whatever is matched in that row of the song going down the chains and into phrases? If so, that seems messy. Or are we importing the row with it's chains and corresponding phrases?
>
> I think for better or worse, our layout is based on song/chain/phrases and that's what we should be supporting (if we decide to support, not even sure that makes sense) as units to be exported/imported.

Actually that's a good point @democloid , there is no need to limit users just based on the 2 use cases I came up with for this so far, other users might have have their own workflow uses for this 👍🏻  I've updated the issue title to reflect that. The UI can then be exporting the currently selected set of chains on the song screen.
