xiphonics/picoTracker/(list of files, drawings)

Other design files:
fritzing/picoTracker.fzz
