xiphonics/picoTracker/sources/Adapters/adv/Core/Src/main.c

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
/* Includes ------------------------------------------------------------------*/
#include "main.h"
#include "dma.h"
#include "dma2d.h"
#include "fmc.h"
#include "gpio.h"
#include "i2c.h"
#include "ltdc.h"
#include "memorymap.h"
#include "rng.h"
#include "rtc.h"
#include "sai.h"
#include "sdmmc.h"
#include "tim.h"
#include "usart.h"
#include "usb_otg.h"

/* USER CODE BEGIN Includes */
#include "Adapters/adv/system/advSystem.h"
#include "Application/Application.h"
#include "Trace.h"
#include "critical_error_message.h"
#include "display.h"
#include "tusb.h"
#include <cstdio>
/* USER CODE END Includes */

/* USER CODE BEGIN PTD */
__attribute__((section(".firmware_info"))) __attribute__((used))
const firmware_info_t firmware_info = {
    .magic = 0xC0D31355,
    .length = 0,           // placeholder, filled post-link
    .version = 0x72020300, // type, major, minor, patch (type: 0x62: beta,
    // debug: 0x64, 0x72: release)
    .crc32 = 0,        // placeholder, filled post-link
    .type = 0x00006677 // Only two types: "fw" 0x00006677 or "boot" 0x626f6f74
};

/* USER CODE END PTD */

/* USER CODE BEGIN PD */

#ifdef __GNUC__ /* __GNUC__ */
#define PUTCHAR_PROTOTYPE int __io_putchar(int ch)
#else
#define PUTCHAR_PROTOTYPE int fputc(int ch, FILE *f)
#endif /* __GNUC__ */

/* USER CODE END PD */


void SystemClock_Config(void);
void PeriphCommonClock_Config(void);
static void MPU_Config(void);
/* USER CODE BEGIN 0 */
extern uint32_t _sfastcode, _efastcode, _sifastcode;
static void init_fastcode_section(void) {
  uint8_t *fastcode_ram_start = (uint8_t *)&_sfastcode,
          *fastcode_ram_end = (uint8_t *)&_efastcode,
          *fastcode_flash_start = (uint8_t *)&_sifastcode;
  size_t len = fastcode_ram_end - fastcode_ram_start;
  for (size_t i = 0; i < len; i++) {
    *(fastcode_ram_start + i) = *(fastcode_flash_start + i);
  }
}
/* USER CODE END 0 */

/**
 * @brief  The application entry point.
 * @retval int
 */
int main(void) {

  /* MPU Configuration--------------------------------------------------------*/
  MPU_Config();

  /* Enable the CPU Cache */

  /* Enable I-Cache---------------------------------------------------------*/
  SCB_EnableICache();

  /* MCU Configuration--------------------------------------------------------*/

  /* Reset of all peripherals, Initializes the Flash interface and the Systick.
   */
  HAL_Init();

  /* Configure the system clock */
  SystemClock_Config();

  /* Configure the peripherals common clocks */
  PeriphCommonClock_Config();

  /* Initialize all configured peripherals */
  MX_GPIO_Init();
  MX_DMA_Init();
  MX_FMC_Init();
  MX_I2C4_Init();
  MX_LTDC_Init();
  MX_SAI1_Init();
  MX_SDMMC1_SD_Init();
  MX_UART7_Init();
  MX_USART1_UART_Init();
  MX_TIM1_Init();
  MX_TIM13_Init();
  MX_DMA2D_Init();
  MX_RNG_Init();
  MX_TIM2_Init();
  MX_USB_OTG_FS_USB_Init();
  MX_RTC_Init();
  /* USER CODE BEGIN 2 */

  // Check for EDIT key hold on boot to force load untitled project
  {
    if (HAL_GPIO_ReadPin(INPUT_ENTER_GPIO_Port, INPUT_EDIT_Pin) ==
        GPIO_PIN_SET) {
      forceLoadUntitledProject = true;
    }
  }

  if (SDcardInitError != 0) {
    Trace::Log("MAIN", "SDCARD MISSING!!\n");
    critical_error_message("SDCARD MISSING !", 0x01,
                           DEFAULT_ERROR_MESSAGE_DELAY_SEC, false);
    while (false) {
    }
  }

  // can't use Trace here as its not been initialised yet
  printf("INFO: picoTracker Advance init...");

  init_fastcode_section();

  tusb_rhport_init_t dev_init = {.role = TUSB_ROLE_DEVICE,
                                 .speed = TUSB_SPEED_AUTO};
  tusb_init(0, &dev_init);

  advSystem::Boot();

  GUICreateWindowParams params;
  params.title = "picoTracker Advance";

  Application::GetInstance()->Init(params);

  advSystem::MainLoop();
  // WE NEVER GET HERE

  advSystem::Shutdown();

  /* USER CODE END 2 */

  /* Infinite loop */
  /* USER CODE BEGIN WHILE */

  while (1) {
    /* USER CODE END WHILE */

    /* USER CODE BEGIN 3 */
  }
  /* USER CODE END 3 */
}

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
/* USER CODE BEGIN 4 */

PUTCHAR_PROTOTYPE {
  /* Place your implementation of fputc here */
  /* e.g. write a character to the USART3 and Loop until the end of
             transmission */
  HAL_UART_Transmit(&DEBUG_UART, (uint8_t *)&ch, 1, 0x000F);
  return ch;
}

/* USER CODE END 4 */

/* MPU Configuration */

void MPU_Config(void) {

  /* Disables the MPU */
  HAL_MPU_Disable();

  /* Enables the MPU */
  HAL_MPU_Enable(MPU_PRIVILEGED_DEFAULT);
}

/**
 * @brief  Period elapsed callback in non blocking mode
 * @note   This function is called  when TIM8 interrupt took place, inside
 * HAL_TIM_IRQHandler(). It makes a direct call to HAL_IncTick() to increment
 * a global variable "uwTick" used as application time base.
 * @param  htim : TIM handle
 * @retval None
 */
void HAL_TIM_PeriodElapsedCallback(TIM_HandleTypeDef *htim) {
  if (htim->Instance == TIM8) {
    HAL_IncTick();
  }
}

/**
 * @brief  This function is executed in case of error occurrence.
 * @retval None
 */
void Error_Handler(void) {
  /* USER CODE BEGIN Error_Handler_Debug */
  /* User can add his own implementation to report the HAL error return state */
  __disable_irq();
  while (1) {
  }
  /* USER CODE END Error_Handler_Debug */
}

#ifdef USE_FULL_ASSERT
/**
 * @brief  Reports the name of the source file and the source line number
 *         where the assert_param error has occurred.
 * @param  file: pointer to the source file name
 * @param  line: assert_param error line source number
 * @retval None
 */
void assert_failed(uint8_t *file, uint32_t line) {
  /* USER CODE BEGIN 6 */
  /* User can add his own implementation to report the file name and line
     number, ex: printf("Wrong parameters value: file %s on line %d\r\n", file,
     line) */
  /* USER CODE END 6 */
}
#endif /* USE_FULL_ASSERT */
