xiphonics/picoTracker/sources/Adapters/adv/adv.ioc

Mcu.UserName=STM32H743ZITx
PA0.GPIO_Label=DISPLAY_SDA
PA0.Signal=GPIO_Output
PA1.Signal=LTDC_R2
PA10.Signal=USB_OTG_FS_ID
PA11.Signal=USB_OTG_FS_DM
PA12.Signal=USB_OTG_FS_DP
PA2.GPIO_Label=POWER
PA2.Signal=GPIO_Input
PA3.Signal=LTDC_B5
PA4.Signal=LTDC_VSYNC
PA5.Signal=LTDC_R4
PA6.Signal=LTDC_G2
PA7.Signal=FMC_SDNWE
PA8.Signal=LTDC_B3
PA9.GPIO_Label=CHARGER_OTG
PA9.Signal=GPIO_Output
PB0.Signal=LTDC_R3
PB1.Signal=LTDC_R6
PB10.Signal=LTDC_G4
PB11.Signal=LTDC_G5
PB12.GPIO_Label=SD_DET
PB12.Signal=GPXTI12
PB13.GPIO_Label=DISPLAY_SCK
PB13.Signal=GPIO_Output
PB14.Signal=USART1_TX
PB15.Signal=USART1_RX
PB2.GPIO_Label=DISPLAY_CS
PB2.Signal=GPIO_Output
PB5.Signal=FMC_SDCKE1
PB6.Signal=FMC_SDNE1
PB7.GPIO_Label=CHARGER_INT
PB7.Signal=GPXTI7
PB8.Signal=LTDC_B6
PB9.Signal=LTDC_B7
PC0.Signal=LTDC_R5
PC1.GPIO_Label=CHARGER_CE
PC1.Signal=GPIO_Output
PC10.Signal=SDMMC1_D2
PC11.Signal=SDMMC1_D3
PC12.Signal=SDMMC1_CK
PC13.GPIO_Label=CODEC_RESET
PC13.Signal=GPIO_Output
PC2_C.GPIO_Label=OSC_EN
PC2_C.Signal=GPIO_Output
PC3_C.GPIO_Label=AMP_EN
PC3_C.Signal=GPIO_Output
PC4.Signal=FMC_SDNE0
PC5.Signal=FMC_SDCKE0
PC6.Signal=LTDC_HSYNC
PC7.Signal=LTDC_G6
PC8.Signal=SDMMC1_D0
PC9.Signal=SDMMC1_D1
PD0.Signal=FMC_D2_DA2
PD1.Signal=FMC_D3_DA3
PD10.Signal=FMC_D15_DA15
PD11.GPIO_Label=INPUT_LEFT
PD11.Signal=GPIO_Input
PD12.Signal=I2C4_SCL
PD13.Signal=I2C4_SDA
PD14.Signal=FMC_D0_DA0
PD15.Signal=FMC_D1_DA1
PD2.Signal=SDMMC1_CMD
PD3.Signal=LTDC_G7
PD4.GPIO_Label=INPUT_RIGHT
PD4.Signal=GPIO_Input
PD5.GPIO_Label=INPUT_UP
PD5.Signal=GPIO_Input
PD6.Signal=LTDC_B2
PD7.GPIO_Label=INPUT_ALT
PD7.Signal=GPIO_Input
PD8.Signal=FMC_D13_DA13
PD9.Signal=FMC_D14_DA14
PE0.Signal=FMC_NBL0
PE1.Signal=FMC_NBL1
PE10.Signal=FMC_D7_DA7
PE11.Signal=FMC_D8_DA8
PE12.Signal=FMC_D9_DA9
PE13.Signal=FMC_D10_DA10
PE14.Signal=FMC_D11_DA11
PE15.Signal=FMC_D12_DA12
PE2.Signal=SAI1_MCLK_A
PE3.Signal=SAI1_SD_B
PE4.Signal=SAI1_FS_A
PE5.Signal=SAI1_SCK_A
PE6.Signal=SAI1_SD_A
PE7.Signal=FMC_D4_DA4
PE8.Signal=FMC_D5_DA5
PE9.Signal=FMC_D6_DA6
PF0.Signal=FMC_A0
PF1.Signal=FMC_A1
PF10.Signal=LTDC_DE
PF11.Signal=FMC_SDNRAS
PF12.Signal=FMC_A6
PF13.Signal=FMC_A7
PF14.Signal=FMC_A8
PF15.Signal=FMC_A9
PF2.Signal=FMC_A2
PF3.Signal=FMC_A3
PF4.Signal=FMC_A4
PF5.Signal=FMC_A5
PF6.GPIO_Label=MIDI IN
PF6.Signal=UART7_RX
PF7.GPIO_Label=MIDI OUT
PF7.Signal=UART7_TX
PF8.GPIO_Label=DISPLAY_PWM
PF8.Signal=S_TIM13_CH1
PF9.GPIO_Label=DISPLAY_RST
PF9.Signal=GPIO_Output
PG0.Signal=FMC_A10
PG1.Signal=FMC_A11
PG10.Signal=LTDC_G3
PG11.GPIO_Label=INPUT_ENTER
PG11.Signal=GPIO_Input
PG12.Signal=LTDC_B4
PG13.GPIO_Label=INPUT_NAV
PG13.Signal=GPIO_Input
PG14.GPIO_Label=INPUT_PLAY
PG14.Signal=GPIO_Input
PG15.Signal=FMC_SDNCAS
PG2.Signal=FMC_A12
PG3.GPIO_Label=INPUT_DOWN
PG3.Signal=GPIO_Input
PG4.Signal=FMC_A14_BA0
PG5.Signal=FMC_A15_BA1
PG6.Signal=LTDC_R7
PG7.Signal=LTDC_CLK
PG8.Signal=FMC_SDCLK
PG9.GPIO_Label=INPUT_EDIT
PG9.Signal=GPIO_Input
