xiphonics/picoTracker/sources/Application/Views/ChainView.cpp

/*
 * SPDX-License-Identifier: BSD-3-Clause
 *
 * Copyright (c) 2018 Discodirt
 * Copyright (c) 2024 xiphonics, inc.
 *
 * This file is part of the picoTracker firmware
 */

#include "ChainView.h"
#include "Application/Utils/char.h"
#include "Application/Views/ModalDialogs/MessageBox.h"
#include "Application/Views/ModalDialogs/RenderProgressModal.h"
#include "Application/Views/SampleEditorView.h"
#include "Foundation/Constants/SpecialCharacters.h"
#include "ScreenView.h"
#include "System/Console/Trace.h"
#include "UIController.h"
#include "ViewData.h"
#include <nanoprintf.h>

ChainView::ChainView(GUIWindow &w, ViewData *viewData)
    : ScreenView(w, viewData) {
  updatingPhrase_ = false;
  lastPhrase_ = 0;
  lastPlayingPos_ = 0;
  lastQueuedPos_ = 0;

  clipboard_.active_ = false;
  clipboard_.width_ = 0;
  clipboard_.height_ = 0;

  for (int i = 0; i < 16; i++) {
    clipboard_.phrase_[i] = 0xFF;
    clipboard_.transpose_[i] = 0;
  };
}

void ChainView::Reset() {
  updatingPhrase_ = false;
  lastPhrase_ = 0;
  lastPlayingPos_ = 0;
  lastQueuedPos_ = 0;

  clipboard_.active_ = false;
  clipboard_.width_ = 0;
  clipboard_.height_ = 0;
  clipboard_.col_ = 0;
  clipboard_.row_ = 0;
  for (int i = 0; i < 16; i++) {
    clipboard_.phrase_[i] = 0xFF;
    clipboard_.transpose_[i] = 0;
  }

  saveRow_ = 0;
  saveCol_ = 0;
  needsUIUpdate_ = false;
}

void ChainView::setPhrase(unsigned char value) {
  viewData_->SetChainPhrase(value);
  lastPhrase_ = value;
  isDirty_ = true;
}

void ChainView::cutPosition() {
  clipboard_.active_ = true;
  clipboard_.row_ = viewData_->chainRow_;
  clipboard_.col_ = viewData_->chainCol_;
  saveRow_ = viewData_->chainRow_;
  saveCol_ = viewData_->chainCol_;
  cutSelection();
};

void ChainView::pasteLastPhrase() {

  // If we're on an empty spot, we past the last phrase
  // otherwise we take the current phrase as last

  unsigned char *c = viewData_->GetCurrentChainPointer();
  if ((*c == 0xFF)) {
    *c = lastPhrase_;
    isDirty_ = true;
  } else {
    lastPhrase_ = *c;
  }
};

void ChainView::updateCursor(int dx, int dy) {
  viewData_->UpdateChainCursor(dx, dy);
  isDirty_ = true;
}

void ChainView::updateCursorValue(int offset, int dx, int dy) {

  unsigned char v = viewData_->UpdateChainCursorValue(offset, dx, dy);
  if (viewData_->chainCol_ == 0) {
    lastPhrase_ = v;
    updatingPhrase_ = true;
    updateRow_ = viewData_->chainRow_;
  }
  isDirty_ = true;
}

void ChainView::updateSelectionValue(int offset) { // HERE

  int savecol = viewData_->chainCol_;
  int saverow = viewData_->chainRow_;
  GUIRect r = getSelectionRect();
  viewData_->chainCol_ = r.Left();
  viewData_->chainRow_ = r.Top();
  for (int i = 0; i <= r.Width(); i++) {
    for (int j = 0; j <= r.Height(); j++) {
      updateCursorValue(offset, i, j);
    }
  }
  viewData_->chainCol_ = savecol;
  viewData_->chainRow_ = saverow;
}

void ChainView::warpInColumn(int offset) {

  // save current data

  int saveY = viewData_->songY_;
  int saveOffset = viewData_->songOffset_;

  // move and check we're on valid chain

  viewData_->UpdateSongCursor(0, offset);
  unsigned char *data = viewData_->GetCurrentSongPointer();
  if (*data != 0xFF) {
    viewData_->currentChain_ = *data;
    isDirty_ = true;
  } else {
    // restore old position
    viewData_->songY_ = saveY;
    viewData_->songOffset_ = saveOffset;
  }
};

void ChainView::warpToNeighbour(int offset) {

  const int channelCount = SONG_CHANNEL_COUNT;
  int oldSongX = viewData_->songX_;
  for (int newPos = oldSongX + offset; (newPos > -1) && (newPos < channelCount);
       newPos += offset) {
    viewData_->songX_ = newPos;
    unsigned char *c = viewData_->GetCurrentSongPointer();
    if (*c != 0xFF) {
      viewData_->currentChain_ = *c;
      isDirty_ = true;
      return;
    }
  }
  viewData_->songX_ = oldSongX;
};

void ChainView::clonePosition() {

  unsigned char *pos = viewData_->GetCurrentChainPointer();
  unsigned char current = *pos;
  if (current == 255)
    return;

  uint16_t next = viewData_->song_->phrase_.GetNext(current + 1);
  if (next == NO_MORE_PHRASE)
    return;

  unsigned char *src = viewData_->song_->phrase_.note_ + 16 * current;
  unsigned char *dst = viewData_->song_->phrase_.note_ + 16 * next;
  for (int i = 0; i < 16; i++) {
    *dst++ = *src++;
  };

  src = viewData_->song_->phrase_.instr_ + 16 * current;
  dst = viewData_->song_->phrase_.instr_ + 16 * next;
  for (int i = 0; i < 16; i++) {
    *dst++ = *src++;
  };

  src = (unsigned char *)viewData_->song_->phrase_.cmd1_ + 16 * current;
  dst = (unsigned char *)viewData_->song_->phrase_.cmd1_ + 16 * next;
  for (int i = 0; i < 16; i++) {
    *dst++ = *src++;
  };

  ushort *ssrc = viewData_->song_->phrase_.param1_ + 16 * current;
  ushort *sdst = viewData_->song_->phrase_.param1_ + 16 * next;
  for (int i = 0; i < 16; i++) {
    *sdst++ = *ssrc++;
  };

  src = (unsigned char *)viewData_->song_->phrase_.cmd2_ + 16 * current;
  dst = (unsigned char *)viewData_->song_->phrase_.cmd2_ + 16 * next;
  for (int i = 0; i < 16; i++) {
    *dst++ = *src++;
  };

  ssrc = viewData_->song_->phrase_.param2_ + 16 * current;
  sdst = viewData_->song_->phrase_.param2_ + 16 * next;
  for (int i = 0; i < 16; i++) {
    *sdst++ = *ssrc++;
  };

  setPhrase((unsigned char)next);
  isDirty_ = true;
};

/******************************************************
 getSelectionRect:
        gets the normalized rectangle of the current
        selection. Valid only while selection is drawn
 ******************************************************/

GUIRect ChainView::getSelectionRect() {
  GUIRect r(clipboard_.col_, clipboard_.row_, viewData_->chainCol_,
            viewData_->chainRow_);
  r.Normalize();
  return r;
};

/******************************************************
 fillClipboardData:

        copies the necessary information from the
        current selection to the clipboard for future
        paste. We're copying data all across the row
        because we"re too lazy to try to figure a better
        procedure
 ******************************************************/

void ChainView::fillClipboardData() {

  // Get Current normalized selection rect

  GUIRect selRect = getSelectionRect();

  // Get size & store in clipboard

  clipboard_.width_ = selRect.Width() + 1;
  clipboard_.height_ = selRect.Height() + 1;
  clipboard_.row_ = selRect.Top();
  ;
  clipboard_.col_ = selRect.Left();

  // Copy the data

  unsigned char *src1 =
      viewData_->song_->chain_.data_ + 16 * viewData_->currentChain_;
  unsigned char *dst1 = clipboard_.phrase_;
  unsigned char *src2 =
      viewData_->song_->chain_.transpose_ + 16 * viewData_->currentChain_;
  unsigned char *dst2 = clipboard_.transpose_;

  for (int i = 0; i < clipboard_.height_; i++) {
    dst1[i] = src1[clipboard_.row_ + i];
    dst2[i] = src2[clipboard_.row_ + i];
  };
};

void ChainView::extendSelection() {
  GUIRect rect = getSelectionRect();
  if (rect.Left() > 0 || rect.Right() < 1) {
    if (viewData_->chainCol_ < clipboard_.col_) {
      viewData_->chainCol_ = 0;
      clipboard_.col_ = 1;
    } else {
      viewData_->chainCol_ = 1;
      clipboard_.col_ = 0;
    }
    isDirty_ = true;
  } else {
    if (viewData_->chainRow_ < clipboard_.row_) {
      viewData_->chainRow_ = 0;
      clipboard_.row_ = 15;
    } else {
      clipboard_.row_ = 0;
      viewData_->chainRow_ = 15;
    }
    isDirty_ = true;
  }
}

/******************************************************
 copySelection:
        copies data in the current selection to the
        clipboard & end selection process
 ******************************************************/

void ChainView::copySelection() {

  // Keep up with row,col of selection coz
  // fillClipboardData will trash it

  //	saveClipboardPosition() ;

  fillClipboardData();

  clipboard_.active_ = false;
  viewMode_ = VM_NORMAL;

  viewData_->chainRow_ = saveRow_;
  viewData_->chainCol_ = saveCol_;

  isDirty_ = true;
};

/******************************************************
 cut:  copies data in the current selection to the
       clipboard, clear selection content & end selection
       process
 ******************************************************/

void ChainView::cutSelection() {

  // Keep up with row,col of selection coz
  // fillClipboardData will trash it

  //	saveClipboardPosition() ;

  fillClipboardData();

  // Loop over selection col, row & clear data inside it

  unsigned char *dst1 =
      viewData_->song_->chain_.data_ + 16 * viewData_->currentChain_;
  unsigned char *dst2 =
      viewData_->song_->chain_.transpose_ + 16 * viewData_->currentChain_;

  for (int i = 0; i < clipboard_.width_; i++) {
    for (int j = 0; j < clipboard_.height_; j++) {
      switch (i + clipboard_.col_) {
      case 0:
        dst1[j + clipboard_.row_] = 0xFF;
        break;
      case 1:
        dst2[j + clipboard_.row_] = 00;
        break;
      }
    }
  }

  // Clear selection, end selection process & reposition cursor

  clipboard_.active_ = false;
  viewMode_ = VM_NORMAL;
  viewData_->chainRow_ = saveRow_;
  viewData_->chainCol_ = saveCol_;
  isDirty_ = true;
};

/******************************************************
 pasteClipboard:
        copies data in the clipboard to the current step
 ******************************************************/

void ChainView::pasteClipboard() {

  // Get number of row to paste

  int height = clipboard_.height_;
  if (viewData_->chainRow_ + height > 16) {
    height = 16 - viewData_->chainRow_;
  }

  unsigned char *dst1 =
      viewData_->song_->chain_.data_ + 16 * viewData_->currentChain_;
  unsigned char *src1 = clipboard_.phrase_;
  unsigned char *dst2 =
      viewData_->song_->chain_.transpose_ + 16 * viewData_->currentChain_;
  unsigned char *src2 = clipboard_.transpose_;

  for (int i = 0; i < clipboard_.width_; i++) {
    for (int j = 0; j < height; j++) {
      switch (i + clipboard_.col_) {
      case 0:
        dst1[j + viewData_->chainRow_] = src1[j];
        break;
      case 1:
        dst2[j + viewData_->chainRow_] = src2[j];
        break;
      }
    }
  }
  updateCursor(0x00, height);
  isDirty_ = true;
};

void ChainView::unMuteAll() {

  UIController *controller = UIController::GetInstance();
  controller->UnMuteAll();
};

void ChainView::toggleMute() {

  UIController *controller = UIController::GetInstance();
  controller->ToggleMute(viewData_->songX_, viewData_->songX_);
  viewMode_ = (viewMode_ != VM_MUTEON) ? VM_MUTEON : VM_NORMAL;
};

void ChainView::switchSoloMode() {

  UIController *controller = UIController::GetInstance();
  controller->SwitchSoloMode(viewData_->songX_, viewData_->songX_,
                             (viewMode_ == VM_NORMAL));
  viewMode_ = (viewMode_ != VM_SOLOON) ? VM_SOLOON : VM_NORMAL;
  isDirty_ = true;
};

void ChainView::ProcessButtonMask(unsigned short mask, bool pressed) {

  if (!pressed) {
    if (viewMode_ == VM_MUTEON) {
      if (mask & EPBM_NAV) {
        toggleMute();
      }
    };
    if (viewMode_ == VM_SOLOON) {
      if (mask & EPBM_NAV) {
        switchSoloMode();
      }
    };
    return;
  };

  if (viewMode_ == VM_NEW) {
    if (mask == EPBM_ENTER) {
      const uint8_t current = *viewData_->GetCurrentChainPointer();
      const uint16_t start = (current == 0xFF ? lastPhrase_ : current) + 1;
      uint16_t next = viewData_->song_->phrase_.GetNext(start);
      if (next != NO_MORE_PHRASE) {
        setPhrase((unsigned char)next);
        isDirty_ = true;
      }
      mask &= (0xFFFF - EPBM_ENTER);
    }
  }

  if (viewMode_ == VM_CLONE) {
    if ((mask & EPBM_ENTER) && (mask & EPBM_ALT)) {
      clonePosition();
      mask &= (0xFFFF - (EPBM_ENTER | EPBM_ALT));
    } else {
      viewMode_ = VM_SELECTION;
    }
  };

  if (mask == (EPBM_ENTER | EPBM_PLAY)) {
    Player *player = Player::GetInstance();
    if (player->IsRunning()) {
      MessageBox *message =
          MessageBox::Create(*this, "Stop playback before rendering", MBBF_OK);
      DoModal(message);
      return;
    }
    if (!clipboard_.active_) {
      MessageBox *message =
          MessageBox::Create(*this, "Select chain rows to render", MBBF_OK);
      DoModal(message);
      return;
    }
    const GUIRect selection = getSelectionRect();
    int firstPhraseRow = selection.Bottom() + 1;
    int lastPhraseRow = selection.Top() - 1;
    const unsigned char *phrases =
        viewData_->song_->chain_.data_ + 16 * viewData_->currentChain_;
    for (int row = selection.Top(); row <= selection.Bottom(); ++row) {
      if (phrases[row] != 0xFF) {
        if (firstPhraseRow > selection.Bottom()) {
          firstPhraseRow = row;
        }
        lastPhraseRow = row;
      }
    }
    if (firstPhraseRow > lastPhraseRow) {
      MessageBox *message = MessageBox::Create(
          *this, "Selection has no playable content", MBBF_OK);
      DoModal(message);
      return;
    }
    RenderProgressModal *dialog = RenderProgressModal::Create(
        *this, "Rendering Selection", "",
        RenderProgressModal::ProgressDisplayMode::ElapsedTime);
    DoModal(dialog);
    player->StartSelectionRender(PM_CHAIN, firstPhraseRow, lastPhraseRow,
                                 viewData_->songX_, viewData_->songX_, MSM_FILE,
                                 true);
    return;
  }

  // Process selection related keys

  if (viewMode_ == VM_SELECTION) {

    if (clipboard_.active_ == false) {
      clipboard_.active_ = true;
      clipboard_.col_ = viewData_->chainCol_;
      clipboard_.row_ = viewData_->chainRow_;
      saveCol_ = viewData_->chainCol_;
      saveRow_ = viewData_->chainRow_;
    }
    processSelectionButtonMask(mask);
  } else {

    // Switch back to normal mode

    viewMode_ = VM_NORMAL;
    processNormalButtonMask(mask);
  }
}

void ChainView::processNormalButtonMask(unsigned short mask) {

  Player *player = Player::GetInstance();

  if (mask & EPBM_EDIT) {
    // EDIT Modifier
    if (mask & EPBM_LEFT)
      warpToNeighbour(-1);
    if (mask & EPBM_RIGHT)
      warpToNeighbour(+1);
    if (mask & EPBM_UP)
      warpInColumn(-1);
    if (mask & EPBM_DOWN)
      warpInColumn(+1);
    if (mask & EPBM_ENTER)
      cutPosition();
    if (mask & EPBM_ALT) {
      viewMode_ = VM_CLONE;
    };
    if (mask & EPBM_NAV)
      toggleMute();
    if (mask & EPBM_PLAY) {
      // recording screen
      if (!Player::GetInstance()->IsRunning()) {
        switchToRecordView();
      }
    }
  } else if (mask & EPBM_ENTER) {
    // ENTER Modifier
    if (mask & EPBM_DOWN)
      updateCursorValue(viewData_->chainCol_ == 0 ? -0x10 : -0x0C);
    if (mask & EPBM_UP)
      updateCursorValue(viewData_->chainCol_ == 0 ? 0x10 : 0x0C);
    if (mask & EPBM_LEFT)
      updateCursorValue(-0x01);
    if (mask & EPBM_RIGHT)
      updateCursorValue(0x01);
    if (mask & EPBM_ALT)
      pasteClipboard();
    if (mask == EPBM_ENTER) {
      pasteLastPhrase();
      if (viewData_->chainCol_ == 0)
        viewMode_ = VM_NEW;
    }
    if (mask & EPBM_NAV)
      switchSoloMode();
  } else if (mask & EPBM_NAV) {
    // NAV Modifier
    if (mask & EPBM_LEFT) {
      ViewType vt = VT_SONG;
      ViewEvent ve(VET_SWITCH_VIEW, &vt);
      SetChanged();
      NotifyObservers(&ve);
    }

    if (mask & EPBM_RIGHT) {
      unsigned char *data = viewData_->GetCurrentChainPointer();
      if (*data != 0xFF) {
        ViewType vt = VT_PHRASE;
        ViewEvent ve(VET_SWITCH_VIEW, &vt);
        viewData_->currentPhrase_ = *data;
        SetChanged();
        NotifyObservers(&ve);
      }
    }

    // We toggle full chain start only if we"re not in live mode
    // or if the player ain't playing yet

    if (mask & EPBM_PLAY) {
      player->OnStartButton(PM_CHAIN, viewData_->songX_, true,
                            viewData_->chainRow_);
    }
    if (mask & EPBM_ALT)
      unMuteAll();
  } else {
    // NO modifier
    if (mask & EPBM_DOWN)
      updateCursor(0, 1);
    if (mask & EPBM_UP)
      updateCursor(0, -1);
    if (mask & EPBM_LEFT)
      updateCursor(-1, 0);
    if (mask & EPBM_RIGHT)
      updateCursor(1, 0);
    if (mask & EPBM_PLAY) {
      player->OnStartButton(PM_CHAIN, viewData_->songX_, false,
                            viewData_->chainRow_);
    }
  }

  if ((!(mask & EPBM_ENTER)) && updatingPhrase_) {
    unsigned char *c = viewData_->song_->chain_.data_ +
                       (16 * viewData_->currentChain_ + updateRow_);
    viewData_->song_->phrase_.SetUsed(*c);
    updatingPhrase_ = false;
  }
};

void ChainView::processSelectionButtonMask(unsigned short mask) {

  Player *player = Player::GetInstance();

  // B Modifier

  if (mask & EPBM_EDIT) {
    if (mask == EPBM_EDIT)
      copySelection();
    if (mask & EPBM_NAV)
      toggleMute();
    if (mask & EPBM_ALT)
      extendSelection();
  } else {

    // A modifier

    if (mask & EPBM_ENTER) {

      if (mask & EPBM_DOWN)
        updateSelectionValue(viewData_->chainCol_ == 0 ? -0x10 : -0x0C);
      if (mask & EPBM_UP)
        updateSelectionValue(viewData_->chainCol_ == 0 ? 0x10 : 0x0C);
      if (mask & EPBM_LEFT)
        updateSelectionValue(-0x01);
      if (mask & EPBM_RIGHT)
        updateSelectionValue(0x01);

      if (mask & EPBM_ALT) {
        cutSelection();
      }
      if (mask & EPBM_NAV)
        switchSoloMode();
    } else {

      // R Modifier

      if (mask & EPBM_NAV) {

        if (mask & EPBM_LEFT) {
          ViewType vt = VT_SONG;
          ViewEvent ve(VET_SWITCH_VIEW, &vt);
          SetChanged();
          NotifyObservers(&ve);
        }

        if (mask & EPBM_RIGHT) {
          unsigned char *data = viewData_->GetCurrentChainPointer();
          if (*data != 0xFF) {
            ViewType vt = VT_PHRASE;
            ViewEvent ve(VET_SWITCH_VIEW, &vt);
            viewData_->currentPhrase_ = *data;
            SetChanged();
            NotifyObservers(&ve);
          }
        }

        if (mask & EPBM_PLAY) {
          player->OnStartButton(PM_CHAIN, viewData_->songX_, true,
                                viewData_->chainRow_);
        }

        if (mask & EPBM_ALT)
          unMuteAll();

      } else {

        // No modifier

        if (mask & EPBM_DOWN)
          updateCursor(0, 1);
        if (mask & EPBM_UP)
          updateCursor(0, -1);
        if (mask & EPBM_LEFT)
          updateCursor(-1, 0);
        if (mask & EPBM_RIGHT)
          updateCursor(1, 0);

        if (mask & EPBM_PLAY) {
          player->OnStartButton(PM_CHAIN, viewData_->songX_, false,
                                viewData_->chainRow_);
        }
      }
    }
  }
};

void ChainView::OnFocus() { clipboard_.active_ = false; };

void ChainView::setTextProps(GUITextProperties &props, int row, int col,
                             bool restore) {

  bool invert = false;

  if (clipboard_.active_) {
    GUIRect selRect = getSelectionRect();
    if ((row >= selRect.Left()) && (row <= selRect.Right()) &&
        (col >= selRect.Top()) && (col <= selRect.Bottom())) {
      invert = true;
    }
  } else {
    if ((viewData_->chainCol_ == row) && (viewData_->chainRow_ == col)) {
      invert = true;
    }
  }

  if (invert) {
    if (restore) {
      SetColor(CD_NORMAL);
      props.invert_ = false;
    } else {
      SetColor(CD_HILITE2);
      props.invert_ = true;
    }
  }
};

void ChainView::DrawView() {

  Clear();

  GUITextProperties props;
  GUIPoint pos = GetTitlePosition();

  // Draw title

  char title[20];
  SetColor(CD_NORMAL);
  npf_snprintf(title, sizeof(title), "Chain %2.2X", viewData_->currentChain_);
  DrawString(pos._x, pos._y, title, props);

  // Compute song grid location

  GUIPoint anchor = GetAnchor();

  // Display row numbers
  SetColor(CD_HILITE1);
  char row[3];
  pos = anchor;
  pos._x -= 3;
  for (int j = 0; j < 16; j++) {
    ((j / ALT_ROW_NUMBER) % 2) ? SetColor(CD_ACCENT) : SetColor(CD_ACCENTALT);
    hex2char(j, row);
    DrawString(pos._x, pos._y, row, props);
    pos._y += 1;
  }

  SetColor(CD_NORMAL);

  pos = anchor;

  // Display phrases

  pos = anchor;

  unsigned char *data =
      viewData_->song_->chain_.data_ + (16 * viewData_->currentChain_);

  for (int j = 0; j < 16; j++) {
    unsigned char d = *data++;
    setTextProps(props, 0, j, false);
    if (d == 0xFF) {
      DrawString(pos._x, pos._y, "--", props);
    } else {
      hex2char(d, row);
      DrawString(pos._x, pos._y, row, props);
    }
    setTextProps(props, 0, j, true);
    pos._y++;
  }

  // Draw Transpose

  pos = anchor;
  pos._x += 3;

  data = viewData_->song_->chain_.transpose_ + (16 * viewData_->currentChain_);

  for (int j = 0; j < 16; j++) {
    unsigned char d = *data++;
    hex2char(d, row);
    setTextProps(props, 1, j, false);
    DrawString(pos._x, pos._y, row, props);
    setTextProps(props, 1, j, true);
    pos._y++;
  }
  Player *player = Player::GetInstance();

  drawMap();
  drawNotes();

  if (player->IsRunning()) {
    OnPlayerUpdate(PET_UPDATE);
  };
};

void ChainView::OnPlayerUpdate(PlayerEventType eventType, unsigned int tick) {
  // Since this can be called from core1 via the Observer pattern,
  // we need to ensure we don't call any drawing functions directly
  // Instead of drawing directly, we'll just update our state and let
  // AnimationUpdate handle the actual drawing

  // Flag that UI needs to be updated (notes, positions, VU meter)
  needsUIUpdate_ = true;
};

void ChainView::AnimationUpdate() {
  // First call the parent class implementation to draw the battery gauge
  ScreenView::AnimationUpdate();
  GUITextProperties props;

  // Get player instance safely
  Player *player = Player::GetInstance();

  // Only process updates if we're fully initialized
  if (!viewData_ || !player) {
    // Just flush the battery gauge and return
    w_.Flush();
    return;
  }

  // Always update VU meter even if other parts of UI dont need updating
  drawMasterVuMeter(player, props);

  // Handle any pending updates from OnPlayerUpdate
  // This ensures all UI drawing happens on the "main" thread (core0)
  if (needsUIUpdate_) {
    // Draw notes
    drawNotes();

    // Handle position updates
    GUIPoint anchor = GetAnchor();
    GUIPoint pos = anchor;
    pos._x -= 1;

    SetColor(CD_NORMAL);

    // Clear last played & queued
    pos._y = anchor._y + lastPlayingPos_;
    DrawString(pos._x, pos._y, " ", props);

    pos._y = anchor._y + lastQueuedPos_;
    DrawString(pos._x, pos._y, " ", props);

    // Only update play position if player is running
    if (player->IsRunning()) {
      // Loop on all channels to see if one of them is playing current chain
      for (int i = 0; i < SONG_CHANNEL_COUNT; i++) {
        if (player->IsChannelPlaying(i)) {
          if (viewData_->currentPlayChain_[i] == viewData_->currentChain_ &&
              viewData_->playMode_ != PM_AUDITION) {
            pos._y = anchor._y + viewData_->chainPlayPos_[i];
            if (!player->IsChannelMuted(i)) {
              SetColor(CD_ACCENT);
              DrawString(pos._x, pos._y, char_indicator_position_s, props);
            } else {
              SetColor(CD_ACCENTALT);
              DrawString(pos._x, pos._y, char_indicator_positionMuted_s, props);
            }
            lastPlayingPos_ = viewData_->chainPlayPos_[i];
            break;
          }
        }
      }
    }

    // Handle queue position updates if in live mode
    if (player->GetSequencerMode() == SM_LIVE) {
      for (int i = 0; i < SONG_CHANNEL_COUNT; i++) {
        // is anything queued?
        if (player->GetQueueingMode(i) != QM_NONE) {
          // find the chain queued in channel
          unsigned char songPos = player->GetQueuePosition(i);
          unsigned char *chain =
              viewData_->song_->data_ + i + SONG_CHANNEL_COUNT * songPos;
          if (*chain == viewData_->currentChain_) {
            unsigned char chainPos = player->GetQueueChainPosition(i);
            pos._y = anchor._y + chainPos;
            const char *indicator = player->GetLiveIndicator(i);
            DrawString(pos._x, pos._y, indicator, props);
            lastQueuedPos_ = chainPos;
            break;
          }
        }
      }
    }

    // Mark UI update as complete
    needsUIUpdate_ = false;
  }

  // Flush the window to ensure changes are displayed
  w_.Flush();
};
