xiphonics/picoTracker/sources/Application/Player/Player.h

/*
 * SPDX-License-Identifier: BSD-3-Clause
 *
 * Copyright (c) 2018 Discodirt
 * Copyright (c) 2024 xiphonics, inc.
 *
 * This file is part of the picoTracker firmware
 */

#ifndef _PLAYER_H_
#define _PLAYER_H_
#include "Application/Views/BaseClasses/ViewEvent.h"
#include "Application/Views/ViewData.h"
#include "DelayedRows.h"
#include "Externals/etl/include/etl/string.h"
#include "Foundation/Observable.h"
#include "Foundation/T_Singleton.h"
#include "PlayerMixer.h"
#include "RowFx.h"
#include "SyncMaster.h"
#include "System/Timer/Timer.h"
#include "config/StringLimits.h"

enum PlayerEventType { PET_START, PET_UPDATE, PET_STOP };

enum SequencerMode { SM_SONG, SM_LIVE };

enum QueueingMode {
  QM_NONE,
  QM_CHAINSTART,
  QM_PHRASESTART,
  QM_CHAINSTOP,
  QM_PHRASESTOP,
  QM_TICKSTART
};

typedef uint32_t MixerStereoLevel;

class I_Instrument;

class PlayerEvent : public ViewEvent {
public:
  PlayerEvent(PlayerEventType type, unsigned int tickCount = 0);
  PlayerEventType GetType();
  unsigned int GetTickCount();

private:
  PlayerEventType type_;
  unsigned int tickCount_;
};

class Player : public I_Observer,
               public Observable,
               public T_Singleton<Player> {
private: // Singleton
  friend class etl::singleton<Player>;
  Player();

public:
  bool Init(Project *, ViewData *);
  void BindProject(Project *, ViewData *);
  void Reset();
  void Close();

  virtual void Update(Observable &o, I_ObservableData *d);

  // basic interface

  void Start(PlayMode mode, bool forceSongMode, MixerServiceMode msmMode,
             bool stopAtEnd = false);
  void StartSelectionRender(PlayMode mode, uint8_t startRow, uint8_t endRow,
                            uint8_t channelStart, uint8_t channelEnd,
                            MixerServiceMode outputMode = MSM_FILE,
                            bool numberedSelectionRender = false);
  void Stop();

  void SetSequencerMode(SequencerMode mode);
  SequencerMode GetSequencerMode();

  void OnStartButton(PlayMode origin, unsigned int from, bool startFromLastPos,
                     unsigned char chainPos,
                     MixerServiceMode msmMode = MSM_AUDIO,
                     bool stopAtEnd = false);
  void OnSongStartButton(unsigned int from, unsigned int to, bool requestStop,
                         bool forceImmediate,
                         MixerServiceMode msmMode = MSM_AUDIO,
                         bool stopAtEnd = false);
  bool IsPlaying();

  bool IsRunning();
  bool GetStopAtEnd() { return stopAtEnd_; }

  bool ProcessChannelCommand(int channel, TrackerCommand cmd, ushort param);

  void StartStreaming(const char *name, int startSample = 0);
  void StartLoopingStreaming(const char *name);
  void StopStreaming();

  void StartRecordStreaming(uint16_t *srcBuffer, uint32_t size, bool stereo);
  void StopRecordStreaming();

  // Channel data

  bool IsChannelPlaying(int channel);
  void SetChannelMute(int channel, bool mute);
  bool IsChannelMuted(int channel);

  // Live queuing

  QueueingMode GetQueueingMode(int i);
  unsigned char GetQueuePosition(int i);
  unsigned char GetQueueChainPosition(int i);
  void QueueChannel(int i, QueueingMode mode, unsigned char position,
                    unsigned char chainpos = 0);

  const char *GetLiveIndicator(int channel);
  double GetPlayTime();

  const char *GetPlayedNote(int channel);
  const char *GetPlayedOctive(int channel);
  const char *GetPlayedInstrument(int channel);
  bool GetPlayedSliceIndex(int channel, uint8_t &sliceIndex);

  // info
  int GetPlayedBufferPercentage();

  etl::array<stereosample, SONG_CHANNEL_COUNT> *GetMixerLevels();

  // master out, last avg level while playing
  stereosample GetMasterLevel();

  etl::string<STRING_AUDIO_API_MAX> GetAudioAPI();
  etl::string<STRING_AUDIO_DEVICE_MAX> GetAudioDevice();
  int GetAudioBufferSize();
  int GetAudioRequestedBufferSize();
  int GetAudioPreBufferCount();

  Project *GetProject() { return project_; }

  // Direct note playback methods for MIDI
  void PlayNote(unsigned short instrumentIndex, unsigned short channel,
                unsigned char note, unsigned char velocity);
  void StopNote(unsigned short instrumentIndex, unsigned short channel);

protected:
  void updateSongPos(int position, int channel, int chainPos = 0, int hop = -1);
  void updateChainPos(int position, int channel, int hop = 0);
  void updatePhrasePos(int pos, int channel);
  void playRow(int32_t channel, const DelayedRow &row);
  void processRowCommands(int32_t channel, const DelayedRow &row);
  void StepAutomationTableForRetrigger(int channel, I_Instrument *instrument);
  void RetriggerChannelInstrument(int channel, int semitoneOffset,
                                  bool stepAutomationTable);
  void RetriggerChannelInstrumentAtNote(int channel, int note,
                                        bool stepAutomationTable);
  int getChannelHop(int channel, int pos);
  void moveToNextStep();
  void moveToNextPhrase(int channel, int hop = -1);
  void moveToNextChain(int channel, int hop);

  void triggerLiveChains();

  void SetAudioActive(bool active);

  bool isPlayable(int row, int col, int chainPos = 0);
  bool findPlayable(uchar *row, int col, uchar chainPos = 0);

private:
  void ResetLastActiveCommands();
  void RecordLastActiveCommand(int channel, TrackerCommand cmd, ushort param);
  void stopSelectionRender();

  PlayerMixer mixer_;
  ViewData *viewData_;
  Project *project_;

  SequencerMode sequencerMode_;
  PlayMode mode_;
  bool isRunning_;
  bool stopAtEnd_;
  bool selectionRenderActive_ = false;
  PlayMode selectionRenderMode_ = PM_SONG;
  uint8_t selectionRenderStartRow_ = 0;
  uint8_t selectionRenderEndRow_ = 0;
  uint8_t selectionRenderChannelStart_ = 0;
  uint8_t selectionRenderChannelEnd_ = SONG_CHANNEL_COUNT - 1;
  uint32_t selectionRenderFinishedChannels_ = 0;
  uint8_t selectionRenderSongEndRows_[SONG_CHANNEL_COUNT] = {};

  unsigned long startClock_; // .Used to time display live queued chains
                             //  for blinking effect
  unsigned long now_;
  int lastPercentage_;
  unsigned int lastBeatCount_;
  unsigned char lastSongPos_;
  bool firstPlayCycle_;
  bool triggerLiveChains_;

  double startTime_;

  char instrumentOnChannel_[SONG_CHANNEL_COUNT][3];

  // Live queuing system

  unsigned char liveQueuePosition_[SONG_CHANNEL_COUNT];
  QueueingMode liveQueueingMode_[SONG_CHANNEL_COUNT];
  unsigned char liveQueueChainPosition_[SONG_CHANNEL_COUNT];
  unsigned int timeToLive_[SONG_CHANNEL_COUNT];
  DelayedRows delayedRows_[SONG_CHANNEL_COUNT];

  bool retrigAllImmediate_;
  unsigned char retrigPos_;
  PlayerLastActiveCommandState lastActiveCommands_[SONG_CHANNEL_COUNT];
};

#endif
