xiphonics/picoTracker/sources/Application/Views/InstrumentView.cpp

/*
 * SPDX-License-Identifier: BSD-3-Clause
 *
 * Copyright (c) 2018 Discodirt
 * Copyright (c) 2024 xiphonics, inc.
 *
 * This file is part of the picoTracker firmware
 */

#include "InstrumentView.h"
#include "Application/Instruments/MidiInstrument.h"
#include "Application/Instruments/SIDInstrument.h"
#include "Application/Instruments/SampleInstrument.h"
#include "Application/Instruments/SamplePool.h"
#include "Application/Model/Config.h"
#include "Application/Persistency/PersistencyService.h"
#include "Application/Views/ImportView.h"
#include "Application/Views/SampleEditorView.h"
#include "BaseClasses/UIBigHexVarField.h"
#include "BaseClasses/UIIntVarField.h"
#include "BaseClasses/UIIntVarOffField.h"
#include "BaseClasses/UINoteVarField.h"
#include "BaseClasses/UIStaticField.h"
#include "Externals/etl/include/etl/to_string.h"
#include "Foundation/Constants/SpecialCharacters.h"
#include "ModalDialogs/MessageBox.h"
#include "ModalDialogs/TextInputModalView.h"
#include "System/System/System.h"
#include <Application/Utils/stringutils.h>
#include <cstdint>
#include <nanoprintf.h>

static constexpr InstrumentType kMaxSelectableInstrumentType =
    static_cast<InstrumentType>(IT_LAST - 1);

InstrumentView::InstrumentView(GUIWindow &w, ViewData *data)
    : FieldView(w, data), instrumentType_(FourCC::VarInstrumentType,
                                          InstrumentTypeNames, IT_LAST, 0),
      lastSampleIndex_(-1), suppressSampleChangeWarning_(false) {
  project_ = data->project_;

  GUIPoint position = GUIPoint(5, 1);
  typeIntVarField_.emplace_back(position, *&instrumentType_, "Type: %s", 0,
                                static_cast<int>(kMaxSelectableInstrumentType),
                                1, 1);
  fieldList_.insert(fieldList_.end(), &(*typeIntVarField_.rbegin()));
  (*typeIntVarField_.rbegin()).AddObserver(*this);
  lastFocusID_ = FourCC::VarInstrumentType;

  // Create the name field with the actual instrument variable
  I_Instrument *instr = getInstrument();
  if (instr) {
    // NONE dont have a name field
    if (instr->GetType() != IT_NONE) {
      position._y = 3;
      addNameTextField(instr, position);
    }
  }

  // add ui action fields for exporting and importing instrument settings
  position._y = 2;

  persistentActionField_.emplace_back("Import", FourCC::ActionImport, position);
  fieldList_.insert(fieldList_.end(), &(*persistentActionField_.rbegin()));
  (*persistentActionField_.rbegin()).AddObserver(*this);
  lastFocusID_ = FourCC::ActionImport;

  position._x += 8;
  persistentActionField_.emplace_back("Export", FourCC::ActionExport, position);
  fieldList_.insert(fieldList_.end(), &(*persistentActionField_.rbegin()));
  (*persistentActionField_.rbegin()).AddObserver(*this);
  lastFocusID_ = FourCC::ActionExport;

  sliceCountLabel_.clear();
}

InstrumentView::~InstrumentView() {}

void InstrumentView::Reset() {
  lastSampleIndex_ = -1;
  suppressSampleChangeWarning_ = false;
  exportInstrument_ = nullptr;
  exportName_.clear();
  lastFocusID_ = FourCC::VarInstrumentType;
  instrumentType_.SetInt(0, false);
  sliceCountLabel_.clear();
}

static void updateSliceCountLabel(etl::string<20> &label,
                                  SampleInstrument *instrument) {
  int32_t count = 0;
  if (instrument) {
    for (size_t i = 0; i < SampleInstrument::MaxSlices; ++i) {
      if (instrument->IsSliceDefined(i)) {
        count++;
      }
    }
  }
  if (count <= 1) {
    label = "Slices: off";
  } else {
    label = "Slices: ";
    etl::format_spec format;
    format.width(2).fill(' ');
    etl::to_string(count, label, format, true);
  }
}

void InstrumentView::addNameTextField(I_Instrument *instr, GUIPoint &position) {
  nameVariables_.emplace_back(instr);
  Variable &nameVar = *nameVariables_.rbegin();

  auto label =
      etl::make_string_with_capacity<MAX_UITEXTFIELD_LABEL_LENGTH>("Name: ");

  // Use an empty default name - we don't want to populate with sample filename
  // The display name will still be shown on the phrase screen via
  // GetDisplayName()
  etl::string<MAX_INSTRUMENT_NAME_LENGTH> defaultName;

  nameTextField_.emplace_back(nameVar, position, label, FourCC::InstrumentName,
                              defaultName);
  fieldList_.insert(fieldList_.end(), &(*nameTextField_.rbegin()));
}

I_Instrument *InstrumentView::getInstrument() {
  int id = viewData_->currentInstrumentID_;
  InstrumentBank *bank = viewData_->project_->GetInstrumentBank();
  return bank->GetInstrument(id);
};

void InstrumentView::onInstrumentTypeChange(bool updateUI) {
  auto nuType = (InstrumentType)instrumentType_.GetInt();
  I_Instrument *old = getInstrument();

  InstrumentBank *bank = viewData_->project_->GetInstrumentBank();

  auto id = viewData_->currentInstrumentID_;
  // release prev instrument back to available pool
  if (old != nullptr) {
    // first check if the instrument type actually changed, because could be
    // user is at end of instrument list and just keeps pressing key combo to
    // trigger next instrument event again and again
    if (old->GetType() == nuType) {
      if (updateUI) {
        refreshInstrumentFields();
      }
      return;
    }
    bank->releaseInstrument(viewData_->currentInstrumentID_);
  }

  // now assign new instrument type to the current instrument slot id
  unsigned short result = bank->GetNextAndAssignID(nuType, id);

  if (result == NO_MORE_INSTRUMENT) {
    Trace::Error("INSTRUMENTVIEW", "Failed to assign new instrument type: %d",
                 nuType);

    // TODO (democloid): this is a hack in order to ignore all existence of
    // certain instruments and seamlessly set NONE
    // Needed as the alternative is to change InstrumentTypeNames array plus all
    // switch instances which reference the types that wouldn't be available on
    // this platform

    // Show a dialog to the user
    char message[40];
    npf_snprintf(message, sizeof(message), "%s instruments exhausted!",
                 InstrumentTypeNames[nuType]);
    MessageBox *mb =
        MessageBox::Create(*this, message, "Trying next...", MBBF_OK);
    DoModal(mb);

    // Try to find the next available instrument type
    bool found = false;
    for (int i = nuType + 1;
         i <= static_cast<int>(kMaxSelectableInstrumentType); i++) {
      InstrumentType nextType = (InstrumentType)i;
      result = bank->GetNextAndAssignID(nextType, id);
      if (result != NO_MORE_INSTRUMENT) {
        Trace::Log("INSTRUMENTVIEW", "Assigned next available type: %d",
                   nextType);
        instrumentType_.SetInt(nextType, false);
        found = true;
        break; // Exit loop on success
      }
    }

    if (!found) {
      Trace::Log("INSTRUMENTVIEW",
                 "No other instrument types available, setting to NONE");
      instrumentType_.SetInt(IT_NONE, false);
    }

    refreshInstrumentFields();
    isDirty_ = true;
    return;
  }

  // Get the new instrument after type change
  I_Instrument *newInstr = getInstrument();
  if (newInstr) {
    Trace::Log("INSTRUMENTVIEW", "New instrument type: %d",
               newInstr->GetType());
  }

  // Refresh the UI fields for the new instrument type
  refreshInstrumentFields();

  // Mark the view as dirty to ensure it gets redrawn
  isDirty_ = true;
}

void InstrumentView::applyProposedTypeChangeUI() {
  instrumentType_.SetInt(pendingInstrumentType_, false);
  onInstrumentTypeChange();
}

void InstrumentView::onInstrumentChange() {

  ClearFocus();

  I_Instrument *old = getInstrument();
  InstrumentBank *bank = viewData_->project_->GetInstrumentBank();

  if (getInstrument() != old) {
    getInstrument()->RemoveObserver(*this);
  };

  // update type field to match current instrument
  ((WatchedVariable *)&instrumentType_)->SetInt(getInstrument()->GetType());

  refreshInstrumentFields();
};

void InstrumentView::refreshInstrumentFields() {
  for (auto &f : intVarField_) {
    f.RemoveObserver(*this);
  }
  for (auto &f : bigHexVarField_) {
    f.RemoveObserver(*this);
  }
  for (auto &f : intVarOffField_) {
    f.RemoveObserver(*this);
  }
  for (auto &f : bitmaskVarField_) {
    f.RemoveObserver(*this);
  }
  for (auto &f : sampleActionField_) {
    f.RemoveObserver(*this);
  }

  fieldList_.clear();
  intVarField_.clear();
  noteVarField_.clear();
  staticField_.clear();
  bigHexVarField_.clear();
  intVarOffField_.clear();
  sampleActionField_.clear();
  bitmaskVarField_.clear();
  nameTextField_.clear();
  nameVariables_.clear();
  lastSampleIndex_ = -1;

  // first put back the type field as its shown on *all* instrument types
  fieldList_.insert(fieldList_.end(), &(*typeIntVarField_.rbegin()));
  lastFocusID_ = FourCC::VarInstrumentType;

  // Re-add the action fields for export and import only if not IT_NONE
  if (instrumentType_.GetInt() != IT_NONE) {
    for (auto &action : persistentActionField_) {
      fieldList_.insert(fieldList_.end(), &action);
      action.AddObserver(*this); // Make sure observers are re-added
    }
  } else {
    // add back only the import field for IT_NONE
    // bit of a hack !!since we just assume that import is the first action
    // field
    fieldList_.insert(fieldList_.end(), &(*persistentActionField_.begin()));
    (*persistentActionField_.rbegin()).AddObserver(*this);
  }

  // Create a new nameTextField_ if the instrument type supports it
  if (instrumentType_.GetInt() != IT_NONE) {
    I_Instrument *instr = getInstrument();
    if (instr) {
      GUIPoint position = GetAnchor();
      addNameTextField(instr, position);
    }
  }

  InstrumentType it = getInstrument()->GetType();
  switch (it) {
  case IT_NONE:
    fillNoneParameters();
    break;
  case IT_MIDI:
    fillMidiParameters();
    break;
  case IT_SID:
    fillSIDParameters();
    break;
  case IT_SAMPLE:
    fillSampleParameters();
    break;
  case IT_OPAL:
    fillOpalParameters();
    break;
  case IT_LAST:
    // NA
    break;
  };

  for (auto field : fieldList_) {
    if (((UIIntVarField *)field)->GetVariableID() == lastFocusID_) {
      SetFocus(field);
      break;
    }
  }

  // observer all var fields so we can mark the instrument as modified
  // to be able to show confirmation dialog when switching instrument type
  for (auto &f : intVarField_) {
    f.AddObserver(*this);
  }
  for (auto &f : bigHexVarField_) {
    f.AddObserver(*this);
  }
  for (auto &f : intVarOffField_) {
    f.AddObserver(*this);
  }
  for (auto &f : bitmaskVarField_) {
    f.AddObserver(*this);
  }

  getInstrument()->AddObserver(*this);
}

void InstrumentView::fillNoneParameters() {}

void InstrumentView::fillSampleParameters() {
  int i = viewData_->currentInstrumentID_;
  InstrumentBank *bank = viewData_->project_->GetInstrumentBank();
  I_Instrument *instr = bank->GetInstrument(i);
  SampleInstrument *instrument = (SampleInstrument *)instr;
  lastSampleIndex_ = instrument->GetSampleIndex();

  GUIPoint position = GetAnchor();
  const int baseX = position._x;

  // offset y to account for instrument type and export/import fields
  position._y += 1;

  Variable *v = instrument->FindVariable(FourCC::SampleInstrumentSample);
  SamplePool *sp = SamplePool::GetInstance();
  intVarField_.emplace_back(position, *v, "Sample: %.17s", 0,
                            sp->GetNameListSize() - 1, 1, 0x10);
  fieldList_.insert(fieldList_.end(), &(*intVarField_.rbegin()));

  position._y += 1;
  updateSliceCountLabel(sliceCountLabel_, instrument);
  staticField_.emplace_back(position, sliceCountLabel_.c_str());
  fieldList_.insert(fieldList_.end(), &staticField_.back());

  GUIPoint actionPos = position;
  actionPos._x = baseX + 12;
  sampleActionField_.emplace_back("Adjust", FourCC::ActionShowSampleSlices,
                                  actionPos);
  fieldList_.insert(fieldList_.end(), &sampleActionField_.back());
  sampleActionField_.back().AddObserver(*this);

  position._y += 1;
  v = instrument->FindVariable(FourCC::SampleInstrumentVolume);
  intVarField_.emplace_back(position, *v, "Volume: %d [%2.2X]", 0, 255, 1, 10);
  fieldList_.insert(fieldList_.end(), &(*intVarField_.rbegin()));

  position._y += 1;
  v = instrument->FindVariable(FourCC::SampleInstrumentPan);
  intVarField_.emplace_back(position, *v, "Pan: %2.2X", 0, 0xFE, 1, 0x10);
  fieldList_.insert(fieldList_.end(), &(*intVarField_.rbegin()));

  position._y += 1;
  v = instrument->FindVariable(FourCC::SampleInstrumentRootNote);
  noteVarField_.emplace_back(position, *v, "Root note: %s", 0, 0x7F, 1, 0x0C);
  fieldList_.insert(fieldList_.end(), &(*noteVarField_.rbegin()));

  position._y += 1;
  v = instrument->FindVariable(FourCC::SampleInstrumentFineTune);
  intVarField_.emplace_back(position, *v, "Detune: %2.2X", 0, 255, 1, 0x10);
  fieldList_.insert(fieldList_.end(), &(*intVarField_.rbegin()));

  position._y += 1;
  v = instrument->FindVariable(FourCC::SampleInstrumentCrushVolume);
  intVarField_.emplace_back(position, *v, "Drive: %2.2X", 0, 0xFF, 1, 0x10);
  fieldList_.insert(fieldList_.end(), &(*intVarField_.rbegin()));

  position._y += 1;
  v = instrument->FindVariable(FourCC::SampleInstrumentCrush);
  intVarField_.emplace_back(position, *v, "Crush: %d", 1, 0x10, 1, 4);
  fieldList_.insert(fieldList_.end(), &(*intVarField_.rbegin()));

  position._y += 1;
  v = instrument->FindVariable(FourCC::SampleInstrumentDownsample);
  intVarField_.emplace_back(position, *v, "Downsample: %d", 0, 8, 1, 4);
  fieldList_.insert(fieldList_.end(), &(*intVarField_.rbegin()));

  position._y += 2;
  staticField_.emplace_back(position, "Flt cut/res:");
  fieldList_.insert(fieldList_.end(), &(*staticField_.rbegin()));

  position._x += 13;
  v = instrument->FindVariable(FourCC::SampleInstrumentFilterCutOff);
  intVarField_.emplace_back(position, *v, "%2.2X", 0, 0xFF, 1, 0x10);
  fieldList_.insert(fieldList_.end(), &(*intVarField_.rbegin()));

  position._x += 3;
  v = instrument->FindVariable(FourCC::SampleInstrumentFilterResonance);
  intVarField_.emplace_back(position, *v, "%2.2X", 0, 0xFF, 1, 0x10);
  fieldList_.insert(fieldList_.end(), &(*intVarField_.rbegin()));

  position._x -= 16;

  position._y += 1;
  v = instrument->FindVariable(FourCC::SampleInstrumentFilterType);
  intVarField_.emplace_back(position, *v, "Type: %2.2X", 0, 0xFF, 1, 0x10);
  fieldList_.insert(fieldList_.end(), &(*intVarField_.rbegin()));

  position._y += 1;
  v = instrument->FindVariable(FourCC::SampleInstrumentFilterMode);
  intVarField_.emplace_back(position, *v, "Mode: %s", 0, 2, 1, 1);
  fieldList_.insert(fieldList_.end(), &(*intVarField_.rbegin()));

  position._y += 1;
  v = instrument->FindVariable(FourCC::SampleInstrumentInterpolation);
  intVarField_.emplace_back(position, *v, "Interpolation: %s", 0, 1, 1, 1);
  fieldList_.insert(fieldList_.end(), &(*intVarField_.rbegin()));

  position._y += 1;
  v = instrument->FindVariable(FourCC::SampleInstrumentLoopMode);
  intVarField_.emplace_back(position, *v, "Loop mode: %s", 0, SILM_LAST - 1, 1,
                            1);
  fieldList_.insert(fieldList_.end(), &(*intVarField_.rbegin()));

  position._y += 1;
  v = instrument->FindVariable(FourCC::SampleInstrumentStart);
  bigHexVarField_.emplace_back(position, *v, 7, "Start: %7.7X", 0,
                               instrument->GetSampleSize() - 1, 16);
  fieldList_.insert(fieldList_.end(), &(*bigHexVarField_.rbegin()));

  position._y += 1;
  v = instrument->FindVariable(FourCC::SampleInstrumentLoopStart);
  bigHexVarField_.emplace_back(position, *v, 7, "Loop start: %7.7X", 0,
                               instrument->GetSampleSize() - 1, 16);
  fieldList_.insert(fieldList_.end(), &(*bigHexVarField_.rbegin()));

  position._y += 1;
  v = instrument->FindVariable(FourCC::SampleInstrumentEnd);
  bigHexVarField_.emplace_back(position, *v, 7, "Loop end: %7.7X", 0,
                               instrument->GetSampleSize() - 1, 16);
  fieldList_.insert(fieldList_.end(), &(*bigHexVarField_.rbegin()));

  position._y += 1;
  v = instrument->FindVariable(FourCC::SampleInstrumentTable);
  intVarOffField_.emplace_back(position, *v, "Table: %2.2X", 0x00,
                               TABLE_COUNT - 1, 1, 0x10);
  fieldList_.insert(fieldList_.end(), &(*intVarOffField_.rbegin()));

  v = instrument->FindVariable(FourCC::SampleInstrumentTableAutomation);
  position._x += 12;
  intVarField_.emplace_back(position, *v, "Auto: %s", 0, 1, 1, 1);
  fieldList_.insert(fieldList_.end(), &(*intVarField_.rbegin()));
};

void InstrumentView::fillSIDParameters() {
  int i = viewData_->currentInstrumentID_;
  InstrumentBank *bank = viewData_->project_->GetInstrumentBank();
  SIDInstrument *instrument = (SIDInstrument *)bank->GetInstrument(i);
  GUIPoint position = GetAnchor();

  // offset y to account for instrument type, name and export/import fields
  position._y += 1;

  staticField_.emplace_back(position, instrument->GetChipName());
  fieldList_.insert(fieldList_.end(), &(*staticField_.rbegin()));

  position._y += 2;
  staticField_.emplace_back(position, "Oscillator Settings" char_line_5_s);
  fieldList_.insert(fieldList_.end(), &(*staticField_.rbegin()));

  position._y += 2;
  Variable *v = instrument->FindVariable(FourCC::SIDInstrumentOSCNumber);
  intVarField_.emplace_back(position, *v, "Oscillator:    %1.1X", 0, 0x2, 1, 1);
  fieldList_.insert(fieldList_.end(), &(*intVarField_.rbegin()));

  position._y += 1;
  v = instrument->FindVariable(FourCC::SIDInstrumentPulseWidth);
  intVarField_.emplace_back(position, *v, "  Pulsewidth:  %2.2X", 0, 0xFFF, 1,
                            0x10);
  fieldList_.insert(fieldList_.end(), &(*intVarField_.rbegin()));

  position._y += 1;
  v = instrument->FindVariable(FourCC::SIDInstrumentWaveform);

  intVarField_.emplace_back(position, *v, "  Waveform:    %s", 0, DWF_LAST - 1,
                            1, 1);
  fieldList_.insert(fieldList_.end(), &(*intVarField_.rbegin()));

  position._y += 1;
  v = instrument->FindVariable(FourCC::SIDInstrumentVSync);
  intVarField_.emplace_back(position, *v, "  Osc Sync:    %s", 0, 1, 1, 1);
  fieldList_.insert(fieldList_.end(), &(*intVarField_.rbegin()));

  position._y += 1;
  v = instrument->FindVariable(FourCC::SIDInstrumentRingModulator);
  intVarField_.emplace_back(position, *v, "  Ring Mod:    %s", 0, 1, 1, 1);
  fieldList_.insert(fieldList_.end(), &(*intVarField_.rbegin()));

  position._y += 2;
  v = instrument->FindVariable(FourCC::SIDInstrumentADSR);
  bigHexVarField_.emplace_back(UIBigHexVarField(
      position, *v, 4, "Env. A/D/S/R:  %4.4X", 0, 0xFFFF, 16, true));
  fieldList_.insert(fieldList_.end(), &(*bigHexVarField_.rbegin()));

  position._y += 2;
  staticField_.emplace_back(position, "Chip Settings" char_line_11_s);
  fieldList_.insert(fieldList_.end(), &(*staticField_.rbegin()));

  position._y += 2;
  v = instrument->FindVariable(FourCC::SIDInstrumentFilterOn);
  intVarField_.emplace_back(position, *v, "Filter:        %s", 0, 1, 1, 1);
  fieldList_.insert(fieldList_.end(), &(*intVarField_.rbegin()));

  position._y += 1;
  switch (instrument->GetChip()) {
  case SID1:
    v = instrument->FindVariable(FourCC::SIDInstrument1FilterCut);
    break;
  case SID2:
    v = instrument->FindVariable(FourCC::SIDInstrument2FilterCut);
    break;
  }
  intVarField_.emplace_back(position, *v, "  Cutoff:      %1.1X", 0, 0x7FF, 1,
                            0x10);
  fieldList_.insert(fieldList_.end(), &(*intVarField_.rbegin()));

  position._y += 1;
  switch (instrument->GetChip()) {
  case SID1:
    v = instrument->FindVariable(FourCC::SIDInstrument1FilterResonance);
    break;
  case SID2:
    v = instrument->FindVariable(FourCC::SIDInstrument2FilterResonance);
    break;
  }
  intVarField_.emplace_back(position, *v, "  Resonance:   %1.1X", 0, 0xF, 1, 1);
  fieldList_.insert(fieldList_.end(), &(*intVarField_.rbegin()));

  position._y += 1;
  switch (instrument->GetChip()) {
  case SID1:
    v = instrument->FindVariable(FourCC::SIDInstrument1FilterMode);
    break;
  case SID2:
    v = instrument->FindVariable(FourCC::SIDInstrument2FilterMode);
    break;
  }
  intVarField_.emplace_back(position, *v, "  Mode:        %s", 0, DFM_LAST - 1,
                            1, 1);
  fieldList_.insert(fieldList_.end(), &(*intVarField_.rbegin()));

  position._y += 2;
  switch (instrument->GetChip()) {
  case SID1:
    v = instrument->FindVariable(FourCC::SIDInstrument1Volume);
    break;
  case SID2:
    v = instrument->FindVariable(FourCC::SIDInstrument2Volume);
    break;
  }
  intVarField_.emplace_back(position, *v, "Volume:        %1.1X", 0, 0xF, 1, 1);
  fieldList_.insert(fieldList_.end(), &(*intVarField_.rbegin()));
};

void InstrumentView::fillMidiParameters() {

  int i = viewData_->currentInstrumentID_;
  InstrumentBank *bank = viewData_->project_->GetInstrumentBank();
  I_Instrument *instr = bank->GetInstrument(i);
  MidiInstrument *instrument = (MidiInstrument *)instr;
  GUIPoint position = GetAnchor();

  // offset y to account for instrument type, name and export/import fields
  position._y += 3;

  Variable *v = instrument->FindVariable(FourCC::MidiInstrumentChannel);
  intVarField_.emplace_back(
      UIIntVarField(position, *v, "Channel: %2.2d", 0, 0x0F, 1, 0x04, 1));
  fieldList_.insert(fieldList_.end(), &(*intVarField_.rbegin()));

  position._y += 1;
  v = instrument->FindVariable(FourCC::MidiInstrumentVolume);
  intVarField_.emplace_back(
      UIIntVarField(position, *v, "Volume: %2.2X", 0, 0xFF, 1, 0x10));
  fieldList_.insert(fieldList_.end(), &(*intVarField_.rbegin()));

  position._y += 1;
  v = instrument->FindVariable(FourCC::MidiInstrumentNoteLength);
  intVarField_.emplace_back(
      UIIntVarField(position, *v, "Length: %2.2X", 0, 0xFF, 1, 0x10));
  fieldList_.insert(fieldList_.end(), &(*intVarField_.rbegin()));

  position._y += 1;
  v = instrument->FindVariable(FourCC::MidiInstrumentProgram);
  intVarOffField_.emplace_back(
      UIIntVarOffField(position, *v, "Program: %2.2X", 0, 0x7F, 1, 0x10));
  fieldList_.insert(fieldList_.end(), &(*intVarOffField_.rbegin()));

  position._y += 1;
  v = instrument->FindVariable(FourCC::MidiInstrumentTableAutomation);
  intVarField_.emplace_back(
      UIIntVarField(position, *v, "Automation: %s", 0, 1, 1, 1));
  fieldList_.insert(fieldList_.end(), &(*intVarField_.rbegin()));

  position._y += 1;
  v = instrument->FindVariable(FourCC::MidiInstrumentTable);
  intVarOffField_.emplace_back(
      UIIntVarOffField(position, *v, "Table: %2.2X", 0, 0x7F, 1, 0x10));
  fieldList_.insert(fieldList_.end(), &(*intVarOffField_.rbegin()));
};

void InstrumentView::fillOpalParameters() {
  int i = viewData_->currentInstrumentID_;
  InstrumentBank *bank = viewData_->project_->GetInstrumentBank();
  I_Instrument *instr = bank->GetInstrument(i);
  OpalInstrument *instrument = (OpalInstrument *)instr;
  GUIPoint position = GetAnchor();

  // extra y spacing to allow for gap between export/import and parameters
  position._y += 2;
  staticField_.emplace_back(position, "General Settings" char_line_8_s);
  fieldList_.insert(fieldList_.end(), &(*staticField_.rbegin()));

  position._y += 2;
  Variable *v = instrument->FindVariable(FourCC::OPALInstrumentAlgorithm);
  intVarField_.emplace_back(position, *v, "Algorithm:     %s", 0, 1, 1, 1);
  fieldList_.insert(fieldList_.end(), &(*intVarField_.rbegin()));

  position._y += 1;
  v = instrument->FindVariable(FourCC::OPALInstrumentDeepTremeloVibrato);
  bitmaskVarField_.emplace_back(
      UIBitmaskVarField(position, *v, "Deep Trem/Vib: %02b", 2));
  fieldList_.insert(fieldList_.end(), &(*bitmaskVarField_.rbegin()));

  position._y += 1;
  v = instrument->FindVariable(FourCC::OPALInstrumentFeedback);
  intVarField_.emplace_back(
      UIIntVarField(position, *v, "Feedback:      %1.1X", 0, 0x07, 1, 1, 0));
  fieldList_.insert(fieldList_.end(), &(*intVarField_.rbegin()));

  position._y += 2;
  staticField_.emplace_back(position, "Operator Settings" char_line_7_s);
  fieldList_.insert(fieldList_.end(), &(*staticField_.rbegin()));

  // operator settings
  position._y += 2;
  staticField_.emplace_back(
      position, "               Op 1" char_border_single_vertical_s "Op 2");
  fieldList_.insert(fieldList_.end(), &(*staticField_.rbegin()));

  position._y += 1;
  staticField_.emplace_back(
      position,
      "               " char_line_4_s char_border_single_cross_s char_line_4_s);
  fieldList_.insert(fieldList_.end(), &(*staticField_.rbegin()));

  // vertical table separator
  GUIPoint p = position + GUIPoint(19, 1);
  for (int n = 0; n < 6; n++) {
    staticField_.emplace_back(p, char_border_single_vertical_s);
    fieldList_.insert(fieldList_.end(), &(*staticField_.rbegin()));
    p._y += 1;
  }

  position._y += 1;
  v = instrument->FindVariable(FourCC::OPALInstrumentOp1Level);
  intVarField_.emplace_back(
      UIIntVarField(position, *v, "Level:         %2.2X", 0, 63, 1, 1, 0));
  fieldList_.insert(fieldList_.end(), &(*intVarField_.rbegin()));

  v = instrument->FindVariable(FourCC::OPALInstrumentOp2Level);
  intVarField_.emplace_back(
      UIIntVarField(position + GUIPoint(20, 0), *v, "%2.2X", 0, 63, 1, 1, 0));
  fieldList_.insert(fieldList_.end(), &(*intVarField_.rbegin()));

  position._y += 1;
  v = instrument->FindVariable(FourCC::OPALInstrumentOp1Multiplier);
  intVarField_.emplace_back(
      UIIntVarField(position, *v, "Multiplier:    %1.1X", 0, 15, 1, 1, 0));
  fieldList_.insert(fieldList_.end(), &(*intVarField_.rbegin()));

  v = instrument->FindVariable(FourCC::OPALInstrumentOp2Multiplier);
  intVarField_.emplace_back(
      UIIntVarField(position + GUIPoint(20, 0), *v, "%1.1X", 0, 15, 1, 1, 0));
  fieldList_.insert(fieldList_.end(), &(*intVarField_.rbegin()));

  position._y += 1;
  v = instrument->FindVariable(FourCC::OPALInstrumentOp1ADSR);
  bigHexVarField_.emplace_back(UIBigHexVarField(
      position, *v, 4, "A/D/S/R:       %4.4X", 0, 0xFFFF, 16, true));
  fieldList_.insert(fieldList_.end(), &(*bigHexVarField_.rbegin()));

  v = instrument->FindVariable(FourCC::OPALInstrumentOp2ADSR);
  bigHexVarField_.emplace_back(UIBigHexVarField(
      position + GUIPoint(20, 0), *v, 4, "%4.4X", 0, 0xFFFF, 16, true));
  fieldList_.insert(fieldList_.end(), &(*bigHexVarField_.rbegin()));

  position._y += 1;
  v = instrument->FindVariable(FourCC::OPALInstrumentOp1WaveShape);
  intVarField_.emplace_back(
      UIIntVarField(position, *v, "Shape:         %s", 0, 7, 1, 1));
  fieldList_.insert(fieldList_.end(), &(*intVarField_.rbegin()));

  v = instrument->FindVariable(FourCC::OPALInstrumentOp2WaveShape);
  intVarField_.emplace_back(
      UIIntVarField(position + GUIPoint(20, 0), *v, "%s", 0, 7, 1, 1));
  fieldList_.insert(fieldList_.end(), &(*intVarField_.rbegin()));

  position._y += 1;
  v = instrument->FindVariable(FourCC::OPALInstrumentOp1TremVibSusKSR);
  bitmaskVarField_.emplace_back(
      UIBitmaskVarField(position, *v, "TR/VB/SU/KSR:  %04b", 4));
  fieldList_.insert(fieldList_.end(), &(*bitmaskVarField_.rbegin()));

  v = instrument->FindVariable(FourCC::OPALInstrumentOp2TremVibSusKSR);
  bitmaskVarField_.emplace_back(
      UIBitmaskVarField(position + GUIPoint(20, 0), *v, "%04b", 4));
  fieldList_.insert(fieldList_.end(), &(*bitmaskVarField_.rbegin()));

  position._y += 1;
  v = instrument->FindVariable(FourCC::OPALInstrumentOp1KeyScaleLevel);
  intVarField_.emplace_back(
      UIIntVarField(position, *v, "Keyscale:      %s", 0, 3, 1, 1));
  fieldList_.insert(fieldList_.end(), &(*intVarField_.rbegin()));

  v = instrument->FindVariable(FourCC::OPALInstrumentOp2KeyScaleLevel);
  intVarField_.emplace_back(
      UIIntVarField(position + GUIPoint(20, 0), *v, "%s", 0, 3, 1, 1));
  fieldList_.insert(fieldList_.end(), &(*intVarField_.rbegin()));

  Trace::Error("OPAL fill done, total fields: %d", fieldList_.size());
};

void InstrumentView::warpToNext(int offset) {
  int instrument = viewData_->currentInstrumentID_ + offset;
  if (instrument >= MAX_INSTRUMENT_COUNT) {
    instrument = instrument - MAX_INSTRUMENT_COUNT;
  };
  if (instrument < 0) {
    instrument = MAX_INSTRUMENT_COUNT + instrument;
  };
  viewData_->currentInstrumentID_ = instrument;
  onInstrumentChange();
  isDirty_ = true;
};

void InstrumentView::ProcessButtonMask(unsigned short mask, bool pressed) {

  if (!pressed)
    return;

  isDirty_ = false;
  if ((mask & EPBM_EDIT) && (mask & EPBM_ENTER)) {
    int i = viewData_->currentInstrumentID_;
    InstrumentBank *bank = viewData_->project_->GetInstrumentBank();
    I_Instrument *instr = bank->GetInstrument(i);
    if (GetFocus() == *fieldList_.begin()) {
      bool instrumentModified = checkInstrumentModified();
      if (instrumentModified) {
        MessageBox *mb = MessageBox::Create(*this, "Reset all settings?",
                                            MBBF_YES | MBBF_NO);
        pendingPurgeInstrument_ = instr;
        DoModal(mb,
                ModalViewCallback::create<
                    InstrumentView, &InstrumentView::onConfirmResetInstrument>(
                    *this));
      }
      return;
    }
    if (getInstrument()->GetType() == IT_SAMPLE) {
      UIIntVarField *field = (UIIntVarField *)GetFocus();
      if (field->GetVariableID() == FourCC::SampleInstrumentEnd) {
        Variable &var = field->GetVariable();
        SampleInstrument *instrument = (SampleInstrument *)instr;
        var.SetInt(instrument->GetSampleSize() - 1);
        isDirty_ = true;
        return;
      };
    }
  }

  // Call the parent class's implementation first to ensure action fields like
  // Export, Import work correctly
  FieldView::ProcessButtonMask(mask, pressed);

  Player *player = Player::GetInstance();

  if (mask == EPBM_ENTER) {
    // Get the current field to check if we're on the sample field
    UIIntVarField *currentField = (UIIntVarField *)GetFocus();

    // Only allow sample import when the sample field is selected
    if (getInstrument()->GetType() == IT_SAMPLE && currentField &&
        currentField->GetVariableID() == FourCC::SampleInstrumentSample) {

      if (viewMode_ == VM_NEW) {
        viewMode_ = VM_NORMAL; // clear the "enter double tap" state
        if (!player->IsRunning()) {
          // First check if the samplelib exists
          bool samplelibExists =
              FileSystem::GetInstance()->exists(SAMPLES_LIB_DIR);

          if (!samplelibExists) {
            MessageBox *mb = MessageBox::Create(
                *this, "Can't access the samplelib", MBBF_OK);
            DoModal(mb);
          } else {
            ImportView::SetSourceViewType(VT_INSTRUMENT);
            // set browser into sample import mode in top level samples dir
            viewData_->importViewStartDir = SAMPLES_LIB_DIR;

            // Go to import sample
            ViewType vt = VT_IMPORT;
            ViewEvent ve(VET_SWITCH_VIEW, &vt);
            SetChanged();
            NotifyObservers(&ve);
          }
        } else {
          MessageBox *mb =
              MessageBox::Create(*this, "Not while playing", MBBF_OK);
          DoModal(mb);
        }
      } else {
        // mark as "new" mode so a 2nd following ENTER will trigger the sample
        // import above
        viewMode_ = VM_NEW;
      }
    } else if (viewMode_ == VM_NEW) {
      // If we're not on the sample field but in VM_NEW mode, reset it
      viewMode_ = VM_NORMAL;
    }

    UIIntVarField *field = (UIIntVarField *)GetFocus();
    Variable &v = field->GetVariable();
    switch (v.GetID()) {
    case FourCC::SampleInstrumentTable: {
      int next = TableHolder::GetInstance()->GetNext();
      if (next != NO_MORE_TABLE) {
        v.SetInt(next);
        isDirty_ = true;
      }
      break;
    }
    default:
      break;
    }
    mask &= (0xFFFF - EPBM_ENTER);
  } else {
    // Clear the VM_NEW state if any key other than ENTER is pressed
    if (viewMode_ == VM_NEW) {
      viewMode_ = VM_NORMAL;
    }
  }

  if (viewMode_ == VM_CLONE) {
    if ((mask & EPBM_ENTER) && (mask & EPBM_ALT)) {
      UIIntVarField *field = (UIIntVarField *)GetFocus();
      mask &= (0xFFFF - EPBM_ENTER);
      Variable &v = field->GetVariable();
      int current = v.GetInt();
      if (current == -1)
        return;

      if ((field->GetVariableID() == FourCC::SampleInstrumentTable) ||
          (field->GetVariableID() == FourCC::MidiInstrumentTable)) {
        int next = TableHolder::GetInstance()->Clone(current);
        if (next != NO_MORE_TABLE) {
          v.SetInt(next);
          isDirty_ = true;
        }
      };
    }
    mask &= (0xFFFF - (EPBM_ENTER | EPBM_ALT));
  };

  if (viewMode_ == VM_SELECTION) {
  } else {
    // viewMode_ = VM_NORMAL;
  }

  // EDIT Modifier
  if (mask & EPBM_EDIT) {
    if (mask & EPBM_LEFT)
      warpToNext(-1);
    if (mask & EPBM_RIGHT)
      warpToNext(+1);
    if (mask & EPBM_DOWN)
      warpToNext(-16);
    if (mask & EPBM_UP)
      warpToNext(+16);
    if (mask & EPBM_ALT) {
      viewMode_ = VM_CLONE;
    };
    if (mask & EPBM_PLAY) {
      // recording screen
      if (!Player::GetInstance()->IsRunning()) {
        switchToRecordView();
      }
    }
  } else if (mask & EPBM_NAV) {
    // NAV Modifier
    if (mask & EPBM_LEFT) {
      ViewType vt = VT_PHRASE;
      ViewEvent ve(VET_SWITCH_VIEW, &vt);

      // remove listening when leaving this screen
      getInstrument()->RemoveObserver(*this);
      ((WatchedVariable *)&instrumentType_)->RemoveObserver(*this);

      SetChanged();
      NotifyObservers(&ve);
    }

    if (mask & EPBM_DOWN) {

      // Go to table view

      ViewType vt = VT_TABLE2;

      int i = viewData_->currentInstrumentID_;
      InstrumentBank *bank = viewData_->project_->GetInstrumentBank();
      I_Instrument *instr = bank->GetInstrument(i);
      int table = instr->GetTable();
      if (table != VAR_OFF) {
        viewData_->currentTable_ = table;
      }
      ViewEvent ve(VET_SWITCH_VIEW, &vt);
      SetChanged();
      NotifyObservers(&ve);
    }

    if (mask & EPBM_PLAY) {
      player->OnStartButton(PM_PHRASE, viewData_->songX_, true,
                            viewData_->chainRow_);
    }
  } else {
    // No modifier
    if (mask & EPBM_PLAY) {
      player->OnStartButton(PM_PHRASE, viewData_->songX_, false,
                            viewData_->chainRow_);
    }
  }

  UIIntVarField *field = (UIIntVarField *)GetFocus();
  if (field) {
    lastFocusID_ = field->GetVariableID();
  }
};

void InstrumentView::DrawView() {
  Clear();

  GUITextProperties props;
  GUIPoint pos = GetTitlePosition();

  // Draw title

  char title[20];
  SetColor(CD_NORMAL);
  npf_snprintf(title, sizeof(title), "Instrument %2.2X",
               viewData_->currentInstrumentID_);
  DrawString(pos._x, pos._y, title, props);
  // Draw fields
  FieldView::Redraw();
  drawMap();

  // Draw instrument type with special handling for SID and OPAL
  I_Instrument *instr = getInstrument();
  if (instr) {
    InstrumentType type = instr->GetType();
    if (type == IT_SID || type == IT_OPAL) {
      SetColor(CD_WARN);
      DrawString(18, 1, char_button_border_left_s, props);
      DrawString(19, 1, "EXPERIMENTAL", GUITextProperties(true));
      DrawString(31, 1, char_button_border_right_s, props);
      SetColor(CD_NORMAL);
    }
  }
}

void InstrumentView::OnFocus() {
  Trace::Log("INSTRUMENTVIEW", "onFocus");

  // Get latest selected instrument, ensures we display the instrument that was
  // selected in the PhraseView
  int currentID = viewData_->currentInstrumentID_;
  Trace::Debug("INSTRUMENTVIEW", "Current instrument ID from ViewData: %d",
               currentID);

  // Get the current instrument based on the ViewData's currentInstrumentID_
  InstrumentBank *bank = viewData_->project_->GetInstrumentBank();
  I_Instrument *instr = bank->GetInstrument(currentID);

  if (instr) {
    // Update the instrument type field to match the current instrument
    InstrumentType currentType = instr->GetType();

    Trace::Debug("INSTRUMENTVIEW", "Current instrument type: %d", currentType);

    // Only update if the type has changed
    if (instrumentType_.GetInt() != currentType) {
      Trace::Log("INSTRUMENTVIEW",
                 "OnFocus instrument type changed from %d to %d",
                 instrumentType_.GetInt(), currentType);
      // Set the instrument type without triggering the observer update
      // because we dont want the observer to do its normal check for a modified
      // instrument
      instrumentType_.SetInt(currentType, false);
    }

    // Always refresh the UI fields when focusing the view in case of instrument
    // change from last time
    onInstrumentTypeChange(true);
  }
}

void InstrumentView::Update(Observable &o, I_ObservableData *data) {

  if (!hasFocus_) {
    return;
  }

  uintptr_t fourcc = (uintptr_t)data;

  switch (fourcc) {
  case FourCC::VarInstrumentType: {
    // Get the current instrument to determine its actual type
    I_Instrument *instr = getInstrument();
    InstrumentType currentType = instr ? instr->GetType() : IT_NONE;

    // Store the proposed instrument type BEFORE we revert the UI
    InstrumentType proposedType = (InstrumentType)instrumentType_.GetInt();

    // Revert the UI field back to the current type until confirmed
    instrumentType_.SetInt(currentType, false);

    // Check if player is running
    Player *player = Player::GetInstance();
    bool instrumentUsedInPhrase = false;
    if (currentType != IT_NONE) {
      const uchar *phraseInstruments = viewData_->song_->phrase_.instr_;
      for (int i = 0; i < PHRASE_COUNT * STEPS_PER_PHRASE; i++) {
        if (phraseInstruments[i] == viewData_->currentInstrumentID_) {
          instrumentUsedInPhrase = true;
          break;
        }
      }
    }

    if (!player->IsRunning() || currentType == IT_NONE ||
        !instrumentUsedInPhrase) {
      // Check if any instrument field has been modified
      bool instrumentModified = checkInstrumentModified();
      if (instrumentModified) {
        MessageBox *mb = MessageBox::Create(
            *this, "Change Instrument &", "lose settings?", MBBF_YES | MBBF_NO);
        pendingInstrumentType_ = proposedType;
        DoModal(
            mb,
            ModalViewCallback::create<
                InstrumentView, &InstrumentView::onConfirmInstrumentTypeChange>(
                *this));
      } else {
        // Apply the proposed type change immediately if not modified
        instrumentType_.SetInt(proposedType, false);
        onInstrumentTypeChange();
      }
    } else {
      MessageBox *mb = MessageBox::Create(*this, "Not while playing", MBBF_OK);
      DoModal(mb);
    }
    break;
  }
  case FourCC::ActionExport: {
    handleInstrumentExport();
  } break;
  case FourCC::ActionImport: {
    // Switch to the InstrumentImportView
    ViewType vt = VT_INSTRUMENT_IMPORT;
    ViewEvent ve(VET_SWITCH_VIEW, &vt);
    SetChanged();
    NotifyObservers(&ve);
  } break;
  case FourCC::SampleInstrumentSample: {
    I_Instrument *instr = getInstrument();
    if (!instr || instr->GetType() != IT_SAMPLE) {
      break;
    }

    SampleInstrument *sampleInstr = static_cast<SampleInstrument *>(instr);
    int newIndex = sampleInstr->GetSampleIndex();

    if (suppressSampleChangeWarning_) {
      suppressSampleChangeWarning_ = false;
      lastSampleIndex_ = newIndex;
      break;
    }

    if (newIndex == lastSampleIndex_) {
      break;
    }

    if (!sampleInstr->HasSlicesForWarning()) {
      sampleInstr->ClearSlices();
      lastSampleIndex_ = newIndex;
      updateSliceCountLabel(sliceCountLabel_, sampleInstr);
      isDirty_ = true;
      break;
    }

    MessageBox *mb = MessageBox::Create(*this, "Change sample &",
                                        "clear slices?", MBBF_YES | MBBF_NO);
    pendingSampleChangeInstrument_ = sampleInstr;
    pendingSampleChangeNewIndex_ = newIndex;
    DoModal(mb,
            ModalViewCallback::create<InstrumentView,
                                      &InstrumentView::onConfirmSampleChange>(
                *this));
  } break;
  case FourCC::ActionShowSampleSlices: {
    I_Instrument *instr = getInstrument();
    if (!instr || instr->GetType() != IT_SAMPLE) {
      break;
    }
    SampleInstrument *sampleInstr = static_cast<SampleInstrument *>(instr);
    if (sampleInstr->GetSampleIndex() < 0) {
      MessageBox *mb =
          MessageBox::Create(*this, "Assign a sample first", MBBF_OK);
      DoModal(mb);
      break;
    }
    ViewType vt = VT_SAMPLE_SLICES;
    ViewEvent ve(VET_SWITCH_VIEW, &vt);
    SetChanged();
    NotifyObservers(&ve);
  } break;
  case FourCC::MidiInstrumentProgram: {
    // When program value changes, send a MIDI Program Change message during
    // playback
    if (!Player::GetInstance()->IsRunning()) {
      break;
    }

    I_Instrument *instr = getInstrument();
    if (instr && instr->GetType() == IT_MIDI) {
      MidiInstrument *midiInstr = (MidiInstrument *)instr;

      // Get the channel and program values
      Variable *channelVar =
          midiInstr->FindVariable(FourCC::MidiInstrumentChannel);
      Variable *programVar =
          midiInstr->FindVariable(FourCC::MidiInstrumentProgram);

      if (channelVar && programVar) {
        int channel = channelVar->GetInt();
        int program = programVar->GetInt();

        // Send Program Change message
        midiInstr->SendProgramChange(channel, program);
      }
    }
  } break;
  default:
    break;
  }
}

bool InstrumentView::checkInstrumentModified() {
  // Get current instrument
  I_Instrument *instrument = getInstrument();
  if (!instrument) {
    return false;
  }

  // Get the list of variables for this instrument
  etl::ilist<Variable *> *variables = instrument->Variables();
  if (!variables) {
    return false;
  }

  // Check if any variable has been modified from its default value
  for (auto it = variables->begin(); it != variables->end(); ++it) {
    Variable *var = *it;
    if (var && var->IsModified()) {
      return true;
    }
  }

  // No variables have been modified
  return false;
}

void InstrumentView::resetInstrumentToDefaults() {
  // Get current instrument
  I_Instrument *instrument = getInstrument();
  if (!instrument) {
    return;
  }

  // Get the list of variables for this instrument
  etl::ilist<Variable *> *variables = instrument->Variables();
  if (!variables) {
    return;
  }

  // Reset all variables to their default values
  for (auto it = variables->begin(); it != variables->end(); ++it) {
    Variable *var = *it;
    if (var) {
      var->Reset();
    }
  }
}

void InstrumentView::handleInstrumentExport() {
  // Get current instrument using its id
  I_Instrument *instrument =
      viewData_->project_->GetInstrumentBank()->GetInstrument(
          viewData_->currentInstrumentID_);

  // Check if the instrument has a name set
  etl::string<MAX_INSTRUMENT_NAME_LENGTH> name = instrument->GetDisplayName();
  // Check if the name is empty, the default value, or matches the default
  // instrument type name
  etl::string<MAX_INSTRUMENT_NAME_LENGTH> defaultTypeName =
      instrument->GetDefaultName();

  if (name.empty() || name == defaultTypeName) {
    // Show error message if no name is set
    MessageBox *mb = MessageBox::Create(*this, "Please set a name",
                                        "before exporting", MBBF_OK);
    DoModal(mb);
  } else {
    // Export the instrument using the name field
    PersistencyResult result =
        PersistencyService::GetInstance()->ExportInstrument(instrument, name);

    if (result == PERSIST_EXISTS) {
      // File already exists, ask user if they want to override it
      etl::string<strlen("Overwrite existing file: ")> confirmMsg =
          "Overwrite existing file?";
      MessageBox *mb = MessageBox::Create(*this, confirmMsg.c_str(),
                                          name.c_str(), MBBF_YES | MBBF_NO);

      exportInstrument_ = instrument;
      exportName_ = name;
      DoModal(
          mb,
          ModalViewCallback::create<InstrumentView,
                                    &InstrumentView::onConfirmExportOverwrite>(
              *this));
    } else {
      // Create a message with the instrument name
      etl::string<MAX_INSTRUMENT_NAME_LENGTH + strlen("Exported: ")>
          successMsg = "Exported: ";
      successMsg += name;

      const char *message = result == PERSIST_SAVED
                                ? successMsg.c_str()
                                : "Failed to export instrument";
      // Show export result message
      MessageBox *mb = MessageBox::Create(*this, message, MBBF_OK);
      DoModal(mb);
    }
  }
}

void InstrumentView::onConfirmInstrumentTypeChange(View &, ModalView &dialog) {
  if (dialog.GetReturnCode() == MBL_YES) {
    applyProposedTypeChangeUI();
  }
}

void InstrumentView::onConfirmResetInstrument(View &, ModalView &dialog) {
  I_Instrument *instr = pendingPurgeInstrument_;
  pendingPurgeInstrument_ = nullptr;

  if (dialog.GetReturnCode() != MBL_YES || !instr) {
    return;
  }

  instr->Purge();
  isDirty_ = true;
}

void InstrumentView::onConfirmSampleChange(View &, ModalView &dialog) {
  SampleInstrument *sampleInstr = pendingSampleChangeInstrument_;
  int newIndex = pendingSampleChangeNewIndex_;
  pendingSampleChangeInstrument_ = nullptr;
  pendingSampleChangeNewIndex_ = -1;

  if (!sampleInstr) {
    return;
  }

  if (dialog.GetReturnCode() == MBL_YES) {
    sampleInstr->ClearSlices();
    lastSampleIndex_ = newIndex;
    updateSliceCountLabel(sliceCountLabel_, sampleInstr);
    isDirty_ = true;
    return;
  }

  suppressSampleChangeWarning_ = true;
  if (Variable *sampleVar =
          sampleInstr->FindVariable(FourCC::SampleInstrumentSample)) {
    sampleVar->SetInt(lastSampleIndex_);
  }
  isDirty_ = true;
}

void InstrumentView::onConfirmExportOverwrite(View &, ModalView &dialog) {
  I_Instrument *instrument = exportInstrument_;
  etl::string<MAX_INSTRUMENT_NAME_LENGTH> name = exportName_;
  exportInstrument_ = nullptr;
  exportName_.clear();

  if (dialog.GetReturnCode() != MBL_YES || !instrument) {
    return;
  }

  PersistencyService::GetInstance()->ExportInstrument(instrument, name, true);
  Trace::Log("INSTRUMENTVIEW", "Instrument '%s' exported with overwrite",
             name.c_str());
}
