xiphonics/picoTracker/sources/Application/Views/ProjectView.cpp

/*
 * SPDX-License-Identifier: BSD-3-Clause
 *
 * Copyright (c) 2018 Discodirt
 * Copyright (c) 2024 xiphonics, inc.
 *
 * This file is part of the picoTracker firmware
 */

#include "ProjectView.h"
#include "Application/AppWindow.h"
#include "Application/Instruments/SamplePool.h"
#include "Application/Model/Scale.h"
#include "Application/Persistency/PersistencyService.h"
#include "Application/Utils/randomnames.h"
#include "Application/Views/ImportView.h"
#include "Application/Views/ModalDialogs/MessageBox.h"
#include "Application/Views/ModalDialogs/RenderProgressModal.h"
#include "Application/Views/SampleEditorView.h"
#include "BaseClasses/UIActionField.h"
#include "BaseClasses/UIIntVarField.h"
#include "BaseClasses/UIStaticField.h"
#include "BaseClasses/UITempoField.h"
#include "BaseClasses/View.h"
#include "BaseClasses/ViewEvent.h"
#include "Services/Midi/MidiService.h"
#include "System/System/System.h"
#include <nanoprintf.h>

static void CreateNewProjectCallback(View &v, ModalView &dialog) {
  if (dialog.GetReturnCode() == MBL_YES) {
    // first clear out any existing "unnamed" project
    PersistencyService::GetInstance()->PurgeUnnamedProject();

    ViewEvent ve(VET_NEW_PROJECT);
    ((ProjectView &)v).SetChanged();
    ((ProjectView &)v).NotifyObservers(&ve);
  }
};

static void BootselCallback(View &v, ModalView &dialog) {
  if (dialog.GetReturnCode() == MBL_YES) {
    System *sys = System::GetInstance();
    sys->SystemBootloader();
  }
};

static void SaveAsOverwriteCallback(View &v, ModalView &dialog) {
  if (dialog.GetReturnCode() == MBL_CANCEL) {
    return;
  }

  PersistencyService *persist = PersistencyService::GetInstance();
  const char *projName = ((ProjectView &)v).getProjectName().c_str();
  const char *oldProjName = ((ProjectView &)v).getOldProjectName().c_str();

  if (persist->Save(projName, oldProjName, true) != PERSIST_SAVED) {
    Trace::Error("failed to save renamed project %s [old: %s]", projName,
                 oldProjName);
    MessageBox *mb = MessageBox::Create(
        ((ProjectView &)v), "Failed to save project", MBBF_OK | MBBF_CANCEL);
    ((ProjectView &)v)
        .DoModal(mb, ModalViewCallback::create<&SaveAsOverwriteCallback>());
    return;
  }
  // The samples were copied byte for byte, so flash and the pool still match
  // what the cache describes and only the name it is filed under is wrong.
  // Re-keying keeps a rename from costing a full sample reload on next boot.
  SamplePool::GetInstance()->RekeySampleCache(projName);

  if (persist->SaveProjectState(projName) != PERSIST_SAVED) {
    Trace::Error("Failed to save project state");
  } else {
    Trace::Log("PROJECTVIEW-STATIC", "OVERWROTE:%s", projName);
    ((ProjectView &)v).clearSaveAsFlag(); // clear flag after saving
  }
}

static void PurgeCallback(View &v, ModalView &dialog) {
  if (dialog.GetReturnCode() == MBL_YES) {
    ((ProjectView &)v).OnPurge();
  }
};

static void PurgeInstrumentsCallback(View &v, ModalView &dialog) {
  if (dialog.GetReturnCode() == MBL_YES) {
    ((ProjectView &)v).OnPurgeInstruments();
  }
};

static void RebuildSampleCacheCallback(View &v, ModalView &dialog) {
  if (dialog.GetReturnCode() == MBL_YES) {
    ((ProjectView &)v).OnRebuildSampleCache();
  }
};

// For informational dialogs that only need to be dismissed.
static void DismissCallback(View &, ModalView &){};

static void RenderStopCallback(View &v, ModalView &dialog) {
  // If the user clicked OK, stop the rendering
  if (dialog.GetReturnCode() == MBL_OK) {
    Player *player = Player::GetInstance();
    if (player->IsRunning()) {
      player->Stop();

      // Show cancellation message
      MessageBox *cancelDialog =
          MessageBox::Create(((ProjectView &)v), "Rendering Stopped", MBBF_OK);
      ((ProjectView &)v).DoModal(cancelDialog);
    }
  }
}

ProjectView::ProjectView(GUIWindow &w, ViewData *data) : FieldView(w, data) {

  lastClock_ = 0;
  lastTick_ = 0;

  project_ = data->project_;

  GUIPoint position = GetAnchor();

  Variable *v = project_->FindVariable(FourCC::VarTempo);
  tempoField_.emplace_back(FourCC::ActionTempoChanged, position, *v,
                           "Tempo: %d [%2.2X]", MIN_TEMPO, MAX_TEMPO, 1, 10);
  fieldList_.insert(fieldList_.end(), &(*tempoField_.rbegin()));
  (*tempoField_.rbegin()).AddObserver(*this);

  v = project_->FindVariable(FourCC::VarMasterVolume);
  position._y += 1;
  intVarField_.emplace_back(position, *v, "Master vol: %d%%", 0, 100, 1, 5);
  fieldList_.insert(fieldList_.end(), &(*intVarField_.rbegin()));

  v = project_->FindVariable(FourCC::VarTranspose);
  position._y += 1;
  intVarField_.emplace_back(position, *v, "Transpose: %3.2d", -48, 48, 0x1,
                            0xC);
  fieldList_.insert(fieldList_.end(), &(*intVarField_.rbegin()));

  v = project_->FindVariable(FourCC::VarScale);
  // if scale name is not found, set the default chromatic scale
  if (v->GetInt() < 0) {
    v->SetInt(0);
  }
  position._y += 1;
  intVarField_.emplace_back(position, *v, "Scale: %s", 0, numScales - 1, 1, 10);
  fieldList_.insert(fieldList_.end(), &(*intVarField_.rbegin()));

  // Add Scale Root field
  position._y += 1;
  v = project_->FindVariable(FourCC::VarScaleRoot);
  intVarField_.emplace_back(position, *v, "Scale root: %s", 0, 11, 1, 1);
  fieldList_.insert(fieldList_.end(), &(*intVarField_.rbegin()));

  position._y += 2;
  actionField_.emplace_back("Sample Pool", FourCC::ActionImport, position);
  fieldList_.insert(fieldList_.end(), &(*actionField_.rbegin()));
  (*actionField_.rbegin()).AddObserver(*this);

  position._y += 1;
  actionField_.emplace_back("Remove Unused Samples", FourCC::ActionPurge,
                            position);
  fieldList_.insert(fieldList_.end(), &(*actionField_.rbegin()));
  (*actionField_.rbegin()).AddObserver(*this);

  position._y += 1;
  actionField_.emplace_back("Rebuild Sample Cache",
                            FourCC::ActionRebuildSampleCache, position);
  fieldList_.insert(fieldList_.end(), &(*actionField_.rbegin()));
  (*actionField_.rbegin()).AddObserver(*this);

  position._y += 1;
  actionField_.emplace_back("Remove Unused Instruments",
                            FourCC::ActionPurgeInstrument, position);
  fieldList_.insert(fieldList_.end(), &(*actionField_.rbegin()));
  (*actionField_.rbegin()).AddObserver(*this);

  position._y += 2;

  // save existing fields horizontal alignment
  int xalign = position._x;

  v = project_->FindVariable(FourCC::VarProjectName);
  auto label =
      etl::make_string_with_capacity<MAX_UITEXTFIELD_LABEL_LENGTH>("Project: ");
  auto defaultName = etl::make_string_with_capacity<MAX_PROJECT_NAME_LENGTH>(
      UNNAMED_PROJECT_NAME);
  textField_.emplace_back(*v, position, label, FourCC::ActionProjectRename,
                          defaultName);
  nameField_ = &(*textField_.rbegin());

  nameField_->AddObserver(*this);
  fieldList_.insert(fieldList_.end(), nameField_);

  position._y += 1;
  actionField_.emplace_back("Save", FourCC::ActionSave, position);
  saveField_ = &actionField_.back();
  fieldList_.insert(fieldList_.end(), &(*actionField_.rbegin()));
  (*actionField_.rbegin()).AddObserver(*this);

  position._x += 5;
  actionField_.emplace_back("Browse", FourCC::ActionBrowse, position);
  fieldList_.insert(fieldList_.end(), &(*actionField_.rbegin()));
  (*actionField_.rbegin()).AddObserver(*this);

  position._x += 7;
  actionField_.emplace_back("New", FourCC::ActionNewProject, position);
  fieldList_.insert(fieldList_.end(), &(*actionField_.rbegin()));
  (*actionField_.rbegin()).AddObserver(*this);

  position._x += 4;
  actionField_.emplace_back("Random", FourCC::ActionRandomName, position);
  fieldList_.insert(fieldList_.end(), &(*actionField_.rbegin()));
  (*actionField_.rbegin()).AddObserver(*this);
  position._x = xalign;

  // Add rendering action fields
  position._y += 2;

  // Add a static field as a label for the render actions
  renderLabelPos_ = position;
  staticField_.emplace_back(position, "Render:");
  fieldList_.insert(fieldList_.end(), &(*staticField_.rbegin()));

  // Render actions occupy their own line so the selection range fits beside
  // the label above.
  position._y += 1;
  actionField_.emplace_back("Mixdown", FourCC::ActionRenderMixdown, position);
  fieldList_.insert(fieldList_.end(), &(*actionField_.rbegin()));
  mixdownField_ = &(*actionField_.rbegin());
  (*actionField_.rbegin()).AddObserver(*this);

  position._x += 8;
  actionField_.emplace_back("Stems", FourCC::ActionRenderStems, position);
  fieldList_.insert(fieldList_.end(), &(*actionField_.rbegin()));
  stemsField_ = &(*actionField_.rbegin());
  (*actionField_.rbegin()).AddObserver(*this);
  position._x = xalign;
}

ProjectView::~ProjectView() {}

void ProjectView::ProcessButtonMask(unsigned short mask, bool pressed) {

  if (!pressed)
    return;

  // Prefer saving when moving up from Mixdown.
  if (mask == EPBM_UP && GetFocus() == mixdownField_) {
    SetFocus(saveField_);
    isDirty_ = true;
    return;
  }

  FieldView::ProcessButtonMask(mask, pressed);

  if (mask & EPBM_EDIT) {
    if (mask & EPBM_PLAY) {
      // recording screen
      if (!Player::GetInstance()->IsRunning()) {
        switchToRecordView();
      }
    }
  } else if (mask & EPBM_NAV) {
    if (mask & EPBM_DOWN || mask & EPBM_UP) {
      if (!CanExit()) {
        return;
      }
    }

    if (mask & EPBM_DOWN) {
      ViewType vt = VT_SONG;
      ViewEvent ve(VET_SWITCH_VIEW, &vt);
      SetChanged();
      NotifyObservers(&ve);
    }
    if (mask & EPBM_UP) {
      ViewType vt = VT_DEVICE;
      ViewEvent ve(VET_SWITCH_VIEW, &vt);
      SetChanged();
      NotifyObservers(&ve);
    }
  } else if (mask & EPBM_PLAY) {
    Player *player = Player::GetInstance();
    player->OnStartButton(PM_SONG, viewData_->songX_, false, viewData_->songX_);
  }
};

void ProjectView::Reset() {
  lastClock_ = 0;
  lastTick_ = 0;
  saveAsFlag_ = false;
  oldProjName_ = getProjectName();
}

void ProjectView::DrawView() {

  Clear();

  GUITextProperties props;
  GUIPoint pos = GetTitlePosition();

  SetColor(CD_NORMAL);

  // Draw title
  const char *title = "Project ";
  DrawString(pos._x, pos._y, title, props);

  Variable *v = viewData_->project_->FindVariable(FourCC::VarProjectName);
  etl::string<MAX_PROJECT_NAME_LENGTH> projectName = v->GetString();
  DrawString(pos._x + strlen(title), pos._y, projectName.c_str(), props);

  GUIRect selection;
  const bool hasSelection =
      static_cast<AppWindow &>(w_).GetSongSelectionRect(selection);
  fieldList_.remove(mixdownField_);
  fieldList_.remove(stemsField_);
  if (hasSelection) {
    fieldList_.push_back(mixdownField_);
    fieldList_.push_back(stemsField_);
  } else if (GetFocus() == mixdownField_ || GetFocus() == stemsField_) {
    ClearFocus();
  }
  FieldView::Redraw();
  if (hasSelection) {
    DrawRenderSelectionSummary(selection);
  } else {
    SetColor(CD_NORMAL);
    GUIPoint noSelectionPos = renderLabelPos_;
    noSelectionPos._x += 8;
    DrawString(noSelectionPos._x, noSelectionPos._y, "[No Selection]", props);
  }
  drawMap();
};

void ProjectView::DrawRenderSelectionSummary(const GUIRect &selection) {
  char summary[32];
  const uint8_t rowCount =
      static_cast<uint8_t>(selection.Bottom() - selection.Top() + 1);
  const uint8_t channelCount =
      static_cast<uint8_t>(selection.Right() - selection.Left() + 1);
  npf_snprintf(summary, sizeof(summary), "Rows:%u Ch:%u",
               static_cast<unsigned>(rowCount),
               static_cast<unsigned>(channelCount));
  SetColor(CD_NORMAL);
  GUITextProperties props;
  GUIPoint summaryPos = renderLabelPos_;
  summaryPos._x += 8;
  DrawString(summaryPos._x, summaryPos._y, summary, props);
}

void ProjectView::Update(Observable &, I_ObservableData *data) {

  if (!hasFocus_) {
    return;
  }

  uintptr_t fourcc = (uintptr_t)data;

  UIField *focus = GetFocus();
  if (fourcc != FourCC::ActionTempoChanged) {
    focus->ClearFocus();
    focus->Draw(w_);
    w_.Flush();
    focus->SetFocus();
  } else {
    focus = &tempoField_[0];
  }
  Player *player = Player::GetInstance();

  switch (fourcc) {
  case FourCC::ActionPurge: {
    MessageBox *mb =
        MessageBox::Create(*this, "Remove unused samples?", MBBF_YES | MBBF_NO);
    DoModal(mb, ModalViewCallback::create<&PurgeCallback>());
    break;
  }
  case FourCC::ActionRebuildSampleCache: {
    MessageBox *mb =
        MessageBox::Create(*this, "Rebuild sample cache?",
                           "Reload samples from card", MBBF_YES | MBBF_NO);
    DoModal(mb, ModalViewCallback::create<&RebuildSampleCacheCallback>());
    break;
  }
  case FourCC::ActionPurgeInstrument: {
    MessageBox *mb = MessageBox::Create(*this, "Remove unused instruments?",
                                        MBBF_YES | MBBF_NO);
    DoModal(mb, ModalViewCallback::create<&PurgeInstrumentsCallback>());
    break;
  }
  case FourCC::ActionRandomName: {
    char name[10];
    System *sys = System::GetInstance();
    uint32_t randNum = sys->GetRandomNumber();
    getNamesByIndex(name, randNum, 10);
    printf("random:%s", name);
    project_->SetProjectName(name);
    saveAsFlag_ = true;
    break;
  }
  case FourCC::ActionSave: {
    PersistencyService *persist = PersistencyService::GetInstance();
    char projName[MAX_PROJECT_NAME_LENGTH + 1];
    project_->GetProjectName(projName);

    if (saveAsFlag_) {
      // first need to check if project with this name already exists
      if (persist->Exists(projName)) {
        Trace::Error("project already exists ask user to confirm overwrite");
        MessageBox *mb = MessageBox::Create(
            *this, "Overwrite EXISTING project?", MBBF_OK | MBBF_CANCEL);
        DoModal(mb, ModalViewCallback::create<&SaveAsOverwriteCallback>());
        return;
      }
      if (persist->Save(projName, oldProjName_.c_str(), saveAsFlag_) !=
          PERSIST_SAVED) {
        Trace::Error("failed to save project state");
        MessageBox *mb =
            MessageBox::Create(*this, "Error saving Project", MBBF_OK);
        DoModal(mb);
        return;
      }
      clearSaveAsFlag();
    } else {
      if (persist->Save(projName, oldProjName_.c_str(), saveAsFlag_) !=
          PERSIST_SAVED) {
        Trace::Error("failed to save project state");
        MessageBox *mb =
            MessageBox::Create(*this, "Error saving Project", MBBF_OK);
        DoModal(mb);
        return;
      }
    }
    // all good so now persist the new project name in project state
    persist->SaveProjectState(projName);
    break;
  }
  case FourCC::ActionProjectRename:
    Trace::Log("PROJECTVIEW", "Project renamed! prev name:%s",
               nameField_->GetString().c_str());
    saveAsFlag_ = true;
    break;
  case FourCC::ActionBrowse: {
    if (CanExit()) {
      ViewType vt = VT_SELECTPROJECT;
      ViewEvent ve(VET_SWITCH_VIEW, &vt);
      SetChanged();
      NotifyObservers(&ve);
    }
    break;
  }
  case FourCC::ActionNewProject: {
    MessageBox *mb =
        MessageBox::Create(*this, "Create a new project and",
                           "   lose all changes?", MBBF_YES | MBBF_NO);
    DoModal(mb, ModalViewCallback::create<&CreateNewProjectCallback>());
    break;
  }
  case FourCC::ActionBootSelect: {
    if (!player->IsRunning()) {
      MessageBox *mb = MessageBox::Create(*this, "Reboot and lose changes?",
                                          MBBF_YES | MBBF_NO);
      DoModal(mb, ModalViewCallback::create<&BootselCallback>());
    } else {
      MessageBox *mb = MessageBox::Create(*this, "Not while playing", MBBF_OK);
      DoModal(mb);
    }
    break;
  }

  case FourCC::ActionTempoChanged:
    break;
  case FourCC::ActionRenderMixdown:
    if (!player->IsRunning()) {
      GUIRect selection;
      if (!static_cast<AppWindow &>(w_).GetSongSelectionRect(selection)) {
        MessageBox *mb = MessageBox::Create(
            *this, "Select rows in Song view first", MBBF_OK);
        DoModal(mb);
        break;
      }
      bool hasPlayableContent = false;
      for (int channel = selection.Left(); channel <= selection.Right();
           ++channel) {
        const unsigned char chain =
            viewData_->song_
                ->data_[selection.Top() * SONG_CHANNEL_COUNT + channel];
        if (chain != 0xFF &&
            viewData_->song_->chain_.data_[chain * 16] != 0xFF) {
          hasPlayableContent = true;
          break;
        }
      }
      if (!hasPlayableContent) {
        MessageBox *mb = MessageBox::Create(
            *this, "Selection must start on a playable row", MBBF_OK);
        DoModal(mb);
        break;
      }
      // Show a dialog with a Stop button during rendering
      RenderProgressModal *renderDialog = RenderProgressModal::Create(
          *this, "Rendering", "",
          RenderProgressModal::ProgressDisplayMode::SongPercent);
      DoModal(renderDialog, ModalViewCallback::create<&RenderStopCallback>());

      // Start playback in rendering mode with MSM_FILE
      player->StartSelectionRender(PM_SONG, selection.Top(), selection.Bottom(),
                                   selection.Left(), selection.Right());
    }
    break;
  case FourCC::ActionRenderStems:
    if (!player->IsRunning()) {
      GUIRect selection;
      if (!static_cast<AppWindow &>(w_).GetSongSelectionRect(selection)) {
        MessageBox *mb = MessageBox::Create(
            *this, "Select rows in Song view first", MBBF_OK);
        DoModal(mb);
        break;
      }
      bool hasPlayableContent = false;
      for (int channel = selection.Left(); channel <= selection.Right();
           ++channel) {
        const unsigned char chain =
            viewData_->song_
                ->data_[selection.Top() * SONG_CHANNEL_COUNT + channel];
        if (chain != 0xFF &&
            viewData_->song_->chain_.data_[chain * 16] != 0xFF) {
          hasPlayableContent = true;
          break;
        }
      }
      if (!hasPlayableContent) {
        MessageBox *mb = MessageBox::Create(
            *this, "      Render failed",
            "Selection must start on a playable row", MBBF_OK);
        DoModal(mb);
        break;
      }
      // Show a dialog with a Stop button during rendering
      RenderProgressModal *renderDialog = RenderProgressModal::Create(
          *this, "Stems Rendering", "",
          RenderProgressModal::ProgressDisplayMode::SongPercent);
      DoModal(renderDialog, ModalViewCallback::create<&RenderStopCallback>());

      // Start playback in rendering mode with MSM_FILESPLIT
      player->StartSelectionRender(PM_SONG, selection.Top(), selection.Bottom(),
                                   selection.Left(), selection.Right(),
                                   MSM_FILESPLIT);
    }
    break;
  case FourCC::ActionShowRecordView:
    switchToRecordView();
    break;
  case FourCC::ActionImport:
    // Switch to the ImportView **BUT** to show the Project Pool by default
    if (!player->IsRunning()) {
      // First check if the samplelib exists
      bool samplelibExists = FileSystem::GetInstance()->exists(SAMPLES_LIB_DIR);

      if (!samplelibExists) {
        MessageBox *mb =
            MessageBox::Create(*this, "Can't access the samplelib", MBBF_OK);
        DoModal(mb);
      } else {
        ImportView::SetSourceViewType(VT_PROJECT);
        // Set to show project pool dir in ImportView
        viewData_->isShowingSampleEditorProjectPool = true;

        // Go to import sample
        ViewType vt = VT_IMPORT;
        ViewEvent ve(VET_SWITCH_VIEW, &vt);
        SetChanged();
        NotifyObservers(&ve);
      }
    } else {
      MessageBox *mb = MessageBox::Create(*this, "Not while playing", MBBF_OK);
      DoModal(mb);
    }
    break;
  default:
    NInvalid;
    break;
  };
  focus->Draw(w_);
  isDirty_ = true;
};

void ProjectView::OnPurge() { project_->PurgeSamples(); };

// Escape hatch for the sample cache: purging and importing only ever append to
// flash, so the write high-water mark can grow far past what the pool actually
// occupies until "doesn't fit" is reported for a nearly empty project. It also
// refreshes the cache after samples were changed outside picoTracker.
void ProjectView::OnRebuildSampleCache() {
  if (Player::GetInstance()->IsPlaying()) {
    MessageBox *mb = MessageBox::Create(*this, "Cannot rebuild",
                                        "Stop playback first", MBBF_OK);
    DoModal(mb, ModalViewCallback::create<&DismissCallback>());
    return;
  }

  char projName[MAX_PROJECT_NAME_LENGTH + 1];
  project_->GetProjectName(projName);
  SamplePool::GetInstance()->RebuildCacheFromSd(projName);

  // Flash offsets all moved, so ask for a reload rather than claim the running
  // state is untouched.
  MessageBox *mb = MessageBox::Create(*this, "Sample cache rebuilt",
                                      "Please reload project", MBBF_OK);
  DoModal(mb, ModalViewCallback::create<&DismissCallback>());
};

void ProjectView::OnPurgeInstruments() { project_->PurgeInstruments(); };

void ProjectView::OnQuit() {
  ViewEvent ve(VET_QUIT_APP);
  SetChanged();
  NotifyObservers(&ve);
};
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
