xiphonics/picoTracker/(commit log)

2014-05-18 Add special case for ms0 path for herr_prof
2020-09-23 Set the initial directory to the current directory
    Without this patch, the user has to navigate from the installation directory,
    which (for example in NixOS) could entail loading big directory
    listings, which make the program crash.
2023-02-28 Fix OSX build with SDL audio driver (compiles and works, not pretty)
    [ProjectView.cpp]
2023-03-02 Initial PICO commit, all working, perf still meh. Memory very limited
2023-03-05 add pico-sdk and pico-extras submodules
2023-03-06 Direct DMA transfer from audio driver. ~2x performance in opt mode
2023-03-06 Static miniblank and miniblank in output, tho it's not very usefull without threads
2023-03-07 Replaced tinyxml by yxml parser for loading. Removed compression support
    [HexBuffers.cpp, HexBuffers.h, InstrumentBank.cpp, InstrumentBank.h]
2023-03-10 Fixed load in flash func
    [WavFile.cpp, WavFile.h]
2023-03-10 Bunch of stuff in order to get closing and opening new project working. There is still a memory leak in doing so.
    [WavFile.cpp, WavFile.h]
2023-03-11 Static panlaw variable from SampleInstruments
2023-03-11 Disable soundfont (1.5K save), disable Sample feedback ~22K
2023-03-14 Fix OSX build after 1byte CMD conversion. constexpr function cannot have side-effects
    [char.h]
2023-03-14 Set final insts, song, chain, phrase and table values. Fix Song bound check, some bound checks still wrong
    [ViewData.cpp]
2023-03-20 Fix couple of memory leaks, there are more
2023-03-24 most warnings fixed, now to the tricky ones
    [AppWindow.cpp, FieldView.cpp]
2023-03-26 SMP version of driver. Works only in opt, crashes on screen changes
    [picoTrackerAudioDriver.cpp, picoTrackerAudioDriver.h]
2023-03-26 Closer to what I want, but not quite there yet. Sounds wrong, random crashes, etc
    [Trace.cpp, picoTrackerAudioDriver.cpp, picoTrackerAudioDriver.h]
2023-03-26 a better approach (i think) but still doesn't work fine...
    [picoTrackerAudioDriver.cpp, picoTrackerAudioDriver.h]
2023-03-27 Works! mutex deadlock when underruns with MIDI, not a big issue normally (we shouldn't have underruns)
    [Trace.cpp, picoTrackerAudioDriver.cpp, picoTrackerAudioDriver.h]
2023-03-27 a bit more cosmetic fix
    [AppWindow.cpp]
2023-03-28 Shorten Table cmd codes to 3 char without spaces in order for selection to display correctly
    [char.h]
2023-04-06 Cleanup, added dummy midi option for UART debugging
2023-04-07 release readiness stuff
    [picoTracker.fzz]
2023-04-14 Fix memory leak on import sample dialog
2023-04-14 Solved problem with PIO memory not being properly cleaned up
    [picoTrackerAudioDriver.cpp]
2023-04-14 Updated fritzing
    [picoTracker.fzz]
2023-04-14 Perform software reset upon exit. A hack that should be reverted once we find memory leaks and why playing is not working after reload.
    [ProjectView.cpp]
2023-04-16 Make flash region to save samples be automatically adjusted to start after binary size
2023-04-17 Fix a couple of issues related to the new layout
    [TableView.cpp]
2023-04-30 Decided on a slight different pinout in order to add later an analog output volume control
    [picoTracker.fzz]
2023-10-03 Fix compilation under linux (import typos, why does it work on OSX?)
    [picoTrackerAudioDriver.cpp]
2023-10-28 correctly show first 25 files, only for pico build
2023-11-07 Fix audio corruption issues on sample import. Add limitation to only import while not playing audio. Fix audio sample playing.
    [InstrumentView.cpp, WavFile.cpp, WavFile.h, picoTrackerAudioDriver.cpp]
2023-11-09 Cut new bugfix revision
2023-11-15 swap LT and B buttons to match M8 & GB layout
2023-12-05 Unfortunatelly I didn't clang-format the project before starting the fork, next best time is now. Applied some selective formatting per lines in order to not loose all git blame references
    [AppWindow.cpp, AppWindow.h, Application.cpp, Application.h]
2023-12-08 Addressing review comments and the case where the scale saved in the project does not match a valid one
2023-12-13 update pico sdk to 1.5.1 (latest stable release)
2023-12-16 Replace assertion error with log print Transposing using phrase transposition might cause the application to crash Replace the assertion with a log print
    from djdiskmachine/LittleGPTracker/pull/5
    [Player.cpp]
2023-12-21 fix button labels in pic for M8 style mapping
2023-12-21 Added pingpong to SampleInstrumentDatas.h
    Entry missing in loopTypes array
2023-12-22 replace onscreen with physical buttons in importdialog
    instead of onscreen buttons, the play button now starts/stops preview of
    samples, RT+Play button imports selected sample and RT+LEFT button
    exits out of the import dialog.
    Also updated Manual to match change in UI and added more details on
    restrictions on filesystem with new paged import dialog.
2023-12-22 fix manual text for samplelib location & misc other doc fixes
2023-12-22 which to LT+Play for sample import key combo
2023-12-23 fix preview & import button combo
2023-12-23 stop playing prev & start playing current selected sample
2023-12-29 workaround for some boards that need longer to init crystal
    see this issue for more details: https://github.com/raspberrypi/pico-sdk/pull/457
2024-01-01 Pingpong working as intended (?)
    Added reverse check inside switch
    Two additional checks:
    First check to not continue playing next sample
    Second check to not glitch loop at endpoint
2024-01-10 Autodetect flash size, fixes #18
    [WavFile.cpp, WavFile.h]
2024-01-14 Fix compiling the OSX version
    [InstrumentView.cpp, ProjectView.cpp, WavFile.cpp]
2024-01-14 format code and test workflow in PR (#80)
    * format code and test workflow in PR
    * fix .clang-format to include objective-c
    [AppWindow.cpp, Config.cpp, HexBuffers.cpp]
2024-01-21 Limit sample name length to 19 characters (#87)
    * Limit sample name length to 13 characters
    * Switched out to 19 characters so it takes advantage of the screen
2024-01-22 Add note audition mode (#86)
    * Add note audition mode
    * fix bug, stop audition on cut and nits
    [ChainView.cpp, GrooveView.cpp, PhraseView.cpp, PhraseView.h, Player.cpp, SongView.cpp, TableView.cpp, ViewData.h]
2024-01-23 Update building natively on OSX (#90)
    * Making the native OSX build just that little bit easier and dynamic for arm64 vs x86_64
    * Updated Trace with small definition change to allow compilation on OSX
2024-01-25 Set status to Importing dir when importing samples (#92)
    * Set status to Importing dir when importing samples
2024-01-25 update pico sdk (#95)
2024-01-27 Help legend (#89)
    * Attempt to reduce RAM usage
    Refactor Types.h and Variable.h
    * Adds help legend in phrase and table views
    All commands have a help legend
    Functionality in Utils header
    * Fixed clang-format warnings
    * Revert "Attempt to reduce RAM usage"
    This reverts accidentally added commit 4dfba81dcc3a5fdf949070f600deac2352686ddf.
    * Adjust according to review comments
    Location offset hard-coded to print from left to right top of screen
    Swap std::string for char**
    Three-letter abbreviated commands
    Removed invalid commands
    * Fixed bug in HelpLegend.h
    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
    [HelpLegend.h, PhraseView.cpp, PhraseView.h, TableView.cpp, TableView.h]
2024-01-27 updated pico-sdk
2024-01-29 Stripping the file extension on Sample Import (#94)
    * Stripping the file extension simply in the Sample Import
2024-01-29 32bit volume control (#98)
    * 32bit i2s output with 4bit of offset to lower vol
    * keep orig i2s for when we dont need hack anymore
    * add docs on offset value selection
    * remove unneeded orig i2s pio code
    * use defines, improve pio code comment docs
    * use 5 bits of offset for lower volume
    * fix freq code comment to match update to using 32bit on i2s
    [picoTrackerAudioDriver.cpp]
2024-01-29 Revert "Stripping the file extension on Sample Import (#94)"
    This reverts commit f1414b3629cf7991c6bcf2fb3cf893cc2152b767.
2024-02-03 Make help legend less busy (#107)
    *Overwrite old text with spaces
    *Nicer line breaks
    *Corrected / added missing commands
    [HelpLegend.h, PhraseView.cpp, TableView.cpp]
2024-02-05 Fix sample import screen file listing (#111)
    * fix paging with offset for subdirs & files
    previously the logic for file indexes with an offset was incorrect
    so now to make things simpler the subdir & file indexes are combined
2024-02-06 Adds back "Loading" sample status when loading a project (#112)
2024-02-24 Add stl library
2024-02-28 update pico sdk (#138)
2024-02-29 Add battery gauge display (#127)
    initial batt gauge updated only during playback
2024-02-29 Add 1Hz clock tick & use it for batt gauge updates (#130)
    clock tick initially used for batt gauge updates
2024-03-02 Use ETL throughout the code and reduce mallocs by using variable initializers (#137)
    * Some screen navigation allocations, seems ok
    * Replace VariableContainer
    * remove unused ListSelectView
    * No mallocs FieldView
    * Move some allocations to object initializers
    * Fix eventqueue
    * Fix event queue to incorporate new event type
    [ChainView.cpp, Config.cpp, FieldView.cpp, FieldView.h, InstrumentBank.cpp, InstrumentBank.h]
2024-03-04 Pico sdk version update (#140)
2024-03-05 bugfix: event queue may be used uninitialized if timer triggers before MainLoop
2024-03-09 More removal of mallocs after load (#145)
    * No need to set bus in every update, moved to start
    * Move list iterator to the list object in order to avoid the malloc that came with it
    * make render params updaters vectors ETL vectors
    * Pre-reserve observables for instruments so that allocations don't happen at runtime
    [Application.cpp, MidiInstrument.cpp]
2024-03-09 Delete updaters struct from SampleRenderingParams (#146)
    * Delete updaters struct from SampleRenderingParams
2024-03-10 Save 1728 bytes by adjusting screen arrays to correct size of 32 * 24 (#154)
    [AppWindow.cpp, AppWindow.h]
2024-03-27 VOL cmd sets step velocity for MIDI instruments (#163)
    * new VELM Fx cmd for MIDI velocity
    * photo with labeled TRS added to manual
2024-04-16 Fix clone instrument (#177)
    * Fix for clone instruments
    delete dst was causing the hang
    Refactored iterators
    [InstrumentBank.cpp]
2024-05-01 Revert "Show flash usage (#136)"
    Reverting this as it causes problems with file browser and audio preview #152
    This reverts commit 58f6ab9785f84d38959f86c2c6192cd244ba34d9.
    [stringutils.cpp, stringutils.h]
2024-06-01 No malloc. 8Kb savings, 142Kb static, 25Kb heap usage (#197)
    * Low hanging fruit, needs cleanup. 3Kb savings, 186Kb static, 22Kb heap usage
    * Some midi device. incomplete
2024-06-01 Added cRSID. Stripped C64 stuff. Doesn't work
    [I_Instrument.h, InstrumentBank.cpp, SIDInstrument.cpp, SIDInstrument.h]
2024-06-01 Added ADSR filter, still don't work. ~4ms cycle
2024-06-02 Shared SID chips per 3 instruments. Still issues with clicks on retrigger and display
    [CommandList.cpp, CommandList.h, InstrumentBank.cpp, InstrumentBank.h, InstrumentView.cpp, SIDInstrument.cpp, SIDInstrument.h]
2024-06-02 Init, render working, taking too much time for single 4OP (1/3ts)
    [I_Instrument.h, InstrumentBank.cpp, InstrumentBank.h, InstrumentView.cpp, InstrumentView.h, OpalInstrument.cpp, OpalInstrument.h]
2024-06-02 Braids builds, basic macro instrument, some (incorrect) sound out wihtout crashes
    [I_Instrument.h, InstrumentBank.cpp, InstrumentBank.h, InstrumentView.cpp, InstrumentView.h, MacroInstrument.cpp, MacroInstrument.h]
2024-06-02 Modified resources for 44100Hz
2024-06-04 update to pico sdk 1.5.1 & latest ETL
2024-06-04 fix clang format lint
    [I_Instrument.h]
2024-06-04 SD card switch to SDIO (#203)
    * Switch SD card access to SDIO and remove SPI driver. Add an option to run a benchmark for debugging. Performance is not what it should be.
2024-06-07 Save 512 bytes by making audio driver miniblank buffer a const
2024-06-11 initial outline of new pico file system class
2024-06-13 start using new FS api in new sample import dialog
    not yet in buildable state
2024-06-16 fix uninitialised before use compiler warnings
    [HexBuffers.cpp, InstrumentBank.cpp]
2024-06-17 basic listing of samplelib dir working
2024-06-20 filter out files without a ".wav" name extension
    also don't show "." either
2024-06-20 dont show ".." in toplevel samplelib dir
2024-06-20 case insensitive sample file extension filter
2024-06-20 fix dismissing sample import dialog
    this required for now to revert attempt to use static alloc for
    the project browser dialog
    [AppWindow.cpp, InstrumentView.cpp]
2024-06-21 convert sample import to new FS API but...
    while it builds, doesn't quite yet work for importing samples or
    loading in samples from existing projects
    [AppWindow.cpp, AppWindow.h, InstrumentView.cpp]
2024-06-22 sample import from browser dialog now working!
2024-06-22 loading existing project samples working
2024-06-22 fix loading samples into memory/flash
2024-06-24 remove using lgpt_ prefix, fix bugs in proj dialog
    [AppWindow.cpp]
2024-06-25 fix std button mapping instructions in the manual
2024-06-25 wireup import view to instr view with std keycombo
2024-06-25 basic import sample view working
2024-06-25 fix clang formatting for CI
    [ImportView.cpp, ImportView.h]
2024-06-25 ditch no longer used sample import dialog
    [InstrumentView.cpp]
2024-06-26 remove nav key combo to open sample browser view
2024-06-29 create proj dir when current proj is renamed
2024-07-01 show error mesg for save-as if name already exists
    [ProjectView.cpp]
2024-07-04 save current project name when loading new project
    prior to doing a reboot and then read it from the sdcard on boot
    [AppWindow.cpp, SelectProjectView.cpp]
2024-07-04 remove no longer used project dialog code
    [AppWindow.cpp, ProjectView.cpp]
2024-07-04 remove more no longer used code
    [ProjectView.cpp, ProjectView.h]
2024-07-04 create new project on boot if no /.current file
2024-07-05 workaround for race when calling loadprojec... directly from AppWindow constructor
    [AppWindow.cpp, AppWindow.h]
2024-07-06 fix clang formatting lint
    [AppWindow.cpp]
2024-07-10 fix UITextField to accept labels "name field"
    [ProjectView.cpp]
2024-08-05 fix sample preview & creating new project on boot
    [AppWindow.cpp, WavFile.cpp]
2024-08-07 dont worry about over writing existing new project
    other small fixes from code review
    [AppWindow.cpp]
2024-08-28 fix samplepool & importview for clang-format lint
    [ImportView.cpp]
2024-08-29 try fixing clang-format again
    [ImportView.cpp]
2024-08-29 one more try to fix clang-format lint
    [ImportView.cpp]
2024-08-29 add docs about using act to run CI flows locally
2024-08-30 fix clang-format lints again
    [AppWindow.cpp]
2024-09-06 Add serial console (#54)
    * move load/saving project state into PersistencyService
    * fix saving project name state after project save
    need to do this in case project has just been renamed and user now saves the project under this new name
    * basic serial console input for debugging
    * implement basic cat and ls commands
    * add file delete command
    * cleanup pico filesystem Read() API
    make api match the one provided by the underlying SDFat read function
    * greatly reduce buffer sizes used by debug cli
    [Application.cpp, ProjectView.cpp, SelectProjectView.cpp, WavFile.cpp]
2024-09-09 prompt user to confirm overwrite existing project (#60)
    after renaming the current porject
2024-09-09 Allow creating new empty project (#63)
    * prevent saving project when its default named
    new project will now have a name of ".untitled" (to hide from this project dir from file browsers)
    and user will be prevented from saving a project with that name, forcing the user to set a new
    name for the project before they are able to save it
    * UI to load new, empty project
    [Application.cpp, ProjectView.cpp, Types.h, char.h]
2024-09-09 show "INVALID NAME" for proj name thats too long (#58)
    * show "INVALID NAME" for proj name thats too long
    * max projname length is always less than list width
    * remove redundant logic
    * fix save bug from prev merge conflict resolution
    [ProjectView.cpp, SelectProjectView.cpp]
2024-09-13 Save device config to sdcard (#73)
    * save config file to sdcard at new path: `/.config.xml`
    * set default param values if no existing saved config
    * use "VALUE" ignore case from Xml attrib
    * remove LGPT desktop OS only code
2024-09-17 71 device config UI (#76)
    * basic working config file writing to sdcard
    * change config to store Ints not strings
    * display (only) colors values on device screen ui
    * placeholder fields for MIDI on device screen
    * rename to "DeviceView"
    * removed more legacy lgpt code not relevant to pT
    * remove ifdefs as now only support building for pT
2024-09-18 Color adjustment on Device screen (#77)
    * set default param values if no saved config
    * use "VALUE" directly, ignore case from Xml attrib
    * for users, this should be called "D", as in "Device" screen
    * add first color field to configview
    * remove irrelevant lgpt code
    * display swatch field for each color
    * color editing working with realtime update of UI
    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
2024-09-18 Fall/Spring cleaning (part 1)
2024-09-19 Four cc2 (#88)
    * POF: Make FourCC an enum with reflection where needed
    * Addressed comments and added codes to all FourCCs
    * Fixes from rebase
    * Defined all FourCC enums
    * Fix clang-format
    * More clang-format
    [AppWindow.cpp, ChainView.cpp, CommandList.cpp, CommandList.h, Config.cpp, DeviceView.cpp]
2024-09-20 Move MIDI settings to device config (#87)
    * complete moving MIDI device to device config
    * MidiService now watches for changes to the watched variable directly
    * fix init of MIDI send queue buffers
    * allow turning on/off MIDI TRS output
    * control sending out midi sync clock
    * persist config settings on value edits in UI
    * init Midi device & sync clk setting on boot
    ---------
    [Config.cpp, DeviceView.cpp, FieldView.h]
2024-09-20 handle the new "timeout" charcode in pico-sdk v2.0
2024-09-22 Replaced VariableContainer by an implementation using ETL types
    [Config.cpp, I_Instrument.h, InstrumentBank.cpp, MacroInstrument.cpp, MacroInstrument.h, MidiInstrument.cpp, MidiInstrument.h]
2024-09-27 Adjust audio output level in Device screen (#100)
    * adjust audio output level in Device screen
    note this needs a REBOOT to be applied.
    also made setting default to lowest volume & fixed bug in var naming
    [Config.cpp, DeviceView.cpp, picoTrackerAudioDriver.cpp]
2024-09-30 Dialog-for-audio-levels (#105)
    * show warning dialog after audio level change
    * fix map letter for device screen
    * need to make UIIntVarFields observable to be able to detect changes to
    the Audio Level field
    * fix message box to prevent grabbing prev button up
    eg. when showing dialog after a field edit, if we dont check for
    'pressed` in the MessageBox we will recieve the UP event for the A key
    from the field edit key combo event
    * make MIDI device & sync fields watched directly
    [DeviceView.cpp]
2024-10-01 Instrument types independent of instrument numbers (#102)
    Allow instrument types in any instrument slot
    * move instrument "slots" to a etl vector
    * add a "none" instrument thats assigned to all slots initially
    * fix opal release bug, default osc num for SID
    * rename current instrument to reflect its actually instr slot id
    * new instruments default to NONE type
    * ensure all xml strings handled as case insenstive
    * save current state when saving after proj rename
    * workaround for sample load failure in debug builds
    USB MIDI (#109)
    * add USB MIDI output device
    * fix initialising selected MIDI output device
    * support USB+TRS, fix reacting to changes in device config UI
    [AppWindow.cpp, DeviceView.cpp, FieldView.h, I_Instrument.h, ImportView.cpp, InstrumentBank.cpp, InstrumentBank.h, InstrumentView.cpp]
2024-10-02 Remove the variable names and replace with ETL enum reflection names. This saves 7872 bytes! (#114)
    [Config.cpp, InstrumentView.cpp, MacroInstrument.cpp, MidiInstrument.cpp, PhraseView.cpp, SIDInstrument.cpp, TableView.cpp]
2024-10-02 All Instrument variables into object initializators (#115)
    * All Instrument variables into object initializators
    * fix merge
    [MidiInstrument.cpp, MidiInstrument.h, SIDInstrument.cpp, SIDInstrument.h]
2024-10-08 platform rp2350 specifics (#120)
    * platform rp2350 specifics
    * add some more definitions
    * one more missed definition
    [gpio.h, picoTrackerAudioDriver.cpp, platform.cpp]
2024-10-22 implement custom USB CDC (serial over usb) (#124)
    * implement custom USB CDC (serial over usb)
    * use USB CDC directly for remoteUI not printf
    * put usb remote UI *input* behind separate flag
    * ensure default values for all config props, add config prop for remoteUI
    * put sending remote UI behind device screen config
    * enable remote UI for default builds on CI
    * improve code docs for hardware init
2024-10-22 Opal init patch and Opal Instrument bugfixes (#130)
    * "electric piano" init patch for opal instruments
    * fix algo display vals, only support 2OP FM
    * fix bug in setting operator output levels
    * fix to use currently playing note for note-Off opal cmd
    * add Gate-off cmd support to OpalInstrument
    [OpalInstrument.cpp, OpalInstrument.h]
2024-10-23 Use new fonts (#134)
    * new fonts, default Hourglass hardcoded for now
    * also removed prev unused code
    * make ui font a device screen setting
2024-10-24 use new sample dir path everywhere
2024-10-24 fix display of char_list variable fields
    [Config.cpp]
2024-12-03 fix SID instrument naming not displayed after
    the first redraw, ie. moving the cursor through instrument fields
    [InstrumentView.cpp, InstrumentView.h, SIDInstrument.cpp]
2024-12-03 show error dialog when preventing instrument type change during playback
    [InstrumentView.cpp]
2024-12-03 dont use printf functions family from std c lib!
2024-12-04 implement Trace debug output using nanoprintf
2024-12-04 use uart directly for debug logging output
2024-12-04 replace all sprintf use with nanoprintf's function
    [AppWindow.cpp, AppWindow.h, ChainView.cpp, DeviceView.cpp, GrooveView.cpp, ImportView.cpp, InstrumentView.cpp]
2024-12-04 add to dev docs about not using printf* functions
2024-12-04 replace all usages of printf
    [DeviceView.cpp, InstrumentBank.cpp, MacroInstrument.cpp, SIDInstrument.cpp, platform.cpp]
2024-12-05 use putchar instead of raw uart access
    this prevents crash as we dont check otherwise if stdio uart is enabled
    [Trace.cpp]
2024-12-05 custom USB descriptors using SPI Flash unique ID
2024-12-05 better error handling in filesystem functions
    [Config.cpp]
2024-12-06 allow manually triggering usermanual deploy flow
2024-12-07 correct button map image
2024-12-07 reduce size of button map image
2024-12-11 update device screen docs
2024-12-11 fix combo docs for the new pT button names
2024-12-16 update Pico SDK to 2.1.0
2024-12-20 draw battery gauge on all screens
    also need to draw gauge in drawview otherwise upto 1 sec lag before its
    drawn after changing to a new screen
2024-12-20 fix song screen title colour
    [SongView.cpp]
2024-12-20 move build number to bottom of device screen
2024-12-20 accomdate battery gauge on Phrase screen
2024-12-20 improve batt guage to show when charging
2024-12-27 Enhance remote UI protocol (#278)
    * document the remote ui protocol
    * fix bug in setting console colour
    * send actual 565 color values in remote UI
    * improve gamma correction for ST7789V
    * clean up cmd numbering, change start marker value
    * add setFont cmd for remote UI protocol
    * full refresh to remote UI when refresh cmd recv'd
    [AppWindow.cpp, AppWindow.h, DeviceView.cpp]
2024-12-29 fix conflict in CDC & MIDI endpoints (#282)
    also switch to use standard RPI rp2040 USB VID/PID
2025-01-02 Increase chain count (#290)
    * increase max chain count to 256
    * save 112bytes using bitfield for chain in-use flag
2025-01-02 Battery gauge obscures existing fields (#287)
    * fix formatting and lengths of FX cmd help legend
    * fix filesize display, move to bottom line also make file browser bigger height & width
    * apply change to help legend on Table screen too
    * add GOF, fix GRV docs & help legend
    [HelpLegend.h, ImportView.cpp, PhraseView.cpp, TableView.cpp]
2025-01-03 Try to optimise OPAL (#291)
    * inline loops for optimisation of opal
    removing function calls from tight loops saves 30-40 cycles per
    function call on RP2040
    * move opal const tables into ram for better cpu perf
    reduce opal sample rendering time by sacrificing 200bytes of ram for
    const sine, exp LUTs.
    [OpalInstrument.cpp]
2025-01-10 Fix note auditioning (#296)
    * audition notes only while Enter is pressed down
    * now make auditioning note update when its edited
    [PhraseView.cpp, PhraseView.h]
2025-01-11 reset scroll offset when entering new directory (#301)
    [ImportView.cpp]
2025-01-12 Initial SID fixes (#297)
    * save a few bytes of ram
    * improve SID rendering by ~0.1ms per buffer
    * get SID osc selection working in UI
    * use bighexfield for SID ADSR
    * fix displaying SID chip name (number)
    * improve SID UI
    [InstrumentBank.cpp, InstrumentBank.h, InstrumentView.cpp, InstrumentView.h, SIDInstrument.cpp, SIDInstrument.h, Types.h]
2025-01-18 Clear previous unnamed project when user does "New" (#311)
    * clear prev unnamed project when user does "New"
    * correct size of max samples in proj, also fix bug in list() method
    [ProjectView.cpp]
2025-01-18 Only attempt to purge sample instruments (#313)
    * only attempt to purge sample instruments
    * check all instrument slots as sampler can be in any slot now
    * fix confirmation dialog for compact instruments
    [ProjectView.cpp]
2025-01-18 add Todo to fix interrupts+flash issue properly!
    [WavFile.cpp]
2025-01-18 Hacky workaround for timing issue with interrupts (#326)
    * hacky workaround for timing issue with interrupts
    Need this *temporary* to work around issue after disabling interrupts when importing samples into flash
    [WavFile.cpp]
2025-01-25 fix filter
2025-02-04 Sample-instruments-lose-sample (#356)
    copy samples to new project when doing "save as"
2025-02-04 Choose next avail instr slot for each new instr (#357)
2025-02-05 Check for instrument type change before releasing current instrument (#359)
    * check for actual instrument type change before releasing current instrument
    * remove some unused macro instrument code
2025-02-05 fix creating sample dir in when project save-as (#361)
    fix creating sample dir in when project save-as
    also adds mkdir cmd to serial debug repl to test mkdir function
2025-02-06 memory corruption due to vector not being cleared before use fixes #354
    [InstrumentView.cpp]
2025-02-07 Use master volume setting for preview sample playback (#365)
    * apply master volume to sample preview playback
    * remove unused legacy "preattenuation" setting
2025-02-13 fix possible ui values for remoteUI setting (#376)
    [DeviceView.cpp]
2025-02-13 prevent importing sample while previewing sample (#378)
    [ImportView.cpp]
2025-02-16 Document instrument perf limits and nav keycombo (#383)
    * add pal+nav keycombo docs to user manual
    * document perf limitations, add SID settings docs
    * improve sampler, midi instrument documentation
2025-02-17 Fix creating missing untitled project on project load (#381)
    create untitled project when it doesn't exist and is being loaded either as the entry in .current or because user
    chose to create a new project
    [Application.cpp]
2025-02-25 use consistent values for min. max, default tempo (#394)
    * use consistent values for min. max, default tempo
    and constrain out of range values to be within max-min tempo range
    * update user manual to document clamping of tempo cmd values
2025-02-25 Fix phrase out of range (#398)
    * use correct limit for phrase count on chain screen
    * update user manual to current limit on chain count
    [ViewData.cpp]
2025-02-25 Preserve ID when non-consecutive instrument slots (#397)
    * preserve ID when non-consecutive instrument slots
2025-02-27 fix incrementing instrument index correctly (#401)
    [InstrumentBank.cpp]
2025-02-28 apply current scale to midi chord cmd offset values (#399)
2025-03-18 28-mixer-screen (#411)
    * minimal mixer screen
    * add master vu meter, fix layout, add mute/solo ui
    [AppWindow.cpp, AppWindow.h, MixerView.cpp, MixerView.h, Player.h]
2025-03-18 Mixer screen plumbing (#412)
    * basic vu meters for all channels on mixer screen
    * use dB scale for vu meter display
    * remove clipping special case code
    * show master vu meter on song screen
    * handle mute & soloing on mixer screen
2025-04-08 USB MIDI In (#437)
    * USB MIDI In, hardcoded as always on
    * fix midi handling to not disable interrupts
    * have MIDI devices use static alloc
    [MidiInstrument.cpp]
2025-04-08 ETL Logging (#444)
    This enables ETL logging to Trace for debug builds. Also, fixes a bug where
    etl_profile.h wasn't actually getting included by ETL (and thus, was having
    no actual effect on ETL's behavior).
    Basically, ETL does
    #include "etl_profile.h"
    So the `config` path needs to be on the list of top level include directories.
    I'm not great at CMake so I'm not sure if this is the right way to do that.
    Closes #443
    [Trace.cpp, Trace.h]
2025-04-10 fixes to build using GCC13 (#446)
    * fixes to build using GCC13
    * fix potential build error on GCC14
    * use GCC 13.2 for CI
    * add explanation of disabling compiler forloop bounds checks
    [DeviceView.cpp, FieldView.cpp, FieldView.h, InstrumentView.cpp, ProjectView.cpp]
2025-04-11 i2s: sign extend correctly; insert 1-bit padding to prevent DAC automute (#449)
    * Fix i2s_audio to sign extend correctly
    The i2s audio code as written was not correctly sign-extending
    twos-complement values, because it was padding with zeroes between the
    MSB and the rest of the value regardless of the MSB value. The correct
    way to sign extend is to pad with 1s for a negative number and 0s for
    a positive (i.e. replicate the sign bit)
    However, thankfully, the code was inadvertently sign-extending anyway
    because the data pins for `set` were not configured at all, so the set
    command was essentially acting as a NOP, preserving the MSB during the
    padding.
    This commit fixes the code to explicitl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
2025-04-13 Instrument export and import (#438)
    * UI for exporting an instruments settings
    * working instrument import
    * remove magic numbers
    * fix nametextfield handling, fix midi default names
    * improve instrument layout for opal, midi
    * update user manual for instrument export/import
    * confirm dialog for overwriting instrument exports
    * add name field for all instruments
    * show "NONE" instead of ugly "(null)"
    * tone down debug logging
    * remove hacky workaround for debug builds as no longer seems needed
    * make import available on NONE instruments screen
    * dont use .wav ext for sample instr displaynames
    * replace current instrument on import
    [AppWindow.cpp, AppWindow.h, FieldView.cpp, FieldView.h, I_Instrument.cpp, I_Instrument.h, InstrumentBank.cpp]
2025-04-15 use etl atomic queue to prevent race with ISR (#465)
    Because both the 1khz timer ISR & the mainloop modify the event queue
2025-04-15 Legacy code cleanup (#472)
    * sweep away last rements of the Dummy Adapter
    * remove no longer needed RP2350 defines
    * remove legacy button mappings
    * undo local debug cmake config change
    * remove extraneous new lines in debugging
    * User manual updates (#473):
    * improve table chapter
    * fix html cover page
    * improve table chapter layout, add more examples
    * add tips&tricks adapted from lgpt docs
    * add missing STP command docs
    * note availability of mixer of >v2.1 firmware
    * groove chapter more consistent with rest of manual
    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
    [Application.cpp, Config.cpp, I_Instrument.cpp, InstrumentView.cpp]
2025-04-16 Audition sample files at their given sample rate (#475)
    * audition sample files at their given sample rate
2025-04-21 switched to using GetFocus to find the Table Variable (#485)
2025-04-22 Preserve column when navigating up/down in grid-layout FieldViews (#492)
    Multi-column views such as OPAL had the frustrating characteristic that
    pressing up or down would reset the column to the leftmost column in
    the grid. This code makes the focus shifting logic column-aware when
    navigating up or down, snapping to the column with the most-similar X
    value in the next selected row.
    This produces perfect results when navigating columns where the X values
    match, and decent results when moving between grids with different
    numbers of columns on a single FieldView.
    [FieldView.cpp]
2025-04-28 more UI colours to match those in latest LGPT (#499)
    not enough room for all the new UI colour fields in Device screen so for
    now most not yet added to the UI
2025-04-28 New theme settings screen (#500)
    * move font,colour settings to separate Theme screen
    * update user manual for theme settings UI
    * use CD_ROW, CD_ROW2 colours
    * use MAJORBEAT colour setting
    * fix prev breakage of swatches updating when values edited
    * improve theme user manual chapter
    * use PLAY and MUTE colours
    [AppWindow.cpp, AppWindow.h, ChainView.cpp, DeviceView.cpp, GrooveView.cpp, PhraseView.cpp, SongView.cpp, TableView.cpp]
2025-04-28 import/export Theme data (#503)
    * import/export theme data
    * also remove previously accidentally added midiclocksync code
    * make string copying safer
    * fix bug in cat and in serial debug repl commands
    * finally implement backspace for serial debug REPL
    [AppWindow.cpp, AppWindow.h, Application.cpp, Config.cpp, DeviceView.cpp, DeviceView.h, FieldView.h]
2025-04-28 Remove restriction of browsing outside /samples (#501)
    * remove restriction of browsing outside /samples
    * prevent importing from current projects own samples dir
    [ImportView.cpp, ImportView.h]
2025-04-30 Audition single cycles (#476)
    * also added visual indicator to UI to show detected single cycle waves
    * reinstate delay during sample loading...
    * fix singlecycle preview to match sampler playback
    * play sample preview only while PLAY is held down
    * tweak applying master vol to sample preview volume
    * use info color for singlecycle indicator
    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
    [ImportView.cpp, ImportView.h, Player.cpp, Player.h, PlayerMixer.cpp]
2025-05-02 Usermanual: highlight multisample import workflow (#522)
    * highlight workflow to import multiple samples
    * add usermanual section on single cycle samples
    * only build&deploy usermanual from release branch
2025-05-06 don't prevent project save while sequencer running (#528)
    [ProjectView.cpp]
2025-05-06 Single ENTER to open import sample subscreen (#527)
2025-05-06 Separate preview volume (#520)
    * apply separate vol setting to sample preview
    and use non linear scale
    * change preview vol on importscreen with UI display
    * remove unneeded field from device screen
    * update manual with new preview vol functionality
    * show preview volume on statusbar not "popup"
    also tone down logging
    * remove unnecessary play restart code on preview volume change
2025-05-06 Fix table overscroll by using correct unsigned int (#529)
    [TableView.cpp, TableView.h]
2025-05-06 Reserve colors for future use (#516)
    * reserve colors for future use, reassign uses of reserved colors to other newly add colors
    * update user manual for changed color names & usage
    * comment out reservered colors so arent saved in xml
    * fix theme import/export button layout
    * Add comment about commented out colors
    [AppWindow.cpp, AppWindow.h, ChainView.cpp, Config.cpp, GrooveView.cpp, PhraseView.cpp, SongView.cpp, TableView.cpp]
2025-05-07 Fix check for modified instruments (#533)
    * fix checking for modified instrument settings
    * dont change instrument type field if user doesn't confirm
    * add basic modified check for string variables
    [InstrumentView.cpp, InstrumentView.h]
2025-05-07 Fix scales to apply root note for a scale (#510)
    * fix scales to apply root note for a scale
    * fix incorrect scale definitions
    * simplify scale handling code
    * fix Istrian scale, add comments to make easier to check scale definitions
    * code cleanup for int types
    * rename to public & reuse existing notenames const
    * Fixed "Major locrian" definition & typo in name
    * better check for invalid values that doesnt crash
    [MidiInstrument.cpp, PhraseView.cpp, ProjectView.cpp, Types.h]
2025-05-08 Optimise drawing vu meters (#512)
    * fix drawing vumeter updates only & forced redraw
    * fix updating levels when no output is rendered
    * add inertia to vumeters, clean out old code
    * higher refresh rate for animating vumeters fall-off this changes animation callbacks refresh rate from 1 to still low but fast enough 10hz
    * up animation refresh rate, draw VUs in anim update
    * fix anim tick to be even mod for 25hz, cleanup autosave timing code to match
    [AppWindow.cpp, MixerView.cpp, MixerView.h, PlayerMixer.cpp]
2025-05-08 some clock rates cause crash on boot (#541)
    Unclear why but some tick rates like 25, 33 hz cause crash on boot while other slower or even faster rates like 50hz work fine
2025-05-08 Per channel volumes (#524)
    * fix incorrect mem alloc for mixerview
    * separate channel volume settings, default to 60%
    * UI fields on mixerscreen to edit channel volumes
    * make Mixerview match other fieldview subclasses
    * sync selected channel b/w song & mixer screens
    [AppWindow.cpp, MixerView.cpp, MixerView.h, PlayerMixer.cpp, PlayerMixer.h]
2025-05-11 SamplePool adapter
2025-05-11 Remove all dependencies of pico-sdk outside of Adapters and cleanup cmake files
2025-05-12 Autosave uses previous project name after a rename (#553)
    * add string watchedvariables, then use for projectname also removes the prev hacky global that exposed projectname for use in mixerservice
    * prevent crash when autosaving newly named but not yet saved project
    * make user save rename before leaving projectscreen
    [AppWindow.cpp, ProjectView.cpp]
2025-05-12 fix nits, mostly types
    [WavFile.cpp]
2025-05-13 Mutex adapter plus other platform specific things (#551)
    * Remove all dependencies of pico-sdk outside of Adapters and cleanup cmake files
    * Mutex adapter, plus fix mutex and finish with other platform specific things
    * Removed other bits and pieces
    * modify filesystem lib to be of interface type
    [AppWindow.cpp, AppWindow.h, DeviceView.cpp, ImportView.cpp, InstrumentBank.cpp, InstrumentBank.h, InstrumentImportView.cpp]
2025-05-13 Fix sample file browser opening (#538)
    * remove dynamic ram alloc from project view
    * access import samples browser from project screen
    * reinstate ENTER+ENTER as hotkey for sample import
    * track the view to go back to from ImportView
    * update user manual for new ways to open import file browser
    * update manual for return to prev behaviour
    [ImportView.cpp, ImportView.h, InstrumentView.cpp, ProjectView.cpp, ProjectView.h]
2025-05-13 Wrong colors rendering (#542)
    * fix incorrect inversion when clearing vu also fix typo in calculating screen width
    * correctly mask colorIndex to prevent overwrite invert flag accidentally
    * fix mixer to only draw from core0 never from core1 This means never drawing from OnPlayerUpdate() which is actually called by core1!
    * make drawing in SongView "thread safe" too also more code and comments cleanup
    * fix chain,phrae,table views to use "mainthread" for drawing the UI iso core0 draws in AnimationUpdate() and not core1 in OnPlayerUpdate()
    * add master vumeter to chain,phrase & table screens
    * consolidate update flags in views also needed to add a strange workaround for DEOPTIMISED builds onl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
    [AppWindow.cpp, AppWindow.h, ChainView.cpp, ChainView.h, MixerView.cpp, MixerView.h, PhraseView.cpp, PhraseView.h]
2025-05-16 Prevent importing samples with too long a filename (#559)
    [ImportView.cpp]
2025-05-20 fix scaleroot name param in project data (#560)
    [Types.h]
2025-05-20 Fix instrument change check (#555)
    * cleanup function naming
    * replace static callback func with a lambda
    * fix drawing instrument fields first time instrument screen gets focus
    * remove double up of adding observer to instrument type field
    this was causing 2 calls to the event handling and thus causing
    instrument type changes to fail
    * Fix instrument import, export regressions (#558)
    * fix import/export action field event handling
    * fix switching back to instrument after import
    * rm extra top level instr element added incorrectly
    this was added in a prev change to add firmware version
    instead we fix here to just add that prop to the instrument element
    that already gets created by I_Instrum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
    [I_Instrument.cpp, InstrumentImportView.cpp, InstrumentView.cpp, InstrumentView.h]
2025-05-20 Slices v2 (#504)
    * Slices for samples
    * update loop start/end fields based on slice count
    * Correct assignment of slice start/end when changing slices
    * fix crash bug when reading specific wav, also improve code to make clearer how the samples are being read and handling of 8 vs 16bit wav files. File that caused issue: 16bit file, 44.1khz, 385kB "Drumfill-110bpm.wav"
    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
    [InstrumentView.cpp, InstrumentView.h, Types.h, WavFile.cpp, WavFile.h]
2025-05-22 Add tick counter to AnimationUpdate, use for batt (#573)
    * Add tick counter to AnimationUpdate, use for battery gauge
    * use frame counter to set batt gauge update rate
    * remove unnecssary direct calls to drawBattery with fix to Flush in ScreenView::AnimationUpdate()
    [ChainView.cpp, ChainView.h, ConsoleView.h, DeviceView.cpp, DeviceView.h, GrooveView.cpp, ImportView.cpp, InstrumentImportView.cpp]
2025-05-22 Fix sample start and end points (#569)
    * start/end apply for full sample even with slices
    [InstrumentView.cpp]
2025-05-22 Instrument screen fields not updating (#571)
    * update current instrument when navigating from phraseview
2025-05-22 fix layout position of song timer on mixerscreen (#572)
    [MixerView.cpp]
2025-05-23 Fix handling multiple MIDI IN notes (#581)
    * track input midi note on's to match note off mesgs
    * fix sampler to correctly stop notes per channel
    * add MIDI input docs to user manual
    * document limits on synth instruments
    * improve how OPAL behaves as monophonic instrument
    [ConsoleView.h, OpalInstrument.cpp, PlayerChannel.cpp]
2025-05-27 fix vu meter to not overlap grid on phrase screen (#587)
    [PhraseView.cpp]
2025-05-27 Theme export broken (#591)
    * fix theme exports, use "inline" textfield for name
    * save theme name to config file
    * fix XML config parsing, remove most special case code
    [Config.cpp, ThemeView.cpp, ThemeView.h, Types.h]
2025-05-27 Fix drawing play position marker in Tableview (#595)
    * Fix drawing play position marker in Tableview
    [TableView.cpp]
2025-05-27 Detect AKWF "nes" pack singlecycle samples (#597)
    * detect AKWF "nes" pack singlecycle samples also remove duplicte unused code
2025-05-27 Improve lcd driver (#601)
    * initial lcd controller code cleanup
    * more display driver code cleanup & renaming
2025-05-29 Fix accidental double up in config params list (#610)
    [Config.cpp]
2025-05-30 fix Config::Save bug (#618)
    [Config.cpp]
2025-06-04 fix DLY value when used as 2nd command (#626)
    [Player.cpp]
2025-06-05 Display brightness (#617)
    * wireup changing LCD backlight level from Device screen
    * use XML elem name less than 16chars
    * prevent users turning backlight completely off
    * document new display brightness setting
    * make default to max display brightness
    * set higher minimum brightness level
    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
    [Config.cpp, DeviceView.cpp, DeviceView.h, Types.h, platform.cpp, platform.h]
2025-06-05 Keep selected mixer channel & song channel in sync (#631)
    * keep selected mixer channel & song channel in sync
    * dont wrap around on mixer screen
    * default to 1st channel coming from mixer when...
    on mixer screen user has master volume selected
    * fix incorrect handling of up/down on mixer screen
    [MixerView.cpp, MixerView.h, SongView.cpp]
2025-06-05 Fix battery gauge to only fetch voltage at 1Hz (#623)
    * fix battery gauge to only fetch voltage at 1hz
    caches prevous voltage value to still redraw at 50Hz
    * fix format lint
    * remove unnecessary flush when redrawing batt gauge
    * remove unused old code
    * call redraw & flush instead of invalidate
    This stops the batt gauge constantly being redrawn on key input events
    because prev the screen cleared via the Invalidate() and then the batt
    gauge would get drawn via AnimationUpdate
    * dont do direct screen drawing from input handlers
    We only want AnimationUpdate() to ever directly draw to the screen
    * fix format lints
    * remove redundant needsRedraw flag just use isDirty
    * fix format lint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
    [AppWindow.cpp, AppWindow.h, ScreenView.cpp]
2025-06-05 Show error dialog when projects max samples reached (#634)
    * show max samples reached on import err dialog
    * increase max sample files per project limit to 64
    [ImportView.cpp]
2025-06-05 Revert slices (#643)
    * Revert "Fix sample start and end points (#569)"
    This reverts commit 0466bbe9413f93da5c446a940a0e72ec7f9a0595.
    * Revert "Slices v2 (#504)"
    This reverts commit 3e4d5cdf1122e03fe1c1c4201285ad6ed461e572.
    * remove no longer used function
    * dont revert wavfile bug fixes from prev slices PRs
    [InstrumentView.cpp, InstrumentView.h, Types.h, WavFile.cpp, WavFile.h]
2025-06-05 Add profiling infrastructure, use for Opal Render (#615)
    * add profiling infrastructure, use for Opal Render
    * default to profiler disabled
    * comment out cmake debug flag, fix endif placement
    [OpalInstrument.cpp]
2025-06-06 Fix updating sampler instrument name and the name displayed (#644)
    * show user set name for sampler if set otherwise...
    show the sample filename minus the filename extension
    * show cursor for empty textfields
    * fix initial instrument name for sampler
    * show "NONE" for samplers name with no sample set
    [InstrumentNameVariable.cpp, InstrumentView.cpp]
2025-06-06 Fix play button to work on theme screen (#646)
    [ThemeView.cpp]
2025-06-07 ensure vu meter always redrawn, fix its pos on phrase screen (#647)
    [ChainView.cpp, PhraseView.cpp, SongView.cpp]
2025-06-07 Fix forceClear to work with chargfx optimisation (#645)
    * revert prev putc optimisation
    * fix ifdef lost in previous PRs merge with master
    * now that putc optimisation removed, add...
    some hysteresis tothe battery voltage readings
    * themeview not screenview subclass so needs to...
    explicitly call drawBattery()
    [ThemeView.cpp, ThemeView.h]
2025-06-09 Show error dialog when max sample storage (#638)
    * err dialog if over max storage, show storage free
    * fix to use fixed sample storage limit
    * support pico w/ 2MB while enforcing 8MB limit
    * place verbose flash debug logging behind a define
    * move flash storage available display to bottom status line and show
    both file size and space avail in bytes
    * show background color for entire status line
    * always display status line
    * change statusbar bg color when files to large to fit in remaining storage and when a dir is selected.
    * update user manual
    [ImportView.cpp]
2025-06-10 Fix mixdown and stem rendering (#660)
    * tone down xml debug logging
    * fix crash when starting render mixdown
    * fix rendering completion state
    [AppWindow.cpp, InstrumentBank.cpp, Player.cpp]
2025-06-11 remove division from base value for velocity (#665)
2025-06-15 Detailed battery state (#668)
    * use detailed battery state
    * add disabled alternative batt % display
2025-06-15 Check for filenames that are too long on project load (#663)
    * prevent project loading too long sample filenames
    * prevent importing too long instrument name
    [InstrumentImportView.cpp]
2025-06-20 add powerdown in system for future use (#675)
2025-06-26 Show power off ui for devices with a power button (#682)
    * show power off ui for devices with a power button
    * cleanup pwr button handling in View
    * fix incorrect batt text buffer mem handling
    [AppWindow.cpp, ScreenView.cpp, ThemeView.cpp]
2025-06-28 Fix bug with string being null when calling fs list (#687)
    [SelectProjectView.cpp]
2025-07-10 Remove flood of warnings for Advance and match compile definitions of pico (#694)
    * Parity with picoTracker to compile on c++20
    * Fix all warnings for advance platform. Add -Wall and match compile definitions of pico
    [AppWindow.cpp, advUSBMidiOutDevice.cpp, main.c, sd_diskio.c]
2025-07-11 further fixes to licenses (#702)
    * fix license attributions
    * remove custom (and wrong for CMSIS) header for STM Drivers, attribution at main LICENSE file
    [BatteryGauge.cpp, advAudio.cpp, advAudioDriver.cpp, advMidiOutDevice.cpp, advMidiService.cpp, advSystem.cpp, advUSBMidiOutDevice.cpp]
2025-07-15 Tinyusb integration (#695)
    * init
    * baseline config for USB
    * tinyUSB fully integrated, interrupts working
    * trim tinyusb codebase for our use case
    * fix tinyusb compile after merge master. Had to remove Wpedantic
    * Added USB Task, picoTracker showing in lsusb
    * Fix USB descriptor for advance
    * update USB VID/PID
    [adv.ioc, advUSBMidiOutDevice.cpp, main.c, serial.c, serial.h, tusb_config.h]
2025-07-17 Fix serial MIDI on advance (#723)
    * midi data not trying to case values as pointers
    * remove old commented out code
    [advMidiOutDevice.cpp]
2025-07-17 Make samplePool 32MB size until we merge both sample pools (#732)
2025-07-18 fix parent dir handling in advance filesystem (#731)
    * fix parent dir handling in advance filesystem
    * ensure 4byte alignment on first write per file
    [ImportView.cpp]
2025-07-18 increase size of input event task to prevent... (#737)
    a hardfault when importing sample files via the import browser
2025-07-18 change refresh rate to ~30Hz (#727)
2025-07-29 Better pico sdk build (#743)
    * build pico sdk as single static lib "bundle"
    * move platform dependent code to System class
    This properly decouples xplatform code from platform specific code
    * dont use Trace logger in platform, reenable uart
    * only set linker flags locally not global for advance
    * remove last of old, global cmake linker config
    * dont use Trace before its been initialised
    * document why we need to have syscalls.c
2025-08-01 Bitmap graphics and Sample Editor screen (#745)
    * create xplatform bitmap graphics api
    * make chargfx defines available
    * Add UIBitmapField
    * add SampleEditor screen
    bitmap field for waveform temp disabled due to crashing on advance
    * scale bitmap 2x on Advance
    * add profiling for sampleeditorview
    to try to diagnose poor drawing perf on advance
    * use start sample as initial playback position
    [AppWindow.cpp, AppWindow.h, InstrumentView.cpp, InstrumentView.h, Player.cpp, Player.h]
2025-08-07 Mvp recording UI (#746)
    * Adjust DMA config for recording
    * Basic recording infra in place
    * Add recording streamer audio module
    * connect record screen into temp nav with play+nav
    * goto sample editor on recording stop
    * allow setting max record duration
    * SampleEditor only works directly with sample files
    this removes problematic connection between sample editor & instruments
    * fix path, cleanup & simplify sample editor drawing
    for now playhead & waveform drawing not yet reimplemented
    * refactor marker drawing, draw playhead
    * add wave drawing, fix y-coord buf overflow
    also remove name field for now as destructor via etl vector clear()
    causing a hardfault
    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
    [AppWindow.cpp, AppWindow.h, Config.cpp, InstrumentView.cpp, RecordView.cpp, RecordView.h, SongView.cpp, Trace.cpp]
2025-08-26 Add UART7 global interrupt code generation. Adjust some priorities (#759)
    * Add UART7 global interrupt code generation. Adjust some priorities
    * fix problem with priorities
    [adv.ioc]
2025-08-26 Fix batt config hanging on boot (#755)
    * use busywait delays in batt config
    [BatteryGauge.cpp]
2025-08-29 show error mesg on advance when sdcard missing (#769)
    [main.c]
2025-08-29 prevent using samples before sample start point (#761)
2025-08-29 Implement advance TRS MIDI In (#756)
    * advance trs midi in device
    * combine midi trs, remote ui, debug serial input all into single freertos task
    * use etl atomicqueue for much cleaner ISR handling
    * use etl atomicqueue for pT midi in device too
    * add assert to detect dropping incoming MIDI mesgs
2025-09-05 Send MIDI pitch bend on PSL and LEG commands (#741)
    * add midi pitch bend to leg and psl commands
    * add details on midi pitch bend functionality to usermanual
    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
2025-09-09 add missed fn call to properly close render files (#781)
    OnPlayerStop needs to be called to have rendered wav files be closed
    [Player.cpp]
2025-09-16 RemoteUI DrawRect support (#783)
    * implement DrawRect for picotracker UI adapter
    * Use DrawRect for SampleEditorView
    no need for UIBitmapField anymore, just draw rects direct to screen
    * also add new DRAWRECT remote UI command
    * fix drawrect & sample editor for advance
    also removes the no longer used bitmapgraphics for adv builds.
    * adapt waveform layout for Advance vs pico
    * use 16bit values for drawrect coordinates
    * use SetColor for DrawRect commands
    We need to track the last color set via SetColor to know which color to
    use for drawing rects.
    Also fix using escaping coords when sending color values
    and drawrect cmds via remote ui.
    Finally now removes no longer used bitmap buffer freeing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
    [AppWindow.cpp, AppWindow.h, PhraseView.cpp]
2025-09-17 picoTracker Advance RC4 (#791)
    * CubeMX changes RC4
    * Correct TinyUSB port (still some problems) and clock device from crystal
    * fix USB
    [adv.ioc, main.c, main.h]
2025-09-17 fix sdcard RC4 (#799)
    [adv.ioc, main.c]
2025-09-18 Advance 48MB sample pool (#793)
    * Delete sample from memory pool (untested due to no implementation)
    * Dual sample pool
2025-09-19 import, edit onscreen buttons for file browser (#796)
2025-09-19 Access Sample Editor from file browser (#798)
    * import, edit onscreen buttons for file browser
    * load files into sampleeditor from file browser
    * remove sample edit field from sampler screen
2025-09-19 Browse pool samples (#802)
    * prevent *browsing* into current project dir
    * show project pool in browser
    when accessed from the project view page use "import file browser" view
    to show list of file in project samples dir (aka pool)
    * toggle between sample import & project pool modes
    for now via the NAV+EDIT key combo
    * individual samples can be removed from pool
    For now this is only for the Advance
    * edit & remove pool samples on adv, only edit on pico
    [ImportView.cpp, ImportView.h, ProjectView.cpp, ViewData.h]
2025-09-21 fix file filter on Advance (#805)
2025-09-23 Truncate too long filenames (#811)
    * fix set browser default mode from instrumentview
    * make import sample use cont char pointers
    * truncate too long filenames on sample import
    * handle error if not able to load sample into flash
    [AppWindow.cpp, AppWindow.h, ImportView.cpp, InstrumentView.cpp]
2025-09-24 Advance HP/Speaker switch (#813)
    * Detach mutting from init
    * Basic speaker/headphone switch (artifacts)
    * speaker/headphone working
    * Made the audio output check a task, adjusted de-pop delays based on real data
2025-09-24 Semaphore for Advance audio driver created in wrong order (#823)
    [advAudioDriver.cpp]
2025-09-24 Fix IRT in automation tables (#819)
    * process IRT in automation tables
    * fix to correctly copy third table cmd column
    also cleaned up code to use single define constant everywhere
    [Player.cpp, TablePlayback.cpp, TablePlayback.h]
2025-09-25 Fix preview artifacts (#822)
    * Move file opening to the start method, it shouldn't happen in render
    * fix preview playback speed for singlecycle wavs
    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
    [PlayerMixer.cpp]
2025-09-26 Correctly parse RIFF header with JUNK chunks (#826)
    * correctly parse RIFF header with JUNK chunks
    * remove swap funcs as we dont support bigendian
    [WavFile.cpp]
2025-09-30 Select recording source (#830)
    * UI to set recording source
    also fix to only set "monitor only" off once recording file opened ok
    * fix multiple issues with not closing sample file
    Open file was not being closed on playback end.
    Playback end was also not always being detected correctly.
    * use"FILESYSTEM" as logging tag
    * statically allocate semaphore for recording
    * explicit "all off" option for record source
    * prevent speaker output when monitoring mic
    otherwise we will quickly get nasty feedback
    [Config.cpp, RecordView.cpp, RecordView.h, record.cpp, record.h, tlv320aic3204.c]
2025-09-30 Force new project on boot (#831)
    * rename button gpios to new names
    * remove more LGPT key naming anachronisms
    * use EDIT button to force load untitled project
    dont use ENTER to prevent accidental triggering when loading projects
    * update manual for new on boot functionality
    [Application.cpp, Application.h, gpio.h, main.c, platform.cpp]
2025-10-01 make speaker override be contained in the driver (#833)
    * make speaker override be contained in the driver
    * turn off all inputs when stop monitoring, recording
    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
2025-10-01 STP cmd should only work in tables (#832)
    * STP cmd should only work in tables
    in tables it should stop the current table from running any further
    * Revert dont take mixer lock when stop workaround
    This reverts commit 8796150f41e433ba87a44ffe4e04c8ab5104f513.
    [Player.cpp, Player.h, TablePlayback.cpp]
2025-10-06 apply brightness onboot in xplatform way (#836)
    fixes advance not applying brightness from config on boot
    [Application.cpp]
2025-10-10 Show low batt UI and then turn off (#837)
    * detect low batt state and show error UI
    * power off after extra delay when low batt detected
    * driveby fix for old incorrect hardcoded timing value
    * power off after delay when showing critical errors
    use this for showing low batt mesg on boot
    * the Guru is only for special occassions
    * show low batt only when not charging
    Also low batt warning now uses new fullscreen dialog to prevent any
    user input while its onscreen.
    Because we now need to be able to dismiss a dialog without user button
    input (ie. when usb cable connected) this required add new
    DimissModal() to View.
    * rename to charger for beginnings of device driver
    * increase poweroff timeout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
    [AppWindow.cpp, AppWindow.h, advSystem.cpp, advSystem.h, charger.cpp, main.c]
2025-10-11 prevent TBL command being selected in tables (#840)
    [TableView.cpp]
2025-10-15 fallback to untitled if .current project doent exist (#844)
2025-10-15 Fix crashes when instrument type is exhausted (#846)
    * dont crash on instrument exhaustion, show user error dialog when it happens
    [InstrumentBank.cpp, InstrumentView.cpp]
2025-10-17 Use a different color for field label text (#851)
    * use CD_INFO for field labels
    * use info color for field values not labels
    * use EMPHASIS for action fields (aka buttons)
    * fix textfield to set color of its label text
2025-10-17 Prevent importing unsupported wave file formats (#855)
    * use Wav::Open to check for supported format
    * Check for supported sampling freqs in wavfile open
    * fix dialog box sizing to take account of 2nd line
    [ImportView.cpp, WavFile.cpp]
2025-10-17 Recording enhancements part 1 (#853)
    * add /recordings to required dir structure
    * recording file goes into /recordings
    * display sample name in Sample Editor
    * allow renaming & saving in sample editor
    * use consistent naming for UI field vectors
2025-10-17 check for charging status at boot up (#843)
    * check for charging status at boot up
    to do this, needed to finally implement basic charger IC driver
    * doc reg bits meaning for batt i2c, use const names
2025-10-20 More functionality for sample editor (#859)
    * rec file into /recordings, also...
    show import of /recordings after saving rec from sample editor
    fix multiple bugs with saving recorded files dir
    * return record screen from sample editor
    [ImportView.cpp, InstrumentView.cpp, ProjectView.cpp, RecordView.cpp, ViewData.h]
2025-10-21 Add EDIT+PLAY keycombo to all screens plus fix play immediate mode (#870)
    * Add EDIT+PLAY keycombo to all screens plus fix play immediate mode
    * Add manual entry for recording screen
    [ChainView.cpp, DeviceView.cpp, GrooveView.cpp, InstrumentView.cpp, MixerView.cpp, PhraseView.cpp, ProjectView.cpp, SongView.cpp]
2025-10-21 Show correct when recording in progress (#873)
    * show correct whenrecording in progress
    * rename file for agentic apps to better reflect its use (#874)
    [RecordView.cpp]
2025-10-21 Adjust to latest compliant hardware specs (#882)
    * 60MHz ram
    * RGB565 framebuffer
2025-10-23 Refresh file list after removing a file from pool (#889)
    * refresh file list after removing a file from pool
    * fix outdated code comment
    [ImportView.cpp, ImportView.h]
2025-10-23 Save and load button for sample editor (#875)
    * show correct when recording in progress
    * rename file for agentic apps to better reflect its use
    * add save&load, discard buttons to sample editor
    also fix saving recording then going to correct dir in importview
    * return to "src" screen after rec when leaving sampleeditor
    [ChainView.cpp, DeviceView.cpp, GrooveView.cpp, InstrumentView.cpp, MixerView.cpp, PhraseView.cpp, ProjectView.cpp, RecordView.cpp]
2025-10-24 891-wrong-waveform-bg (#892)
    * fix rect drawing to use rgb565 not 8888 color
    our screen buffer on the advance still requires rgb565
    * set start to 0 when loading new sample in editor (#899)
    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
    [display.c]
2025-10-24 show pools samples in use by an instrument (#896)
2025-10-28 Battery health UI (#903)
    * Battery health UI
    * return int value from low level battery_health()
    * dont show batt health on pico.
    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
2025-10-29 SampleEditor trim effect (#900)
    * set start to 0 when loading new sample in editor
    * fix Open to support "+" modes, eg. "w+", "r+"
    these plus modes are for read plus write and write plus read
    * Trim operation for Sample Editor
    * refactor wavfile code to remove duplication
    * reload to ram pool samples after they are edited
    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
    [InstrumentBank.h, Types.h, WavFile.cpp, WavFile.h, WavFileErrors.h, WavFileWriter.cpp, WavFileWriter.h, WavHeader.cpp]
2025-10-29 Fix crash from random on Advance (#905)
    * prevent crash from random on Advance
    need to use correct int types to prevent invalid random number values on Advance
    * improve "random" name function, better fn naming
    * remove random from platform.h
    * use safer method to create random name string
    [ProjectView.cpp, advSystem.cpp, advSystem.h, platform.cpp, platform.h, randomnames.h]
2025-10-29 fix compiler warning for debug builds only on pico (#909)
    [AppWindow.h]
2025-10-29 Handle charger interrupts (#908)
    * enable charger interrupt
    * implement charger interrupts
    * nits
2025-10-30 Add "compact samples" (#897)
    * add "compact samples, fix compact instruments bug
    compact instruments was not respecting user not confirming dialog.
    also removed unnecessary bool flag
    * better naming of remove unused... buttons
    * only remove unused instruments not also samplesnow only remove unused instruments, not unused samples at same time, as we now have separate button for that.
    [ProjectView.cpp, ProjectView.h]
2025-10-30 Better error handling when reading batt SOC (#910)
    * better error handling when reading batt SOC
    [AppWindow.cpp, BatteryGauge.cpp, BatteryGauge.h, advSystem.cpp]
2025-10-30 error dialog if try to preview unsupported wavfile (#911)
    [ImportView.cpp]
2025-11-03 Cannot Trace:: in interrupt context (#925)
2025-11-04 fix returning to pool browser from sample editor (#923)
    also small err handling improvement
    [ImportView.cpp]
2025-11-06 Adjust number of resources for Advance (#941)
    * Advance: 64 instruments of Samples or MIDI, full length seq (256 steps) and 128 tables
    * feedback plus adjusted also phrases
2025-11-07 fix behaviour when project pool is empty (#945)
    [ImportView.cpp]
2025-11-07 Level normalisation SampleEditor operation (#913)
    * level normalisation SampleEditor operation
    * tweak sample editor screen layout
    * update agent instructions
    * clarify use of peak full scale
2025-11-07 introduce key illustrations to usermanual (#570)
    * introduce key illustrations to usermanual in keypadcombos.md
    * add mini keys illustrations to getting-started.md
    * start to add tables for all available keycombos per view
    in a format supported to generate pdfs as well as html
    * orient the buttons overview table horizontally
    * put function column first in keycombo tables
    * fix alt img texts for chain view keycombos
    * add keycombos for selection mode in chain view
    * remove inline code markdown to fix table rendering in pdf
    * add phrase view section to keypadcombos.md
    * switch order of keys in keycombos to start with key of the section and add a view missing ones
    * add instrument view section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
2025-11-07 Fix ADC values to get the mic in spec (#949)
    [tlv320aic3204.c]
2025-11-10 Performance improvements (#956)
    * Add ARM DSP library
    * add ITCMRAM loading
    * add render buffers to DTCMRAM
    * add audio stack to DTCMRAM - 62% increase in render performance!
    * Add renderParams to DTCMRAM - 10% increase render performance
    * improve mixing performance
2025-11-10 fix bug on battery monitoring (#955)
    * fix bug on battery monitoring
    * nit
    [advSystem.cpp]
2025-11-10 fix issue when jumping to bootloader after we enabled some external interrupts (#957)
    [platform.cpp]
2025-11-10 fix square bracket character (#958)
2025-11-12 backlight needs to be on early on during boot... (#975)
    because we may need to show user error message for example for missing sdcard
    [advSystem.cpp]
2025-11-13 UI for control of line-in & mic gain (#914)
    * UI for control of line-in & mic gain, code cleanup
    * add dummy line-in & rmic consts for pico
2025-11-13 Dont directly call redraw in input evt processing (#986)
    * Dont directly call redraw in input evt processing
    AppWindow::Redraw() is actually no longer needed now we have AnimationUpdate.
    [AppWindow.cpp, AppWindow.h]
2025-11-15 only save config changes when leaving DeviceView (#988)
2025-11-15 Fix reading charge status from charger IC (#989)
    * fix reading charge status from charger IC
    also some cosmetic code cleanup
    * use correct offset to read charge status from reg
    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
    [advSystem.cpp, charger.cpp]
2025-11-16 no uart logging possible while interrupts disabled (#996)
    In future if needed we can reinstate this logging by using something like a bitmap field to set conditions that can be logged after interrupts are re-enabled.
2025-11-18 Recording screen only available on Advance (#999)
    * move duplicate code into helper function
    * fix recordview to return to correct src view
    * recording screen only for Advance
    [ChainView.cpp, DeviceView.cpp, GrooveView.cpp, InstrumentView.cpp, MixerView.cpp, PhraseView.cpp, ProjectView.cpp, RecordView.cpp]
2025-11-18 Fix redrawing waveform after dialog dismissal (#1000)
    * fix to use screen width for drawing window borders
    * fix order of drawing dialogs after the screen contents
    * fix redrawing waveform after dialog is dismissed
    also cleaned up code by removing redraw flag and instead using the
    isDirty flag for the same purpose
    [AppWindow.cpp]
2025-11-18 Usermanual for advance (#990)
    * split usermanual to pico & advance editions
    just using placeholder design for "landing page"
    * remove compliance page from pico manual
    * update Advance and pico introduction pages
    * recording screen section to advance user manual
    * update firmware update instructions for Advance
2025-11-19 Remove master volume UI from Project screen (#1005)
    * keep master vol in proj screen for pico only
    Also fix some existing mistakes in mixer screen user manual.
    [ProjectView.cpp]
2025-11-19 SID: fixed filter off and filter resonance settings (#982)
    * fixed filter off and filter response settings
    * fix clang formatting
    * improved existing comment to reflect need for surgical bit flipping
    [SIDInstrument.cpp]
2025-11-20 Digital volume (#1007)
    * tlv digital volume
    * plug in digital output volume
    * restore master vol on pico
2025-11-20 fixed gap at the beginning of recording (#1019)
    [record.cpp]
2025-11-21 miniblank was incorrectly uint8 samples while DMA was expecting half words (#1025)
2025-11-23 Adjust color usage and fix inconsistencies (#1031)
    * change in color assignments
    * Fix behaviour of static field to be all label and all others to be all value if no colon
    * song and phrase elements
    * sample pool/import
    * fix project label
    * modal
    [DeviceView.cpp, ImportView.cpp, PhraseView.cpp, SongView.cpp, ThemeView.cpp]
2025-11-26 Fix tempo tap on advance (#1049)
    * fix tempo tap on advance by making GetClock() ...
    actually work instead of always returning 0
    [advSystem.cpp]
2025-11-26 Show progress UI for sample editor operations (#1039)
    * show progress UI for sample editor operations
2025-11-26 Markers not visible on waveform (#1050)
    * change color used for waveform drawing, fix ...
    drawrect to not have its own currentcolor cached that can get out of sync with the color set by text SetColor()
    also remove incorrect setting cursor color to normal color
    [AppWindow.cpp, display.c]
2025-11-26 Update usermanual landing page and screenshots for advance (#1060)
    * update usermanual landing page images
    * use advance specific screenshots & keymap
2025-11-26 Xml bounds checking (#1067)
    * match xml variables to system variables
    * safeguard against invalid XML file being loaded (with too long attributes)
    * Ignore whitespace between attributes
    [I_Instrument.cpp]
2025-11-28 fix to correctly read black values, ie 0 color val (#1082)
    [AppWindow.cpp]
2025-12-01 Show error for bad project data, load default (#1077)
    * if project data loading error show error then...
    after user ack load empty project if error loading project data
    * clear .current file after err loading project data
    [AppWindow.cpp, AppWindow.h]
2025-12-01 fixes missing title on the phrase screen (#1087)
    [PhraseView.cpp]
2025-12-02 Hotfix chains const typo (#1093)
    * fix wrong phrases per chain const value !!
    this typo was made recently when converting magic number literals into a named constant.
    * fix using new constant in remaining places
2025-12-02 Support preview and import of any sample format (u8, s16, s24, s32, f… (#1091)
    * Support preview and import of any sample format (u8, s16, s24, s32, f32 and f64)
    * clang
    * Addressed some feedback and simplified sample procesing to fix stereo f64 which was broken
    [ImportView.cpp, WavFile.cpp, WavFile.h, WavFileErrors.h, WavHeader.cpp]
2025-12-03 60hz display (#1096)
2025-12-03 revert any bitrate commit (#1097)
    [ImportView.cpp, WavFile.cpp, WavFile.h, WavFileErrors.h, WavHeader.cpp]
2025-12-03 Reduce vu sampling rate (#1088)
    * reduces vu sampling rate to every 32nd sample, adds performance optimizations
2025-12-08 correctly filter out . & .. virtual dir entries (#1116)
    * correctly filter out . & .. virtual dir entries
    [SelectProjectView.cpp]
2025-12-08 we were saving past bounds for commands as FourCC is a char sized type rather than short (#1125)
    [HexBuffers.cpp]
2025-12-09 Cleanup dirty flag handling (#1113)
    * consolidate to only 1 dirty flag on current view
    we dont have resizable OS windows so no need for separate dirty flag
    * provide public API for View dirty state
2025-12-09 fix bug with wakeup code (#1126)
    [advSystem.cpp, charger.cpp]
2025-12-09 Use "clear"/ ENTER+EDIT key combo to reset variables to default values (#1026)
    * added variable reset in instrument view
    * added variable reset in project view
    * added variable reset in device view
    * added variable reset in theme view
    * added variable reset in mixer view
    * Reset through UIIntVarField, reuse Update handling
    * move field clear logic into FieldView
    * properly trigger onChange for watched variable clears
    * special case sample editor end reset
    * disable clearing instrument type, reenabled purging sample instrument
    * clear instrument for all types, return in instrumentview after overriding EDIT+ENTER handling
    * add purge for all I_Instrument types
    [FieldView.cpp, I_Instrument.cpp, I_Instrument.h, InstrumentView.cpp, MacroInstrument.cpp, MacroInstrument.h, MidiInstrument.h, OpalInstrument.h]
2025-12-10 Fix audio channels (#1135)
    * fix file streamer to apply same reverse as sequencer
    * fix recording and monitoring
    [record.cpp]
2025-12-11 fix midi sync issue in Advance (#1140)
    * fix midi sync issue in Advance
    * clang-format fix
    * hackfix transport send on advance
    * files left out
    [advAudioDriver.cpp, advMidiOutDevice.cpp, advMidiOutDevice.h, advMidiService.cpp, advMidiService.h, advUSBMidiOutDevice.cpp]
2025-12-18 Fix issue deleting samples (#1147)
    * Fix issue deleting samples
    * clang-format
    * unify findsampleindex method
    [ImportView.cpp]
2025-12-23 Changes to eliminate heap usage (#1153)
    * no std::string
    * midi merger conversion. 1184 bytes usage
    * remove unused SingletonRegistry
    * T_Singleton wrapper for etl::singleton
    * modal using placement new
    * allocation tracker
    * Filepool for files instead of allocation
    * Config member variables instead of allocations
    * no more cmdedit allocations
    * ThemeName var
    * RenderProgressModal and FullScreenBox
    * WavFileWriter allocation
    * Remove legacy _Midi unused code
    * timer allocation
    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
2025-12-23 remove debug prints leftover from latest PR (#1155)
2026-01-06 Support bitrate and samplerate conversion on import (#1160)
    * Add modified SRC library
    * Hookup device resampler option
    * Accept files of all the formats we want to support
    * Re-apply any bitrate patch
    * Convert the file on copy. Project samples is a mirror of the sample pool
    * Samplerate convert all samples on import if resampler is selected
    * fix pico compilation issue
    * Fix options for resampler and bug in UIIntVarField
    * Manual entries for resampler
    [Config.cpp, DeviceView.cpp, ImportView.cpp, Types.h, WavFile.cpp, WavFile.h, WavFileErrors.h]
2026-01-07 Slices (#915)
    * initial slices support
    * logging in loadsamples causing hardfault now
    for some reason uart behaviour has changed and now hardfaults with interrupts disabled
    * add nav back handling, fix slicerview layout
    * fix crash on proj load, clean up variable naming
    * new slices start at prior slices start point
    * fix rebase issue
    * Colorize current slice and fix a few issues
    * slice shoving support
    * fix audio preview
    * Remove use of unused slicePixelPositions_ and related code
    * Adjust rendering cache to save 4kb in adv and 2kb on pico
    * Cleanup SampleSlicesView
    * fix issue with slices start point
    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
    [AppWindow.cpp, AppWindow.h, InstrumentBank.cpp, InstrumentView.cpp, InstrumentView.h, Player.cpp, Types.h]
2026-01-08 Slices representation and limit playback (#1161)
    * Show slices rather than notes in phrase
    * Add slices to drawNotes
    * Limit slices to valid ones in phrase view
    * Only play slices that are valid
    * Fix display of invalid slices
    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
    [PhraseView.cpp, PhraseView.h, Player.cpp, Player.h, PlayerMixer.cpp, PlayerMixer.h]
2026-01-12 move DMA start to StartDrive to avoid race cond (#1168)
    [picoTrackerAudioDriver.cpp]
2026-01-13 Dont close files being previewed directly in Stop (#1169)
    * Dont close files being previewed directly in Stop
    On the pico, because Stop() is called from Core0 while rendering
    is on Core1, can get a race if the wav file is closed in Stop()
    while rendering is still reading from the file to stream the audio data.
    * gate stop req workaround to be for pico only
2026-01-13 correctly size project name string buffers (#1173)
    Buffers need to correctly handle project names up to 16 chars in length
    [AppWindow.cpp, AppWindow.h, Application.cpp, ImportView.cpp, ProjectView.cpp]
2026-01-13 Output level value is not saved (#1171)
    * increase max stack allowed on pico slightly
    Because there is a function now that exceeds prior value on debug builds
    * persist line mode value on every change
    Because the user is prompted to reboot to apply the new level, we cannot
    rely on them changing field focus in order to save the new value.
    [DeviceView.cpp]
2026-01-15 User manual updates (#1183)
    * tone down landing page, use xiphonics colors
    * remove old button name use
    * add note about where rendering starts
2026-01-16 add sample editor & project pool to usermanual (#1189)
2026-01-20 No reboot on load (#1167)
    * no instrument bank placement new
    * remove project placement new
    * Add Load method to Project
    * project reset
    * rebind project on load
    * Fix mixer screen
    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
    [AppWindow.cpp, AppWindow.h, ChainView.cpp, ChainView.h, GrooveView.cpp, GrooveView.h]
2026-01-20 Usermanual typo fixes (#1192)
    * fix key combo typos in getting-started & code comment
    * fix typo in groove screen
    * use consistent bracket notation for clone keycombo
    [main.c]
2026-01-22 Delete Project (#1105)
    * adds support for deleting projects
    * fixes SdFat bug that sees '.' and '..' as files, blocking a directory from being deleted
    * improves message box display for longer project names
    * simplified checking for '.' or '..' as per latest code in SdFat
    * fixes focus issue after delete, adds LOAD and DELETE tabs to SelectProjectView
    * adds range checking to prevent issues when no projects are present
    * adds error checking to the directory changing to prevent deleting the wrong things
    * adds load warning dialog
    * fix dir rm on Adv with batch update workaround
    * uses special characters for the scroll bar
    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
    [ProjectView.cpp, ProjectView.h, SelectProjectView.cpp, SelectProjectView.h, Types.h]
2026-01-22 Fix instrument clone, table clone not working on phrase screen (#1194)
    * fix instrument cloning in phrase screen
    * Fix cloning tables
    * also fix table cmd value jump to table to use correct cmd const
    [InstrumentBank.cpp, PhraseView.cpp]
2026-01-28 Detect unsupported ExFat on pico & show error mesg (#1201)
    * detect unsupported ExFat on pico & show error mesg
2026-01-29 clear autosave data on project browse (#1202)
    * clear autosave data on project browse
    * fix to clear only on user initiated project load
    * use consistent capitalisation in fn names
    [AppWindow.cpp, AppWindow.h, SelectProjectView.cpp, SelectProjectView.h]
2026-01-29 fixes directory preview (#1219)
    stop showing err dialog if trying to preview a dir entry in sample file browser.
    [ImportView.cpp]
2026-01-31 Fix Advance sending MIDI messages (#1222)
    * send midi queue on flush, then increment vs other way around
    the removes the need for the previous hacky work around to ensure that transport messages are sent with minimal latency.
    measurements with debug logging show 3 to 17ms latency from enqueing transport mesg to sending it.
    * remove no longer needed virtual methods
    [advMidiOutDevice.cpp, advMidiService.cpp, advMidiService.h, advUSBMidiOutDevice.cpp]
2026-02-03 Throttle batt discharge state changes to every 120sec (#1229)
    * throttle batt discharge state changes to every 120sec
2026-02-03 Fixes to graph drawing across slicer and editor (#1215)
    * wip
    * 64 slices adv, fix some consts
    * unique graphField
    * cursors for sampleEditor
    * Playhead
    * remove fields on Sample Slices and add hints
    * wip - move slices to instrument screen
    * sync slices created with instrument screen
    * reset slices on import
    * off, 2,3,4...
    * auto moved back to sampleSlices
    * refresh sample size for slicing
    * slice and zoom level label
    * layout and controls
    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
    [AppWindow.h, GraphField.cpp, GraphField.h, ImportView.cpp, InstrumentView.cpp, InstrumentView.h]
2026-02-04 Note Off support (#1089)
    * adds note off support
    * set NOTE_OFF to 0xfe
    * allow entering notes in the full 7-bit midi range
    * moves the constant definitions out of the #ifdef and shows them as hex values for consistency
    * removed alt+enter shortcut and inserted note off into the value wrapping
    * re-enables PC messages on change, when the player is running
    * changes the note off handling
    * changes note-off -> note behavior to always start at C3. Adds define for C3=60
    [MidiInstrument.cpp, PhraseView.cpp, Player.cpp, PlayerMixer.cpp, WavFile.cpp]
2026-02-06 Pass position and textProps as const for DrawString and DrawChar... (#1235)
    * pass pos and props as const for DrawString and DrawChar to allow passing temporaries for cleaner code
2026-02-06 Improve responsiveness of SID ADSR (#964)
    * reset envelope to sustain value, create reset ADSR method
    * rename fn to reflect that it resets not just adsr
    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
    [SIDInstrument.cpp]
2026-02-10 Fix select, copy, paste etc ops on phrase screen (#1248)
    * fix select, copy, paste etc ops on phrase screen
    * use VM_CLONE in phrase as in other views for correct clone & selection handling
    [PhraseView.cpp]
2026-02-11 whitelist views safe to be current view when autosave runs (#1255)
    * whitelist views safe to be current view when autosave runs
2026-02-13 More lenient wav header error handling, update tests (#1262)
    * more lenient wav header error handling, update tests
    some wav files have RIFF size field that doesnt match actual audio data
    size in the file, but that shouldnt be an import error since the
    firmware doesn't rely on the riff header field for playback
    [WavHeader.cpp]
2026-02-14 Record to RAM and many other fixes (#1268)
    * Record to RAM and many other fixes
    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
    [RecordView.cpp, RecordView.h, WavHeader.cpp, record.cpp, record.h, tlv320aic3204.c]
2026-02-16 Fix modal dialog callbacks to use functions not lambdas (#1261)
    * use normal methods not lambdas for modaldialog callbacks
    [ImportView.cpp, ImportView.h, InstrumentImportView.cpp, InstrumentImportView.h, InstrumentView.cpp, InstrumentView.h, ThemeImportView.cpp, ThemeImportView.h]
2026-02-16 1213 sample editor temp file (#1266)
    * implement move fn in filesystem api
    * edit temp copy of sample files, overwrite only on save
2026-02-16 fixes case for hex numbers to upper case globally (#1264)
    [ChainView.cpp, DeviceView.cpp, GrooveView.cpp, PhraseView.cpp, ProjectView.cpp]
2026-02-23 Waveform visible under dialog (#1279)
    * fix waveform with modaldialog on sample editor
    * fix waveform visible under dialog on slicer screen
    * fix bug which caused top of modal dialog ...
    that was over the waveform part of screen to be not shown
    [AppWindow.cpp, AppWindow.h]
2026-02-23 use correct mdactl default for each LCD controller (#1282)
    * use correct mdactl default for each LCD controller
    * fix position of waveform on sample editor screen
    needs to set position per each type of lcd controller on pico
2026-02-23 correctly handle sample filename lengths (#1278)
    * correctly handle sample filename lengths
    using etl::string to help prevent this sort of footgun in future
    [PersistenceConstants.h]
2026-02-26 Dont clear dirty flag in process button (#1296)
    * dont clear dirty flag in process button
    also make sure all view fields are correctly initialised
2026-02-26 Fix help texts, fix cmd paging behaviour (#1295)
    * fix help text for instrument retrigger
    * correct more help text & text improve layout
    * correct and improve commands docs in usermanual
    * fix up/down thru cmds on mnemonic first letter
    [CommandList.cpp, HelpLegend.h]
2026-03-04 Fix Adv debug logging be disabled in Release build (#1315)
    * fix Adv debug logging be disabled in Release build
    [Trace.cpp]
2026-03-04 battery charging icon (#1313)
2026-03-04 fix low bat charging check (#1324)
    [advSystem.cpp, charger.cpp]
2026-03-09 Show actual sample filename not temp filename (#1332)
    * show actual sample filename not temp filename when applying op in sampleeditor
2026-03-10 Reinstate stem rendering, includes... (#1326)
    * reinstate stem rendering, includes...
    fixing audio not to play during render & showing progress dialog
    * remove unnecessary workaround hack
    * show percentage for progress rendering stems
    * show cancel to stop rendering while its inprogress
    * remove cancel text,add blank line for nicer layout
    * show percentage progress for mixdown
    * prevent render if not at least 1 phrase in 1st row
    [AppWindow.cpp, Player.cpp, ProjectView.cpp, ProjectView.h, advAudioDriver.cpp]
2026-03-10 Browser fixes (#1338)
    * fix deleting projects
    * Allow modal within a modal dismiss
    * Hold combo delete
    * Remove Save as
    * Always select Load when entering browser
    * clang format
    * adjust messages
    [AppWindow.cpp, SelectProjectView.cpp, SelectProjectView.h]
2026-03-11 Fix Advance instruments rotation (#1340)
    [InstrumentView.cpp]
2026-03-11 Fix some message box dialogs (#1339)
    [ProjectView.cpp, ThemeView.cpp]
2026-03-12 update Adv batt charging icon char in src SVG (#1342)
2026-03-12 slicer usermanual updates (#1347)
    * capitalise adjust onscreen button for slicerscreen
    * update slicer doc in user manual
2026-03-13 fix case bug in filesystem (#1353)
2026-03-16 Dont show "Save & Load" when editing pool samples (#1364)
2026-03-16 Ensure selected list item is always displayed (#1365)
    * ensure selected list item is always displayed...
    when returning to list view from SampleEditor or going up to parent dir
2026-03-17 Replace octals (#1348)
    * replace octal with hex string literals
    * remove duplicate defines in special chars
    * add hex to comment for extended chars
    [DrawUtils.h, SpecialCharacters.h]
2026-03-17 Confirm overwrite on sample editor (#1357)
    * Confirm overwrite on sample editor
2026-03-18 Fix always returning to root dir from sample editor (#1372)
    * clear stale flags that cause nav to root dir
    a stale pendingDirEnterOnRelease_ flag was causing nav to root after returning from sample editor which previously only caused the dir to reset to /samples
    also clearing other similar flags to be safe too.
    [ImportView.cpp]
2026-03-25 prevent race cond crash on preview playback (#1392)
    [PlayerMixer.cpp]
2026-03-25 remove Advance build from ci build flow (#1391)
2026-09-15 persist proj sample state to sdcard for fast proj reload (#1408)
    * persist proj sample state to sdcard for fast proj reload
    by persisting state of samples in flash when previous project is reloaded reloading samples into flash from sdcard can be avoided entirely making project loading substantially faster for project with large sample pools.
    * Validate cached flash offsets before allocator use
    * cache invalidation for edited project samples
    * Validate cache count & require all sample fields
    * minimise ram usage for tracking cache
    * Move SampleCacheEntry to its own header
    WavFile is a low level audio class and should not depend on the persistence layer, which pulls in I_Instrument.h,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
    [AppWindow.cpp, ImportView.cpp, InstrumentView.cpp, ProjectView.cpp, ProjectView.h]
2026-09-16 UI updates (using the extended characters mostly) (#1260)
    * updates play indicators to use graphic icons instead of '>', '-' and '_'
    * drawing a double border for modal views
    * adjusts messages to fit within the screen
    * adds button ends to message box buttons, applies some DRY, fixes max width for buttons
    * moves scrollbar implementation to DrawTools, adds scrollbar to the ImportView
    * removes superflouos spaces from the tempo display
    * matches case for Off in Device view
    * adds button ends to UIActionField
    * invert selection in map and and cleaned up drawing code
    * cleaned up DrawView to move things out of loops
    * enhances command help and adds abbreviation highlighting
    [ChainView.cpp, Config.cpp, DrawTools.cpp, DrawTools.h, GrooveView.cpp, HelpLegend.h, ImportView.cpp]
2026-09-21 Fix command timing for rows delayed by DLY (#1227)
    A row's commands ran on the tick the row was entered and were then wiped when its delayed note started, so FX such as ARP never reached the note they sit on.
    [Player.cpp, Player.h]
2026-09-22 Reload pool sample after editor save-as (#1398)
    * Reload pool sample after editor save-as
    Register a Save As result in the sample pool so the new sample is assignable without a project reload, and refuse a Save As that would exceed the pool's count or free flash, or reuse an existing sample name.
    * Show empty sample pool in import view
    Draw a placeholder when the file list is empty so the import screen is never blank and says which list is empty.
2026-09-22 Fix incorrect pool empty listing (#1454)
    * Fix empty project sample pool browser
    OnFocus() listed the pool via jumpToDirectory("."), which SdFat rejects
    so the listing was skipped, read the pool folder directly and treat "."
    as a no-op change so callers can't trip on it again.
    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
    [ImportView.cpp]
2026-10-01 improves Variable RAM footprint (#1401)
    * improves Variable RAM footprint
    * Fix string variable copying with shared storage
    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
2026-10-01 Prevent importing duplicate sample names (#1462)
    Refuse an import whose project filename is already pooled, which silently overwrote the project WAV and added a second pool entry.
    [ImportView.cpp]
2026-10-01 Fix b hopping over empty chains in chain/phrase views (#1464)
    Hop to the next populated chain when neighbouring song channels
    are empty instead of doing nothing.
    [ChainView.cpp, PhraseView.cpp]
2026-10-05 Show save as copy progress and optimise file copying (#1463)
    * Show progress during project Save As
    Report sample copy progress during project Save As.
    * Use larger buffer for project sample copies
    Use 4 KiB of the idle WAV writer buffer during Save As.
    * Reuse 8 KiB buffer for sample import
    Share WAV output storage with project and import copies.
    * Move shared buffer into application utilities
    Decouple shared scratch storage from WAV writer ownership.
    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
    [SharedBuffer.cpp, SharedBuffer.h, WavFileWriter.cpp, WavFileWriter.h]
2026-10-05 Give OPAL instrument a voice per tracker channel (#1465)
    * Give OPAL instrument a voice per tracker channel
    OPAL playback state is now owned per channel, so one instrument sounding on several channels renders
    independent voices instead of one shared, distorted stream.
    * Clean up OPAL per-channel voice state & wire params
    Init() no longer resets voices on other channels, the unused
    OPAL_MAX_CHANNELS macro is removed, the CHANNEL macro comment and
    per-channel RAM cost note are clarified, and Feedback and Deep
    Tremolo/Vibrato are now actually written to the emulator registers.
    [OpalInstrument.cpp, OpalInstrument.h]
2026-10-08 Fix file pool exhaustion in sample preview (#1469)
    Synchronize file pool deallocation and ensure streamer closes files on stop and EOF.
    [ImportView.cpp]
2026-10-09 Filter out non-pico projects without lgptsav.dat (#1474)
    * Filter out non-pico projects without lgptsav.dat
    Only list directories in /projects that contain lgptsav.dat
2026-10-10 limit max tempo to 300 (#1476)
    Clamp tempo to 300 to match Advance and ensure reasonable performance.
2026-10-10 Track pico cwd and update SdFat to 2.3.1 (#1477)
    Resolve paths in the pico adapter and remove SdFat cwd patches.
2026-10-10 Enable exFAT SD cards (#1478)
    Allow SdFat mounted exFAT cards through boot validation.
2026-10-10 unused samples now purged from end of the pool backward (#1479)
    so deleting one cannot shift the indices of samples still being checked
2026-10-12 Prefer higher numbers when allocating patterns (#1485)
    Search above the current pattern, wrapping when needed.
2026-10-12 tied notes for MIDI and samples (#1488)
