xiphonics/picoTracker/(notices)

Notices in the files:
sources/Adapters/adv/Core/Inc/main.h:
Copyright (c) 2025
Copyright (c) 2025 xiphonics, inc.
